Crinst/LPWAN-current-logger-device/enclosure/20200503_152244.jpg

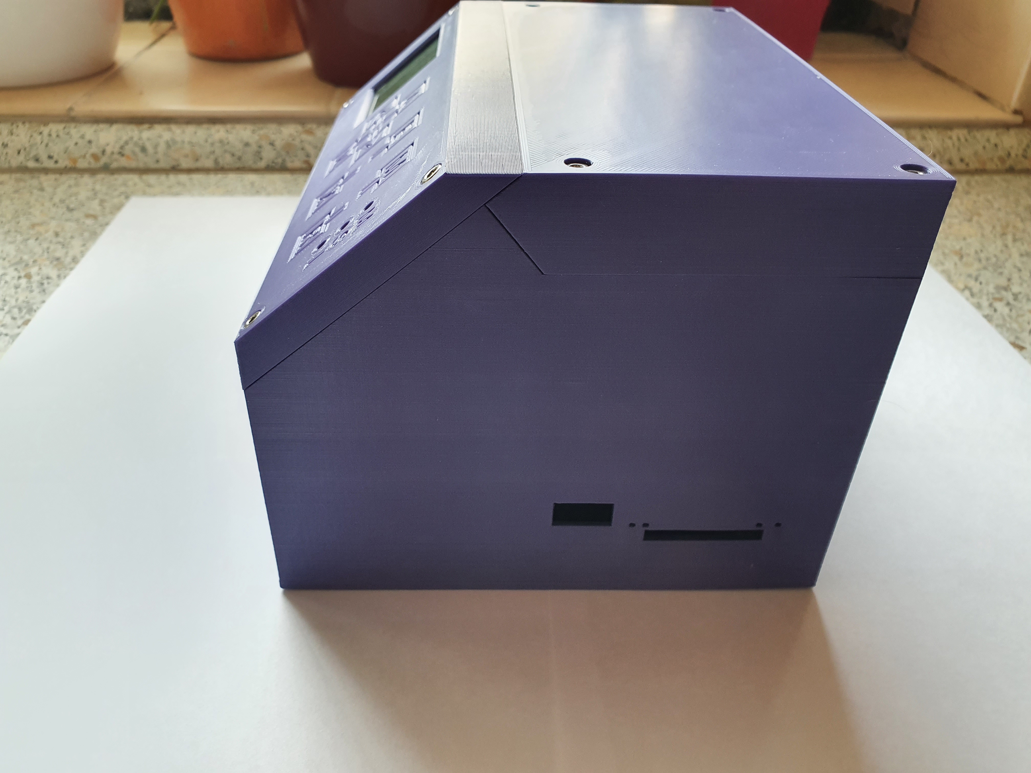
enclosure/20200503_152244.jpg
