Crinst/LPWAN-current-logger-device/enclosure/Prusa_Slicer_Bottom.PNG

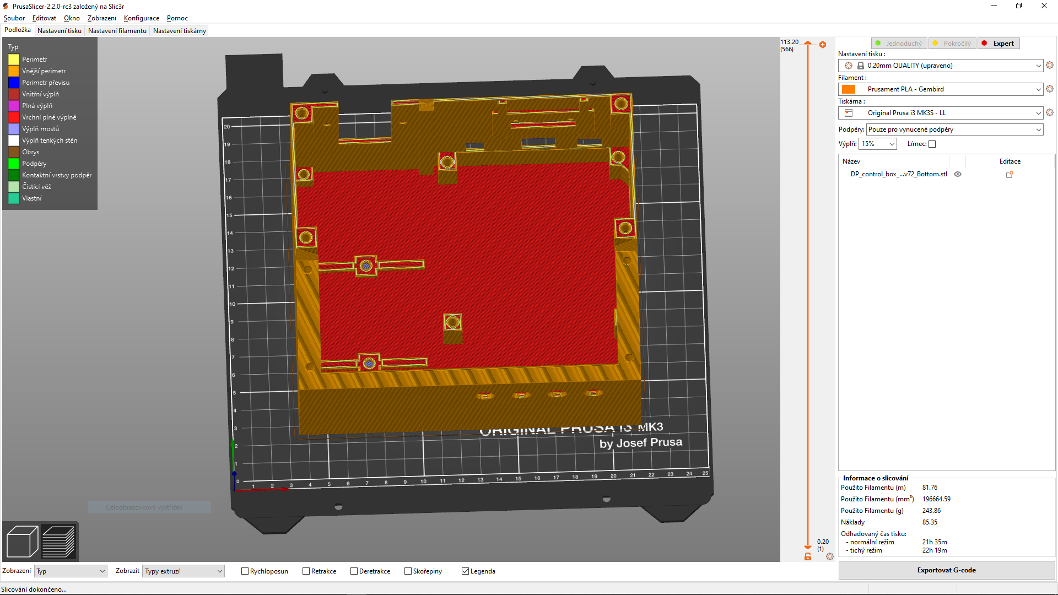
enclosure/Prusa_Slicer_Bottom.PNG
