Crinst/LPWAN-current-logger-device/docs/flowcharts/Vyvojovy_diagram_sw_lcd_menu.pdf

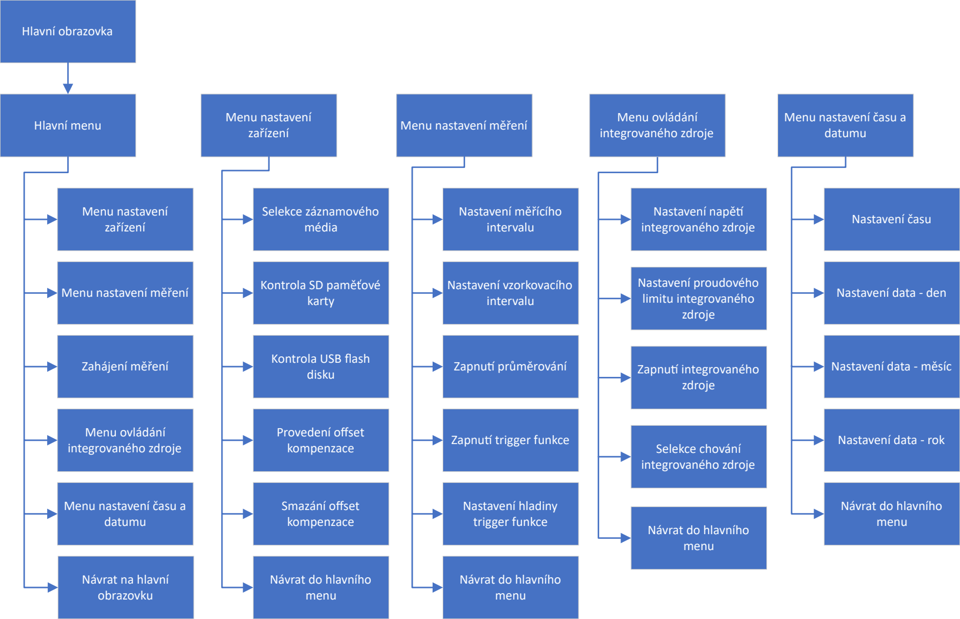
[picture p7: figure]
Hlavní menu; Menu nastavení měření; Zahájení měření; Menu ovládání integrovaného zdroje; Menu nastavení času a datumu; Menu nastavení zařízení; Selekce záznamového média; Kontrola SD paměťové karty; Kontrola USB flash disku; Provedení offset kompenzace; Smazání offset kompenzace; Návrat do hlavního menu; Nastavení měřícího intervalu; Nastavení vzorkovacího intervalu; Zapnu průměrování; Zapnu trigger funkce; Nastavení hladiny trigger funkce; Nastavení napě integrovaného zdroje; Nastavení proudového limitu integrovaného zdroje; Zapnu integrovaného zdroje; Selekce chování integrovaného zdroje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
