Crinst/LPWAN-current-logger-device/docs/flowcharts/Vyvojovy_diagram_sw_measuring.pdf

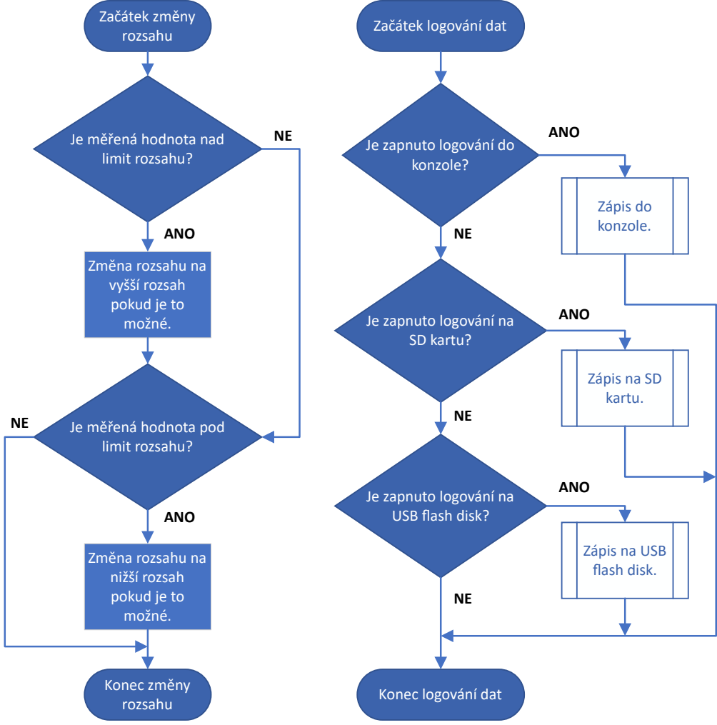
[picture p8: figure]
Začátek změny rozsahu; Je měřená hodnota nad limit rozsahu?; Změna rozsahu na vyšší rozsah pokud je to možné.; Je měřená hodnota pod limit rozsahu?; Změna rozsahu na nižší rozsah pokud je to možné.; ANO; Konec změny rozsahu; Začátek logování dat; Je zapnuto logování do konzole?; Je zapnuto logování na SD kartu?; Konec logování dat; Zápis do konzole.; Zápis na SD kartu.; Je zapnuto logování na USB flash disk?; Zápis na USB flash disk.
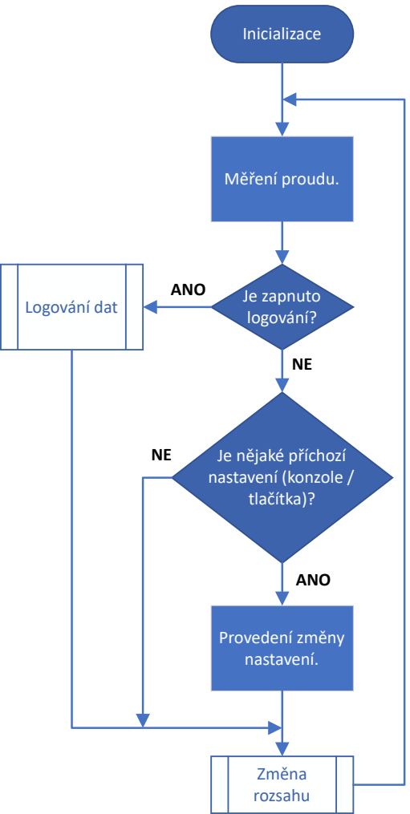
[picture p9: figure]
Je zapnuto logování?; Měření proudu.; ANO; Inicializace; Změna rozsahu; Logování dat; Je nějaké příchozí nastavení (konzole / tlačítka)?; Provedení změny nastavení.
