Crinst/LPWAN-current-logger-device/docs/flowcharts/Vyvojovy_diagram_sw_sd_card.pdf

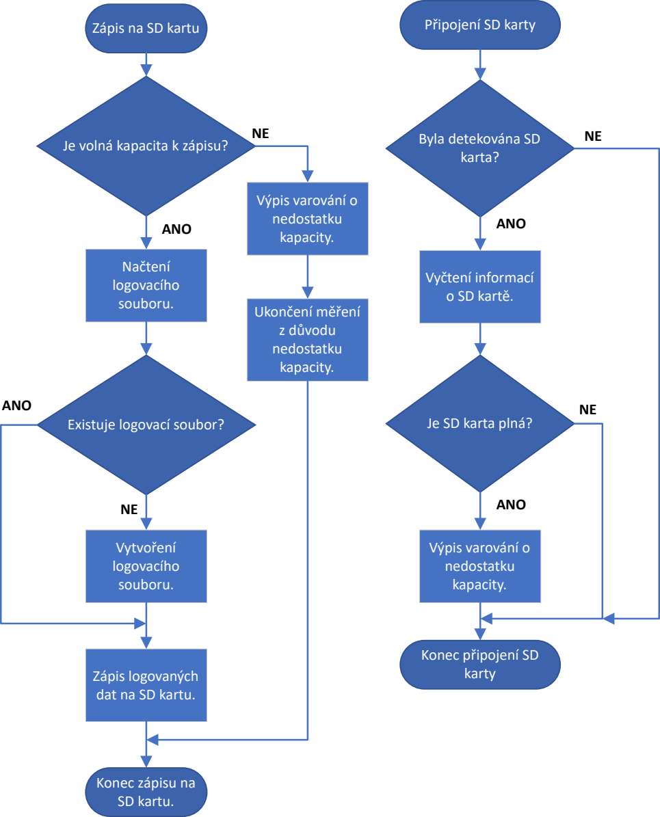
[picture p10: figure]
Zápis na SD kartu; Je volná kapacita k zápisu?; Načtení logovacího souboru.; Existuje logovací soubor?; Zápis logovaných dat na SD kartu.; ANO; Konec zápisu na SD kartu.; Připojení SD karty; Byla detekována SD karta?; Vyčtení informací o SD kartě.; Je SD karta plná?; Výpis varování o nedostatku kapacity.; Konec připojení SD karty; Ukončení měření z důvodu nedostatku kapacity.; Vytvoření logovacího souboru.
