Crinst/LPWAN-current-logger-device/docs/flowcharts/Vyvojovy_diagram_sw_uart_pc.pdf

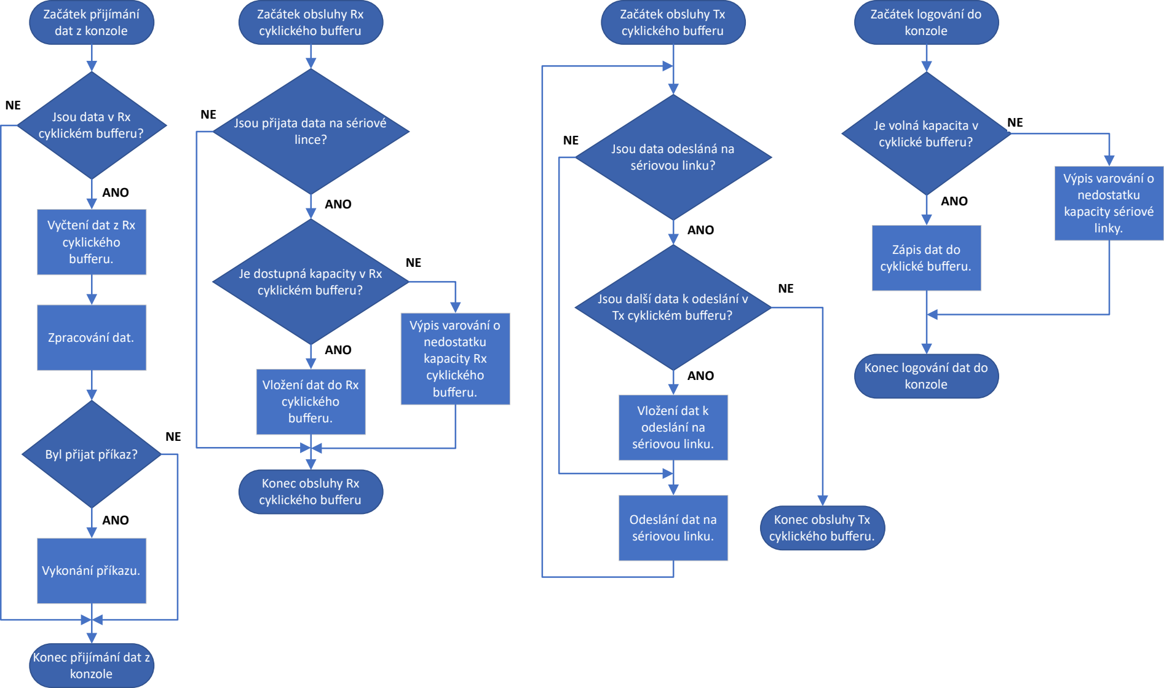
[picture p11: figure]
Jsou data v Rx cyklickém bufferu?; ANO; Začátek přijímání dat z konzole; Začátek obsluhy Tx cyklického bufferu; Jsou data odesláná na sériovou linku?; Jsou další data k odeslání v Tx cyklickém bufferu?; Vložení dat k odeslání na sériovou linku.; Konec obsluhy Tx cyklického bufferu.; Byl přijat příkaz?; Vykonání příkazu.; Začátek logování do konzole; Je volná kapacita v cyklické bufferu?; Zápis dat do cyklické bufferu.; Konec logování dat do konzole; Výpis varování o nedostatku kapacity sériové linky.; Odeslání dat na sériovou linku.; Začátek obsluhy Rx cyklického bufferu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
