Crinst/LPWAN-current-logger-device/docs/flowcharts/Vyvojovy_diagram_sw_usb_flash.pdf

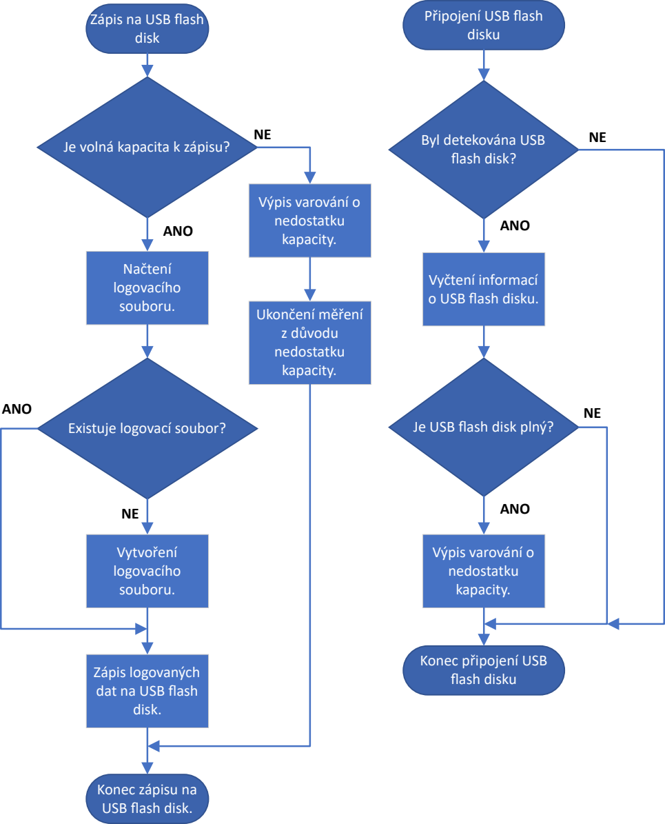
[picture p12: figure]
Zápis na USB flash disk; Je volná kapacita k zápisu?; Načtení logovacího souboru.; Existuje logovací soubor?; Zápis logovaných dat na USB flash disk.; ANO; Konec zápisu na USB flash disk.; Připojení USB flash disku; Byl detekována USB flash disk?; Vyčtení informací o USB flash disku.; Je USB flash disk plný?; Výpis varování o nedostatku kapacity.; Konec připojení USB flash disku; Ukončení měření z důvodu nedostatku kapacity.; Vytvoření logovacího souboru.
