Crinst/LPWAN-current-logger-device/docs/flowcharts/Vyvojovy_diagram_sw_V1.pdf

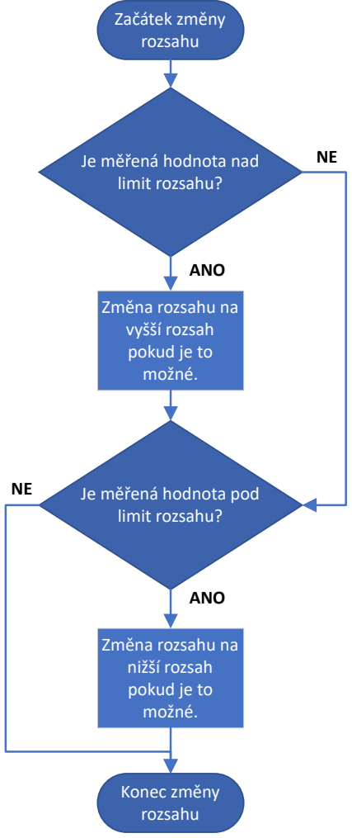
[picture p13: figure]
Začátek změny rozsahu; Je měřená hodnota nad limit rozsahu?; Změna rozsahu na vyšší rozsah pokud je to možné.; Je měřená hodnota pod limit rozsahu?; Změna rozsahu na nižší rozsah pokud je to možné.; ANO; Konec změny rozsahu
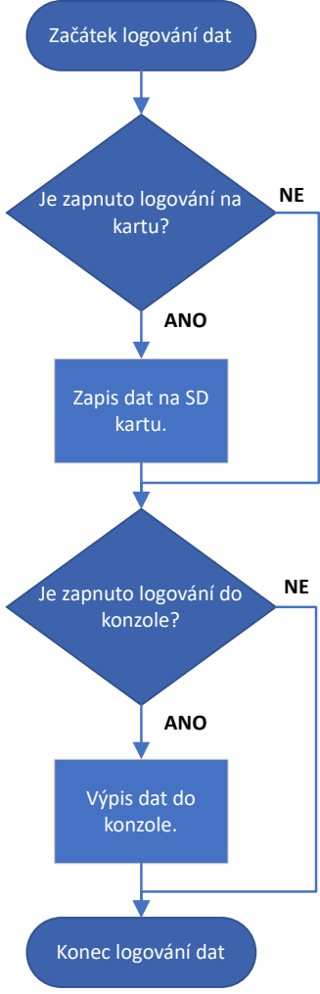
[picture p14: figure]
Začátek logování dat; Je zapnuto logování na kartu?; Zapis dat na SD kartu.; Je zapnuto logování do konzole?; Výpis dat do konzole.; Konec logování dat; ANO
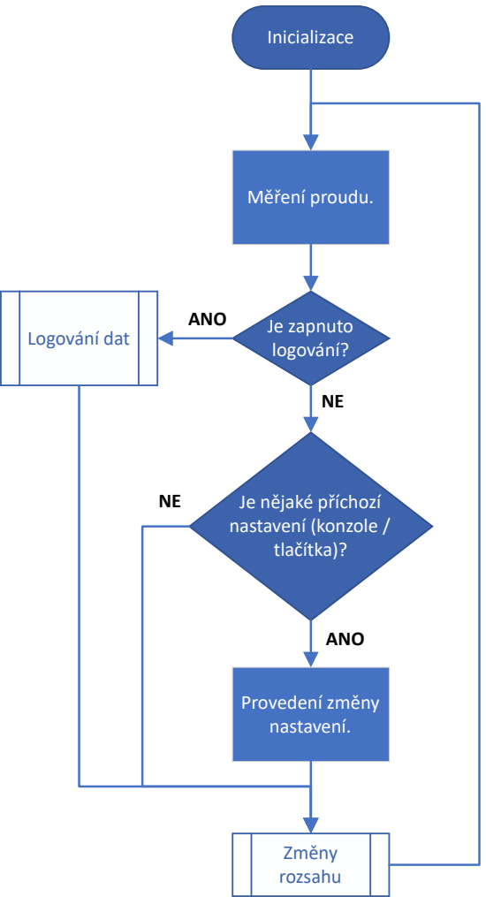
[picture p15: figure]
Je zapnuto logování?; Měření proudu.; ANO; Inicializace; Změny rozsahu; Logování dat; Je nějaké příchozí nastavení (konzole / tlačítka)?; Provedení změny nastavení.
