Crinst/LPWAN-current-logger-device/docs/DP_V3_CubeMX_pinout.PNG

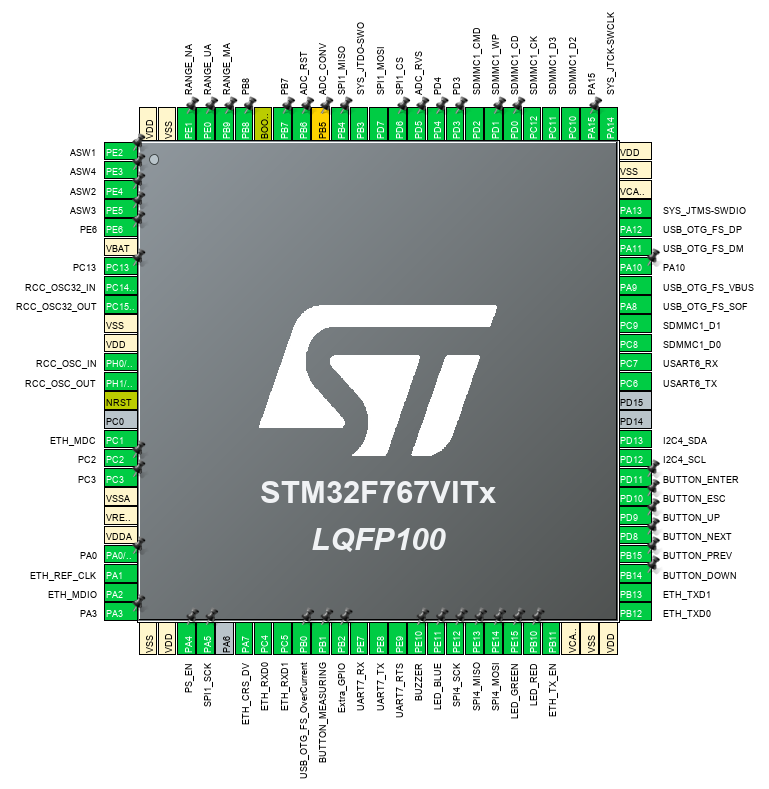
docs/DP_V3_CubeMX_pinout.PNG
