Crinst/LPWAN-current-logger-device/docs/flowcharts/Vyvojovy_diagram_sw_V1.png

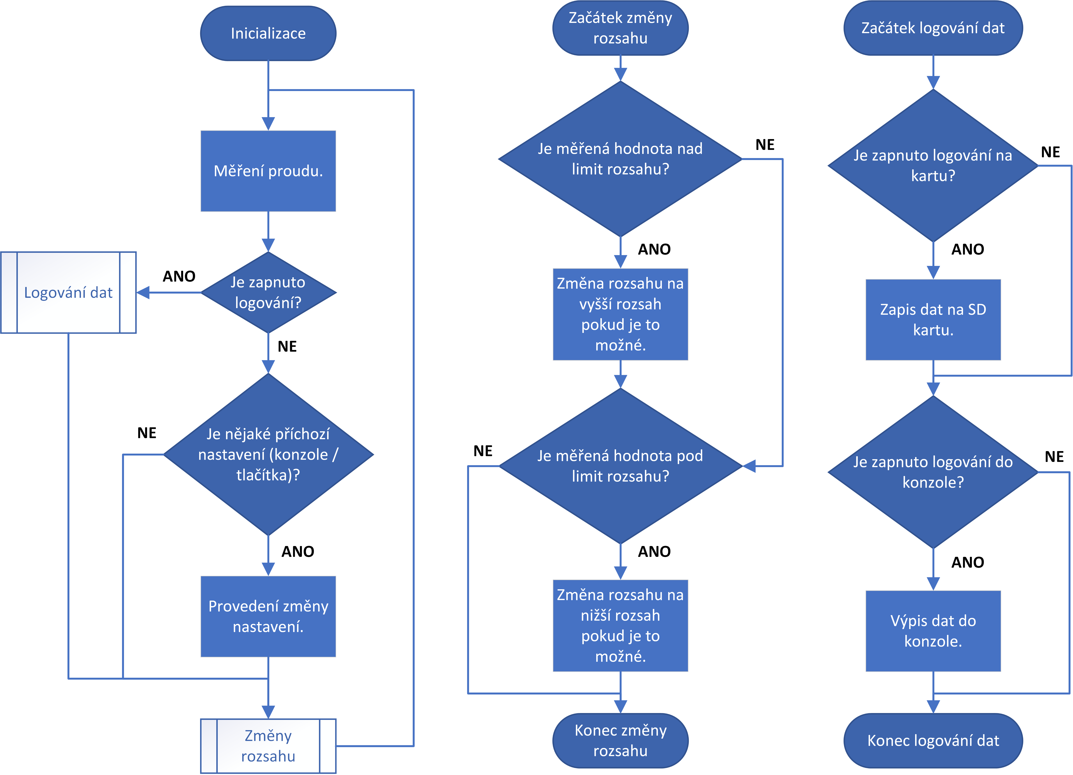
docs/flowcharts/Vyvojovy_diagram_sw_V1.png
