Crinst/LPWAN-current-logger-device/eagle/v1_v2/DP_board_V2_1_10_2019_schematics.png

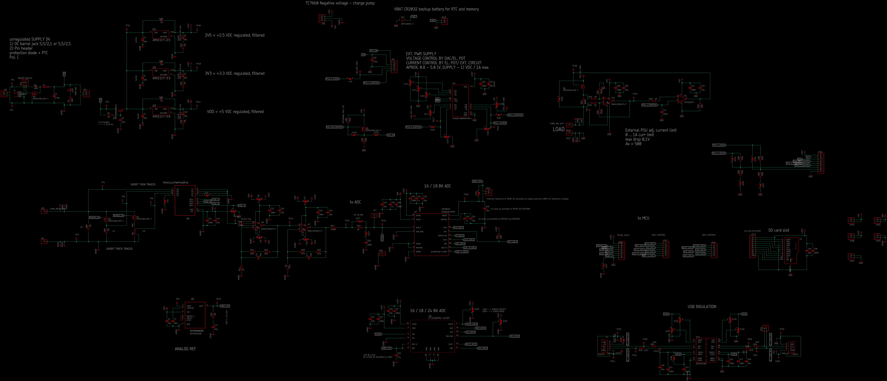
eagle/v1_v2/DP_board_V2_1_10_2019_schematics.png
