Crinst/LPWAN-current-logger-device/eagle/v1_v2/schem2.png

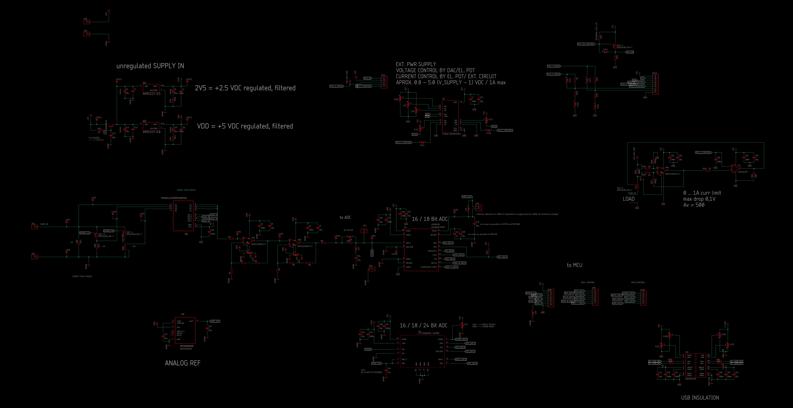
eagle/v1_v2/schem2.png
