Crinst/LPWAN-current-logger-device/eagle/v1_v2/schem.png

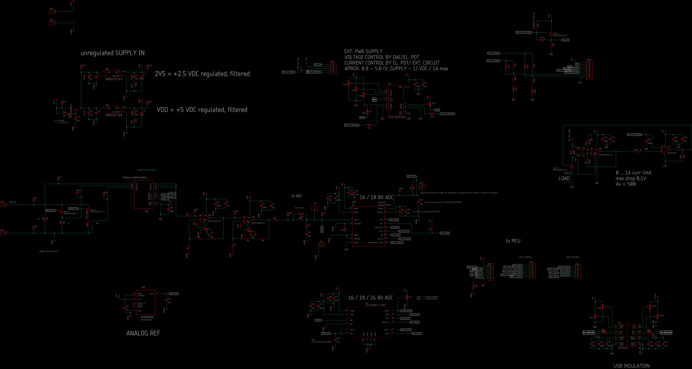
eagle/v1_v2/schem.png
