Crinst/LPWAN-current-logger-device/enclosure/20200503_151324.jpg

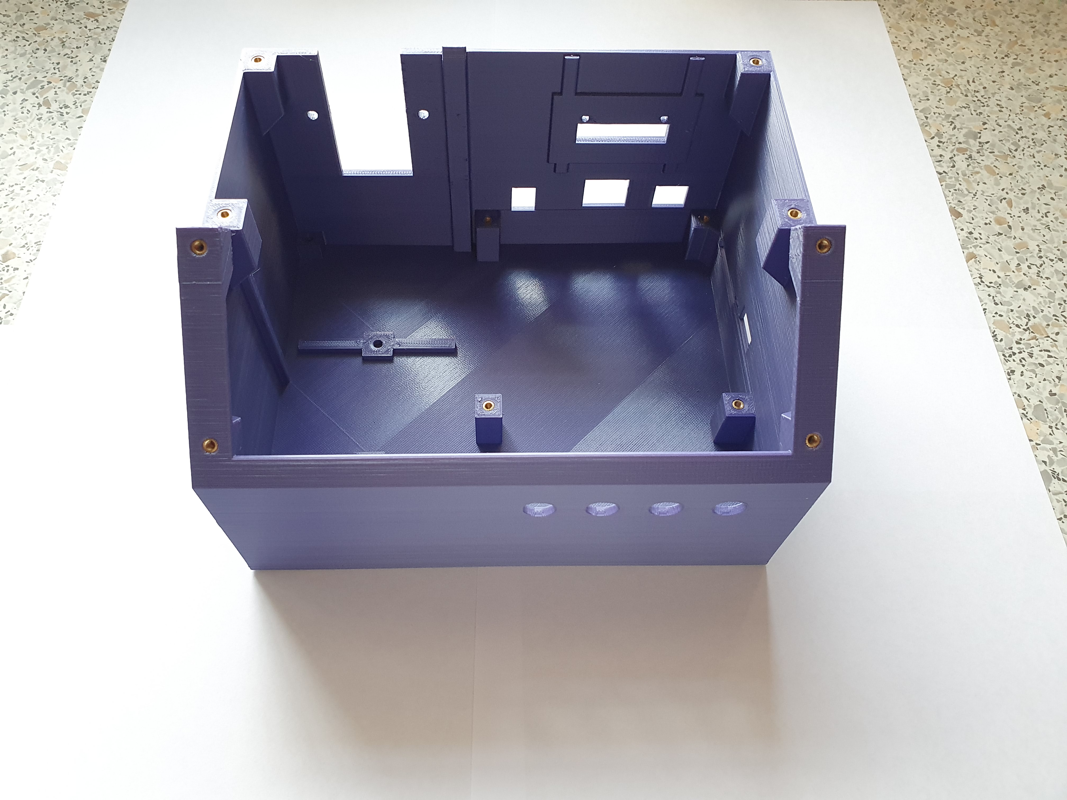
enclosure/20200503_151324.jpg
