Crinst/LPWAN-current-logger-device/enclosure/20200503_151333.jpg

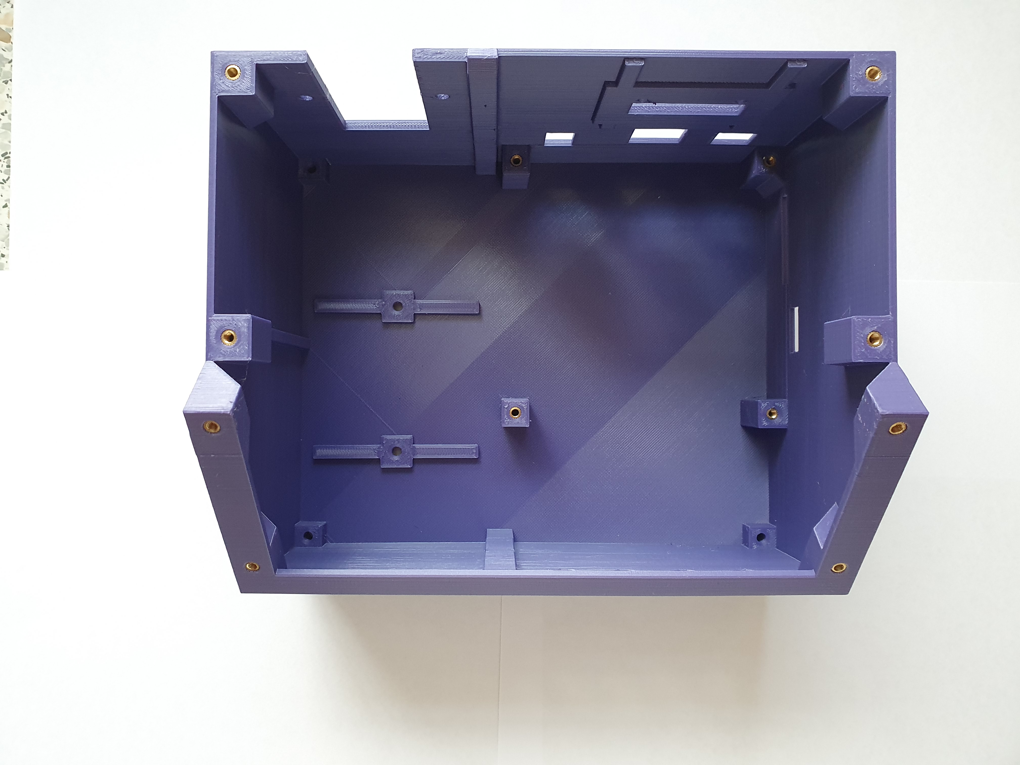
enclosure/20200503_151333.jpg
