Crinst/LPWAN-current-logger-device/enclosure/20200503_151343.jpg

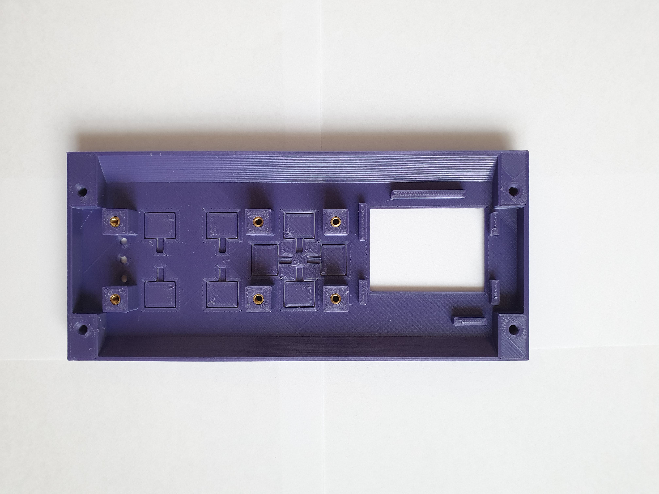
enclosure/20200503_151343.jpg
