Crinst/LPWAN-current-logger-device/enclosure/20200503_151352.jpg

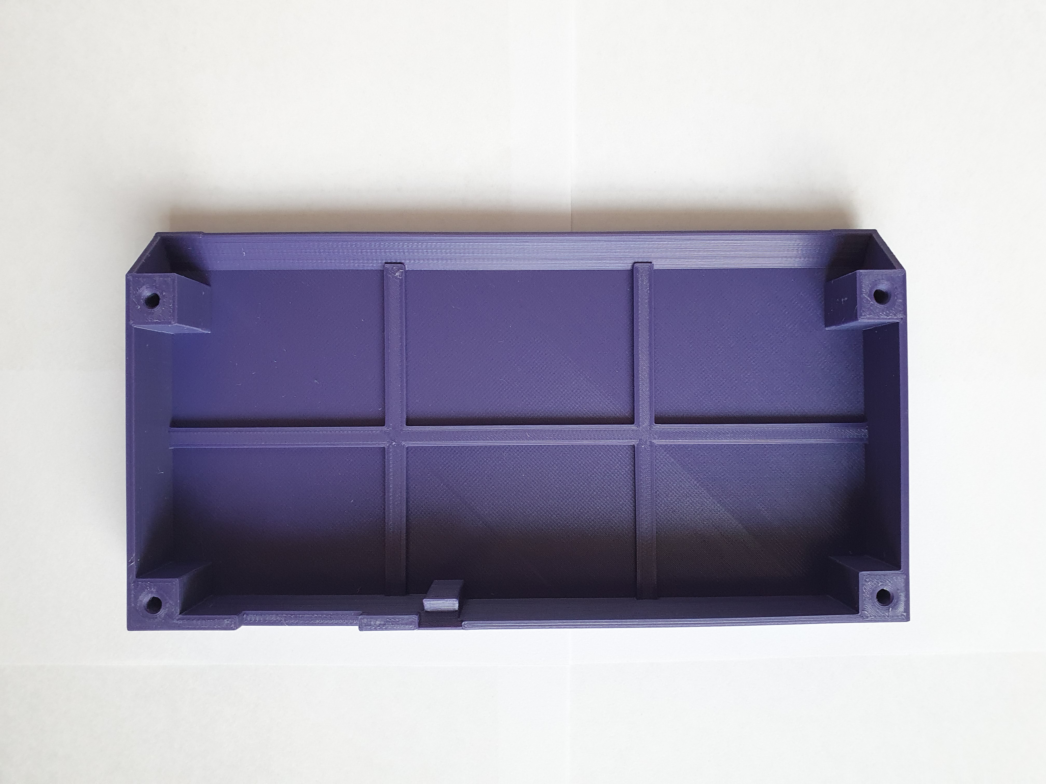
enclosure/20200503_151352.jpg
