Crinst/LPWAN-current-logger-device/enclosure/20200503_151501.jpg

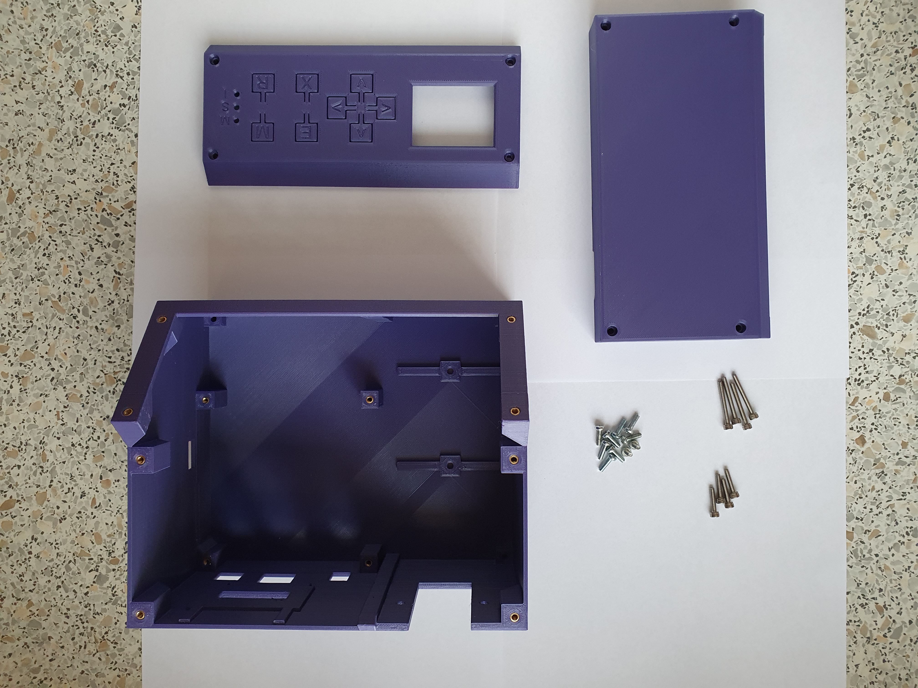
enclosure/20200503_151501.jpg
