Crinst/LPWAN-current-logger-device/enclosure/20200503_152235.jpg

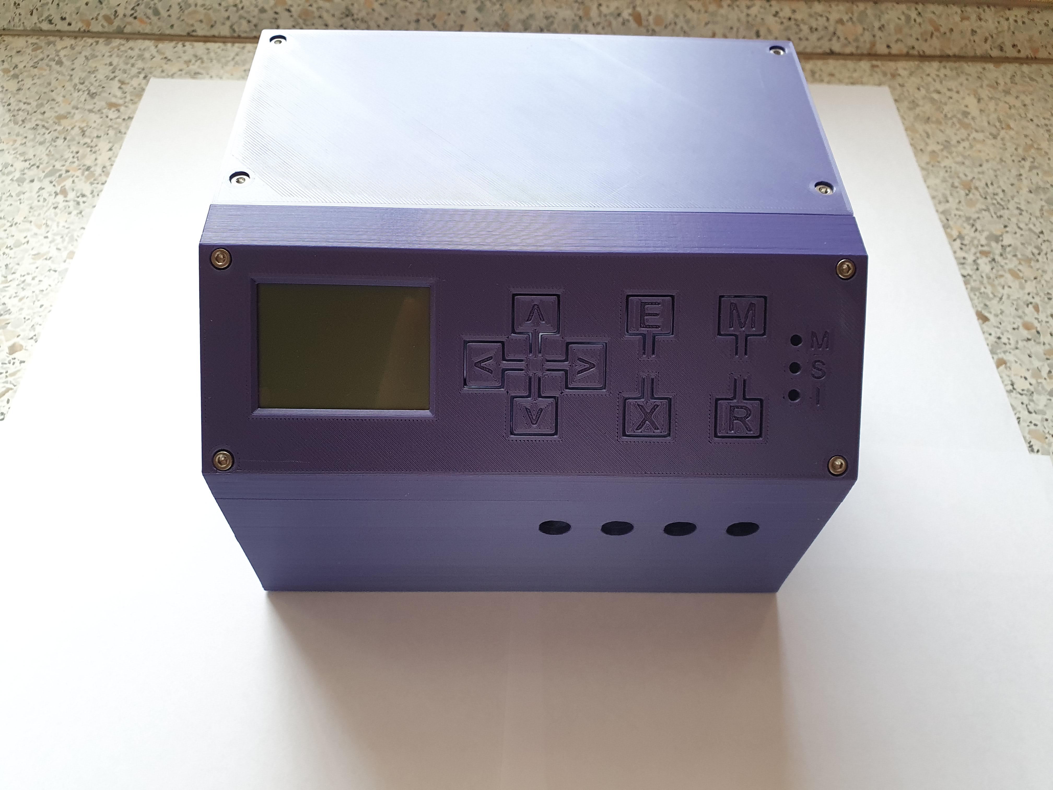
enclosure/20200503_152235.jpg
