Crinst/LPWAN-current-logger-device/enclosure/20200503_152249.jpg

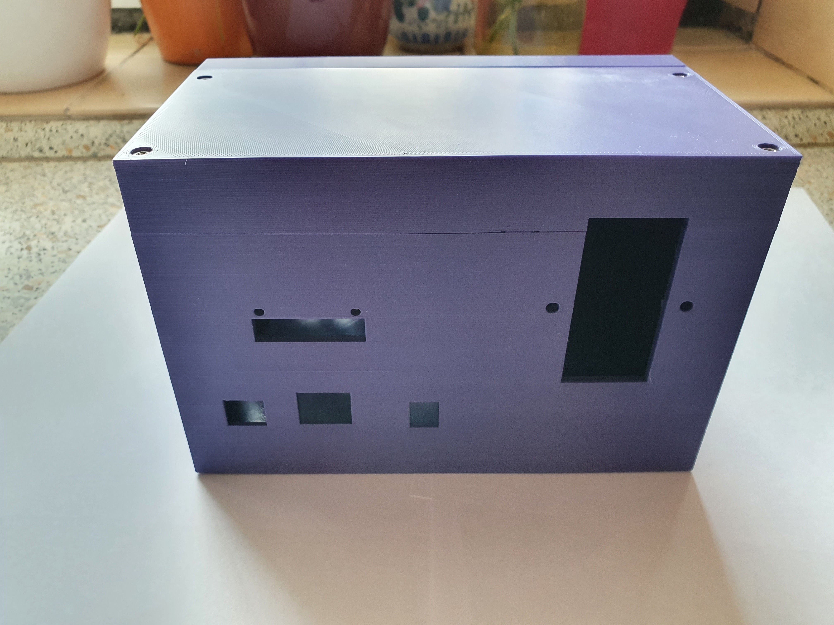
enclosure/20200503_152249.jpg
