Crinst/LPWAN-current-logger-device/enclosure/Prusa_Slicer_front_cover.PNG

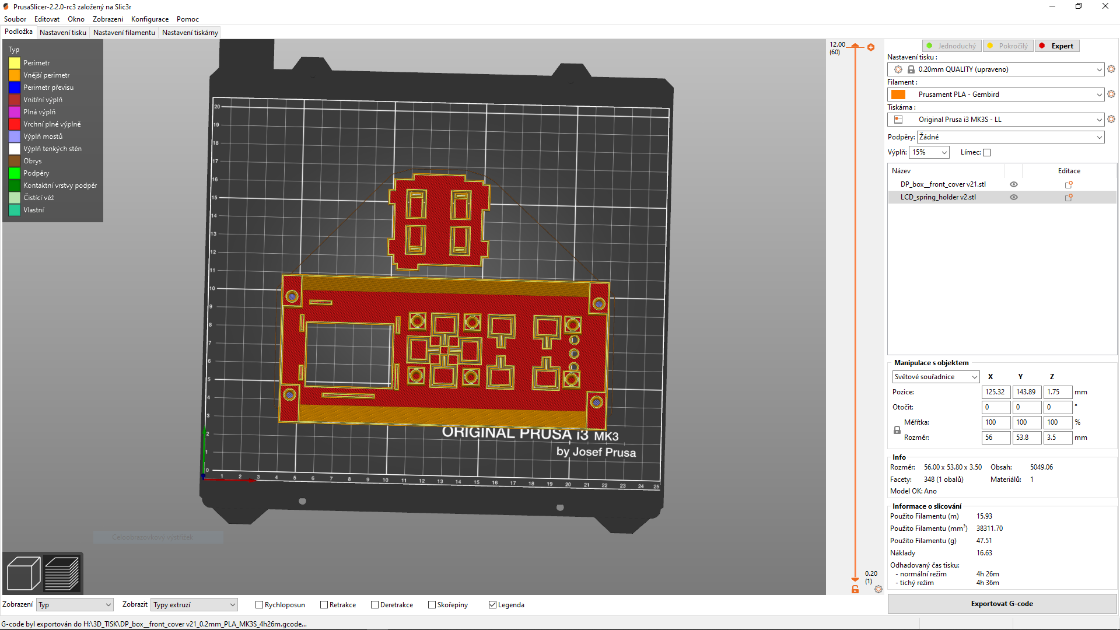
enclosure/Prusa_Slicer_front_cover.PNG
