Crinst/LPWAN-current-logger-device/enclosure/Prusa_Slicer_Top_cover.PNG

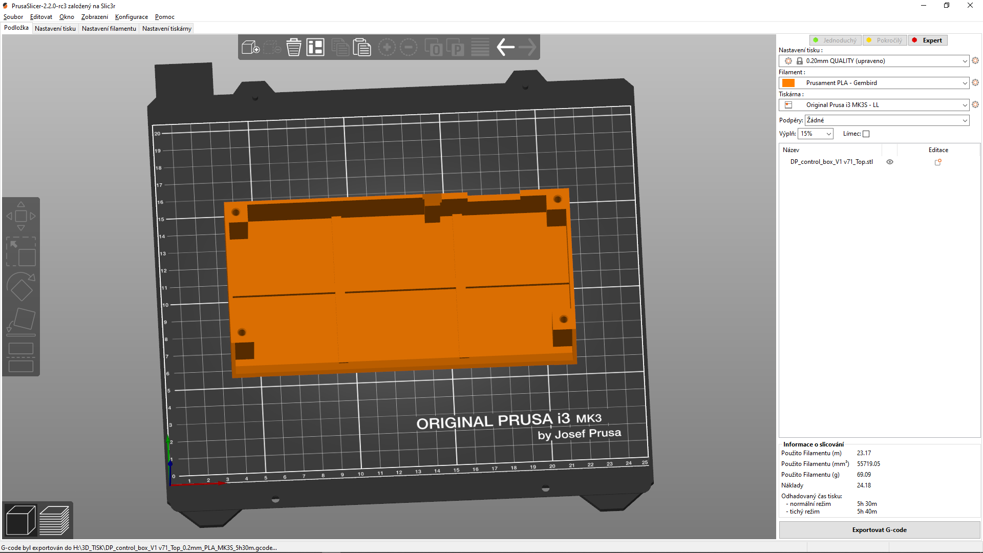
enclosure/Prusa_Slicer_Top_cover.PNG
