Crinst/LPWAN-current-logger-device/bom/BOM_final.xlsx

Sheet: BOM_V3
 | Označení | Popis | Počet ks | Cena za ks | Cena celkově | Poznámka | Farnell | Mouser
1 | STM32F767VIT6 | Mikrořadiče ARM – MCU 16/32-BITS MICROS | 1 | 266 | 266 | STM32F767VIT6, případná alternativa …VIT7, výkonější movel z řady H7=STM32H753VIT |  | https://cz.mouser.com/ProductDetail/STMicroelectronics/STM32F767VIT6
2 | ADS8910BRGER | Analogově digitální převodníky – ADC | 1 | 476 | 476 | 18 bit SAR ADC |  | https://cz.mouser.com/ProductDetail/Texas-Instruments/ADS8910BRGER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
3 | ADS8900BRGER | Analogově digitální převodníky – ADC | 0 | 1003 | 0 | 20 bit SAR ADC // alternative |  | https://cz.mouser.com/ProductDetail/Texas-Instruments/ADS8900BRGET
4 | ECS-.327-9-12-C-TR | Krystaly 32.786kHz 9pF 20ppm -40C +85C | 1 | 32 | 32 | LSE, RTC clock |  | https://cz.mouser.com/ProductDetail/ECS/ECS-327-9-12-C-TR
5 | 425WF20012IKR | Krystaly 20MHz 8pF 10ppm 80 ohm -40C +85C | 1 | 18 | 18 | HSE, Main clock |  | https://cz.mouser.com/ProductDetail/CTS-Electronic-Components/425WF20012IKR
6 | SI8642BB-B-IU | Digitální oddělovače 2.5 kV 2 forward & 2 reverse 4-channel isolator | 1 | 56 | 56 | Galvanická izolace |  | https://cz.mouser.com/ProductDetail/Silicon-Labs/SI8642BB-B-IU
7 | AT24C256C-SSHL-B | EEPROM 256K (32K X 8), 2-WI 1.8V | 1 | 14 | 14 | EEPROM 256kB |  | https://cz.mouser.com/ProductDetail/Microchip-Technology-Atmel/AT24C256C-SSHL-B
8 | AD8628ARTZ-REEL7 | Přesné zesilovače SINGLE PRECISION RAIL-RAIL CHOPPER OPAMP | 2 | 55 | 110 | Opamp, fast setting time |  | https://cz.mouser.com/ProductDetail/Analog-Devices/AD8628ARTZ-REEL7?qs=sGAEpiMZZMv9Q1JI0Mo%2FtVOsGxVjEAVX
9 | MAX4239AUT+T | MAX4239AUT | 1 | 48 | 48 | Input op amp | https://cz.farnell.com/maxim-integrated-products/max4239aut-t/op-amp-6-5mhz-1-6v-us-sot23-6/dp/2511028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 | https://cz.mouser.com/ProductDetail/Maxim-Integrated/MAX4239AUT%2bT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
10 | LT3045IDD#PBF | Regulátory napětí s nízkým úbytkem (LDO) 20V, 500mA, Ultralow Noise, Ultrahigh PSRR Linear Regulator | 2 | 160 | 320 | LDO for power source (2 paralel, 500 mA each) |  | https://cz.mouser.com/ProductDetail/Analog-Devices-Linear-Technology/LT3045IDDPBF
11 | AD5259BRMZ50-R7 | Integrované obvody digitálních potenciometrů 8-Bit I2C EEMEM DigiPOT | 1 | 61 | 61 | EL POT 50kOhm for power source |  | https://cz.mouser.com/ProductDetail/Analog-Devices/AD5259BRMZ50-R7?qs=sGAEpiMZZMv9Q1JI0Mo%2Ftd3W%252BCBrBG%2Fj
12 | AD5259BRMZ10-R7 | Integrované obvody digitálních potenciometrů 8-Bit I2C EEMEM DigiPOT | 1 | 61 | 61 | EL POT 10kOhm for power source |  | https://cz.mouser.com/ProductDetail/Analog-Devices/AD5259BRMZ10-R7?qs=sGAEpiMZZMv9Q1JI0Mo%2FtS3aVhqWGKuQ
13 | USBLC6-4SC6 | Ochrana před elektrostatickými výboji / Diody pro potlačení napětí z přechodových jevů Low Cap ESD Protect | 3 | 11 | 33 | ESD protection for inputs |  | https://cz.mouser.com/ProductDetail/STMicroelectronics/USBLC6-4SC6?qs=k9dH%2Fx4GHJCNdehb8zInZg%3D%3D
14 | CC0603KPX7R9BB104 | Vícevrstvé keramické kondenzátory MLCC – pro povrchovou montáž SMD, SMT 100nF 50V X7R 10% | 37 | 1.5 | 55.5 | 100nF, X7R, 0603, ceramic, 50V |  | https://cz.mouser.com/ProductDetail/Yageo/CC0603KPX7R9BB104
15 | 0603DC105KAT2A | Vícevrstvé keramické kondenzátory MLCC – pro povrchovou montáž SMD, SMT 35V 1uF X7R 0603 0.1 | 5 | 5 | 25 | 1uF, X7R, 0603, ceramic, 35V |  | https://cz.mouser.com/ProductDetail/AVX/0603DC105KAT2A
16 | C2012X5R1V106K085AC | Vícevrstvé keramické kondenzátory MLCC – pro povrchovou montáž SMD, SMT 0805 35V 10uF X5R 10% T: 0.85mm | 24 | 8 | 192 | 10uF, X5R, 0805, ceramic, 35V |  | https://cz.mouser.com/ProductDetail/TDK/C2012X5R1V106K085AC
17 | TMK212BBJ226MG-TT | Vícevrstvé keramické kondenzátory MLCC – pro povrchovou montáž SMD, SMT 0805 25V 22uF 20% X5R | 1 | 12 | 12 | 22uF, X5R, 0805, ceramic, 25V |  | https://cz.mouser.com/ProductDetail/Taiyo-Yuden/TMK212BBJ226MG-TT
18 | C0603C100J5GACAUTO | Vícevrstvé keramické kondenzátory MLCC – pro povrchovou montáž SMD, SMT 50V 10pF 0603 C0G 5% AEC-Q200 | 2 | 4 | 8 | 10pF, NP0, 0603, ceramic, 25V |  | https://cz.mouser.com/ProductDetail/KEMET/C0603C100J5GACAUTO?qs=sGAEpiMZZMs0AnBnWHyRQEP2rxSZPMVSxE6dyvOgdgM%3D
19 | 06035A160FAT2A | Vícevrstvé keramické kondenzátory MLCC – pro povrchovou montáž SMD, SMT 50V 16pF C0G 0603 1% Tol | 0 | 13 | 0 | 16pF, NP0, 0603, ceramic, 50V |  | https://cz.mouser.com/ProductDetail/AVX/06035A160FAT2A?qs=sGAEpiMZZMs0AnBnWHyRQKdiqyDPVQdARj0OMUmXxCE%3D
20 | 06035U180GAT2A | Vícevrstvé keramické kondenzátory MLCC – pro povrchovou montáž SMD, SMT 50V 18pF C0G 0603 2% Tol Ultra Low ESR | 0 | 8 | 0 | 18pF, NP0, 0603, ceramic, 50V |  | https://cz.mouser.com/ProductDetail/AVX/06035U180GAT2A?qs=sGAEpiMZZMs0AnBnWHyRQME4St1Elu7lbb0Q7NMFZEw%3D
21 | GMK316AB7106KL-TR | Vícevrstvé keramické kondenzátory MLCC – pro povrchovou montáž SMD, SMT 1206 35VDC 10uF 10% X7R | 3 | 10 | 30 | 10uF, X7R, 1206, ceramic,35V |  | https://cz.mouser.com/ProductDetail/Taiyo-Yuden/GMK316AB7106KL-TR
22 | C0603C103J3GECAUTO | Vícevrstvé keramické kondenzátory MLCC – pro povrchovou montáž SMD, SMT 25V 0.01uF 0603 C0G 5% AEC-Q200 | 4 | 8 | 32 | 10nF, NP0, 0603, ceramic, 25V |  | https://cz.mouser.com/ProductDetail/KEMET/C0603C103J3GECAUTO?qs=sGAEpiMZZMuMW9TJLBQkXgkFHkvoTWyNpauX5HVszTc%3D
23 | TMK325B7226KM-TR | Vícevrstvé keramické kondenzátory MLCC – pro povrchovou montáž SMD, SMT 39 UH 5% | 5 | 23 | 115 | 22uF, X7R, 1210, ceramic, 25V |  | https://cz.mouser.com/ProductDetail/Taiyo-Yuden/TMK325B7226KM-TR
24 | T55B106M035C0200 | tantalové kapacitory - polymer SMD 10uF 35volts 20% 200mohms maxESR, case B | 2 | 30 | 60 | 10uF, 35V, SMDB, tantal |  | https://cz.mouser.com/ProductDetail/Vishay-Polytech/T55B106M035C0200
25 | EEE-1EA471P | Aluminiové elektrolytické kapacitory - SMD 470uF 25V | 2 | 15 | 30 | 470uF, 25V, CASE G, Electrolytic |  | https://cz.mouser.com/ProductDetail/Panasonic/EEE-1EA471P
26 | 08053C225K4T2A | Vícevrstvé keramické kondenzátory MLCC – pro povrchovou montáž SMD, SMT 25V 2.2uF X7R 0805 10%TOL | 2 | 9 | 18 | 2.2uF, X7R, 0805, ceramic, 25V |  | https://cz.mouser.com/ProductDetail/AVX/08053C225K4T2A
27 | GRM188R7YA474KE05D | Vícevrstvé keramické kondenzátory MLCC – pro povrchovou montáž SMD, SMT 0603 35VDC 0.47uF 10% X7R | 1 | 6 | 6 | 470nF, X7R, 0603, ceramic, 35V |  | https://cz.mouser.com/ProductDetail/Murata-Electronics/GRM188R7YA474KE05D
28 | C0603C471J5GACTU | Vícevrstvé keramické kondenzátory MLCC – pro povrchovou montáž SMD, SMT 50V 470pF 0603 C0G 5% | 1 | 3 | 3 | 470pF, NP0, 0603, ceramic, 50V |  | https://cz.mouser.com/ProductDetail/KEMET/C0603C471J5GACTU
29 | CBR06C120G5GAC | Vícevrstvé keramické kondenzátory MLCC – pro povrchovou montáž SMD, SMT 50V 12pF C0G 0603 0.02 | 4 | 8 | 32 | 12pF, NP0, 0603, ceramic, 50V |  | https://cz.mouser.com/ProductDetail/KEMET/CBR06C120G5GAC
30 | 0603N140J500CT | Vícevrstvé keramické kondenzátory MLCC – pro povrchovou montáž SMD, SMT 0603 MLCC NPO 14 pF +/- 5% 50 V T&R GP | 2 | 8 | 16 | 14pF, NP0, 0603, ceramic, 50V |  | https://cz.mouser.com/ProductDetail/Walsin/0603N140J500CT?qs=u16ybLDytRZCHSSmEjiXlw%3D%3D
31 | C0603C470J1GACAUTO | Vícevrstvé keramické kondenzátory MLCC – pro povrchovou montáž SMD, SMT 100V 47pF 0603 C0G 5% AEC-Q200 | 2 | 3 | 6 | 47pF, NP0, 0603, ceramic, 100V |  | https://cz.mouser.com/ProductDetail/KEMET/C0603C470J1GACAUTO?qs=sGAEpiMZZMs0AnBnWHyRQEP2rxSZPMVSpL8iOEUZ40g%3D
32 | Y14870R01000B9R | 0R01, 0.1%, +-15ppm, 2512 | 1 | 280 | 280 | Current shunt for mA range | https://cz.farnell.com/vishay-foil-resistors/y14870r01000b9r/current-sense-res-0r01-0-1-1-w/dp/1867888 | https://cz.mouser.com/ProductDetail/Vishay-Precision-Group-Foil-Resistors/Y14870R01000B9R
33 | ERA-6ARW103V | 10K0, 0.05%, +- 10 ppm, 0805 | 1 | 20 | 20 | Current shunt for uA range |  | https://cz.mouser.com/ProductDetail/Panasonic/ERA-6ARW103V
34 | RN73C2A10RBTD | 10R0, 0.1%, +- 10 ppm, 0805 | 1 | 13 | 13 | Current shunt for nA range |  | https://cz.mouser.com/ProductDetail/TE-Connectivity-Holsworthy/RN73C2A10RBTD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
35 | CRCW060310K0JNEAC | Tlustovrstvé rezistory – SMD 1/10Watt 10Kohms 5% Commercial Use | 19 | 3 | 57 | 10K, 0603, 5%, 100mW |  | https://cz.mouser.com/ProductDetail/Vishay-Dale/CRCW060310K0JNEAC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
36 | AT0603DRD0712K1L | Tenkovrstvé rezistory - SMD 12.1 Kohms 0.5% Tol. AEC-Q200 | 1 | 6 | 6 | 12K1, 0603, 0.5%, 100mW |  | https://cz.mouser.com/ProductDetail/Yageo/AT0603DRD0712K1L
37 | CRCW06031K00FKEAC | Tlustovrstvé rezistory – SMD 1/10Watt 1Kohms 1% Commercial Use | 2 | 3 | 6 | 1K, 0603, 1%, 100mW |  | https://cz.mouser.com/ProductDetail/Vishay-Dale/CRCW06031K00FKEAC
38 | AC0603FR-131K5L | Tlustovrstvé rezistory – SMD 1.5K ohm 1% 75V AEC-Q200 | 1 | 3 | 3 | 1K5, 0603, 1%, 100mW |  | https://cz.mouser.com/ProductDetail/Yageo/AC0603FR-131K5L
39 | CR0603-FX-2700ELF | Tlustovrstvé rezistory – SMD 270 ohm 1% | 4 | 3 | 12 | 270R, 0603, 1%, 100mW |  | https://cz.mouser.com/ProductDetail/Bourns/CR0603-FX-2700ELF
40 | RC0603FR-0727RL | Tlustovrstvé rezistory – SMD 27 OHM 1% | 2 | 3 | 6 | 27R, 0603, 1%, 100mW |  | https://cz.mouser.com/ProductDetail/Yageo/RC0603FR-0727RL?qs=sGAEpiMZZMtlubZbdhIBIJbtIA4CxR8fOra1btXn4eY%3D
41 | CRCW06032K20FKEAC | Tlustovrstvé rezistory – SMD 1/10Watt 2.2Kohms 1% Commercial Use | 0 | 3 | 0 | 2K2, 0603, 1%, 100mW |  | https://cz.mouser.com/ProductDetail/Vishay-Dale/CRCW06032K20FKEAC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
42 | RC0603FR-10300RL | Tlustovrstvé rezistory – SMD 300 ohm 1% 75V General Purpose | 0 | 3 | 0 | 300R, 0603, 1%, 100mW |  | https://cz.mouser.com/ProductDetail/Yageo/RC0603FR-10300RL?qs=sGAEpiMZZMtlubZbdhIBIEgN9MQql2m6VBaGQg09fDM%3D
43 | ERJ-3EKF3300V | Tlustovrstvé rezistory – SMD 0603 330ohms 1% AEC-Q200 | 12 | 3 | 36 | 330R, 0603, 1%, 100mW |  | https://cz.mouser.com/ProductDetail/Panasonic/ERJ-3EKF3300V
44 | RC0603FR-0733RL | Tlustovrstvé rezistory – SMD 33 OHM 1% | 5 | 3 | 15 | 33R, 0603, 1%, 100mW |  | https://cz.mouser.com/ProductDetail/Yageo/RC0603FR-0733RL
45 | ERJ-3EKF4702V | Tlustovrstvé rezistory – SMD 0603 47Kohms 1% AEC-Q200 | 1 | 3 | 3 | 47K, 0603, 1%, 100mW |  | https://cz.mouser.com/ProductDetail/Panasonic/ERJ-3EKF4702V
46 | RC0603FR-0749R9L | Tlustovrstvé rezistory – SMD 49.9 OHM 1% | 4 | 3 | 12 | 49R9, 0603, 1%, 100mW |  | https://cz.mouser.com/ProductDetail/Yageo/RC0603FR-0749R9L?qs=sGAEpiMZZMtlubZbdhIBICtsPjK35vDHDIUSfdtnRoE%3D
47 | RC0603FR-07620RL | Tlustovrstvé rezistory – SMD 620 OHM 1% | 0 | 3 | 0 | 620R, 0603, 1%, 100mW |  | https://cz.mouser.com/ProductDetail/Yageo/RC0603FR-07620RL
48 | ERA-3ARW102V | Tenkovrstvé rezistory - SMD 0603 1Kohm 0.05% 10ppm AEC-Q200 | 2 | 18 | 36 | 1K, 0603, 0.05%, 100mW |  | https://cz.mouser.com/ProductDetail/Panasonic/ERA-3ARW102V
49 | ERA-3ARW682V | Tenkovrstvé rezistory - SMD 0603 6.8Kohm 0.05% 10ppm AEC-Q200 | 2 | 19 | 38 | 6K8, 0603, 0.05%, 100mW |  | https://cz.mouser.com/ProductDetail/Panasonic/ERA-3ARW682V
50 | ERA-3ARW222V | Tenkovrstvé rezistory - SMD 0603 2.2Kohm 0.05% 10ppm AEC-Q200 | 2 | 18 | 36 | 2K2, 0603, 0.05%, 100mW |  | https://cz.mouser.com/ProductDetail/Panasonic/ERA-3ARW222V
51 | RC0603FR-071RL | Tlustovrstvé rezistory – SMD 1 OHM 1% | 4 | 4 | 16 | 1R0, 0603, 1%, 100mW |  | https://cz.mouser.com/ProductDetail/Yageo/RC0603FR-071RL?qs=sGAEpiMZZMtlubZbdhIBIPpBVm91En7nWY2BCENJ1uA%3D
52 | CRCW06034K70FKEAC | Tlustovrstvé rezistory – SMD 1/10Watt 4.7Kohms 1% Commercial Use | 4 | 4 | 16 | 4K7, 0603, 1%, 100mW |  | https://cz.mouser.com/ProductDetail/Vishay-Dale/CRCW06034K70FKEAC
53 | CRCW0603499RFKEAC | Tlustovrstvé rezistory – SMD 1/10Watt 499ohms 1% Commercial Use | 1 | 3 | 3 | 499R, 0603, 1%, 100mW |  | https://cz.mouser.com/ProductDetail/Vishay-Dale/CRCW0603499RFKEAC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
54 | RT0603FRE072R2L | Tenkovrstvé rezistory - SMD | 2 | 3 | 6 | 2R2, 0603, 1%, 100mW |  | https://cz.mouser.com/ProductDetail/Yageo/RT0603FRE072R2L?qs=sGAEpiMZZMtlubZbdhIBIEDAb9FYnCozLkReAsfYz7s%3D
55 | FT230XQ-R | USB rozhraní IC USB to Basic Serial UART IC QFN-16 | 1 | 50 | 50 | USB to UART IC |  | https://cz.mouser.com/ProductDetail/FTDI/FT230XQ-R?qs=sGAEpiMZZMvVkErl6zY%252BqeI5xuGNHfx4
56 | TMUX1111PWR | 5V, low leakage SPST 4 ch, precision switch NC | 1 | 58 | 58 | Switching opamps inputs |  | https://cz.mouser.com/ProductDetail/Texas-Instruments/TMUX1111PWR
57 | REF5050AIDR | Napěťové reference Lo Noise Very Low Drift Prec VLTG REF | 1 | 69 | 69 | voltage ref 5V |  | https://cz.mouser.com/ProductDetail/Texas-Instruments/REF5050AIDR?qs=sGAEpiMZZMv2US1BCAiBy456W5krGsb2
58 | 1N5819HW-7-F | Schottkyho diody a usměrňovače Vr/40V Io/1A T/R | 5 | 11 | 55 | Schottky diode, 1N5819, SOD123, 40V/1A |  | https://cz.mouser.com/ProductDetail/Diodes-Incorporated/1N5819HW-7-F?qs=sGAEpiMZZMuHSyTciuLGfz7QlcwO2TN6
59 | LAN8742A-CZ-TR | Integrované obvody pro ethernet Small Footprint RMII 10/100 Ethernet Transceiver | 1 | 28 | 28 | 10/100Mb LAN transceiver |  | https://cz.mouser.com/ProductDetail/Microchip-Technology/LAN8742A-CZ-TR?qs=6qKXPk0vzx0Y6uPCt7MXWw%3D%3D
60 | 7499010121A | Modulární konektory, konektory Ethernet WE-RJ45 Intgtd XFMR 1x1 THT Tab Up | 1 | 150 | 150 | LAN RJ45 port |  | https://cz.mouser.com/ProductDetail/Wurth-Elektronik/7499010121A?qs=SaTeGCoDkn19K3ZBsCJq1A%3D%3D
61 | ABM10W-25.0000MHZ-8-D1X-T3 | Krystaly 25MHz 8pF -40C +85C 10ppm | 1 | 10 | 10 | LAN Clock, 25 MHz, 10ppm |  | https://cz.mouser.com/ProductDetail/ECS/ECS-250-10-36B-CTN-TR
62 | STMPS2151STR | Integrované obvody výkonových spínačů - rozvod elektrické energie SGL CHNL PWR SWTCH | 1 | 14 | 14 | Power switch for USB |  | https://cz.mouser.com/ProductDetail/STMicroelectronics/STMPS2151STR?qs=qolwYojYp3THidumZGqCjQ%3D%3D
63 | AP2151AW-7 | Power Switch ICs - Power Distribution 0.5A Sgl-Ch Switch 0.8A 95mOhm 0.6ms | 0 | 11 | 0 | Power switch for USB / alternative |  | https://cz.mouser.com/ProductDetail/Diodes-Incorporated/AP2151AW-7
64 | 2854-2 | Testovací zásuvky a testovací zvedáky BANANA JK RED | 2 | 78 | 156 | Banana panel mount - red |  | https://cz.mouser.com/ProductDetail/Pomona-Electronics/2854-2
65 | 2854-0 | Testovací zásuvky a testovací zvedáky BANANA JACK GOLD PL BLACK | 2 | 78 | 156 | Banana panel mount - black |  | https://cz.mouser.com/ProductDetail/Pomona-Electronics/2854-0?qs=sGAEpiMZZMv8kklI404QlVHm0DZcKyz9
66 | TLV76750DRVR | Regulátory napětí s nízkým úbytkem (LDO) | 1 | 27 | 27 | LDO 5V - USB, PS |  | https://cz.mouser.com/ProductDetail/Texas-Instruments/TLV76750DRVR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
67 | LT1761ES5-5#TRMPBF | Regulátory napětí s nízkým úbytkem (LDO) 100mA, Low Noise, LDO Micropower Regulators in SOT-23 | 1 | 56 | 56 | LDO 5V - Analog |  | https://cz.mouser.com/ProductDetail/Analog-Devices-Linear-Technology/LT1761ES5-5TRMPBF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
68 | LK112M60TR | Regulátory napětí s nízkým úbytkem (LDO) 6.0V 100mA Linear | 1 | 13 | 13 | LDO 6V - Aref supply voltage |  | https://cz.mouser.com/ProductDetail/STMicroelectronics/LK112M60TR?qs=sGAEpiMZZMuD5AK9w5s05tjCv4jTjMWT
69 | TLV76733DRVR | Regulátory napětí s nízkým úbytkem (LDO) | 1 | 27 | 27 | LDO 3,3V - MCU, digital |  | https://cz.mouser.com/ProductDetail/Texas-Instruments/TLV76733DRVR
70 | LM1117MPX-3.3/NOPB | Regulátory napětí s nízkým úbytkem (LDO) 800MA LDO LINEAR REG | 0 | 26 | 0 | LDO 3,3V - MCU, digital / alternative |  | https://cz.mouser.com/ProductDetail/Texas-Instruments/LM1117MPX-33-NOPB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
71 | 1829387 | Zásuvné koncové svorky 6 Pos 3.81mm pitch Feed Through Header | 1 | 200 | 200 | Panel mounted terminal block connectors - 6Pin |  | https://cz.mouser.com/ProductDetail/Phoenix-Contact/1829387?qs=sGAEpiMZZMv8kklI404QldRzEdjljhvI
72 | 1827745 | Zásuvné koncové svorky 6 Pos 3.81mm pitch Plug 28-16 AWG Screw | 1 | 174 | 174 | Panel mounter terminal block - removable terminals |  | https://cz.mouser.com/ProductDetail/Phoenix-Contact/1827745?qs=sGAEpiMZZMuVJC7Vq%252BMl57ODlCZrDSYn
73 | MINIASMDC200F/16-2 | Vratné pojistky (nelineární termistory) MINIASMDC200F/16-2 | 1 | 26 | 26 | PTC vratná pojistka, 2A/16V, 85mOhm |  | https://cz.mouser.com/ProductDetail/Littelfuse/MINIASMDC200F-16-2
74 | S3M | Usměrňovače 1000V 3a Glass Passive | 1 | 11 | 11 | Reverse polarity protection |  | https://cz.mouser.com/ProductDetail/ON-Semiconductor-Fairchild/S3M?qs=sGAEpiMZZMuQUXCJI7Y4lsaa56IoaKH9
75 | VSSC8L45-M3/9AT | Schottkyho diody a usměrňovače 8A,45V,TRENCH SKY RECT. | 1 | 14 | 14 | Reverse polarity protection, alt to S3M |  | https://cz.mouser.com/ProductDetail/Vishay-Semiconductors/VSSC8L45-M3-9AT
76 | 693063020911 | Konektory paměťových karet WR-CRD SD Card Dtctn 9Pin Short Push&Pull | 1 | 78 | 78 | SD card slot |  | https://cz.mouser.com/ProductDetail/Wurth-Elektronik/693063020911
77 | BZT52-B5V6J | Zenerovy diody BZT52-B5V6/SOD123/SOD2 | 1 | 6 | 6 | Power source reverse protection and overvoltage protection, zener diode 5V6 |  | https://cz.mouser.com/ProductDetail/Nexperia/BZT52-B5V6J
78 | HI0805R800R-10 | Feritové perličky 80ohms 100MHz 5A Monolithic 0805 SMD | 6 | 2 | 12 | Ferrite bead |  | https://cz.mouser.com/ProductDetail/Laird-Performance-Materials/HI0805R800R-10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
79 | PHPT60603NYX | Bipolární tranzistory, BJT NPN High Power BipolarTransistor | 1 | 12 | 12 | Filter NPN MOS |  | https://cz.mouser.com/ProductDetail/Nexperia/PHPT60603NYX
80 | PHPT60603PYX | Bipolární tranzistory, BJT BJTPNP High Power BipolarTransistor | 0 | 12 | 0 | complementary to NPN MOS |  | https://cz.mouser.com/ProductDetail/Nexperia/PHPT60603PYX
81 | 150060SS55040 | Standardní LED – povrchová montáž WL-SMCD SMD MonoChip 0603 Super Red 645nm | 2 | 4 | 8 | Indication LED 0603 - top view -- RED |  | https://cz.mouser.com/ProductDetail/Wurth-Elektronik/150060SS55040
82 | 150060VS55040 | Standardní LED – povrchová montáž WL-SMCD SMD MonoChip 0603 BrtGrn 575nm | 3 | 4 | 12 | Indication LED 0603 - top view -- GREEN |  | https://cz.mouser.com/ProductDetail/Wurth-Elektronik/150060VS55040
83 | 150060YS55040 | Standardní LED – povrchová montáž WL-SMCD SMD MonoChip 0603 Yllw 591nm | 2 | 4 | 8 | Indication LED 0603 - top view -- YELLOW/BLUE |  | https://cz.mouser.com/ProductDetail/Wurth-Elektronik/150060YS55040
84 | SML-A12V8TT86 | Standardní LED – povrchová montáž Red 54mW 20mA 630nm Side View | 1 | 9 | 9 | Indication LED 0603 - side view -- RED |  | https://cz.mouser.com/ProductDetail/ROHM-Semiconductor/SML-A12V8TT86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
85 | SML-A12Y8TT86 | Standardní LED – povrchová montáž Yellow Side View 54mW 20mA 590nm | 0 | 9 | 0 | Indication LED 0603 - side view -- YELLOW/BLUE |  | https://cz.mouser.com/ProductDetail/ROHM-Semiconductor/SML-A12Y8TT86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
86 | SML-A12M8TT86 | Standardní LED – povrchová montáž Yell-Grn Side View 54mW 20mA 572nm | 3 | 9 | 27 | Indication LED 0603 - side view -- GREEN |  | https://cz.mouser.com/ProductDetail/ROHM-Semiconductor/SML-A12M8TT86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
87 | DMG3414UQ-7 | MOSFET BVDSS 8V-24V, SOT-23 | 2 | 10 | 20 | range switching, low leakage, N MOS |  | https://cz.mouser.com/ProductDetail/Diodes-Incorporated/DMG3414UQ-7
88 | DMG3401LSN-7 | MOSFET 30V P-CH | 1 | 12 | 12 | range switching, low leakage, P MOS |  | https://cz.mouser.com/ProductDetail/Diodes-Incorporated/DMG3401LSN-7
89 | DMN2009USS-13 | MOSFET MOSFET BVDSS: 8V-24V | 1 | 13 | 13 | range switching, low leakage, N MOS |  | https://cz.mouser.com/ProductDetail/Diodes-Incorporated/DMN2009USS-13
90 | 614004190021 | USB konektory WR-COM USB Type A THT Horizontal | 1 | 32 | 32 | USB Female 2.0 CON, USB Host |  | https://cz.mouser.com/ProductDetail/Wurth-Elektronik/614004190021
91 | 61400416121 | USB konektory WR-COM Type B 4Pin Horztl Female | 1 | 33 | 33 | USB Female 2.0 B CON, USB-UART |  | https://cz.mouser.com/ProductDetail/Wurth-Elektronik/61400416121
92 | DTSM-65N-V-T/R | Klávesové spínače Surface Mounting Type 6*6 | 1 | 9 | 9 | SMD tactile switch |  | https://cz.mouser.com/ProductDetail/Diptronics/DTSM-65N-V-T-R?qs=sGAEpiMZZMsgGjVA3toVBDU/Pbf8wNFA3lN7xM/0ZK0=
93 | PRT-00119 | Příslušenství SparkFun DC Barrel Power Jack/Connector | 1 | 31 | 31 | DC Power jack, 5,5/2,1 |  | https://cz.mouser.com/ProductDetail/SparkFun/PRT-00119
94 | GSM12E07-P1J | Síťové adaptéry do zásuvky 12W 7.5V 1.6A Medical EU 2.1x5.5 | 1 | 351 | 351 | AC/DC power adapter 7V5, 1,6A, 5,5/2,1 |  | https://cz.mouser.com/ProductDetail/MEAN-WELL/GSM12E07-P1J
95 | EPS-45-7.5-C | Spínané napájecí zdroje 40.5W 7.5V 5.4A L-Bracket + Cover | 0 | 421 | 0 | Main AC/DC PSU 45W/7,5V, enclosed |  | https://cz.mouser.com/ProductDetail/MEAN-WELL/EPS-45-75-C
96 | 4304.6058 | Přívodní síťové napájecí moduly 6762 PWR ENTRY MODUL 10A 70C | 0 | 334 | 0 | Main AC input with fuse and power switch, IEC standard power plug |  | https://cz.mouser.com/ProductDetail/Schurter/43046058
97 |  | Výroba PCB - main V3 | 0 | 1400 | 0 | odkad podle cz výrobců, bez strojového osazení
 |  |  |  |  | 4722.5
 |  | To order
 |  | Alternative / nice to have
 |  | Do not order / backup components / extra

Sheet: BOM_V3_20200416
Qty | Value | Device | Package | Parts | Description | APPLICATION | AVAILABILITY | C-CH | CATEGORY | CHANNELS | CREATED_BY | DATA-RATE | DATASHEET-URL | DESCRIPTION.1 | DIGIKEY_PART_NUMBER | GERDER | H | INTERFACE-TYPE | IPEAK | IR1 | LED | MANUFACTURER | MF | MOUNT | MP | MPN | OPERATING_TEMP | OPERATION-FORCE | PACKAGE.1 | PACKAGING | PART-NUMBER | PART_STATUS | PINS | POE | POPULARITY | PORTS | PRICE | QTY.1 | ROHS_COMPLIANT | SERIES | SPICEPREFIX | SUB-CATEGORY | THERMALLOSS | TP_SIGNAL_NAME | TYPE | USB | VALUE.1 | VBR | WE-NUMBER | WORKING-VOLTAGE | ZENER_VOLTAGE | Column1
1 |  | 430152080836 | 430152080836 | S1 | WS-TASV SMT Tact Switch 6x6 mm |  |  |  |  |  |  |  | https://www.we-online.com/catalog/datasheet/430152080836.pdf |  |  |  | 8mm |  |  |  |  |  |  |  |  |  |  | 360g |  |  | 430152080836 |  |  |  |  |  |  | 400
1 |  | 614004190021 | 614004190021 | J4 | WR-COM USB 2.0 Type A Horizontal THT | USB 2.0 |  |  |  |  |  |  | https://www.we-online.com/catalog/datasheet/614004190021.pdf |  |  | Receptacle |  | Type A |  | 3.0A |  |  |  | THT |  |  |  |  |  | Tray | 614004190021 |  | 4 |  |  |  |  |  |  |  |  |  |  |  | Horizontal |  |  |  |  | 30V(AC)
1 |  | 61400416121 | 61400416121 | J5 | WR-COM USB 2.0 Type B Horizontal THR | USB 2.0 |  |  |  |  |  |  | https://www.we-online.com/catalog/datasheet/61410416121R.pdf |  |  | Receptacle |  | Type B |  | 1.5A |  |  |  | THR |  |  |  |  |  | Tape and Reel | 61410416121R |  | 4 |  |  |  |  |  |  |  |  |  |  |  | Horizontal |  |  |  |  | 30V(AC)
1 |  | 693063020911 | 693063020911 | J3 | WR-CRD SD CARD CONNECTOR PUSH & PULL SHORT TYPE WITH CARD DETECTION 9PINS=>Code : Con_I-O_COM_CRD_SD_Normal_693063020911
4 |  | BLM21PG331SN1D | BLM21PG331SN1D | L4, L5, L6, L7 | FERRITE BEAD 330 OHM 0805 1LN |  |  |  |  |  | PCBLayout.com |  |  |  | 490-5988-2-ND |  |  |  |  |  |  | Murata Electronics North America |  |  |  | BLM21PG331SN1D |  |  | 0805
1 |  | DCBARRELPTH | DCJACK_2MM_PTH | X1 | 2.0mm DC Barrel Jack
1 |  | MF-MSMF050-2 | 1812 | F1 | PTC RESET FUSE 15V 500MA 1812 |  |  |  |  |  | PCBLayout.com |  |  |  | MF-MSMF050-2TR-ND |  |  |  |  |  |  | Bourns Inc. |  |  |  | MF-MSMF050-2 |  |  | 1812
6 |  | PINHD-1X1 | 1X01 | JP1, JP2, JP3, JP4, JP5, JP16 | PIN HEADER |  |  |  |  |  |  |  |  |  |  |  |  |  |  |  |  |  |  |  |  |  |  |  |  |  |  |  |  |  | 64
7 |  | PINHD-1X2 | 1X02 | JP6, JP7, JP8, JP9, JP10, JP11, JP14 | PIN HEADER |  |  |  |  |  |  |  |  |  |  |  |  |  |  |  |  |  |  |  |  |  |  |  |  |  |  |  |  |  | 98
2 |  | PINHD-1X6 | 1X06 | JP17, JP25 | PIN HEADER |  |  |  |  |  |  |  |  |  |  |  |  |  |  |  |  |  |  |  |  |  |  |  |  |  |  |  |  |  | 79
1 |  | PINHD-2X4 | 2X04 | JP13 | PIN HEADER |  |  |  |  |  |  |  |  |  |  |  |  |  |  |  |  |  |  |  |  |  |  |  |  |  |  |  |  |  | 47
1 |  | PINHD-2X5 | 2X05 | JP12 | PIN HEADER |  |  |  |  |  |  |  |  |  |  |  |  |  |  |  |  |  |  |  |  |  |  |  |  |  |  |  |  |  | 35
1 |  | PINHD-2X8 | 2X08 | JP24 | PIN HEADER |  |  |  |  |  |  |  |  |  |  |  |  |  |  |  |  |  |  |  |  |  |  |  |  |  |  |  |  |  | 6
1 |  | SJ2W | SJ_2 | SJ27 | SMD solder JUMPER |  |  |  |  |  |  |  |  |  |  |  |  |  |  |  |  |  |  |  |  |  |  |  |  |  |  |  |  |  | 7
2 |  | WE-CBF_0805_742792036_WB_HS | WE-CBF_0805(W=3.0) | L1, L2 | WE-CBF SMD EMI Suppression Ferrite Bead |  |  |  |  |  |  |  |  |  |  |  |  |  |  |  |  |  |  |  |  |  |  |  |  |  |  |  |  |  |  |  |  |  |  |  |  |  |  |  |  |  |  |  | 742792036/470Î©(Z@100MHz)
1 |  | WE-RJ45_7499010121A | 7499010121A | T1 | WE-RJ45 LAN Transformer |  |  |  |  |  |  | 10/100 Base-T | https://katalog.we-online.com/pbs/datasheet/7499010121A.pdf |  |  |  |  |  |  |  | yellow-green |  |  | THT |  |  |  |  |  |  | 7499010121A |  |  | non-PoE |  | 1 |  |  |  |  |  |  |  |  |  | No
8 |  | WIREPADSMD2,54-5,08 | SMD2,54-5,08 | PAD1, PAD2, PAD3, PAD4, PAD5, PAD6, PAD7, PAD8 | Wire PAD connect wire on PCB |  |  |  |  |  |  |  |  |  |  |  |  |  |  |  |  |  |  |  |  |  |  |  |  |  |  |  |  |  | 2
37 | 100n / 0603 | C-EUC0603 | C0603 | C1, C3, C5, C10, C14, C21, C22, C26, C27, C28, C29, C43, C49, C50, C53, C54, C59, C63, C72, C78, C81, C82, C83, C84, C85, C86, C88, C91, C92, C96, C98, C99, C100, C101, C106, C107, C108 | CAPACITOR, European symbol |  |  |  |  |  |  |  |  |  |  |  |  |  |  |  |  |  |  |  |  |  |  |  |  |  |  |  |  |  | 73 |  |  |  |  |  | C
19 | 10K | R-EU_R0603 | R0603 | R14, R15, R17, R34, R35, R36, R37, R38, R52, R53, R56, R58, R59, R61, R63, R66, R79, R88, R89 | RESISTOR, European symbol |  |  |  |  |  |  |  |  |  |  |  |  |  |  |  |  |  |  |  |  |  |  |  |  |  |  |  |  |  | 70 |  |  |  |  |  | R
1 | 10K 0.05% | R-EU_R0805 | R0805 | R1 | RESISTOR, European symbol |  |  |  |  |  |  |  |  |  |  |  |  |  |  |  |  |  |  |  |  |  |  |  |  |  |  |  |  |  | 86 |  |  |  |  |  | R
1 | 10R 0.05% | R-EU_R0805 | R0805 | R2 | RESISTOR, European symbol |  |  |  |  |  |  |  |  |  |  |  |  |  |  |  |  |  |  |  |  |  |  |  |  |  |  |  |  |  | 86 |  |  |  |  |  | R
3 | 10n / 0603 | C-EUC0603 | C0603 | C15, C39, C109 | CAPACITOR, European symbol |  |  |  |  |  |  |  |  |  |  |  |  |  |  |  |  |  |  |  |  |  |  |  |  |  |  |  |  |  | 73 |  |  |  |  |  | C
1 | 10n / 0603 NP0 | C-EUC0603 | C0603 | C19 | CAPACITOR, European symbol |  |  |  |  |  |  |  |  |  |  |  |  |  |  |  |  |  |  |  |  |  |  |  |  |  |  |  |  |  | 73 |  |  |  |  |  | C
2 | 10p / 0603 NP0 | C-EUC0603 | C0603 | C4, C9 | CAPACITOR, European symbol |  |  |  |  |  |  |  |  |  |  |  |  |  |  |  |  |  |  |  |  |  |  |  |  |  |  |  |  |  | 73 |  |  |  |  |  | C
2 | 10u | CPOL-EUSMCB | SMC_B | C51, C52 | POLARIZED CAPACITOR, European symbol |  |  |  |  |  |  |  |  |  |  |  |  |  |  |  |  |  |  |  |  |  |  |  |  |  |  |  |  |  | 25 |  |  |  |  |  | C
24 | 10u / 0805 | C-EUC0805 | C0805 | C2, C6, C7, C8, C11, C12, C16, C18, C20, C23, C24, C30, C33, C34, C38, C56, C58, C60, C62, C87, C93, C97, C102, C104 | CAPACITOR, European symbol |  |  |  |  |  |  |  |  |  |  |  |  |  |  |  |  |  |  |  |  |  |  |  |  |  |  |  |  |  | 88 |  |  |  |  |  | C
3 | 10u / 1206 | C-EUC1206 | C1206 | C36, C47, C48 | CAPACITOR, European symbol |  |  |  |  |  |  |  |  |  |  |  |  |  |  |  |  |  |  |  |  |  |  |  |  |  |  |  |  |  | 54 |  |  |  |  |  | C
1 | 12K1 1% | R-EU_R0603 | R0603 | R68 | RESISTOR, European symbol |  |  |  |  |  |  |  |  |  |  |  |  |  |  |  |  |  |  |  |  |  |  |  |  |  |  |  |  |  | 70 |  |  |  |  |  | R
4 | 12pF / 0603 NP0 | C-EUC0603 | C0603 | C76, C79, C89, C90 | CAPACITOR, European symbol |  |  |  |  |  |  |  |  |  |  |  |  |  |  |  |  |  |  |  |  |  |  |  |  |  |  |  |  |  | 73 |  |  |  |  |  | C
2 | 14p / 0603 NP0 | C-EUC0603 | C0603 | C73, C74 | CAPACITOR, European symbol |  |  |  |  |  |  |  |  |  |  |  |  |  |  |  |  |  |  |  |  |  |  |  |  |  |  |  |  |  | 73 |  |  |  |  |  | C
2 | 1K | R-EU_R0603 | R0603 | R20, R21 | RESISTOR, European symbol |  |  |  |  |  |  |  |  |  |  |  |  |  |  |  |  |  |  |  |  |  |  |  |  |  |  |  |  |  | 70 |  |  |  |  |  | R
2 | 1K 0.05% | R-EU_R0603 | R0603 | R5, R8 | RESISTOR, European symbol |  |  |  |  |  |  |  |  |  |  |  |  |  |  |  |  |  |  |  |  |  |  |  |  |  |  |  |  |  | 70 |  |  |  |  |  | R
1 | 1K5 | R-EU_R0603 | R0603 | R64 | RESISTOR, European symbol |  |  |  |  |  |  |  |  |  |  |  |  |  |  |  |  |  |  |  |  |  |  |  |  |  |  |  |  |  | 70 |  |  |  |  |  | R
5 | 1N5819HW-7-F | CGRM4001-G | SOD-123_MINI-SMA | D2, D3, D4, D5, D10 | Molded plasitc,JEDEC SOD-123/Mini SMA |  |  |  |  |  |  |  |  |  |  |  |  |  |  |  |  |  |  |  |  |  |  |  |  |  |  |  |  |  | 0
4 | 1R | R-EU_R0603 | R0603 | R11, R16, R24, R25 | RESISTOR, European symbol |  |  |  |  |  |  |  |  |  |  |  |  |  |  |  |  |  |  |  |  |  |  |  |  |  |  |  |  |  | 70 |  |  |  |  |  | R
5 | 1u / 0603 | C-EUC0603 | C0603 | C13, C17, C32, C80, C95 | CAPACITOR, European symbol |  |  |  |  |  |  |  |  |  |  |  |  |  |  |  |  |  |  |  |  |  |  |  |  |  |  |  |  |  | 73 |  |  |  |  |  | C
2 | 2,2u / 0805 | C-EUC0805 | C0805 | C75, C77 | CAPACITOR, European symbol |  |  |  |  |  |  |  |  |  |  |  |  |  |  |  |  |  |  |  |  |  |  |  |  |  |  |  |  |  | 88 |  |  |  |  |  | C
1 | 20MHz (8pF)/Â±10 ppm | WE-XTAL_CFPX-218_830069381 | WE-XTAL_CFPX-218 | Q8 | WE-XTAL Quartz Crystal |  |  |  |  |  |  |  |  |  |  |  |  |  |  |  |  |  |  |  |  |  |  |  |  |  |  |  |  |  |  |  |  |  |  |  |  |  |  |  |  |  | 20MHz/Â±20 ppm |  | 830069381
1 | 22u / 0805 | C-EUC0805 | C0805 | C25 | CAPACITOR, European symbol |  |  |  |  |  |  |  |  |  |  |  |  |  |  |  |  |  |  |  |  |  |  |  |  |  |  |  |  |  | 88 |  |  |  |  |  | C
5 | 22u / 1210 | C-EUC1210 | C1210 | C37, C40, C41, C42, C57 | CAPACITOR, European symbol |  |  |  |  |  |  |  |  |  |  |  |  |  |  |  |  |  |  |  |  |  |  |  |  |  |  |  |  |  | 0 |  |  |  |  |  | C
1 | 25MHz (8pF)/Â±10 ppm | WE-XTAL_CFPX-218_830069381 | WE-XTAL_CFPX-218 | Q9 | WE-XTAL Quartz Crystal |  |  |  |  |  |  |  |  |  |  |  |  |  |  |  |  |  |  |  |  |  |  |  |  |  |  |  |  |  |  |  |  |  |  |  |  |  |  |  |  |  | 20MHz/Â±20 ppm |  | 830069381
4 | 270R | R-EU_R0603 | R0603 | R4, R12, R77, R78 | RESISTOR, European symbol |  |  |  |  |  |  |  |  |  |  |  |  |  |  |  |  |  |  |  |  |  |  |  |  |  |  |  |  |  | 70 |  |  |  |  |  | R
2 | 27R | R-EU_R0603 | R0603 | R75, R76 | RESISTOR, European symbol |  |  |  |  |  |  |  |  |  |  |  |  |  |  |  |  |  |  |  |  |  |  |  |  |  |  |  |  |  | 70 |  |  |  |  |  | R
2 | 2K2 0.05% | R-EU_R0603 | R0603 | R7, R10 | RESISTOR, European symbol |  |  |  |  |  |  |  |  |  |  |  |  |  |  |  |  |  |  |  |  |  |  |  |  |  |  |  |  |  | 70 |  |  |  |  |  | R
2 | 2R2 1% | R-EU_R0603 | R0603 | R22, R23 | RESISTOR, European symbol |  |  |  |  |  |  |  |  |  |  |  |  |  |  |  |  |  |  |  |  |  |  |  |  |  |  |  |  |  | 70 |  |  |  |  |  | R
1 | 32.768kHz (9pF)/Â±10 ppm | WE-XTAL_IQXC-25_830062558 | WE-XTAL_IQXC-25 | Q7 | WE-XTAL Quartz Crystal |  |  |  |  |  |  |  |  |  |  |  |  |  |  |  |  |  |  |  |  |  |  |  |  |  |  |  |  |  |  |  |  |  |  |  |  |  |  |  |  |  | 0.032768MHz |  | 830062558
12 | 330R | R-EU_R0603 | R0603 | R13, R26, R62, R67, R70, R73, R82, R83, R84, R85, R86, R87 | RESISTOR, European symbol |  |  |  |  |  |  |  |  |  |  |  |  |  |  |  |  |  |  |  |  |  |  |  |  |  |  |  |  |  | 70 |  |  |  |  |  | R
5 | 33R | R-EU_R0603 | R0603 | R28, R40, R54, R55, R60 | RESISTOR, European symbol |  |  |  |  |  |  |  |  |  |  |  |  |  |  |  |  |  |  |  |  |  |  |  |  |  |  |  |  |  | 70 |  |  |  |  |  | R
1 | 470n / 0603 | C-EUC0603 | C0603 | C55 | CAPACITOR, European symbol |  |  |  |  |  |  |  |  |  |  |  |  |  |  |  |  |  |  |  |  |  |  |  |  |  |  |  |  |  | 73 |  |  |  |  |  | C
1 | 470p / 0603 | C-EUC0603 | C0603 | C94 | CAPACITOR, European symbol |  |  |  |  |  |  |  |  |  |  |  |  |  |  |  |  |  |  |  |  |  |  |  |  |  |  |  |  |  | 73 |  |  |  |  |  | C
2 | 470u | CPOL-EUG | PANASONIC_G | C35, C45 | POLARIZED CAPACITOR, European symbol |  |  |  |  |  |  |  |  |  |  |  |  |  |  |  |  |  |  |  |  |  |  |  |  |  |  |  |  |  | 2 |  |  |  |  |  | C
1 | 47K | R-EU_R0603 | R0603 | R57 | RESISTOR, European symbol |  |  |  |  |  |  |  |  |  |  |  |  |  |  |  |  |  |  |  |  |  |  |  |  |  |  |  |  |  | 70 |  |  |  |  |  | R
2 | 47p / 0603 | C-EUC0603 | C0603 | C103, C105 | CAPACITOR, European symbol |  |  |  |  |  |  |  |  |  |  |  |  |  |  |  |  |  |  |  |  |  |  |  |  |  |  |  |  |  | 73 |  |  |  |  |  | C
4 | 49,9R | R-EU_R0603 | R0603 | R69, R71, R72, R74 | RESISTOR, European symbol |  |  |  |  |  |  |  |  |  |  |  |  |  |  |  |  |  |  |  |  |  |  |  |  |  |  |  |  |  | 70 |  |  |  |  |  | R
4 | 4K7 | R-EU_R0603 | R0603 | R19, R27, R80, R81 | RESISTOR, European symbol |  |  |  |  |  |  |  |  |  |  |  |  |  |  |  |  |  |  |  |  |  |  |  |  |  |  |  |  |  | 70 |  |  |  |  |  | R
1 | 500R | R-EU_R0603 | R0603 | R65 | RESISTOR, European symbol |  |  |  |  |  |  |  |  |  |  |  |  |  |  |  |  |  |  |  |  |  |  |  |  |  |  |  |  |  | 70 |  |  |  |  |  | R
2 | 6K8 0.05% | R-EU_R0603 | R0603 | R6, R9 | RESISTOR, European symbol |  |  |  |  |  |  |  |  |  |  |  |  |  |  |  |  |  |  |  |  |  |  |  |  |  |  |  |  |  | 70 |  |  |  |  |  | R
1 | AD5259BRMZ10 | AD5259BRMZ5 | SOP50P490X95-10N | U11 | Digital Potentiometer 256POS 5kOhm Single Automotive 10-Pin MSOP Tube |  | Unavailable |  |  |  |  |  |  | Digital Potentiometer 5k Ohm 1 Circuit 256 Taps IÂ˛C Interface 10-MSOP |  |  |  |  |  |  |  |  | Analog Devices |  | AD5259BRMZ5 |  |  |  | MSOP-10 Analog Devices |  |  |  |  |  |  |  | None
1 | AD5259BRMZ50 | AD5259BRMZ5 | SOP50P490X95-10N | U12 | Digital Potentiometer 256POS 5kOhm Single Automotive 10-Pin MSOP Tube |  | Unavailable |  |  |  |  |  |  | Digital Potentiometer 5k Ohm 1 Circuit 256 Taps IÂ˛C Interface 10-MSOP |  |  |  |  |  |  |  |  | Analog Devices |  | AD5259BRMZ5 |  |  |  | MSOP-10 Analog Devices |  |  |  |  |  |  |  | None
2 | AD8628 | MAX4239AUT+T | SOT23-6 | U3, U5
1 | ADS8681IPWR | ADS8681IPWR | SOP65P640X120-16N | U7
1 | ADS8910BRGET | ADS8910BRGET | 24-VFQFN | U6
1 | AT24C256C-SSHL-T | AT24C256C-SSHL-T | SOIC127P600X175-8N | U17 | EEPROM Serial-2Wire 256K-bit 32K x 8 1.8V/2.5V/3.3V/5V 8-Pin SOIC Bulk |  | Unavailable |  |  |  |  |  |  | EEPROM Memory IC 256Kb _32K x 8_ IÂ˛C 1MHz 550ns 8-SOIC |  |  |  |  |  |  |  |  | Microchip |  | AT24C256C-SSHL-T |  |  |  | SO-8 Microchip |  |  |  |  |  |  |  | None
2 | BLUE_TOP | LEDCHIP-LED0603 | CHIP-LED0603 | LED8, LED10
0 | BLUE_SIDE | LEDCHIP-LED0603 | CHIP-LED0603 |  | LED |  |  |  |  |  |  |  |  |  |  |  |  |  |  |  |  |  |  |  |  |  |  |  |  |  |  |  |  |  | 26
1 | BZT52-B5V6J | ZENER_MMSZ5240BTDO-219-AB(SOD123F) | SODFL3718X115 | D9 | Zener Diode - Popular parts |  |  |  | Diode |  |  |  |  | DIODE ZENER 10V 500MW SOD123 |  |  |  |  |  |  |  | ON Semiconductor |  |  |  | MMSZ5240BT1G |  |  |  |  |  |  |  |  |  |  |  |  |  |  |  | Zener | 0.5W
1 | Clamp_diode | S1M | DO214AC | D11
1 | DMG3401LSN-7 | DMG3401LSN-7 | SOT23 | Q3
2 | DMG3414UQ-7 | DMG3414UQ-7 | SOT23 | Q1, Q10
1 | DMN2009USS | DMN2009USS | SO8 | Q11
1 | FT230XQ-R | FT232XQ-R | QFN16-4X4 | U21
3 | GREEN_TOP | LEDCHIP-LED0603 | CHIP-LED0603 | LED1, LED7, LED9
3 | GREEN_SIDE | LEDCHIP-LED0603 | CHIP-LED0603 | LED3, LED4, LED5 | LED |  |  |  |  |  |  |  |  |  |  |  |  |  |  |  |  |  |  |  |  |  |  |  |  |  |  |  |  |  | 26
1 | LAN8742A-CZ-TR | LAN8742A-CZ-TR | 24-VFQFN | U20
1 | LK112M60TR | LK112M60TR | SOT23-5 | U8
1 | LT1761ES5-5TRMPBF | LT1761ES5-5TRMPBF | SOT95P280X100-5N | U22 | 100mA, Low Noise, LDO Micropower Regulators |  | Unavailable |  |  |  |  |  |  | LDO Regulator Pos 5V 0.1A Automotive 5-Pin TSOT-23 T/R |  |  |  |  |  |  |  |  | Analog Devices |  | LT1761ES5-5#TRMPBF |  |  |  | SOT-23-5 Analog Devices |  |  |  |  |  |  |  | None
2 | LT3045EDD#TRPBF | LT3045EDD#TRPBF | SON50P300X300X80-11N | VR1, VR2 | LT3045 - 20V, 500mA, Ultralow Noise, Ultrahigh PSRR Linear Regulator |  | Unavailable |  |  |  |  |  |  | LDO Regulator Pos 0V to 15V 0.5A Automotive 10-Pin DFN EP T/R |  |  |  |  |  |  |  |  | Analog Devices |  | LT3045EDD#TRPBF |  |  |  | DFN -10 Analog Devices |  |  |  |  |  |  |  | None
1 | MAX4239AUT+T | MAX4239AUT+T | SOT23-6 | U2
4 | MOUNT-HOLE3.2 | MOUNT-HOLE3.2 | 3,2 | H1, H2, H3, H4 | MOUNTING HOLE with drill center marker |  |  |  |  |  |  |  |  |  |  |  |  |  |  |  |  |  |  |  |  |  |  |  |  |  |  |  |  |  | 7
1 | PHPT60603NYX | PHPT60603NYX | TO127P600X120-5N | Q4
1 | R01 0.05% | CSM_R01 | R2512 | R3
1 | RED_SIDE | LEDCHIP-LED0603 | CHIP-LED0603 | LED2
3 | RED_TOP | LEDCHIP-LED0603 | CHIP-LED0603 | LED6, LED12 | LED |  |  |  |  |  |  |  |  |  |  |  |  |  |  |  |  |  |  |  |  |  |  |  |  |  |  |  |  |  | 26
1 | REF5050IDR | REF5050IDR | SOIC127P600X175-8N | U4 | Low-Noise, Very Low Drift, Precision VOLTAGE REFERENCE |  | Unavailable |  |  |  |  |  |  | Low Noise, Very Low Drift, Precision VOLTAGE REFERENCE 8-SOIC -40 to 125 |  |  |  |  |  |  |  |  | Texas Instruments |  | REF5050IDR |  |  |  | SOIC-8 Texas Instruments |  |  |  |  |  |  |  | None
1 | S3M | S1M | DO214AC | D1
1 | SI8642BB-B-IU | SI8642BB-B-IU | QSOP16 | U18
1 | STM32F767VIT6 | STM32F745VET6 | QFP50P1600X1600X160-100N | U16 | MCU 32-Bit STM32 ARM Cortex M7 RISC 512KB Flash 1.8V/2.5V/3.3V 100-Pin LQFP Tray |  | Unavailable |  |  |  |  |  |  | ARMÂ® CortexÂ®-M7 STM32F7 Microcontroller IC 32-Bit 216MHz 512KB _512K x 8_ FLASH 100-LQFP _14x14_ |  |  |  |  |  |  |  |  | STMicroelectronics |  | STM32F745VET6 |  |  |  | LQFP-100 STMicroelectronics |  |  |  |  |  |  |  | None
1 | STMPS2151STR | STMPS2151STR | SOT-23-5 | U19
1 | TLV76750DRVT | TLV76701DRVT | SON65P200X200X80-7N | U13 | LDO Voltage Regulators LOW-COST 1A MEDIUM VOLTAGE LDO ADJ |  | Unavailable |  |  |  |  |  |  | Linear Voltage Regulator IC 1 Output 1A 6-WSON _2x2_ |  |  |  |  |  |  |  |  | Texas Instruments |  | TLV76701DRVT |  |  |  | WDFN-6 Texas Instruments |  |  |  |  |  |  |  | None
1 | TLV76733DRVR | TLV76701DRVT | SON65P200X200X80-7N | U9 | LDO Voltage Regulators LOW-COST 1A MEDIUM VOLTAGE LDO ADJ
1 | TMUX1111PWRTSSOP16 | TMUX1111PWRTSSOP16 | SOP65P640X110-16N | U1
17 | TPSB1,27 | TPSB1,27 | B1,27 | TP1, TP2, TP3, TP4, TP5, TP6, TP7, TP8, TP9, TP10, TP11, TP12, TP13, TP14, TP15, TP30, TP31 | TEST PIN |  |  |  |  |  |  |  |  |  |  |  |  |  |  |  |  |  |  |  |  |  |  |  |  |  |  |  |  |  | 0
3 | USBLC6-4SC6 | WE-TVS-HS_SOT23-6L_824015 | WE-TVS_SOT23-6L | D6, D7, D8 | WE-TVS TVS Diode â€“ High Speed Series |  |  | 2pF |  | 4+1 |  |  | https://katalog.we-online.com/pbs/datasheet/824015.pdf |  |  |  |  |  | 12A |  |  |  |  | SMT |  |  |  |  |  |  | 824015 |  |  |  |  |  |  |  |  |  |  |  |  |  |  |  | 5Vdc | 6.1V

Sheet: BOM_Extension_V1
 | Označení | Popis | Počet ks | Cena za ks | Cena celkově | Poznámka | Farnell | Mouser
1 | NHD-C160100DiZ-FSW-FBW | LCD displejové moduly a příslušenství FSTN (+) 50.0 x 45.0 x 4.0 | 1 | 435 | 435 | LCD screen |  | https://cz.mouser.com/ProductDetail/Newhaven-Display/NHD-C160100DiZ-FSW-FBW
2 | 52892-1433 | Konektory pro ploché kabely (FFC) a ohebné obvodové desky (FPC) 0.5 FFC ZIF 14Ckt Sn-Ag-Bi | 0 | 21 | 0 | LCD data port |  | https://cz.mouser.com/ProductDetail/?qs=s7UCm7gO1bYIMKUCbSfPNQ%3D%3D
3 | (G)SM02B-SRSS-TB (LF)(SN)(P) | JST power connector 2P | 0 | 10 | 0 | LCD power port | https://www.digikey.com/product-detail/en/jst-sales-america-inc/SM02B-SRSS-TB-LF-SN/455-1802-1-ND/926873 | https://cz.mouser.com/ProductDetail/JST/GSM02B-SRSS-TB-LFSNP
4 | CC0603KPX7R9BB104 | Vícevrstvé keramické kondenzátory MLCC – pro povrchovou montáž SMD, SMT 100nF 50V X7R 10% | 16 | 1.5 | 24 | 100nF, X7R, 0603, ceramic, 50V |  | https://cz.mouser.com/ProductDetail/Yageo/CC0603KPX7R9BB104
5 | 0603DC105KAT2A | Vícevrstvé keramické kondenzátory MLCC – pro povrchovou montáž SMD, SMT 35V 1uF X7R 0603 0.1 | 7 | 5 | 35 | 1uF, X7R, 0603, ceramic, 35V |  | https://cz.mouser.com/ProductDetail/AVX/0603DC105KAT2A
6 | T520B107M010ATE070 | Tantalové kapacitory - polymer SMD 10V 100uF 1311 20% ESR=70mOhms | 2 | 32 | 64 | 100uF, Tantal, SMD B, 10V |  | https://cz.mouser.com/ProductDetail/KEMET/T520B107M010ATE070
7 | CRCW060310K0JNEAC | Tlustovrstvé rezistory – SMD 1/10Watt 10Kohms 5% Commercial Use | 14 | 3 | 42 | 10K, 0603, 5%, 100mW |  | https://cz.mouser.com/ProductDetail/Vishay-Dale/CRCW060310K0JNEAC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
8 | CRCW06034K70FKEAC | Tlustovrstvé rezistory – SMD 1/10Watt 4.7Kohms 1% Commercial Use | 2 | 4 | 8 | 4K7, 0603, 1%, 100mW, alt to I2C pullups |  | https://cz.mouser.com/ProductDetail/Vishay-Dale/CRCW06034K70FKEAC
9 | RC0603FR-07160RL | Tlustovrstvé rezistory – SMD 160 OHM 1% | 9 | 3 | 27 | 160R, 0603, 1%, 100mW |  | https://cz.mouser.com/ProductDetail/Yageo/RC0603FR-07160RL?qs=sGAEpiMZZMtlubZbdhIBIPpBVm91En7nj2zjL9x90HU%3D
10 | ERJ-3EKF3300V | Tlustovrstvé rezistory – SMD 0603 330ohms 1% AEC-Q200 | 3 | 3 | 9 | 330R, 0603, 1%, 100mW |  | https://cz.mouser.com/ProductDetail/Panasonic/ERJ-3EKF3300V
11 | RCS06032R00FKEA | Tlustovrstvé rezistory – SMD 0.25watt 2ohms 1% 100ppm | 0 | 6 | 0 | 2R, 0603, 1%, 100mW |  | https://cz.mouser.com/ProductDetail/Vishay-Dale/RCS06032R00FKEA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
12 | ESR03EZPF10R0 | Tlustovrstvé rezistory – SMD 0603 10ohm 1% Anti Surge AEC-Q200 | 1 | 3 | 3 | 10R, 0603, 1%, 250mW |  | https://cz.mouser.com/ProductDetail/ROHM-Semiconductor/ESR03EZPF10R0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
13 | 150060SS55040 | Standardní LED – povrchová montáž WL-SMCD SMD MonoChip 0603 Super Red 645nm | 1 | 4 | 4 | Indication LED 0603 - top view -- RED |  | https://cz.mouser.com/ProductDetail/Wurth-Elektronik/150060SS55040
14 | 150060VS55040 | Standardní LED – povrchová montáž WL-SMCD SMD MonoChip 0603 BrtGrn 575nm | 1 | 4 | 4 | Indication LED 0603 - top view -- GREEN |  | https://cz.mouser.com/ProductDetail/Wurth-Elektronik/150060VS55040
15 | 150060YS55040 | Standardní LED – povrchová montáž WL-SMCD SMD MonoChip 0603 Yllw 591nm | 1 | 4 | 4 | Indication LED 0603 - top view -- YELLOW/BLUE |  | https://cz.mouser.com/ProductDetail/Wurth-Elektronik/150060YS55040
16 | DMG3414UQ-7 | MOSFET BVDSS 8V-24V, SOT-23 | 4 | 10 | 40 | range switching, low leakage, N MOS |  | https://cz.mouser.com/ProductDetail/Diodes-Incorporated/DMG3414UQ-7
17 | DTSM-65N-V-T/R | Klávesové spínače Surface Mounting Type 6*6 | 8 | 9 | 72 | SMD tactile switch |  | https://cz.mouser.com/ProductDetail/Diptronics/DTSM-65N-V-T-R?qs=sGAEpiMZZMsgGjVA3toVBDU/Pbf8wNFA3lN7xM/0ZK0= | https://cz.mouser.com/ProductDetail/Diptronics/DTSM-65N-V-T-R?qs=sGAEpiMZZMsgGjVA3toVBDU/Pbf8wNFA3lN7xM/0ZK0= | DTSM-65N-V-T/R | Klávesové spínače Surface Mounting Type 6*6 | 1 | 9 | 9 | SMD tactile switch | https://cz.mouser.com/ProductDetail/Diptronics/DTSM-65N-V-T-R?qs=sGAEpiMZZMsgGjVA3toVBDU/Pbf8wNFA3lN7xM/0ZK0= | DTSM-65N-V-T/R | Klávesové spínače Surface Mounting Type 6*6 | 1 | 9 | 9 | SMD tactile switch | https://cz.mouser.com/ProductDetail/Diptronics/DTSM-65N-V-T-R?qs=sGAEpiMZZMsgGjVA3toVBDU/Pbf8wNFA3lN7xM/0ZK0= | DTSM-65N-V-T/R | Klávesové spínače Surface Mounting Type 6*6 | 1 | 9 | 9 | SMD tactile switch | https://cz.mouser.com/ProductDetail/Diptronics/DTSM-65N-V-T-R?qs=sGAEpiMZZMsgGjVA3toVBDU/Pbf8wNFA3lN7xM/0ZK0= | DTSM-65N-V-T/R | Klávesové spínače Surface Mounting Type 6*6 | 1 | 9 | 9 | SMD tactile switch | https://cz.mouser.com/ProductDetail/Diptronics/DTSM-65N-V-T-R?qs=sGAEpiMZZMsgGjVA3toVBDU/Pbf8wNFA3lN7xM/0ZK0= | DTSM-65N-V-T/R | Klávesové spínače Surface Mounting Type 6*6 | 1 | 9 | 9 | SMD tactile switch | https://cz.mouser.com/ProductDetail/Diptronics/DTSM-65N-V-T-R?qs=sGAEpiMZZMsgGjVA3toVBDU/Pbf8wNFA3lN7xM/0ZK0= | DTSM-65N-V-T/R | Klávesové spínače Surface Mounting Type 6*6 | 1 | 9
18 | PS1240P02BT | Piezoelektrické bzučáky a indikátory zvuku Round 12.2mmx6.5mm 4kHz Vin=3V | 1 | 17 | 17 | Buzzer 3V |  | https://cz.mouser.com/ProductDetail/TDK/PS1240P02BT?qs=sGAEpiMZZMsK322k1rNFfYfXmCWsjkB8iQfg2vl062k%3D
19 | RC0603FR-0727RL | Tlustovrstvé rezistory – SMD 27 OHM 1% | 1 | 3 | 3 | 27R, 0603, 1%, 100mW |  | https://cz.mouser.com/ProductDetail/Yageo/RC0603FR-0727RL?qs=sGAEpiMZZMtlubZbdhIBIJbtIA4CxR8fOra1btXn4eY%3D
20 | 1N5819HW-7-F | Schottkyho diody a usměrňovače Vr/40V Io/1A T/R | 1 | 11 | 11 | Schottky diode, 1N5819, SOD123, 40V/1A |  | https://cz.mouser.com/ProductDetail/Diodes-Incorporated/1N5819HW-7-F?qs=sGAEpiMZZMuHSyTciuLGfz7QlcwO2TN6
21 |  | Výroba PCB - extension | 0 | 700 | 0 | odkad podle cz výrobců, bez strojového osazení
 |  |  |  |  | 802
 |  | To order
 |  | Alternative / nice to have
 |  | Do not order / backup components / extra

Sheet: BOM_Extension_V1_20200416
Qty | Value | Device | Package | Parts | Description | AVAILABILITY | CREATED_BY | DATASHEET-URL | DESCRIPTION.1 | DIGIKEY_PART_NUMBER | H | MANUFACTURER | MF | MP | MPN | OC_FARNELL | OC_NEWARK | OPERATION-FORCE | PACKAGE.1 | PART-NUMBER | POPULARITY | PRICE | QTY.1 | SPICEPREFIX | Column1
8 |  | 430152095826 | 430152095826 | S1, S2, S3, S4, S5, S6, S7, S8 | WS-TASV SMT Tact Switch 6x6 mm |  |  | https://www.we-online.com/catalog/datasheet/430152095826.pdf |  |  | 9mm |  |  |  |  |  |  | 260g |  | 430152095826 |  |  | 400
1 |  | PINHD-2X8 | 2X08 | JP1 | PIN HEADER |  |  |  |  |  |  |  |  |  |  |  |  |  |  |  | 6
2 |  | SJ2W | SJ_2 | SJ1, SJ2 | SMD solder JUMPER |  |  |  |  |  |  |  |  |  |  |  |  |  |  |  | 7
16 | 100n / 0603 | C-EUC0603 | C0603 | C5, C8, C10, C11, C12, C13, C14, C15, C16, C17, C18, C19, C20, C21, C22, C23 | CAPACITOR, European symbol |  |  |  |  |  |  |  |  |  |  |  |  |  |  |  | 73 |  |  | C
2 | 100u | CPOL-EUSMCB | SMC_B | C24, C25 | POLARIZED CAPACITOR, European symbol |  |  |  |  |  |  |  |  |  |  |  |  |  |  |  | 25 |  |  | C
14 | 10K | R-EU_R0603 | R0603 | R1, R4, R5, R8, R9, R12, R13, R16, R17, R21, R22, R23, R24, R26 | RESISTOR, European symbol |  |  |  |  |  |  |  |  |  |  |  |  |  |  |  | 70 |  |  | R
9 | 160R | R-EU_R0603 | R0603 | R3, R6, R7, R10, R11, R14, R15, R27 | RESISTOR, European symbol |  |  |  |  |  |  |  |  |  |  |  |  |  |  |  | 70 |  |  | R
7 | 1u / 0603 | C-EUC0603 | C0603 | C1, C2, C3, C4, C6, C7, C9 | CAPACITOR, European symbol |  |  |  |  |  |  |  |  |  |  |  |  |  |  |  | 73 |  |  | C
1 | 10R | R-EU_R0603 | R0603 | R2 | RESISTOR, European symbol |  |  |  |  |  |  |  |  |  |  |  |  |  |  |  | 70 |  |  | R
3 | 330R | R-EU_R0603 | R0603 | R18, R19, R20 | RESISTOR, European symbol |  |  |  |  |  |  |  |  |  |  |  |  |  |  |  | 70 |  |  | R
1 | 52892-1495 | 52892-1495 | MOLEX_52892-1495 | U1 | CONNECTOR, FPC, ZIF, 0.50MM, 14 WAY | Unavailable |  |  | Conn FFC/FPC Connector SKT 14 POS 0.5mm Solder RA SMD Embossed T/R |  |  |  | Molex Connector | 52892-1495 |  |  |  |  | None |  |  | None
1 | AL11P | AL11P | AL11P | SP1 | SPEAKER Source: Buerklin |  |  |  |  |  |  |  |  |  |  | unknown | unknown |  |  |  | 3
1 | BLUE_TOP | LTST-C190KRKT | LED-0603 | D3 | LED RED CLEAR CHIP SMD |  | PCBLayout.com |  |  | 160-1436-1-ND |  | Lite-On Inc. |  |  | LTST-C190KRKT |  |  |  | 0603
4 | DMG3414UQ-7 | BSS123 | SOT23 | Q1, Q2, Q3, Q4 | N-CHANNEL MOS FET |  |  |  |  |  |  |  |  |  |  |  |  |  |  |  | 21
1 | GREEN_TOP | LTST-C190KRKT | LED-0603 | D2 | LED RED CLEAR CHIP SMD |  | PCBLayout.com |  |  | 160-1436-1-ND |  | Lite-On Inc. |  |  | LTST-C190KRKT |  |  |  | 0603
6 | MOUNT-PAD-ROUND3.3 | MOUNT-PAD-ROUND3.3 | 3,3-PAD | H1, H2, H3, H4, H5, H6 | MOUNTING PAD, round |  |  |  |  |  |  |  |  |  |  |  |  |  |  |  | 1
1 | RED_TOP | LTST-C190KRKT | LED-0603 | D1 | LED RED CLEAR CHIP SMD |  | PCBLayout.com |  |  | 160-1436-1-ND |  | Lite-On Inc. |  |  | LTST-C190KRKT |  |  |  | 0603
1 | SM02B-SRSS-TB(LF)(SN) | SM02B-SRSS-TB(LF)(SN) | SM02B-SRSS-TB(LF)(SN) | J1 | JST (JAPAN SOLDERLESS TERMINALS) - SM02B-SRSS-TB (LF)(SN) - HEADER, R/A, 2WAY | Unavailable |  |  | Connector Header Surface Mount, Right Angle 2 position 0.039 _1.00mm_ |  |  |  | JST Sales | SM02B-SRSS-TB_LF__SN_ |  |  |  |  | None |  |  | None
1 | 1N5819HW-7-F | CGRM4001-G | SOD-123_MINI-SMA | D4 | Molded plasitc,JEDEC SOD-123/Mini SMA |  |  |  |  |  |  |  |  |  |  |  |  |  |  |  |  |  |  |  |  | 0
1 | 27R | R-EU_R0603 | R0603 | R25 | RESISTOR, European symbol |  |  |  |  |  |  |  |  |  |  |  |  |  |  |  |  |  |  |  |  | 70 | R

Sheet: BOM_Printed_Box
 | Označení | Popis | Počet ks | Cena za ks | Cena celkově | Poznámka
1 | 3D Print 3 pieces | Tisk 3 dílů z PLA nebo PETG, cena za 1 kg PLA = 400 kč, 1 kg PETG = 600 kč | 0.361 | 400 | 144.4 | spotřeba cca 361 g PLA nebo PETG, celkový tiskový čas cca 36 hodin
2 | insert M3 | Kovový vložka M3 x 5 mm | 18 | 2 | 36 | závity do tiskových dílů |  | https://www.ebay.co.uk/itm/202624930453 | pouze příklad, existují různé varianty --> bude nutné vyzkoušet a případně upravit rozměr otvorů
3 | M3x25 | Šroub M3 x 25 mm, HEX or TORX head | 4 | 1 | 4 | připevnění Top Cover k Main Body
4 | M3x14 | Šroub M3 x 14 mm, HEX or TORX head | 4 | 1 | 4 | připevnění Front Cover k Main Body
5 | M3x8 | Šroub M3 x 8 mm | 10 | 1 | 10 | připevnění Main board a Extension board
6 | M3x5 | Šroub M3 x 5 mm, HEX or TORX head | 2 | 1 | 2 | připevnění Meanwell PSU k Main Body
7 | M3x8 ??? | Šroub M3 x ??? | 2 | 1 | 2 | připevnění zásuvky k Main body | nutno vyzkoušet až přijdou komponenty
8 | M3 matka ?? | matka M3 ??? | 2 | 1 | 2 | připevnění zásuvky k Main body | nutno vyzkoušet až přijdou komponenty
9 | M2,5 x ??? | Šroub M2,5 x ??? | 2 | 1 | 2 | připevnění konektoru vzadu k Main body | nutno vyzkoušet až přijdou komponenty
 |  |  |  |  | 206.4
 |  | To order
 |  | Alternative / nice to have
 |  | Do not order / backup components / extra
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
