Crinst/LPWAN-current-logger-device/eagle/v3/PCBWAY_2L_ORDER_DETAIL.PNG

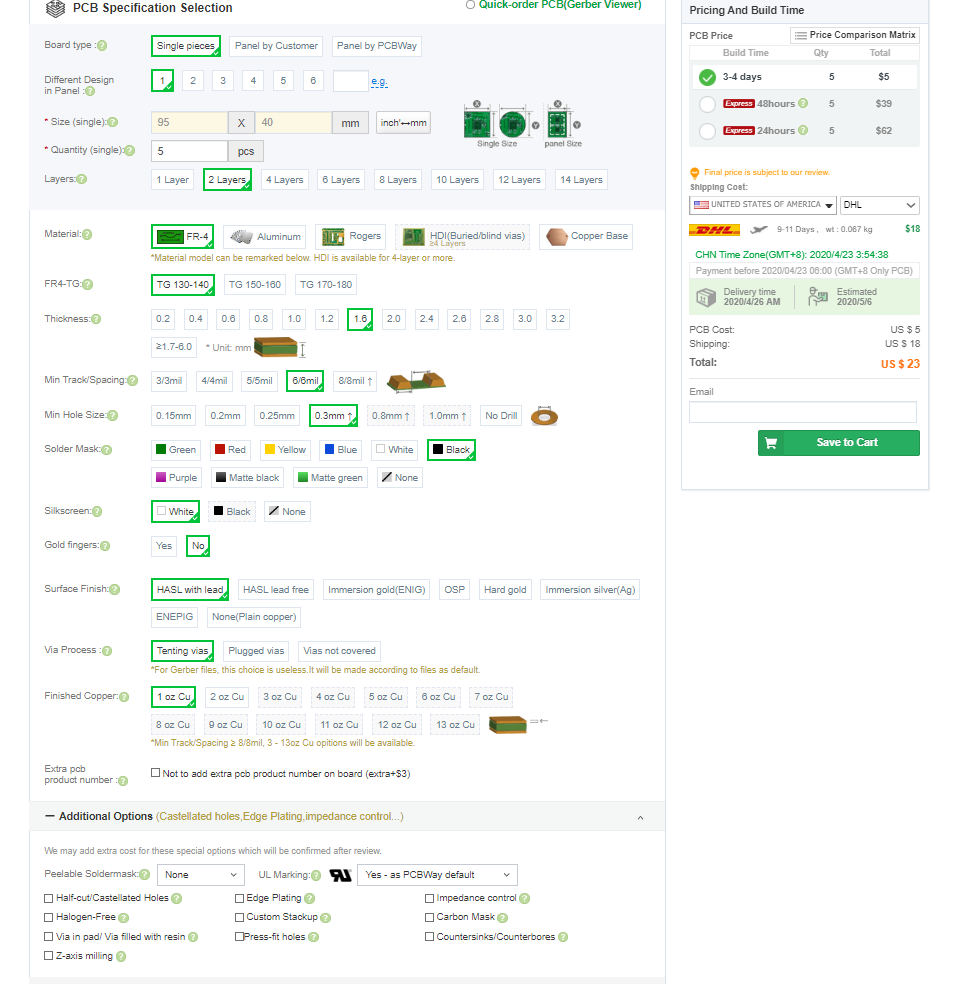
eagle/v3/PCBWAY_2L_ORDER_DETAIL.PNG
