Crinst/LPWAN-current-logger-device/enclosure/Main_Body.step

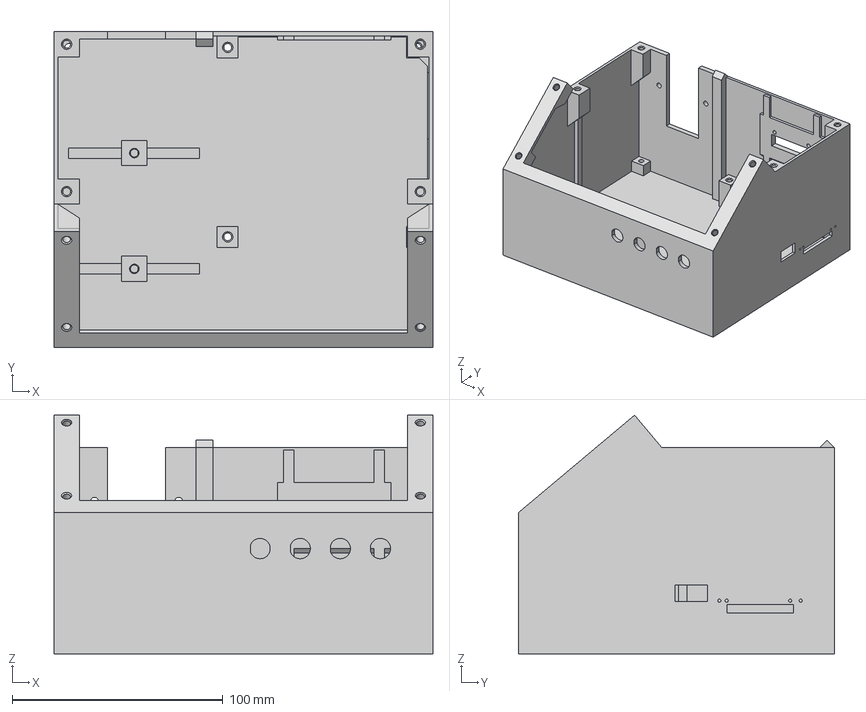
[picture p32: CAD file, 2026-08-03]
enclosure/Main_Body.step
180.0 x 150.0 x 113.4 mm
