Crinst/LPWAN-current-logger-device/enclosure/Front_Cover.step

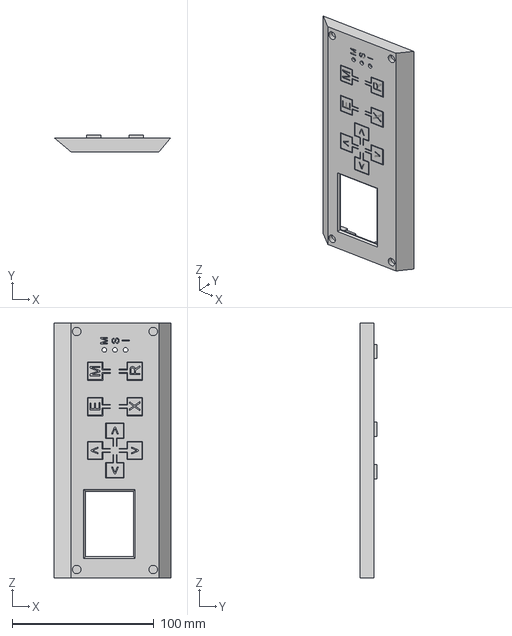
[picture p33: CAD file, 2026-08-03]
enclosure/Front_Cover.step
82.2 x 12.0 x 180.0 mm
