Crinst/LPWAN-current-logger-device/enclosure/LCD_spring_holder.step

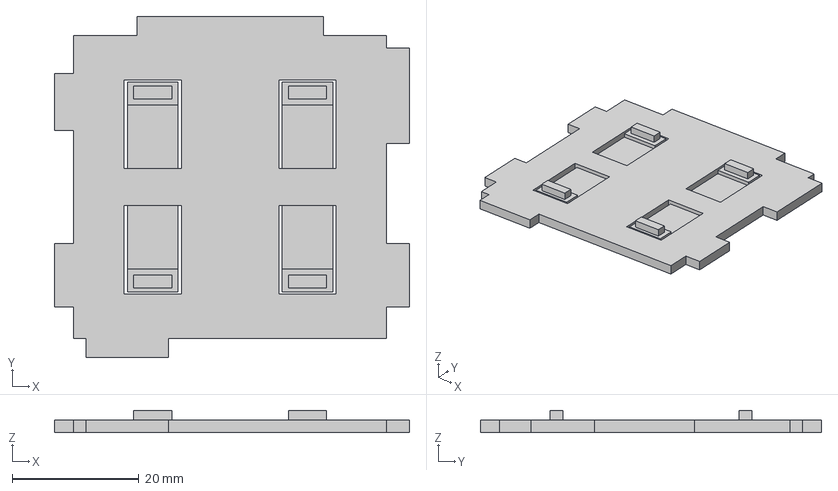
[picture p34: CAD file, 2026-08-03]
enclosure/LCD_spring_holder.step
56.0 x 53.8 x 3.50 mm
