Crinst/LPWAN-current-logger-device/enclosure/Top_Cover.step

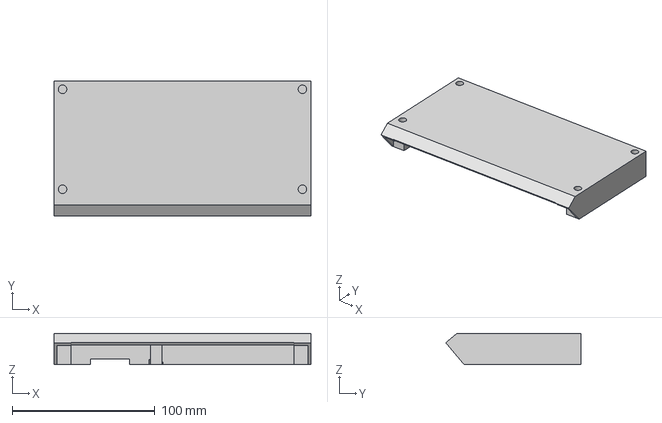
[picture p35: CAD file, 2026-08-03]
enclosure/Top_Cover.step
180.0 x 94.9 x 22.0 mm
