Crinst/LPWAN-current-logger-device/enclosure/OLED+KEYS_HOLDER v2.stl

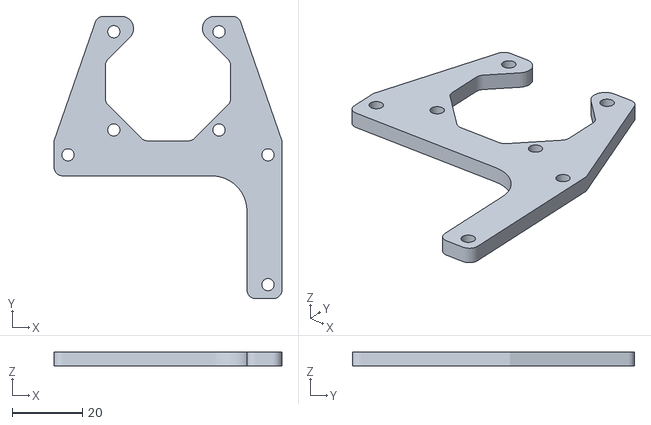
[picture p36: CAD file, 2026-08-03]
enclosure/OLED+KEYS_HOLDER v2.stl
65.0 x 80.5 x 4.00
