Crinst/LPWAN-current-logger-device/(list of files, cad)

Other CAD files:
enclosure/Front_Cover.f3d
enclosure/Front_Cover.stl
enclosure/LCD_spring_holder.f3d
enclosure/LCD_spring_holder.stl
enclosure/Main_Body.f3d
enclosure/Main_Body.stl
enclosure/Top_Cover.f3d
enclosure/Top_Cover.stl
