Crinst/LPWAN-current-logger-device/docs/board_pictures/DP_current_measure_V3_extension_view_bottom.png

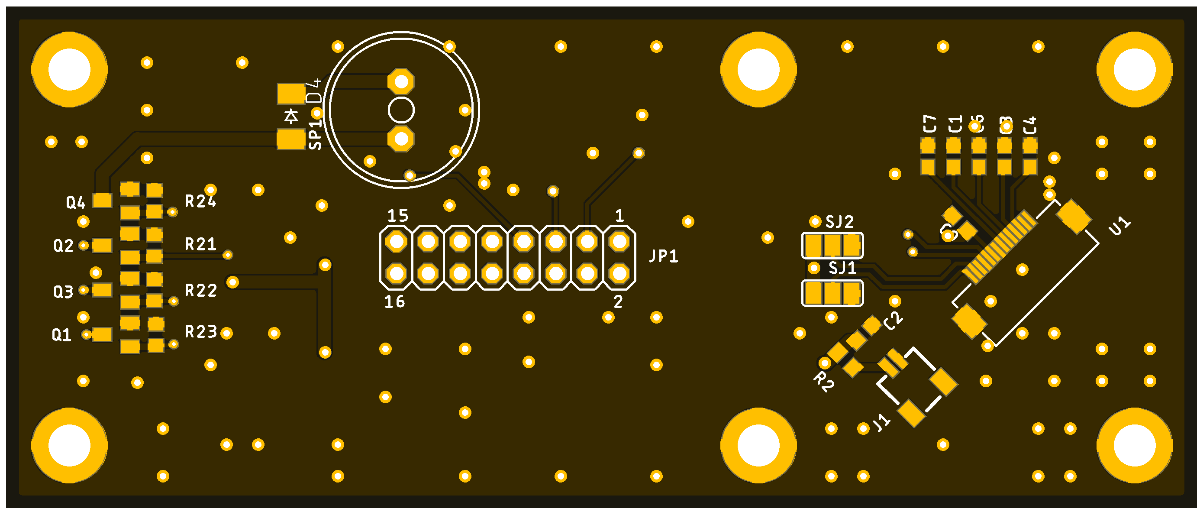
docs/board_pictures/DP_current_measure_V3_extension_view_bottom.png
