Crinst/LPWAN-current-logger-device/docs/board_pictures/DP_current_measure_V3_extension_view_top.png

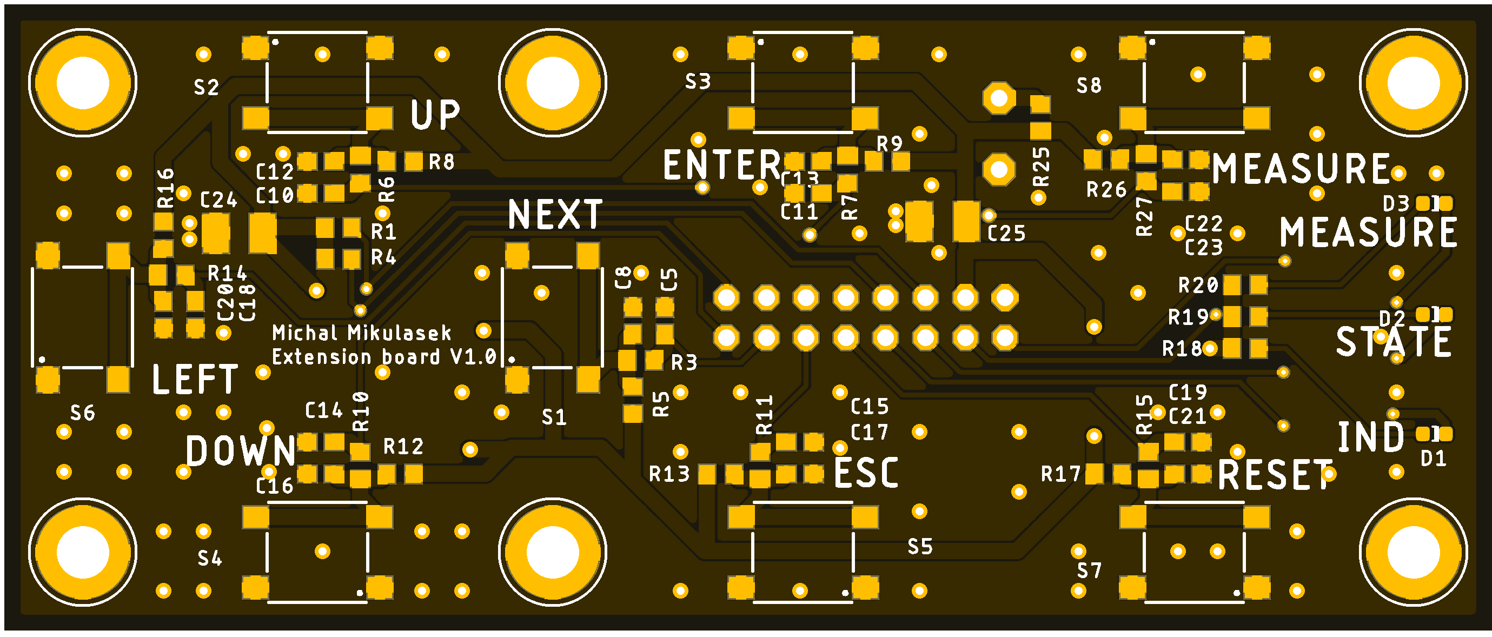
docs/board_pictures/DP_current_measure_V3_extension_view_top.png
