Crinst/LPWAN-current-logger-device/docs/board_pictures/DP_current_measure_v3_view_bottom.png

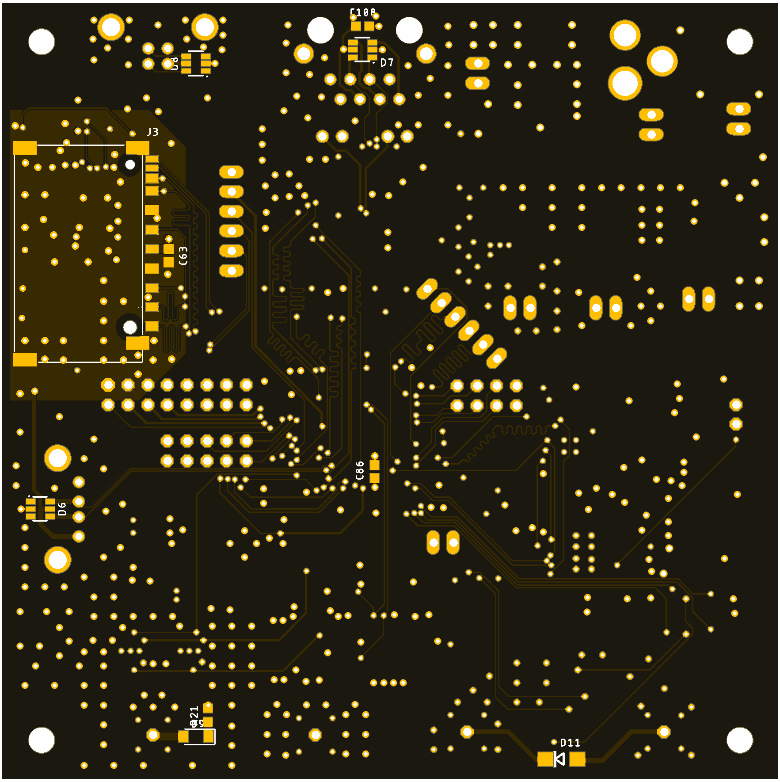
docs/board_pictures/DP_current_measure_v3_view_bottom.png
