Crinst/LPWAN-current-logger-device/docs/DP_V3_DP.pdf

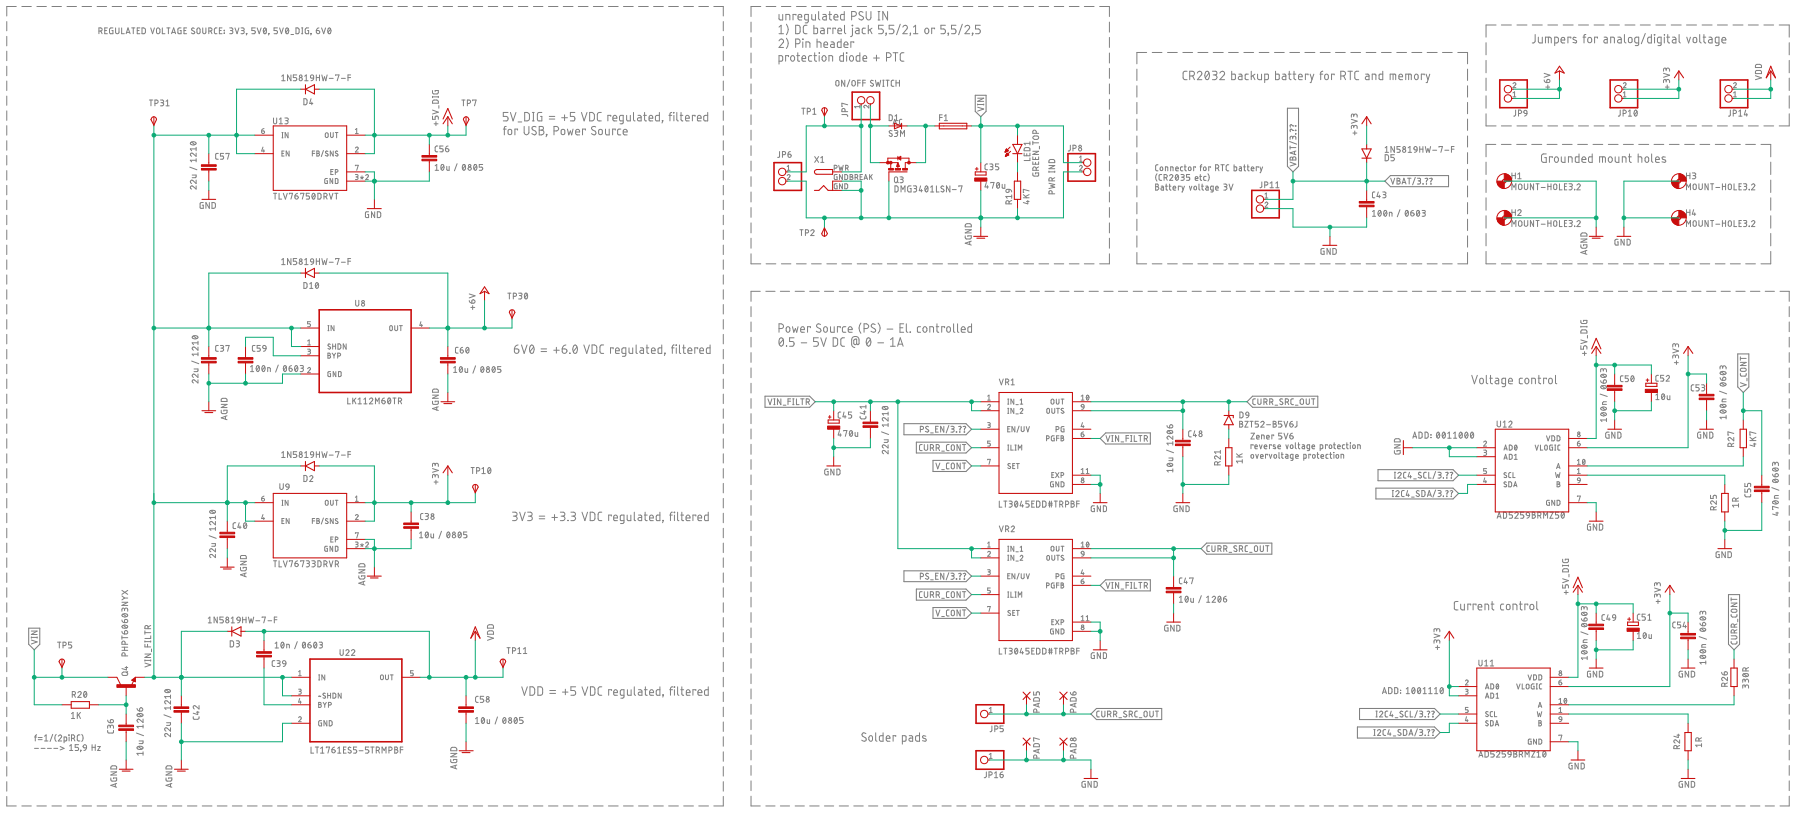
[picture p41: page 1]
