Crinst/LPWAN-current-logger-device/docs/DP_V3_DP_2.pdf

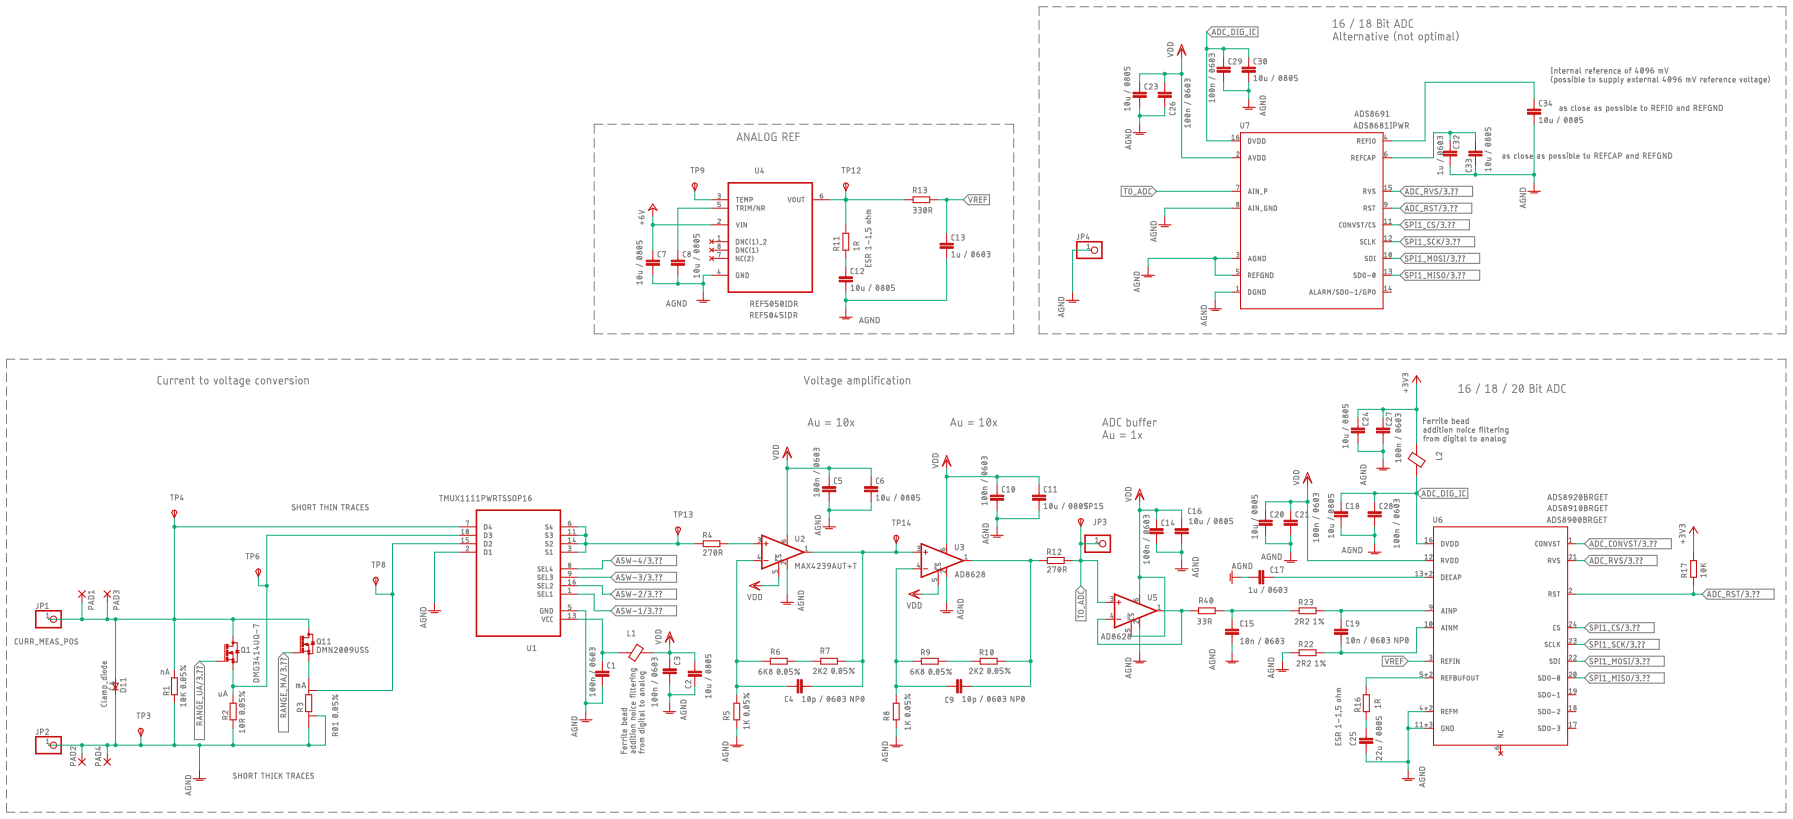
[picture p42: page 1]
