Crinst/LPWAN-current-logger-device/docs/board_pictures/DP_EXT_V1_Assy_bottom.pdf

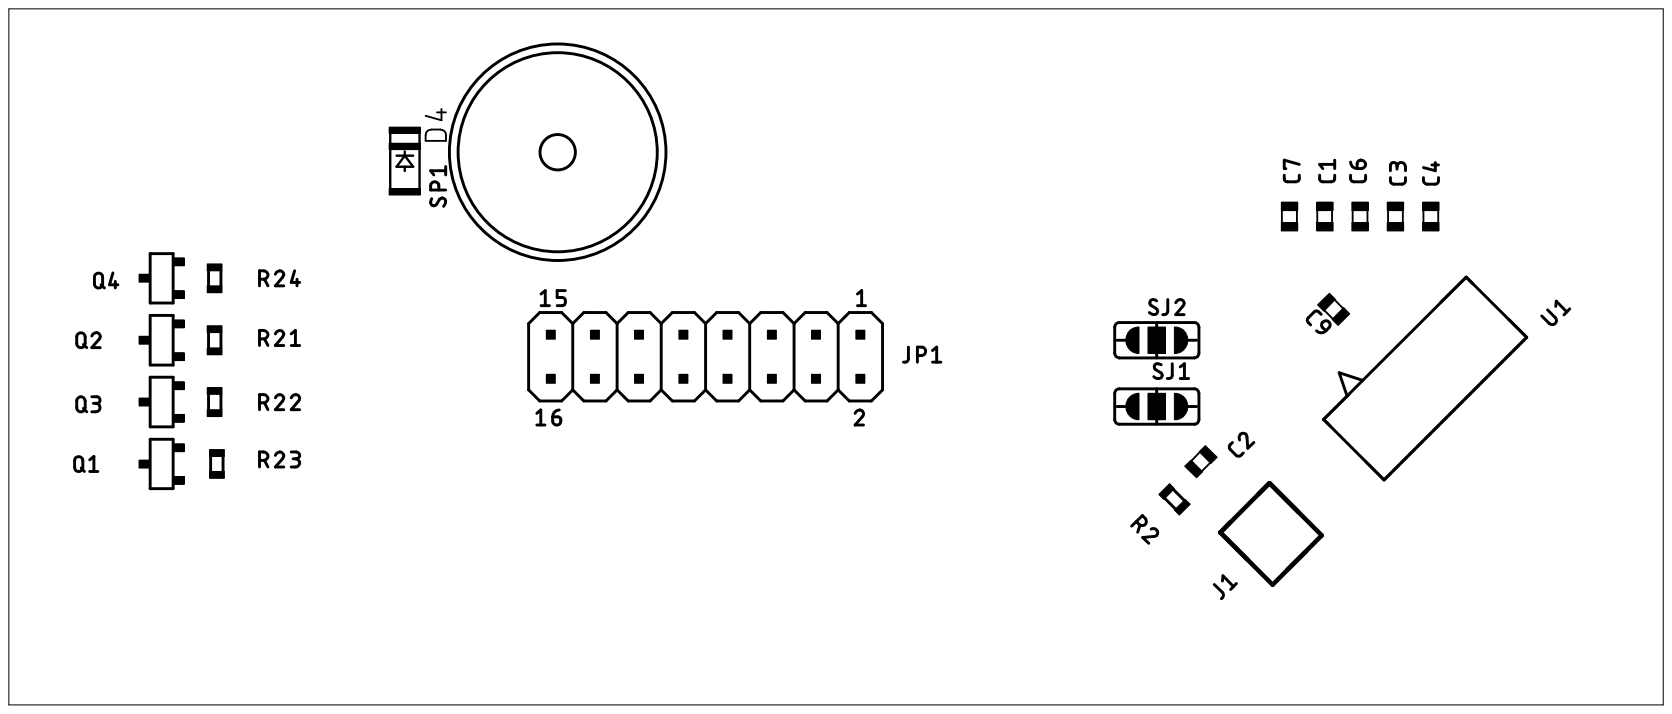
[picture p43: page 1]
