Crinst/LPWAN-current-logger-device/docs/board_pictures/DP_EXT_V1_Assy_bottom_edit.pdf

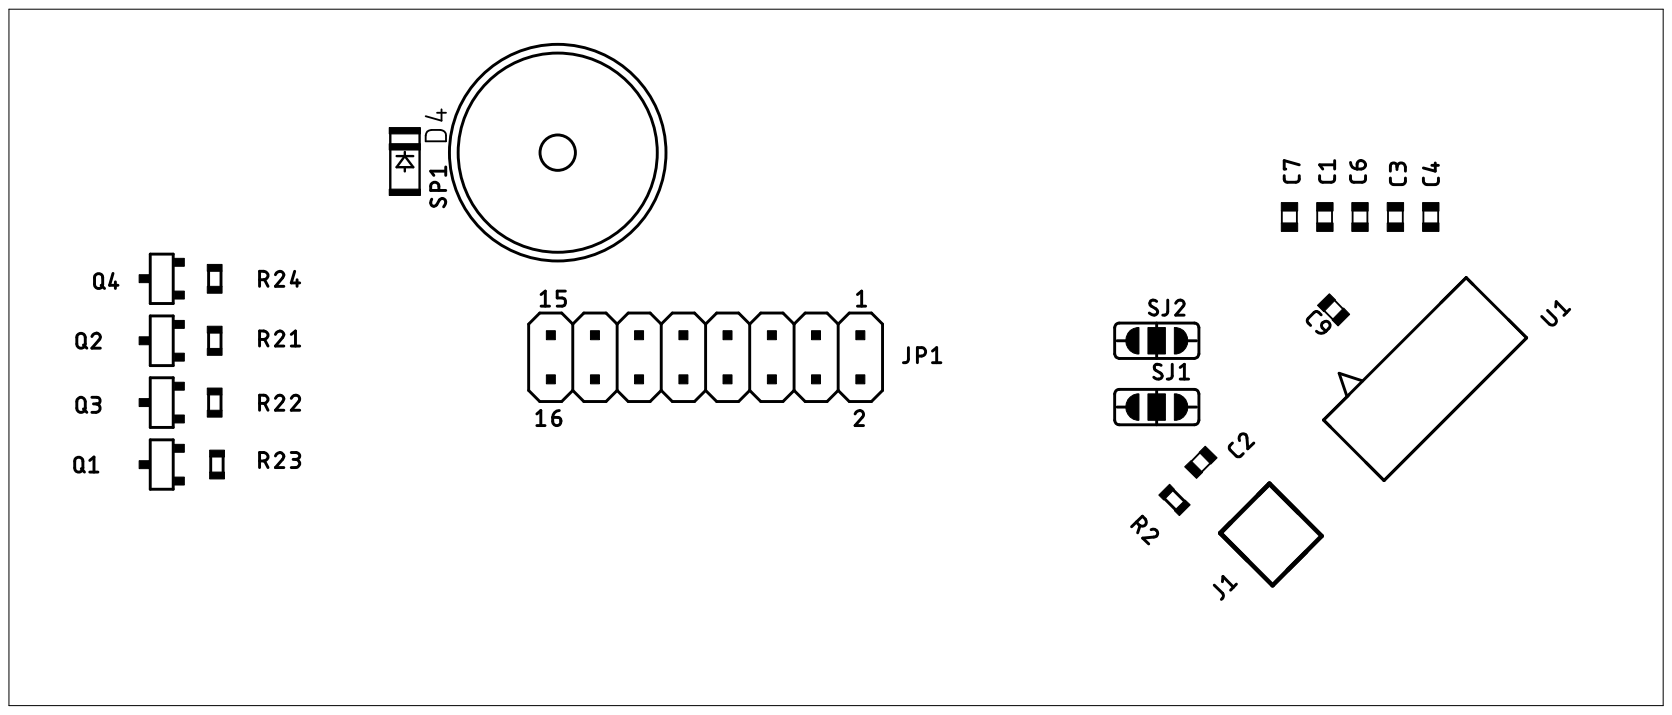
[picture p44: page 1]
