Crinst/LPWAN-current-logger-device/docs/board_pictures/DP_EXT_V1_Assy_top.pdf

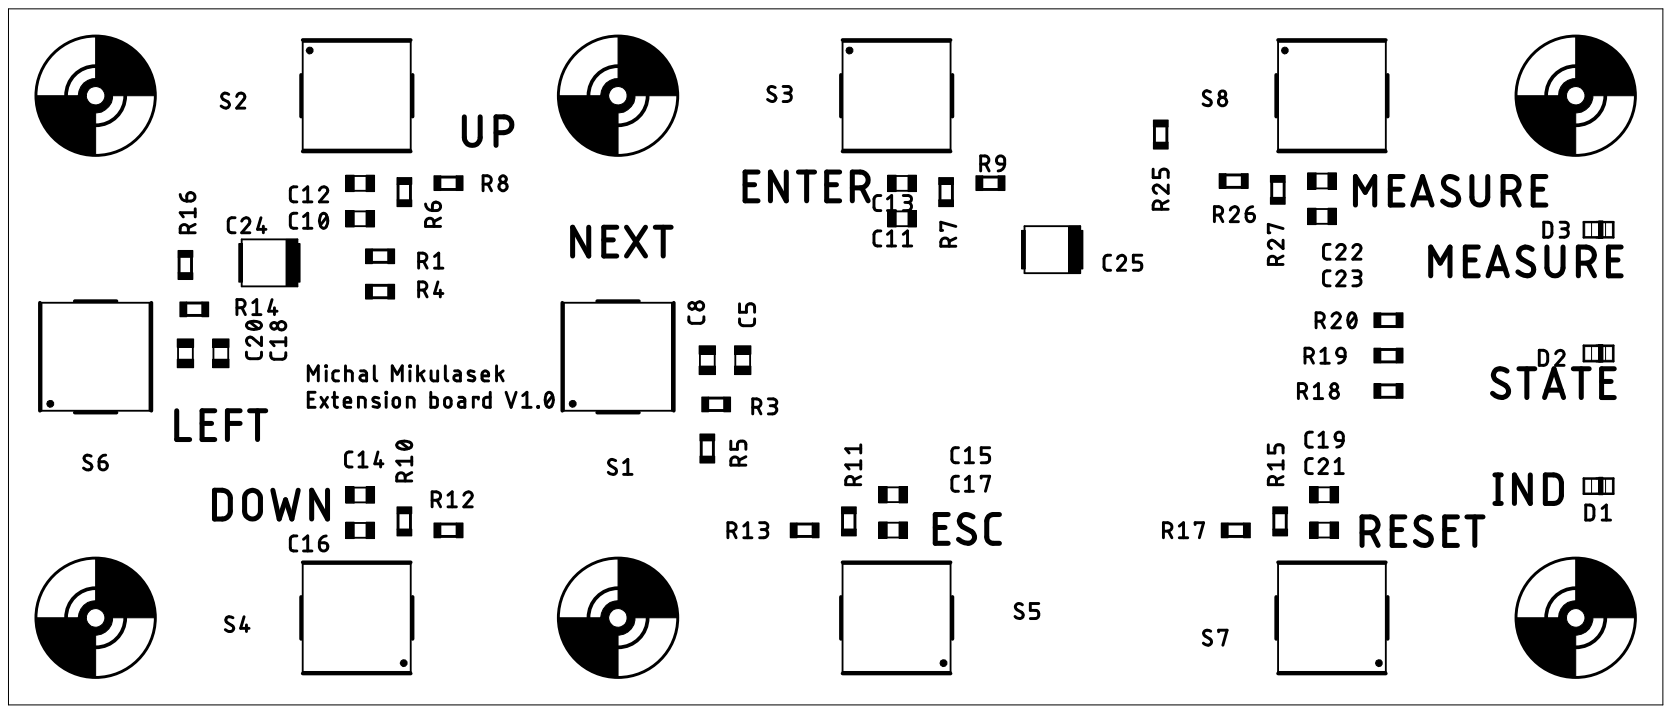
[picture p45: page 1]
