Crinst/LPWAN-current-logger-device/docs/board_pictures/DP_EXT_V1_Assy_top_edit.pdf

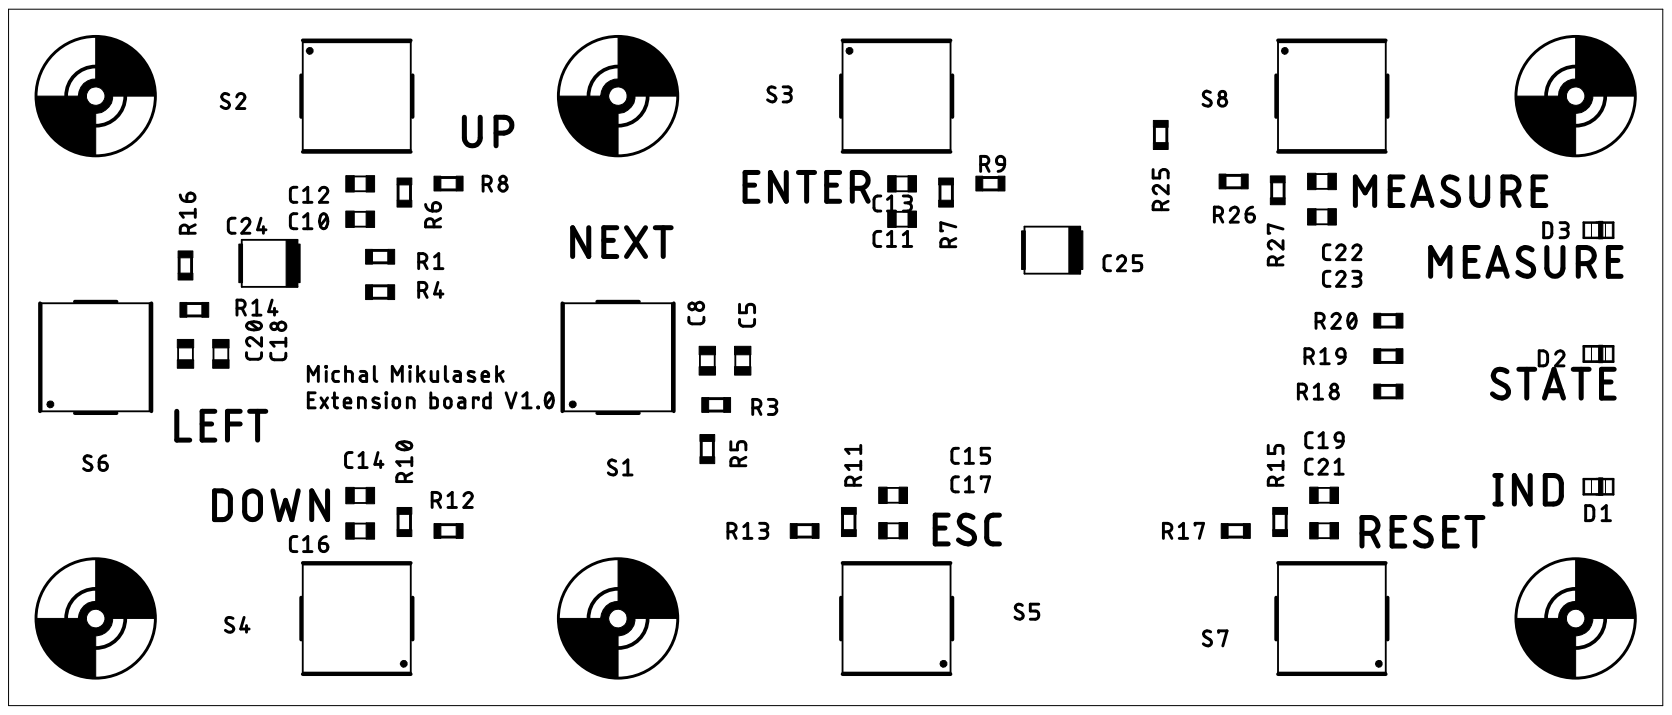
[picture p46: page 1]
