Crinst/LPWAN-current-logger-device/docs/board_pictures/DP_EXT_V1_Copper_L1_top.pdf

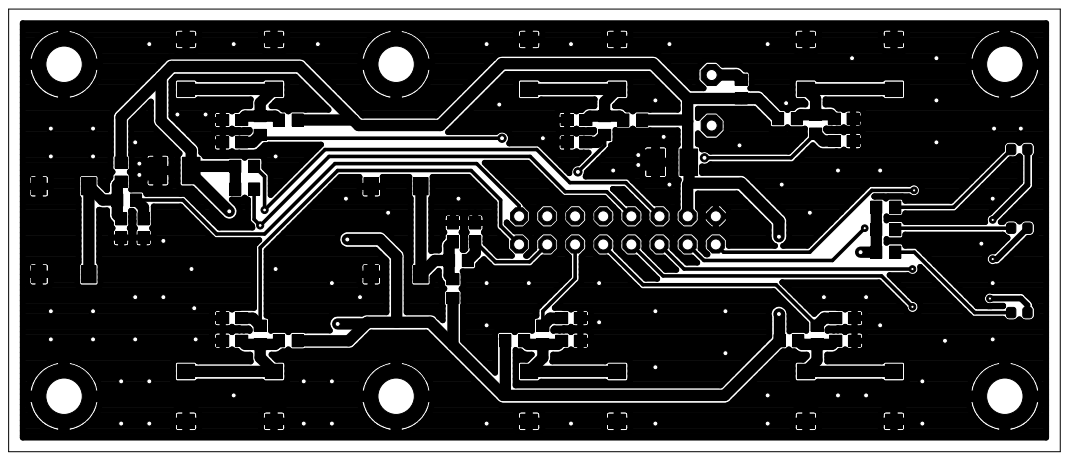
[picture p47: page 1]
