Crinst/LPWAN-current-logger-device/docs/board_pictures/DP_EXT_V1_Copper_L1_top_edit.pdf

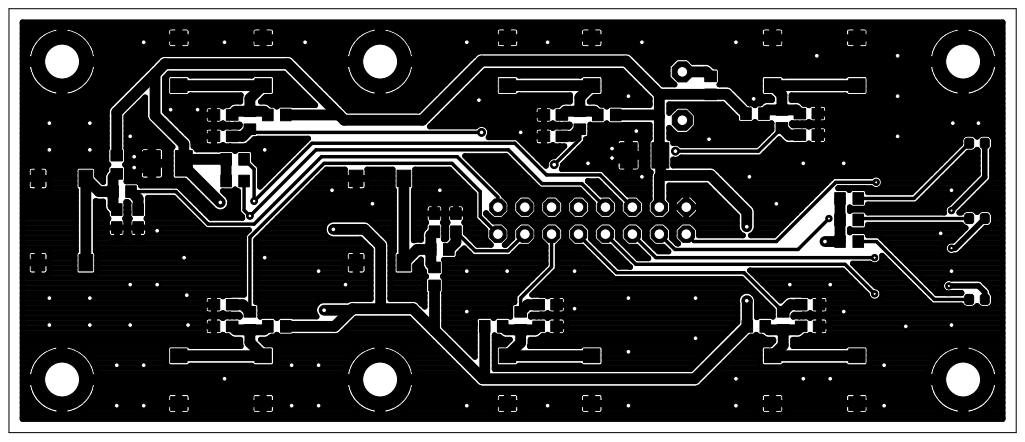
[picture p48: page 1]
