Crinst/LPWAN-current-logger-device/docs/board_pictures/DP_EXT_V1_Copper_L2_bottom.pdf

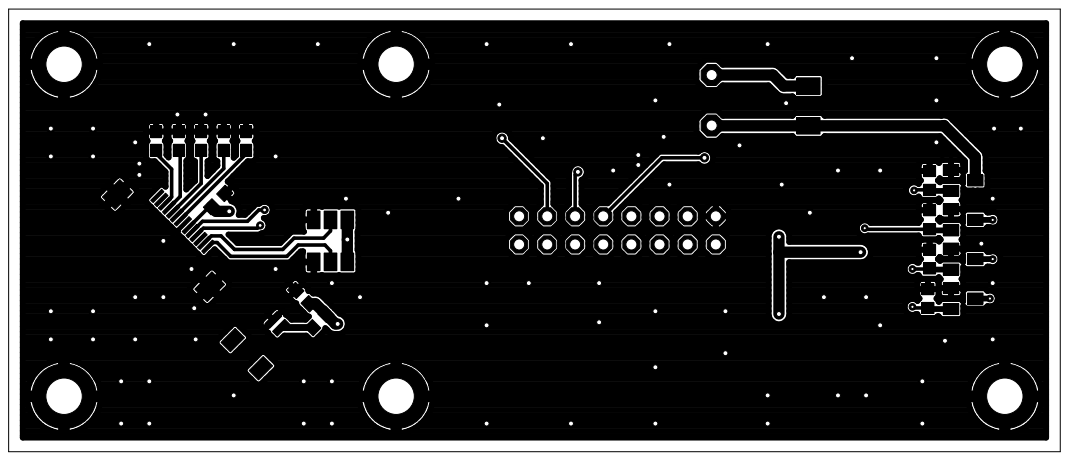
[picture p49: page 1]
