Crinst/LPWAN-current-logger-device/docs/board_pictures/DP_EXT_V1_Copper_L2_bottom_edit.pdf

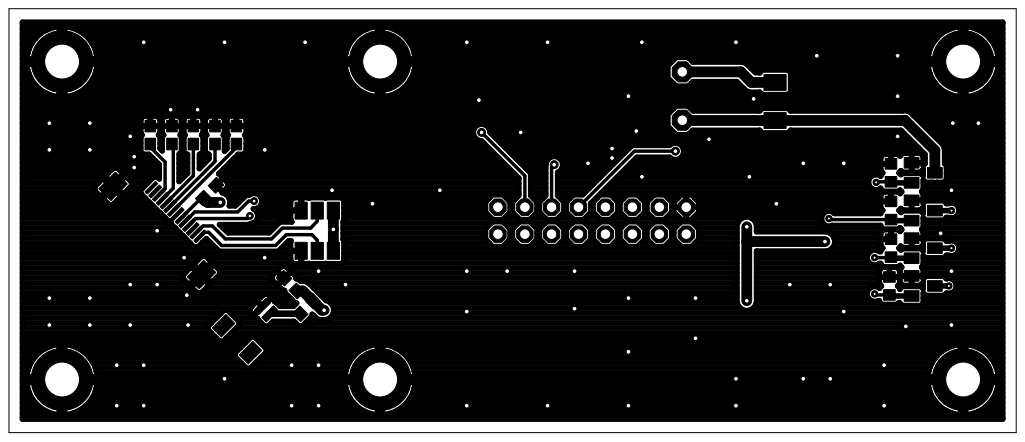
[picture p50: page 1]
