Crinst/LPWAN-current-logger-device/docs/board_pictures/DP_EXT_V1_Sheet_1_black.pdf

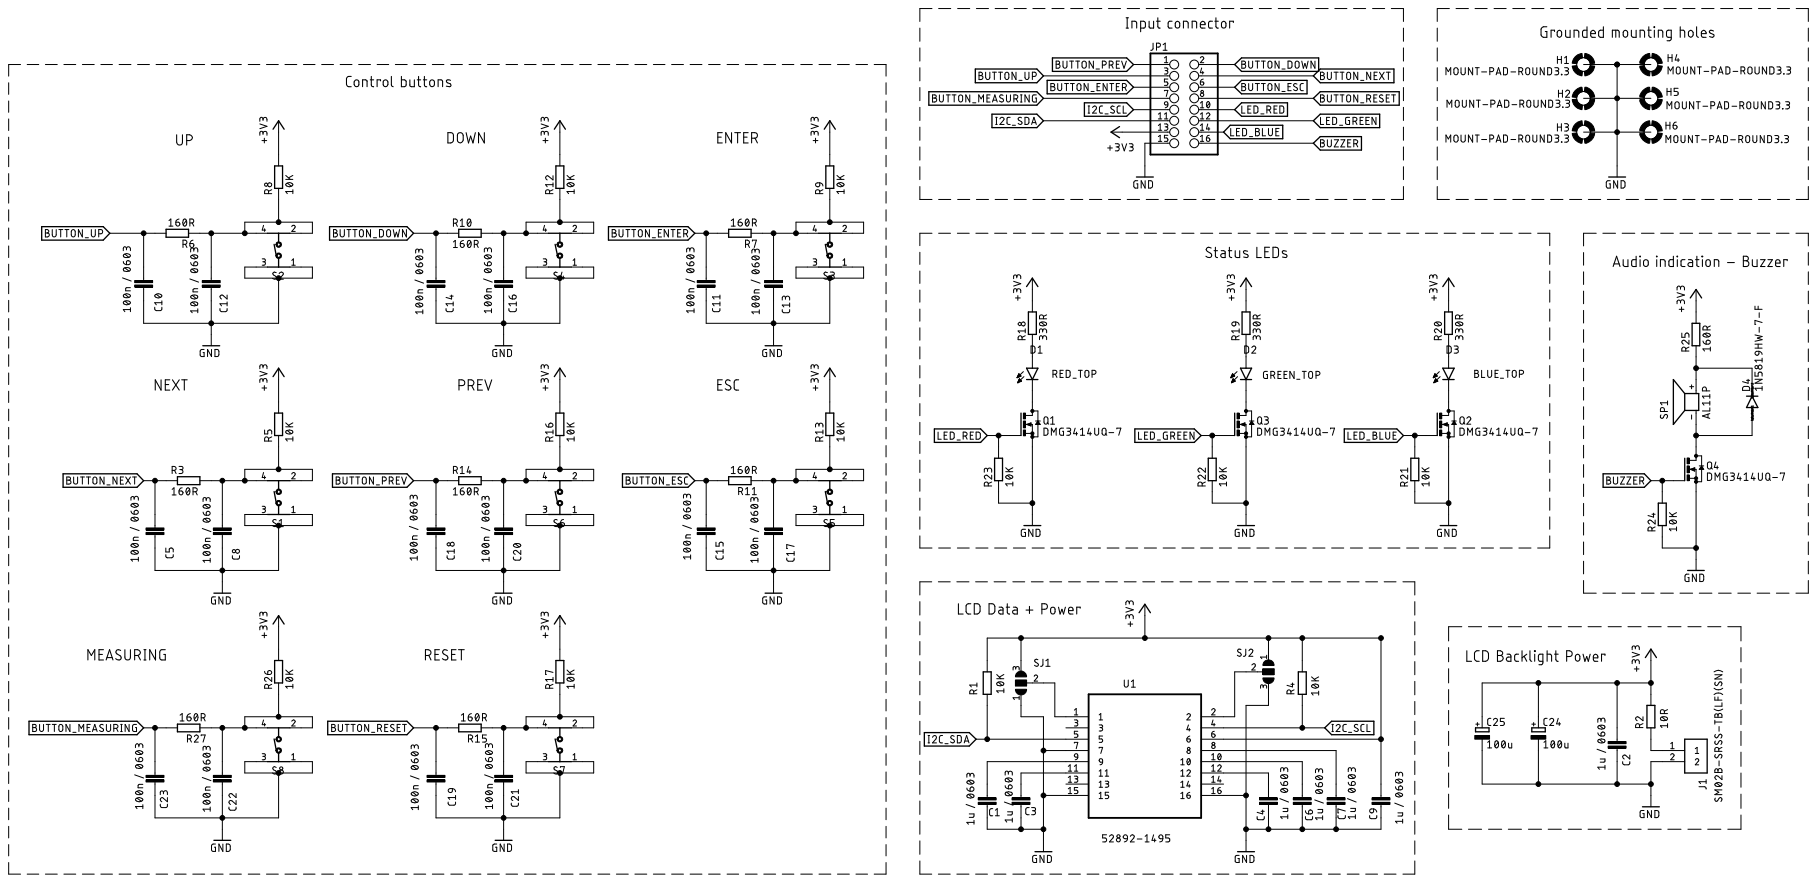
[picture p51: page 1]
