Crinst/LPWAN-current-logger-device/docs/board_pictures/DP_EXT_V1_Sheet_1_color.pdf

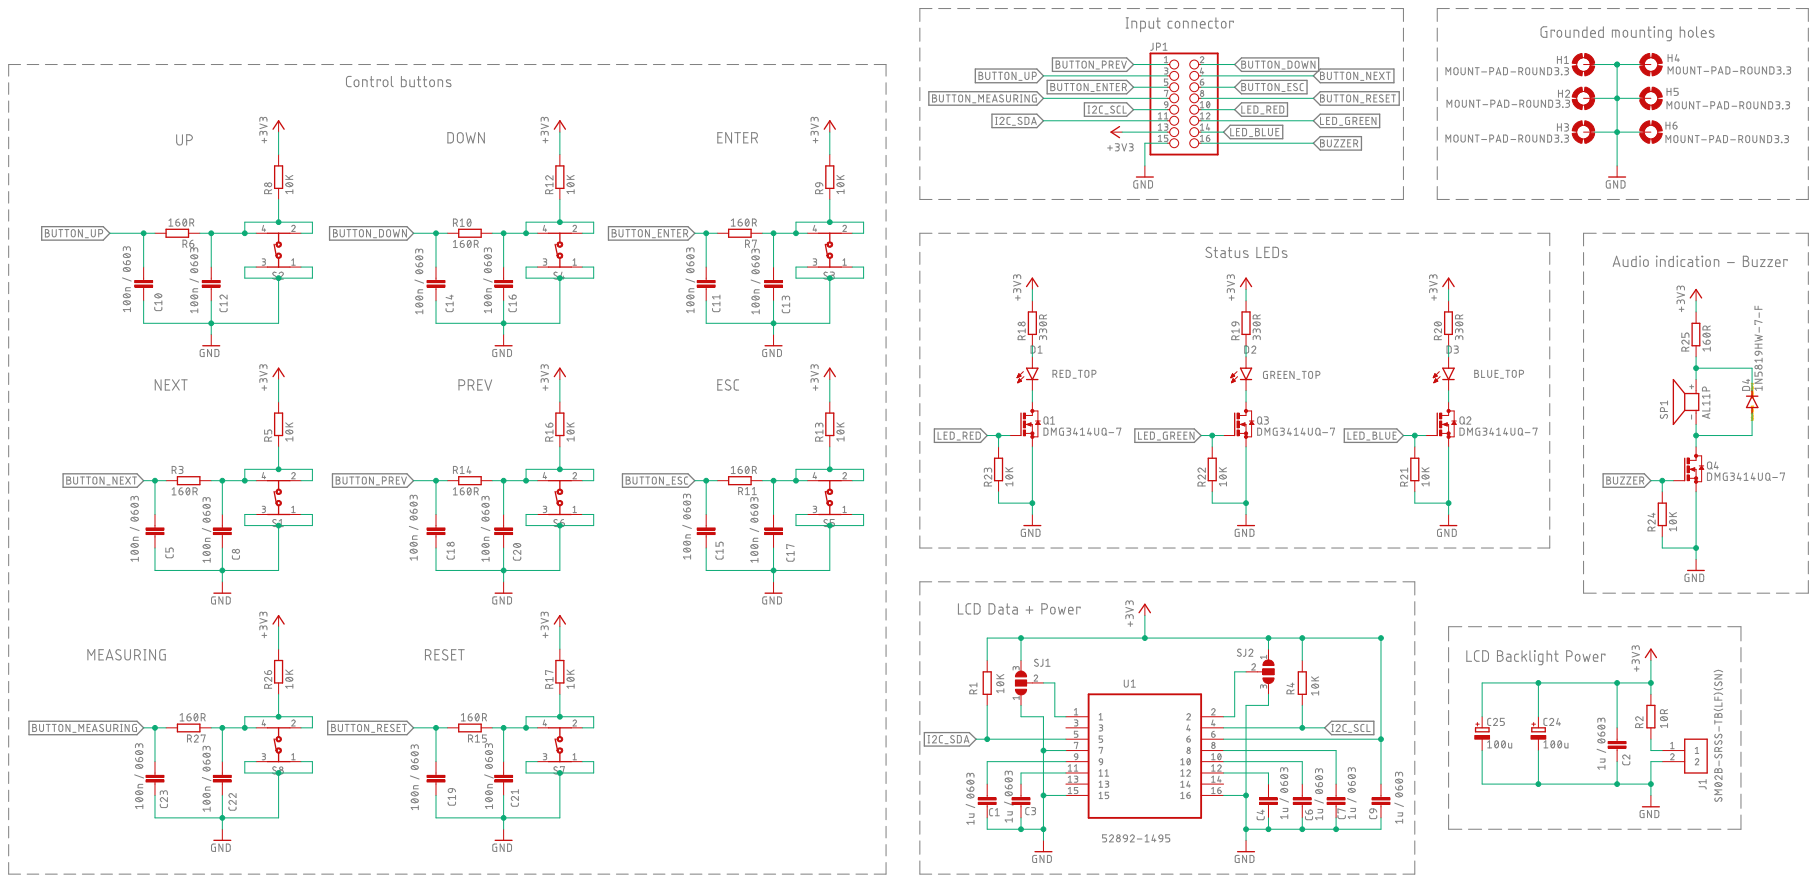
[picture p52: page 1]
