Crinst/LPWAN-current-logger-device/docs/board_pictures/DP_EXT_V1_Sheet_1_color_edit.pdf

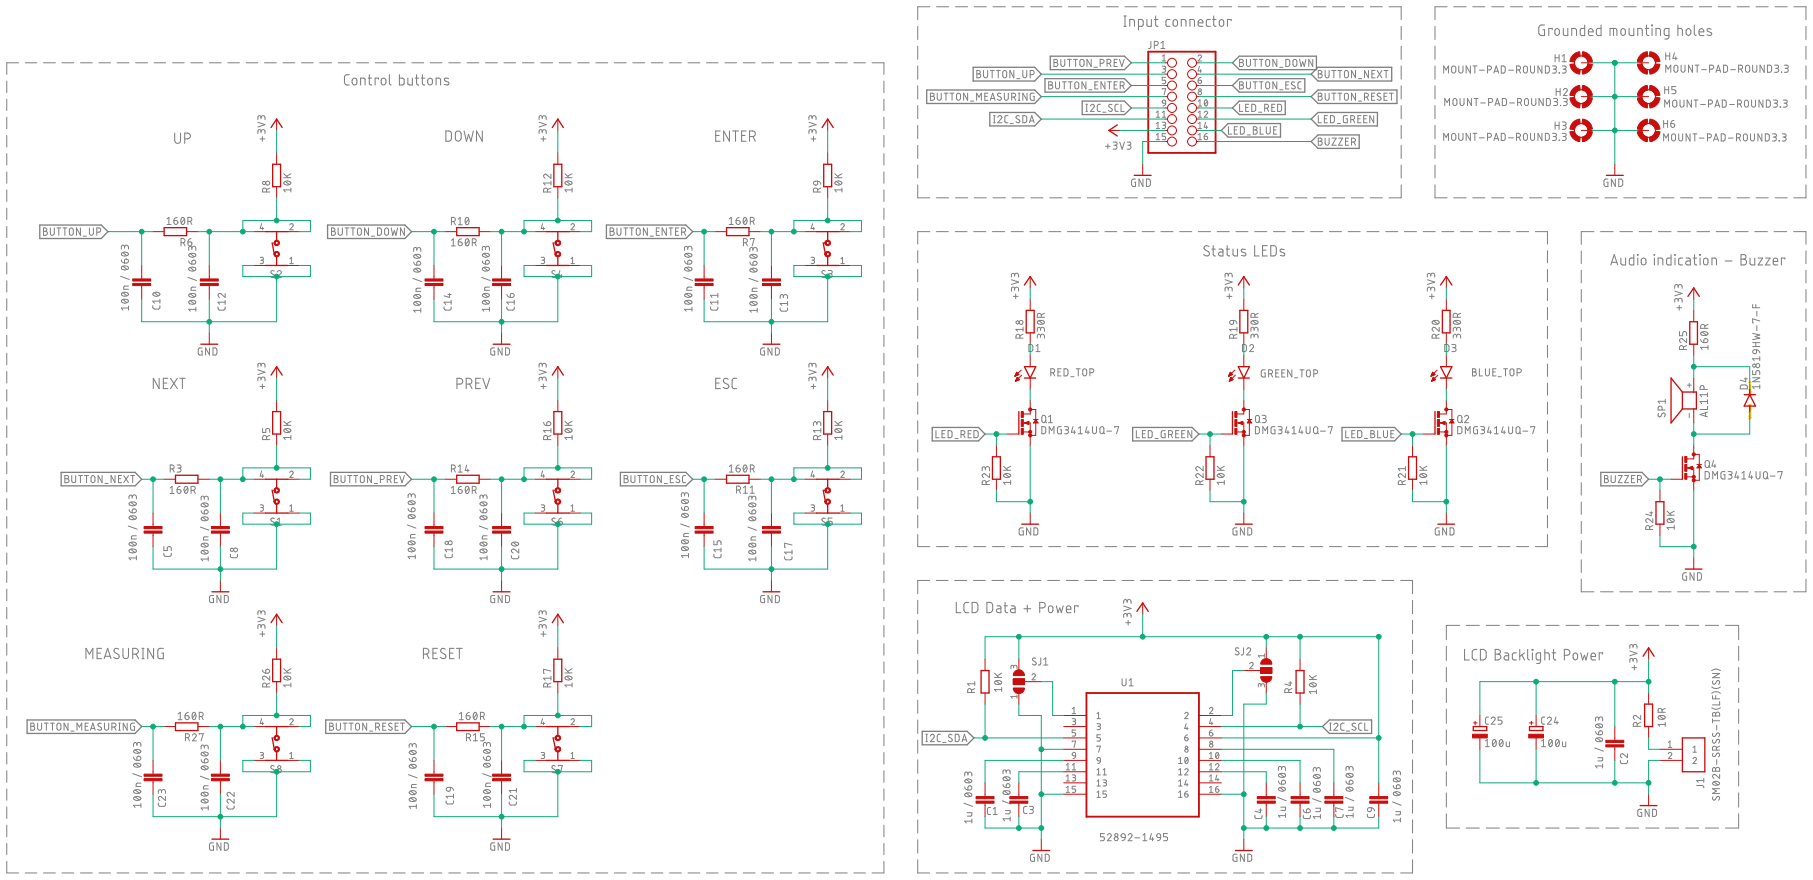
[picture p53: page 1]
