Crinst/LPWAN-current-logger-device/docs/board_pictures/DP_V3_Assy_bottom.pdf

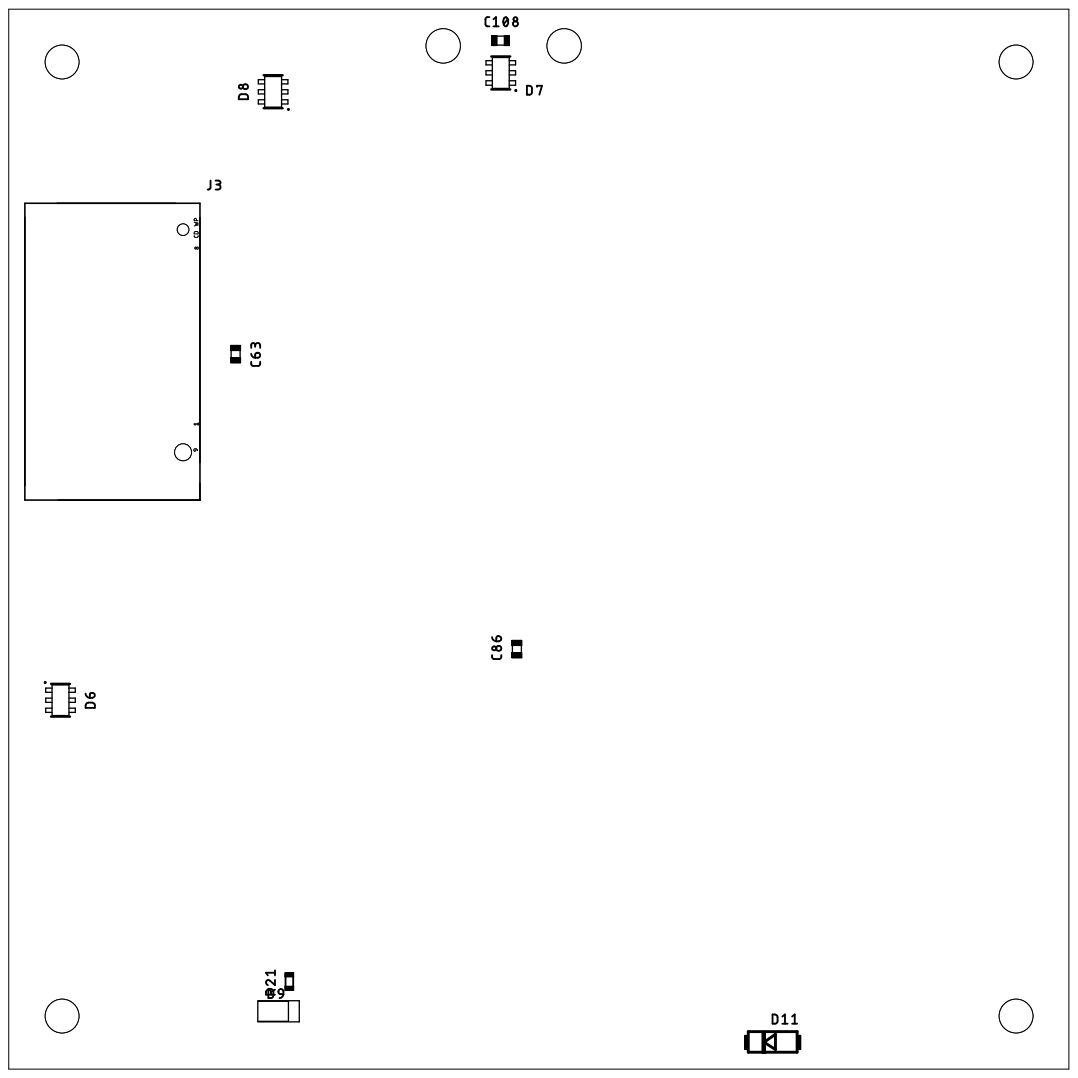
[picture p54: page 1]
