Crinst/LPWAN-current-logger-device/docs/board_pictures/DP_V3_Assy_bottom_edit.pdf

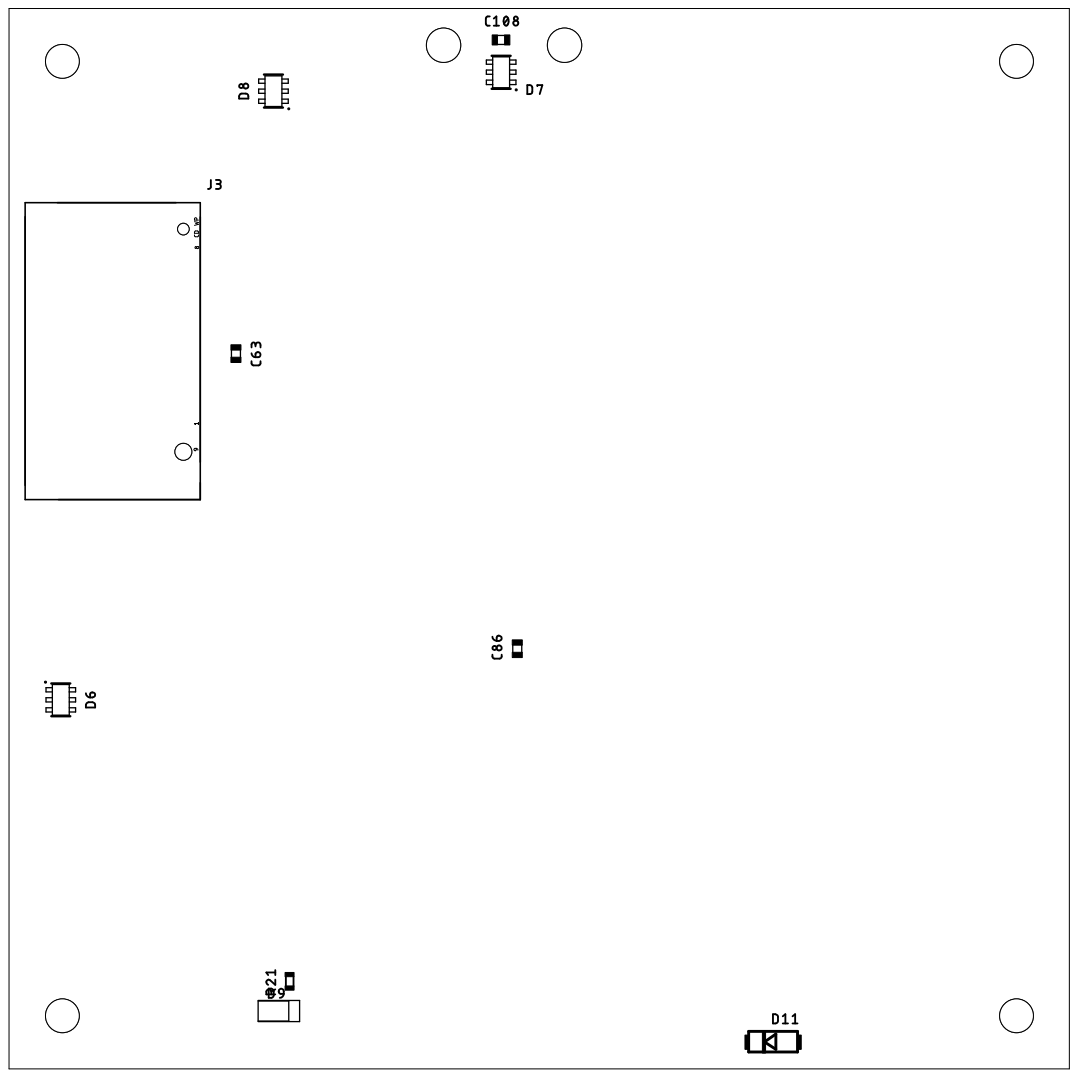
[picture p55: page 1]
