Crinst/LPWAN-current-logger-device/docs/board_pictures/DP_V3_Assy_top.pdf

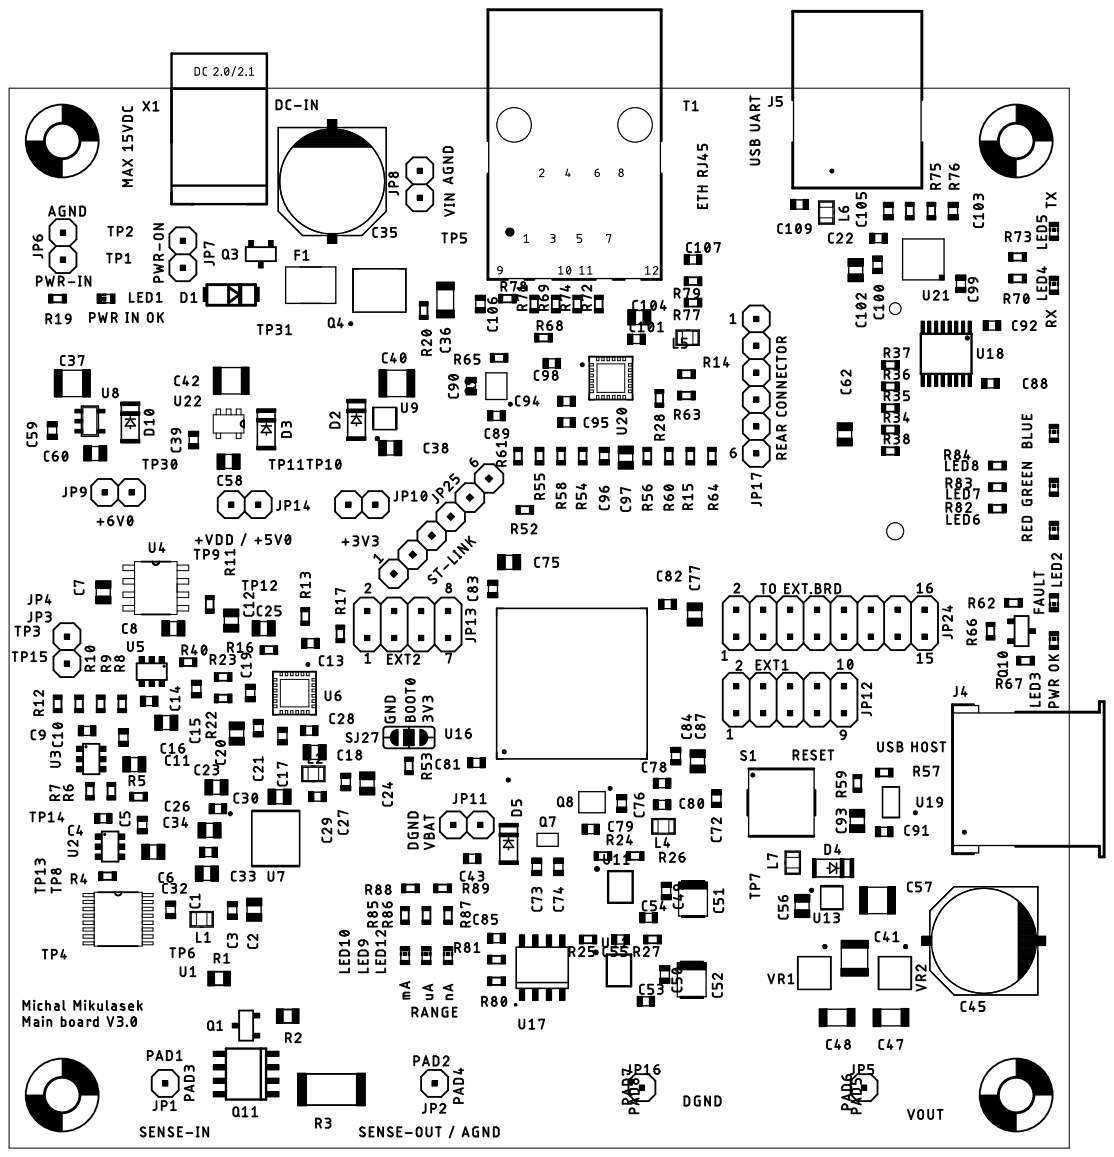
[picture p56: page 1]
