Crinst/LPWAN-current-logger-device/docs/board_pictures/DP_V3_Assy_top_edit.pdf

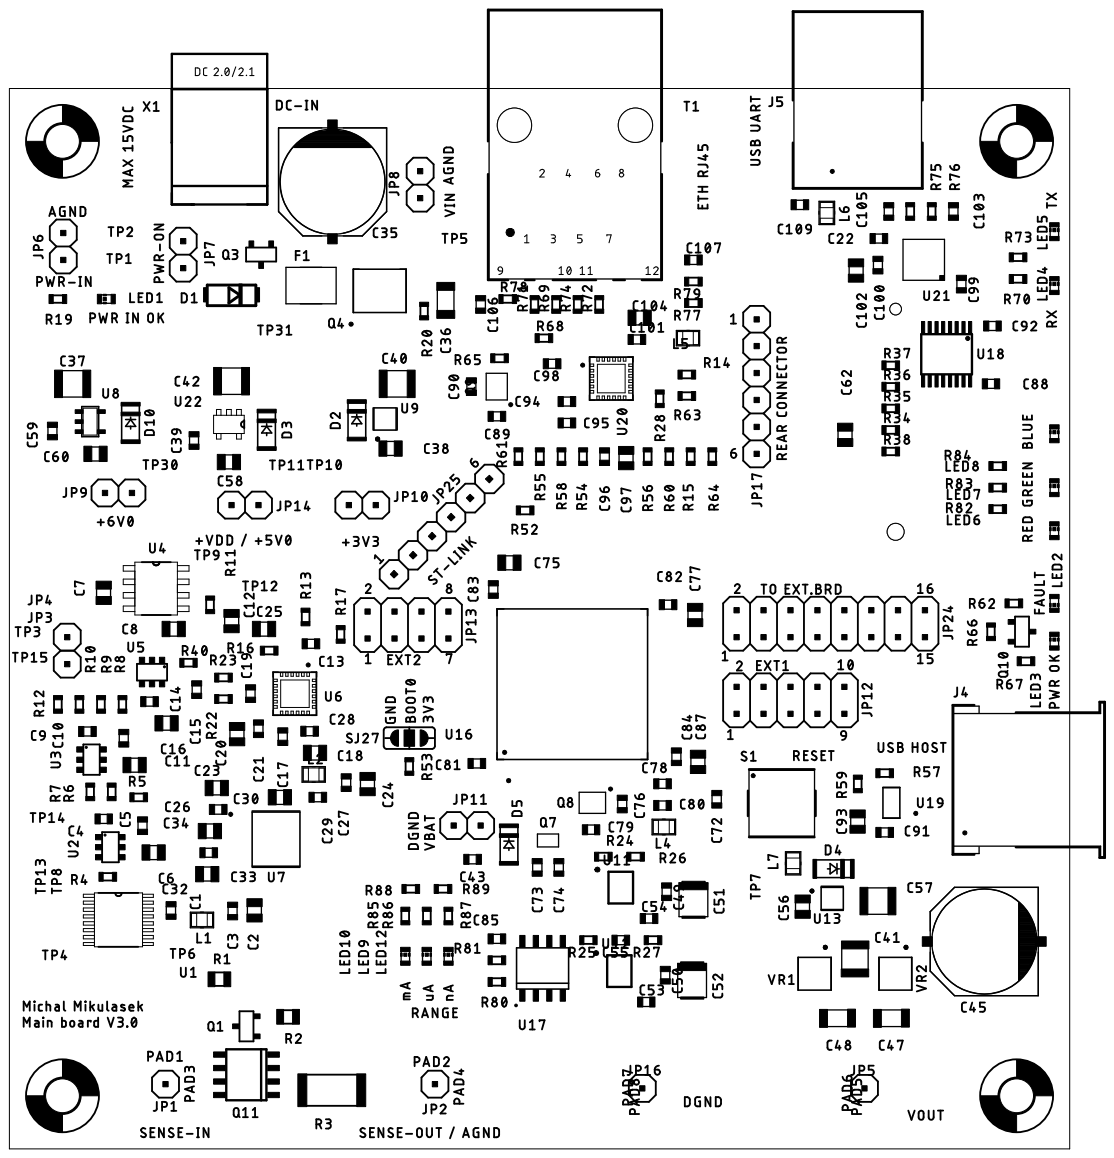
[picture p57: page 1]
