Crinst/LPWAN-current-logger-device/docs/board_pictures/DP_V3_Copper_L1_top.pdf

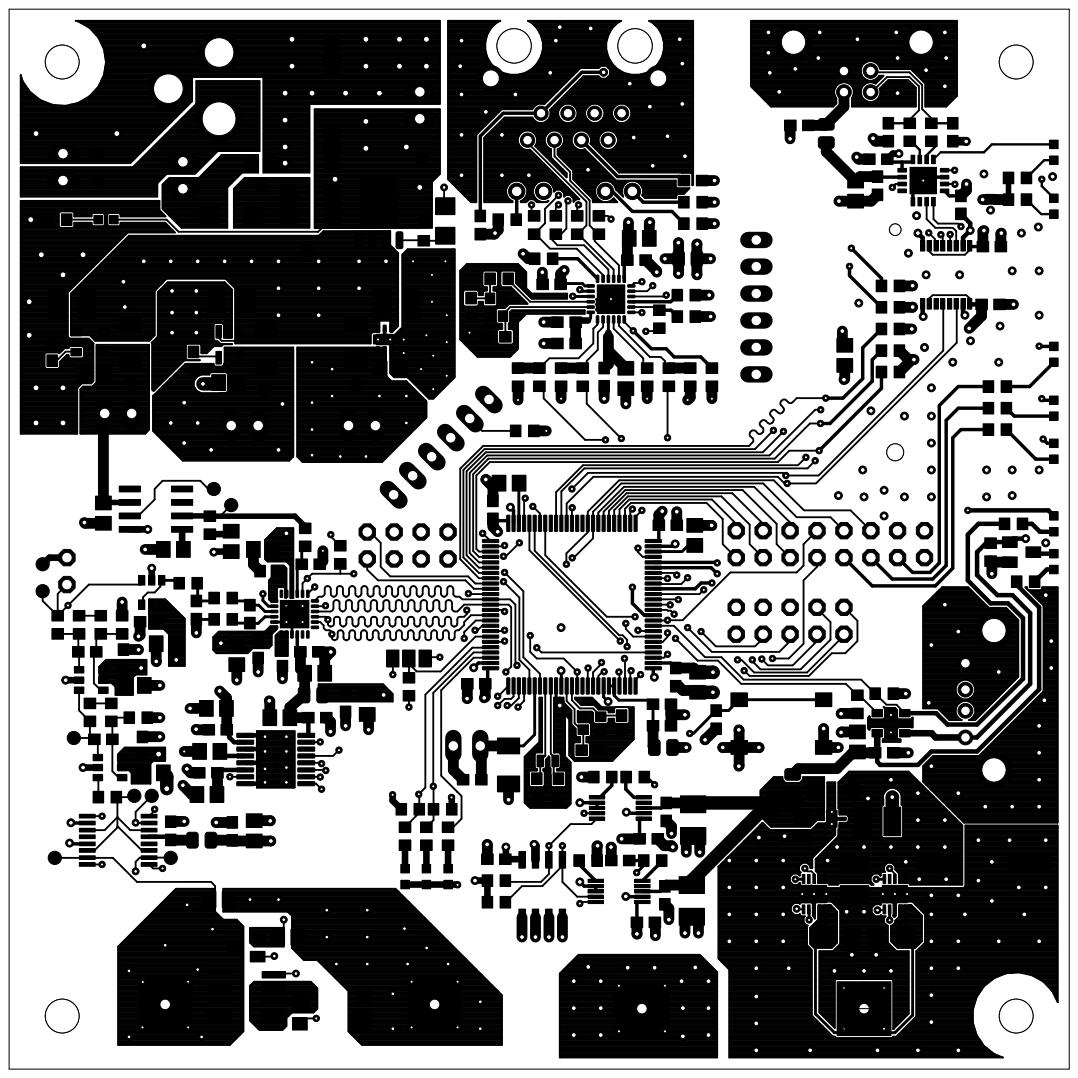
[picture p58: page 1]
