Crinst/LPWAN-current-logger-device/docs/board_pictures/DP_V3_Copper_L1_top_edit.pdf

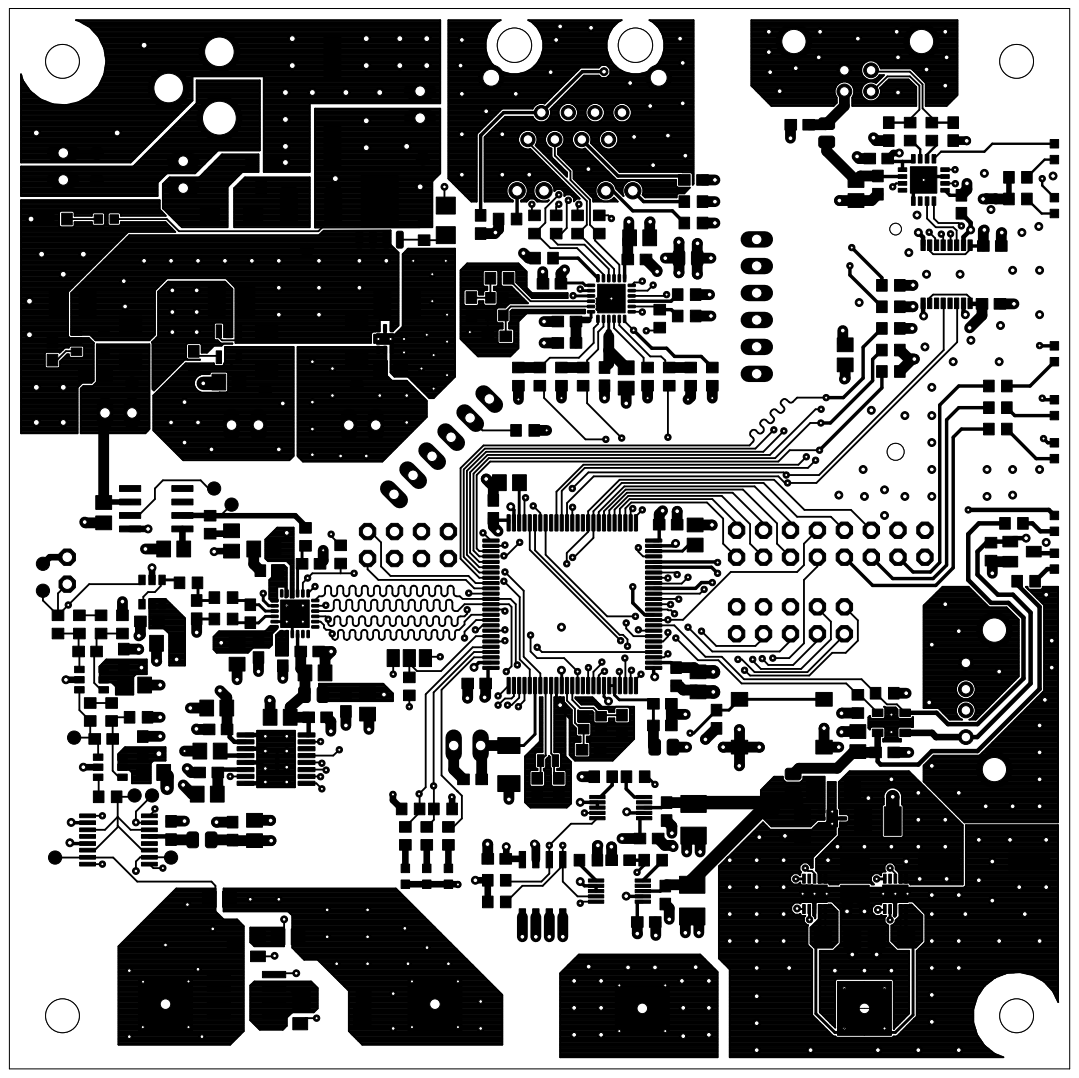
[picture p59: page 1]
