Crinst/LPWAN-current-logger-device/docs/board_pictures/DP_V3_Copper_L2.pdf

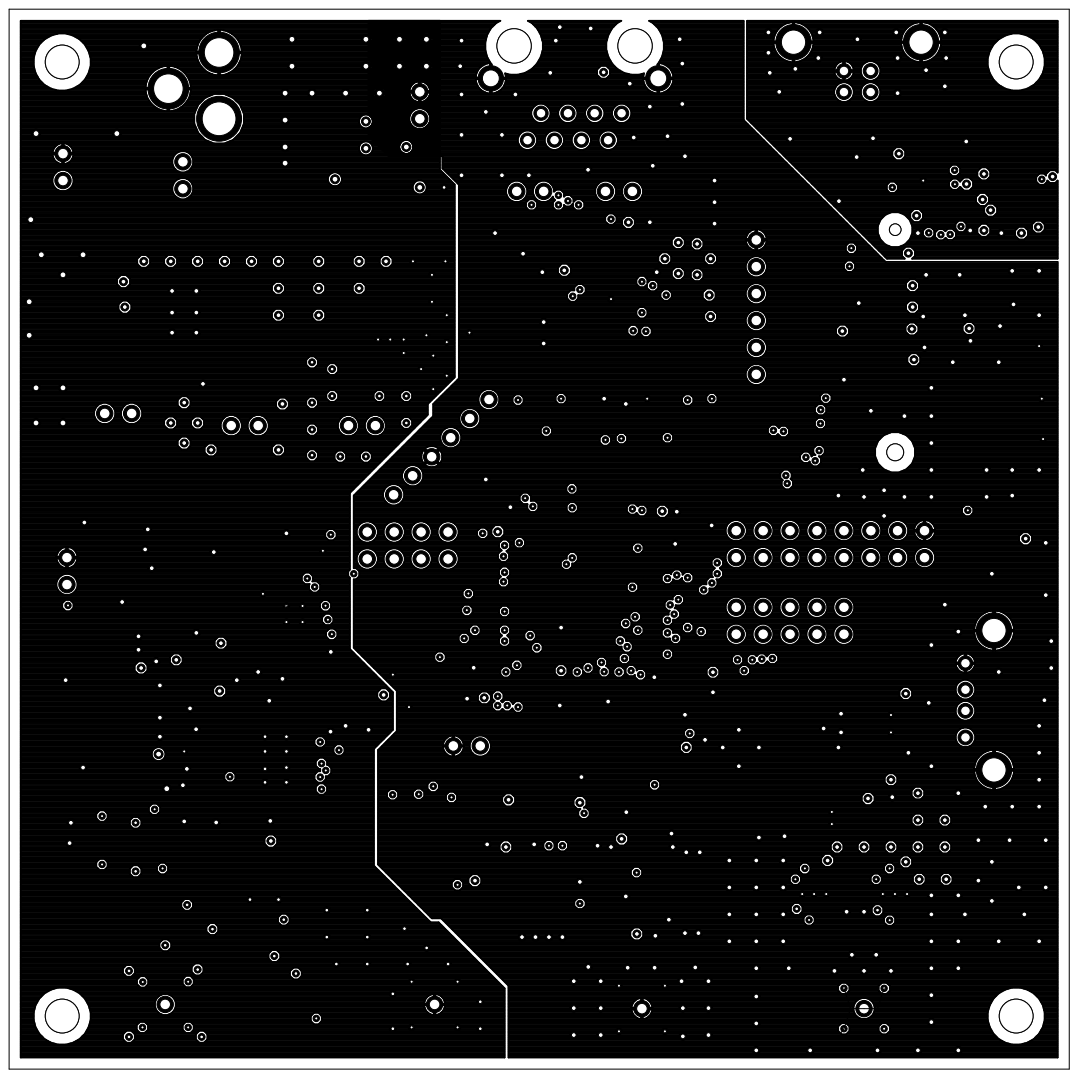
[picture p60: page 1]
