Crinst/LPWAN-current-logger-device/docs/board_pictures/DP_V3_Copper_L2_edit.pdf

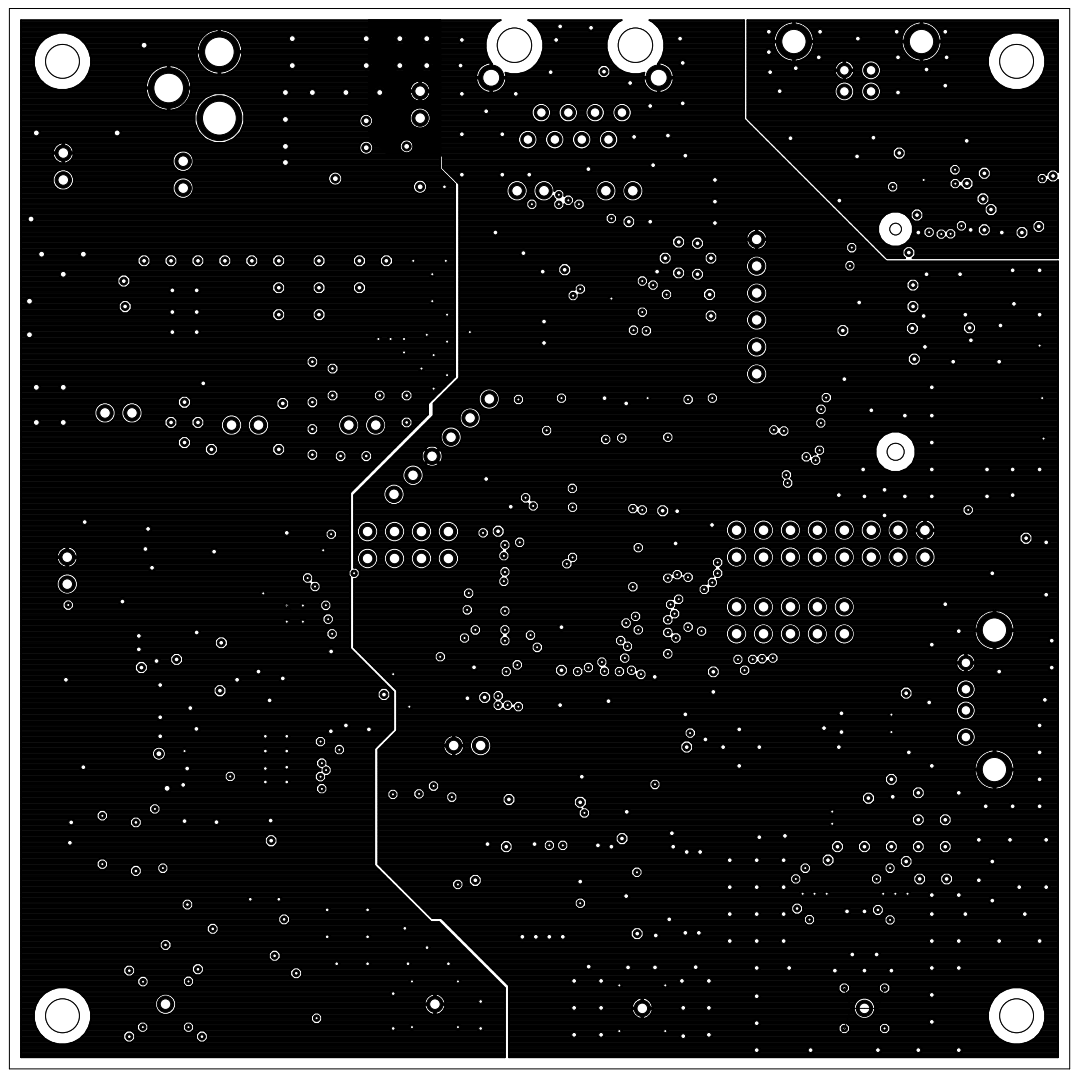
[picture p61: page 1]
