Crinst/LPWAN-current-logger-device/docs/board_pictures/DP_V3_Copper_L3.pdf

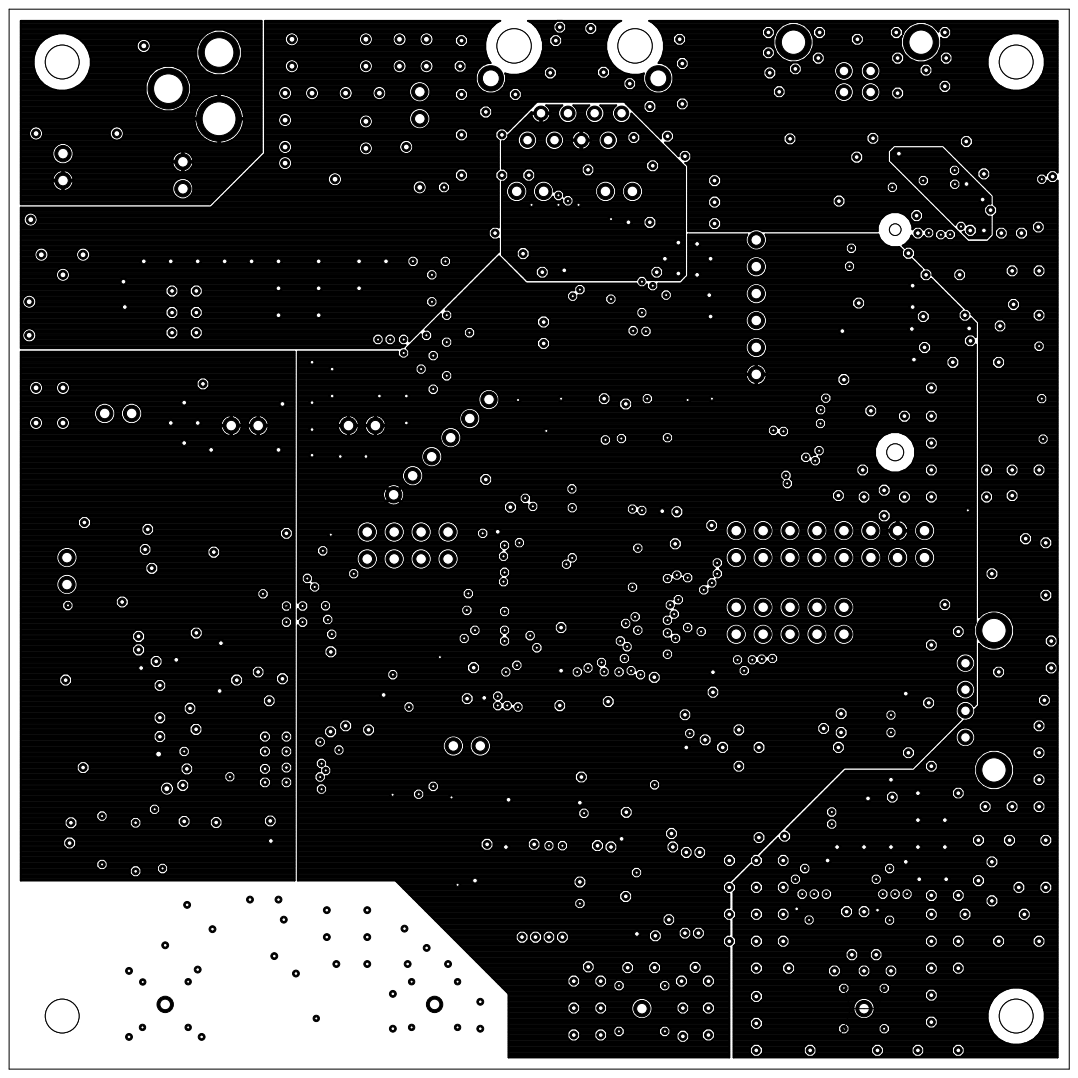
[picture p62: page 1]
