Crinst/LPWAN-current-logger-device/docs/board_pictures/DP_V3_Copper_L3_edit.pdf

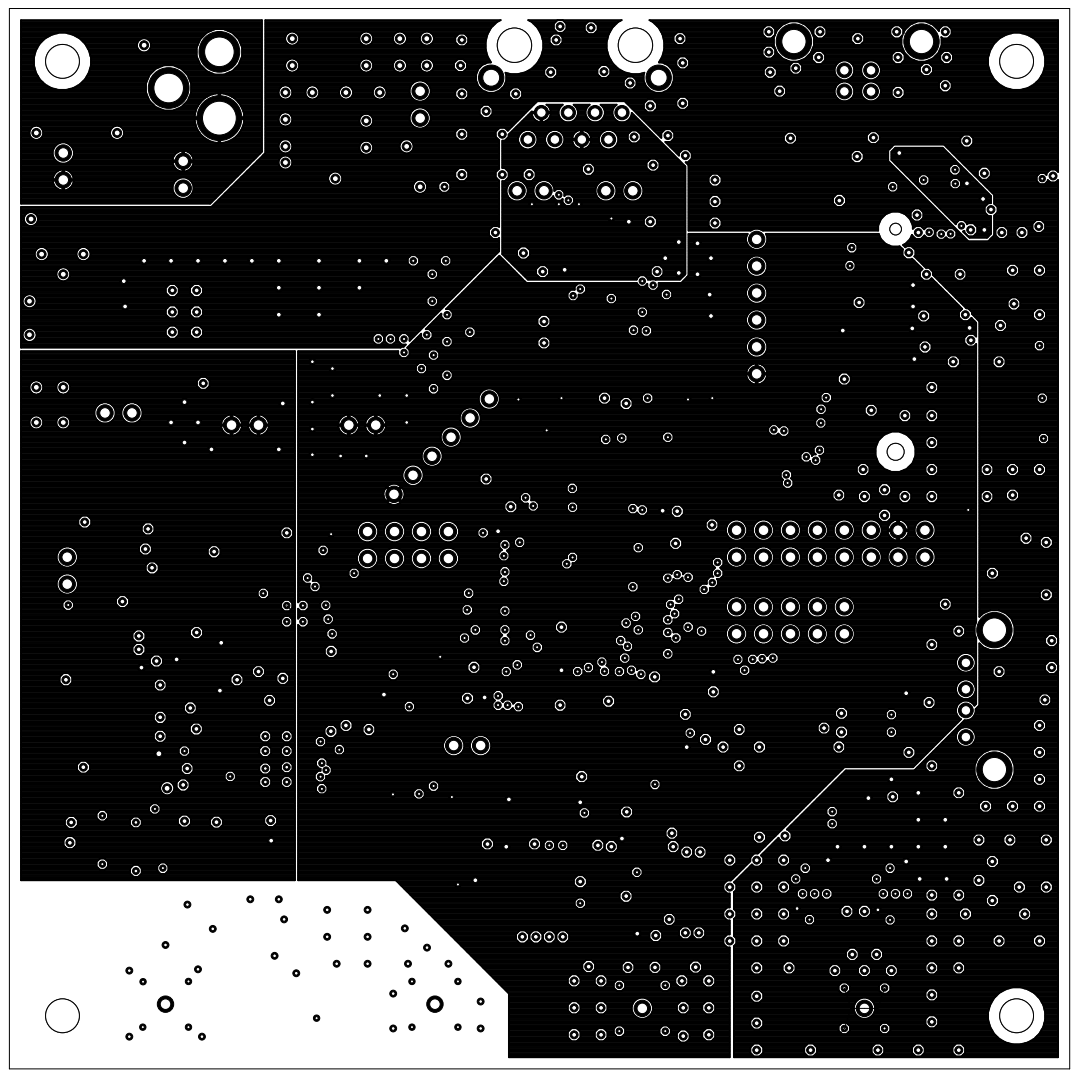
[picture p63: page 1]
