Crinst/LPWAN-current-logger-device/docs/board_pictures/DP_V3_Copper_L4_bottom.pdf

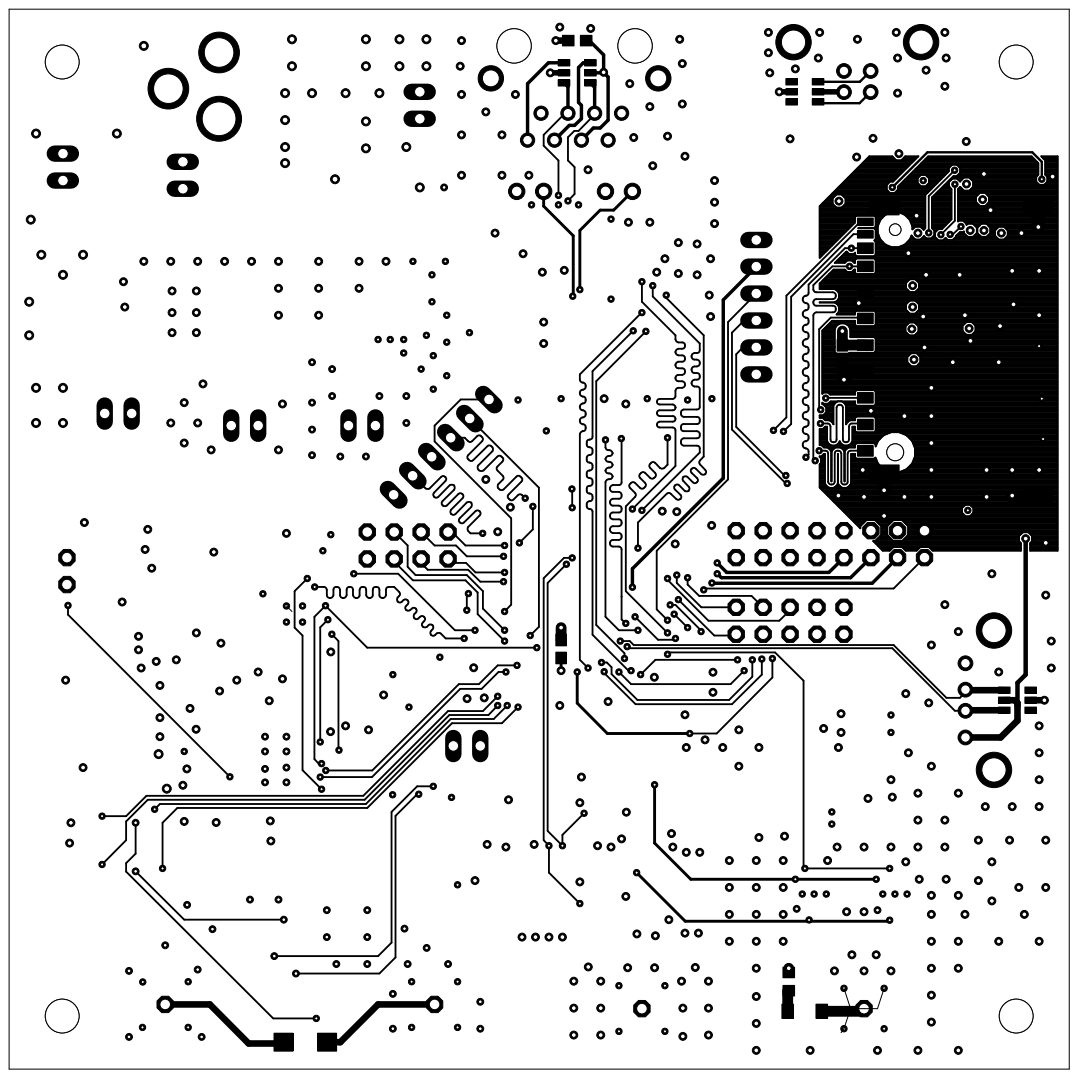
[picture p64: page 1]
