Crinst/LPWAN-current-logger-device/docs/board_pictures/DP_V3_Copper_L4_bottom_edit.pdf

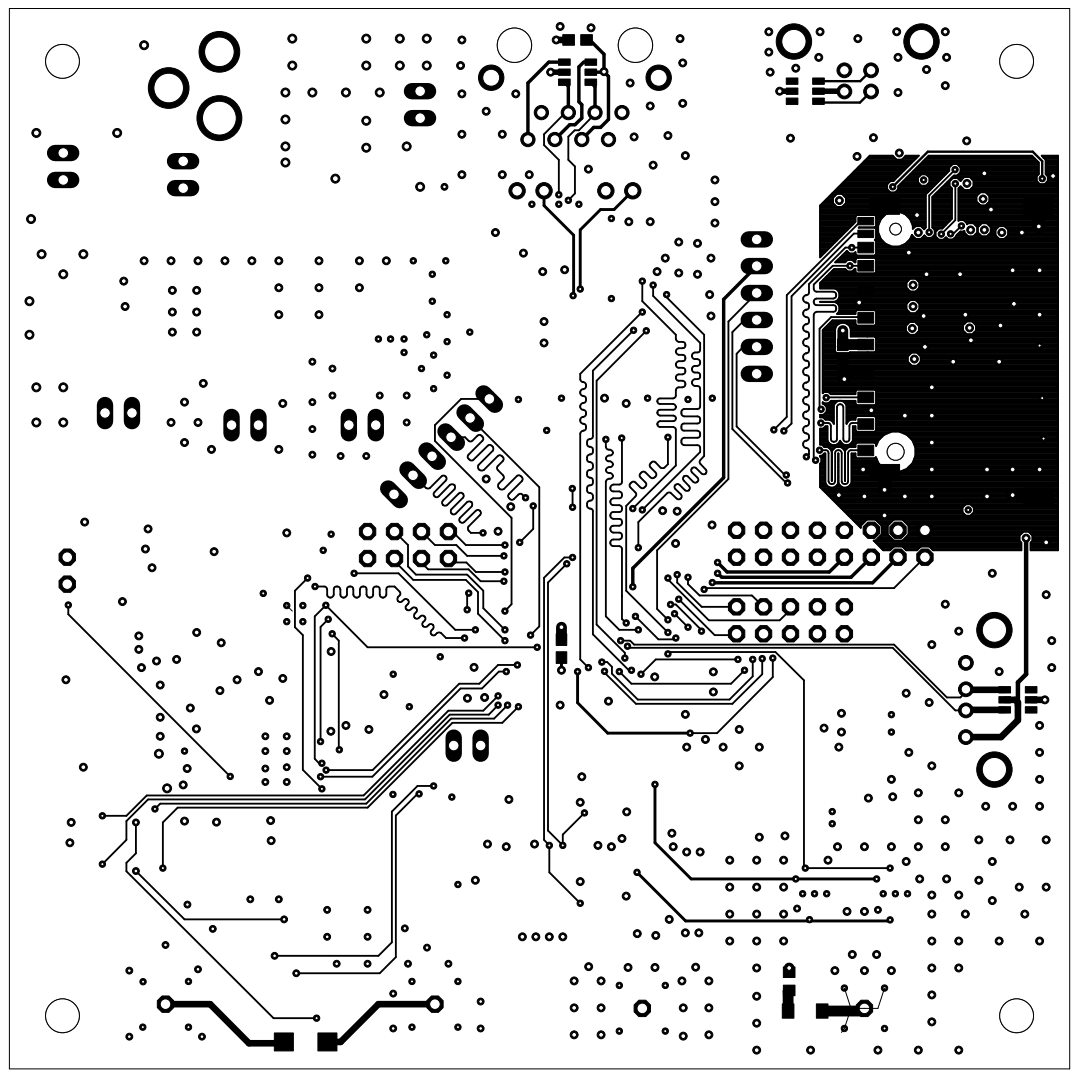
[picture p65: page 1]
