Crinst/LPWAN-current-logger-device/docs/board_pictures/DP_V3_Sheet_1_black.pdf

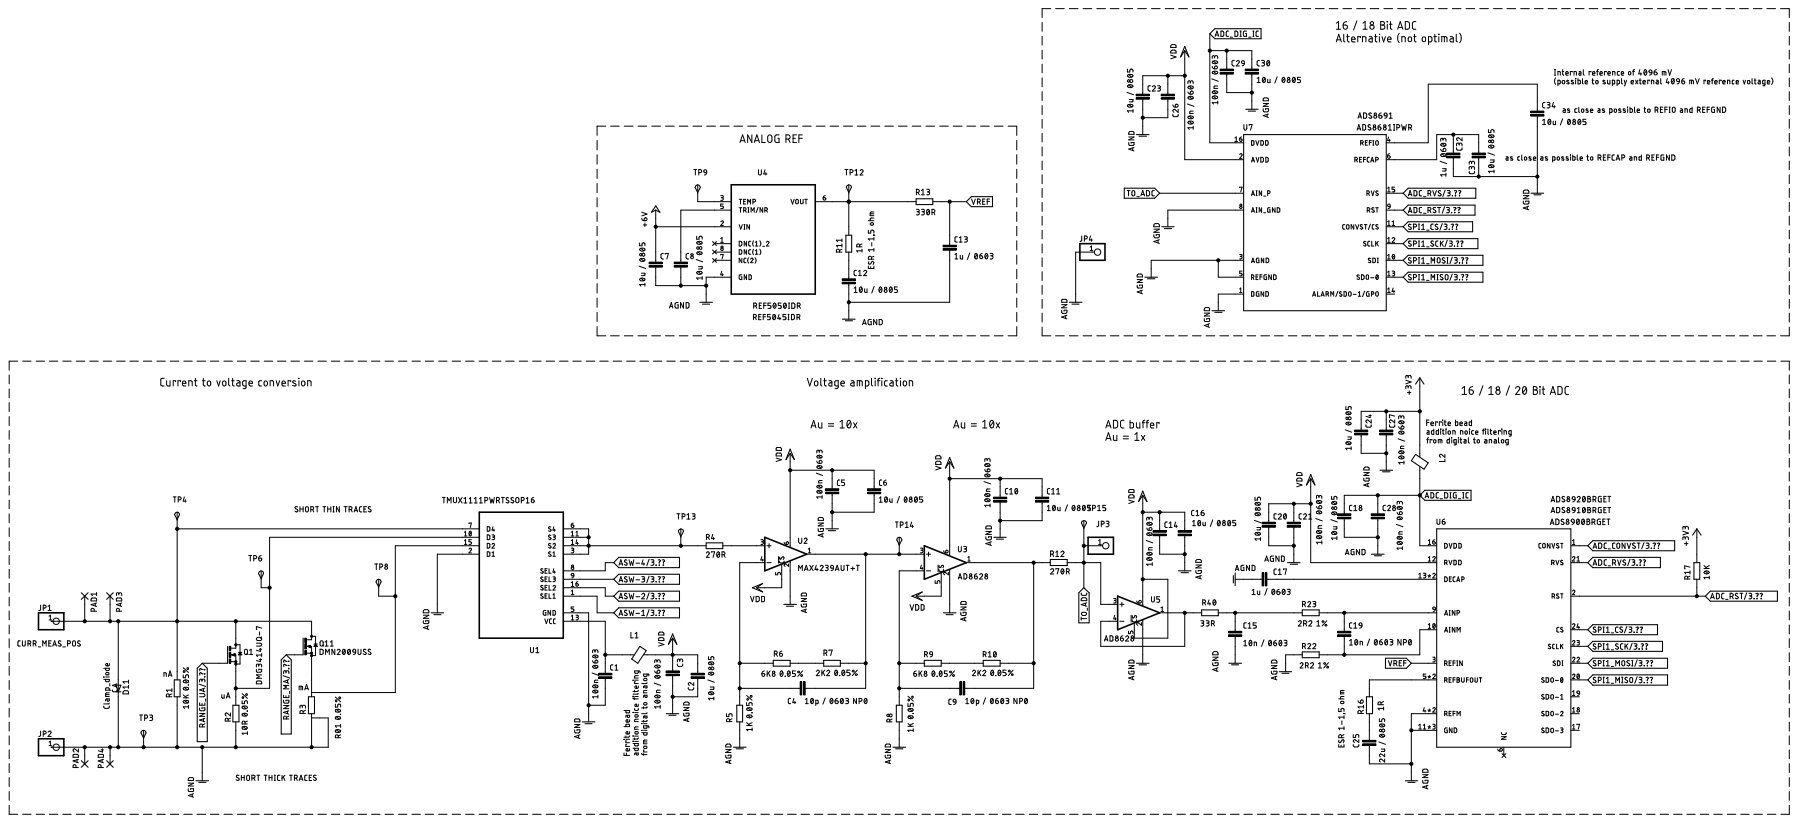
[picture p66: page 1]
