Crinst/LPWAN-current-logger-device/docs/board_pictures/DP_V3_Sheet_1_color.pdf

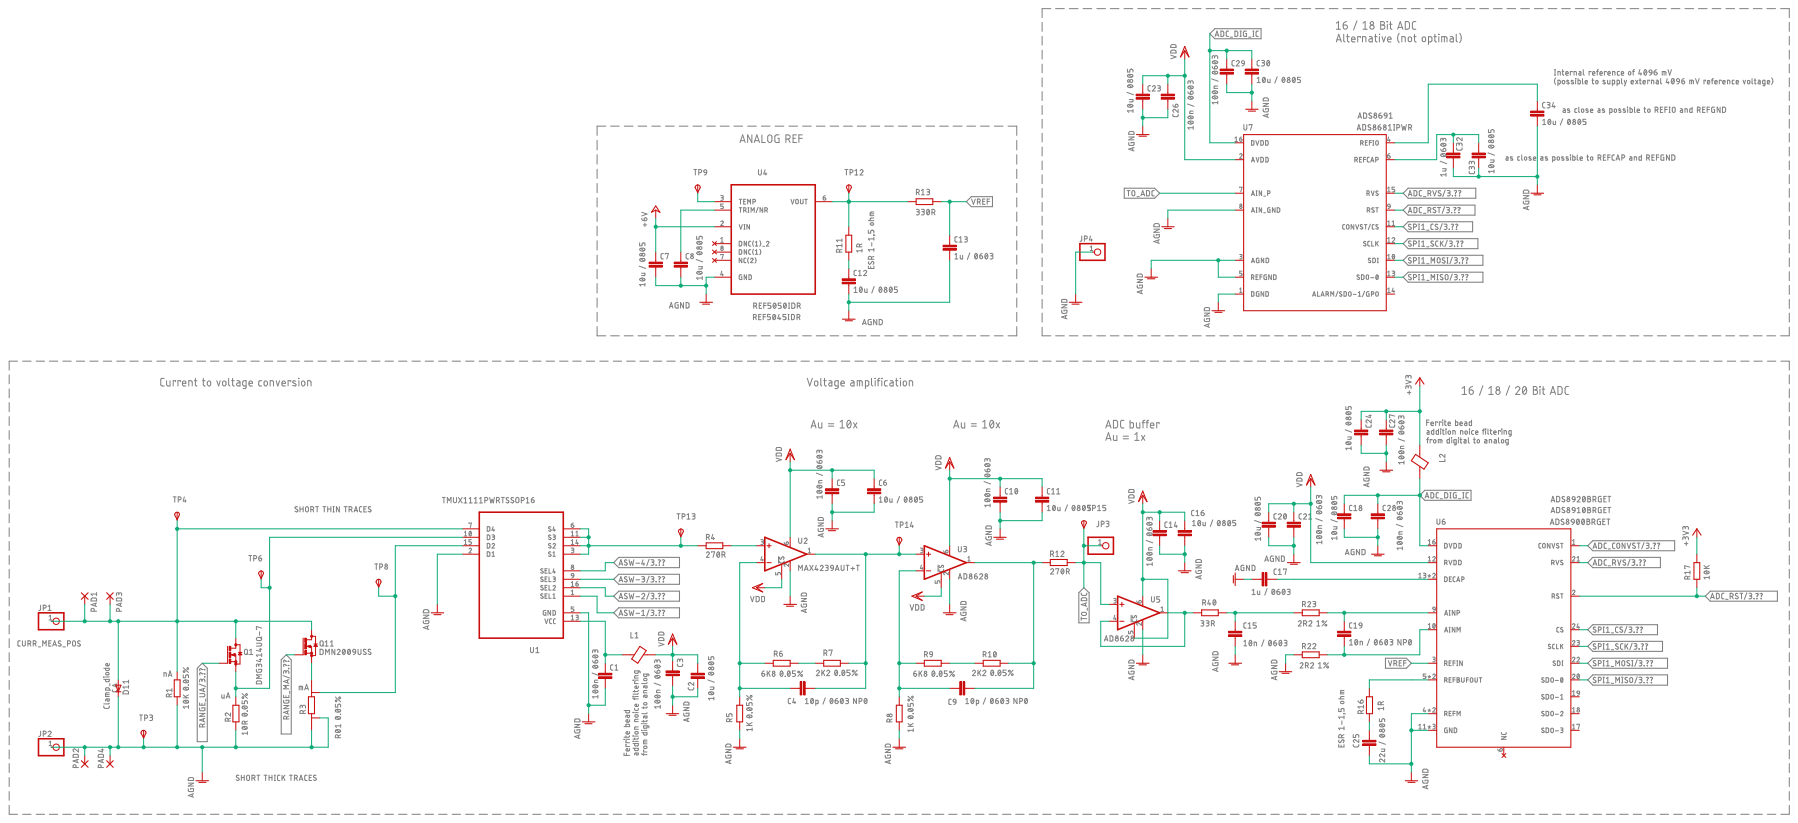
[picture p67: page 1]
