Crinst/LPWAN-current-logger-device/docs/board_pictures/DP_V3_Sheet_2_black.pdf

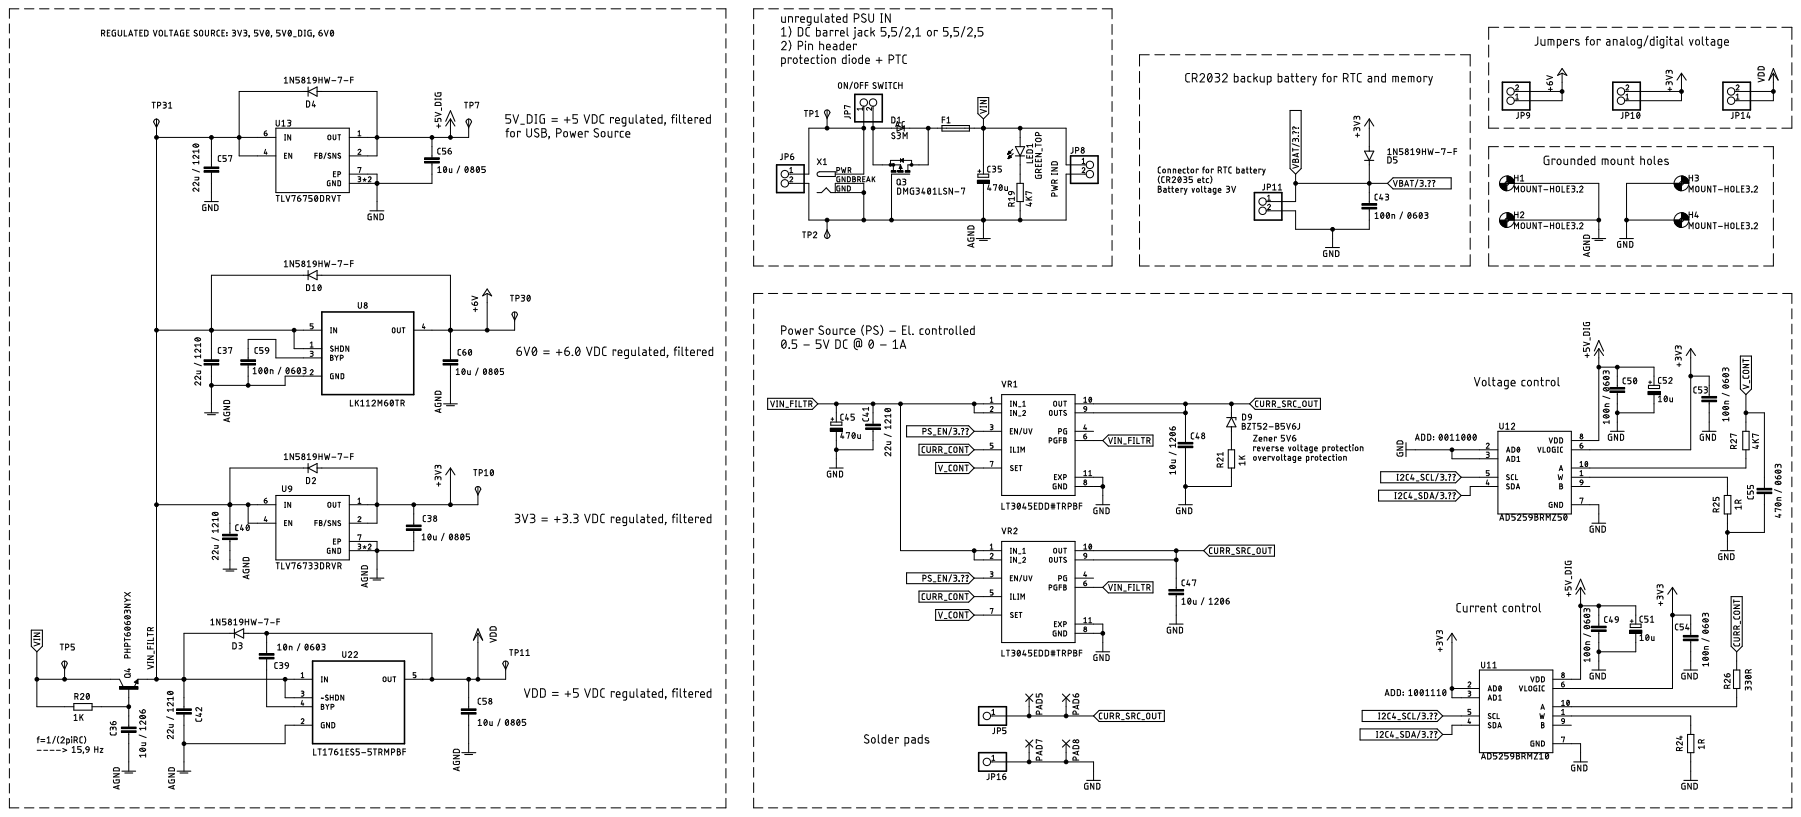
[picture p68: page 1]
