Crinst/LPWAN-current-logger-device/docs/board_pictures/DP_V3_Sheet_2_color.pdf

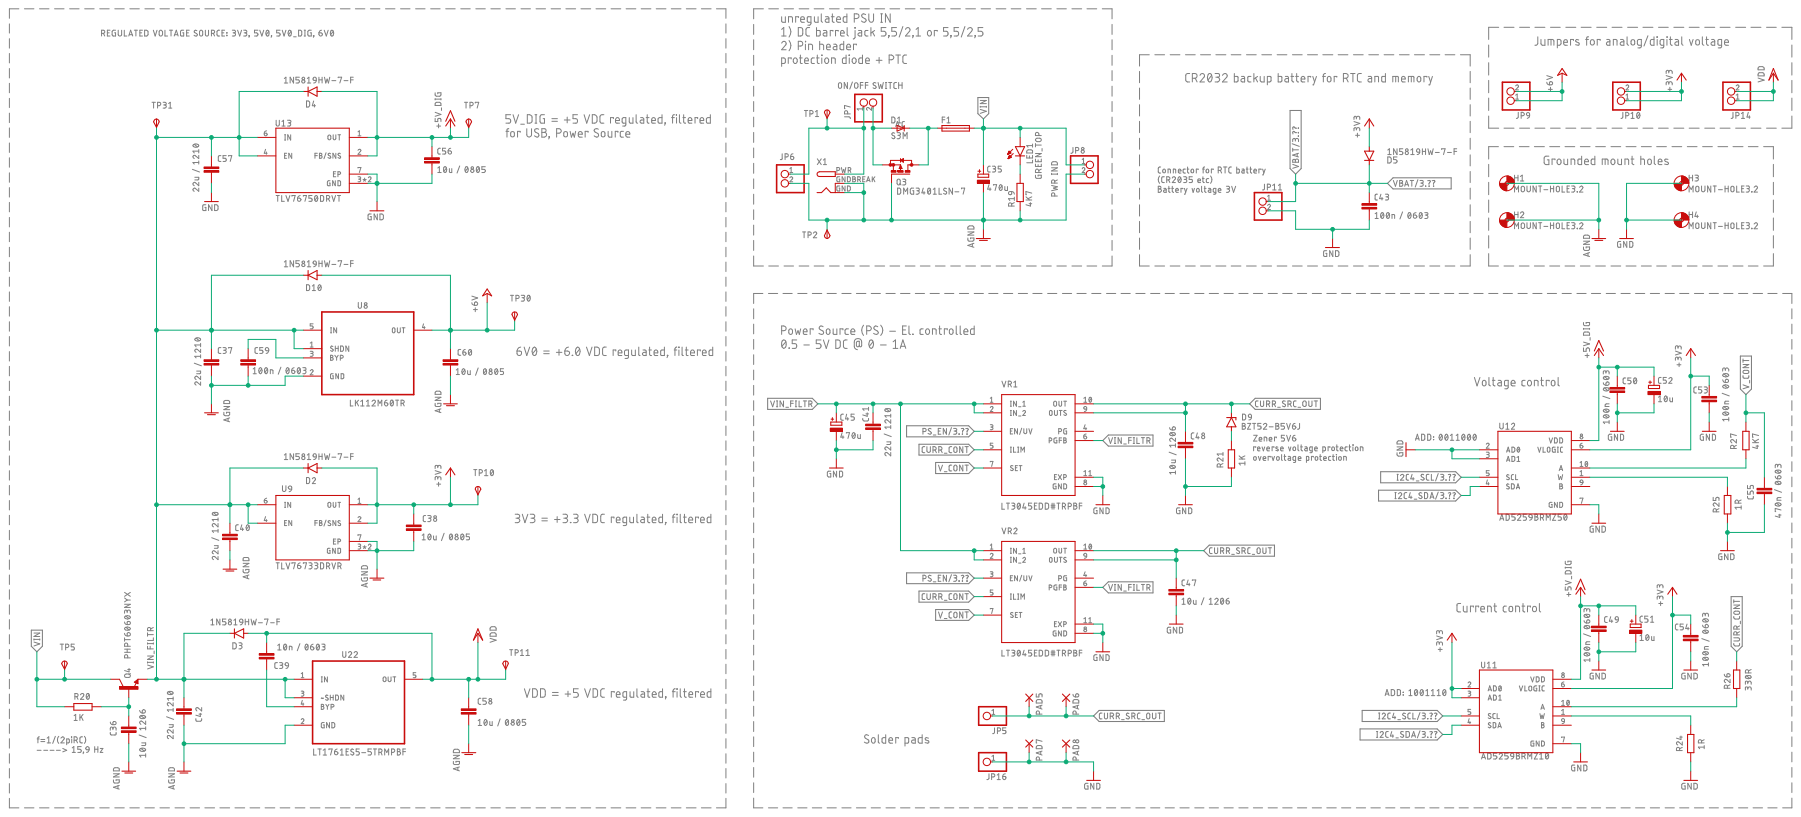
[picture p69: page 1]
