Crinst/LPWAN-current-logger-device/docs/board_pictures/DP_V3_Sheet_3_black.pdf

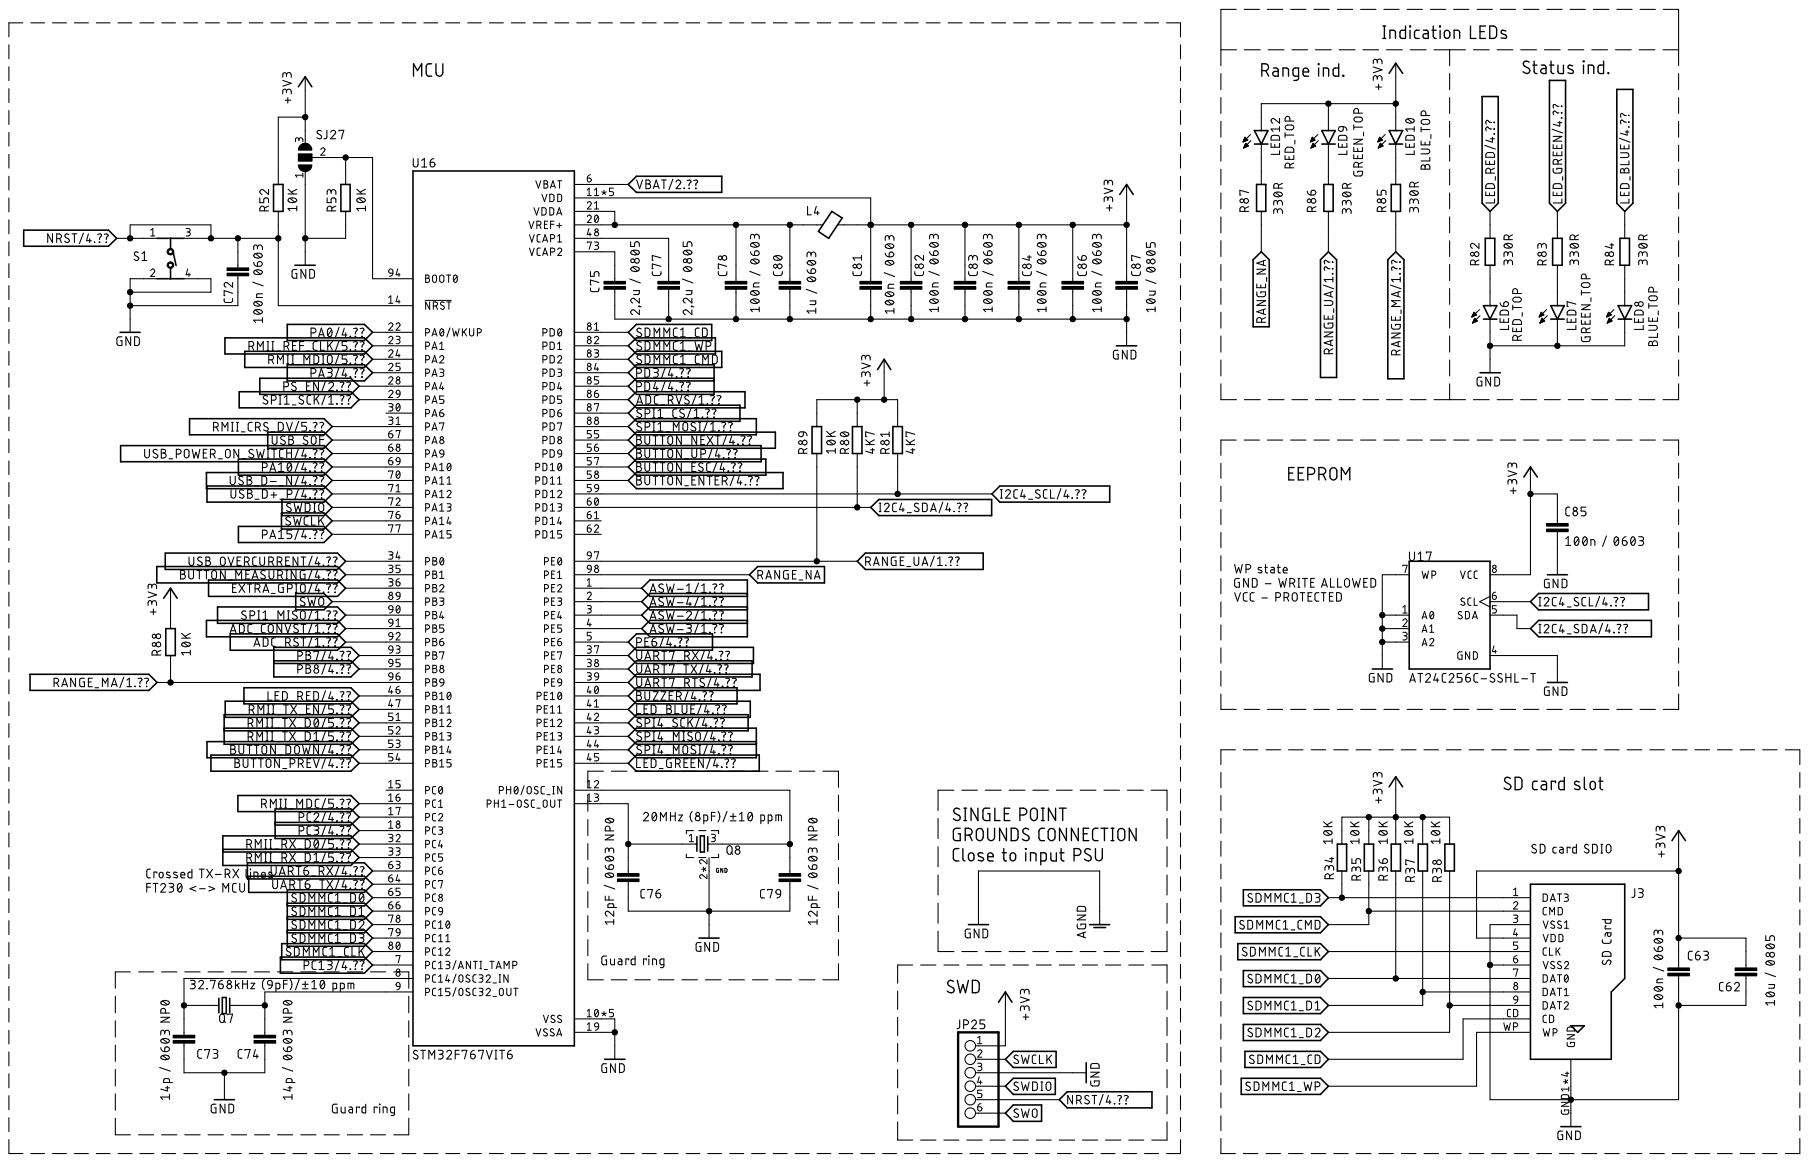
[picture p70: page 1]
