Crinst/LPWAN-current-logger-device/docs/board_pictures/DP_V3_Sheet_3_color.pdf

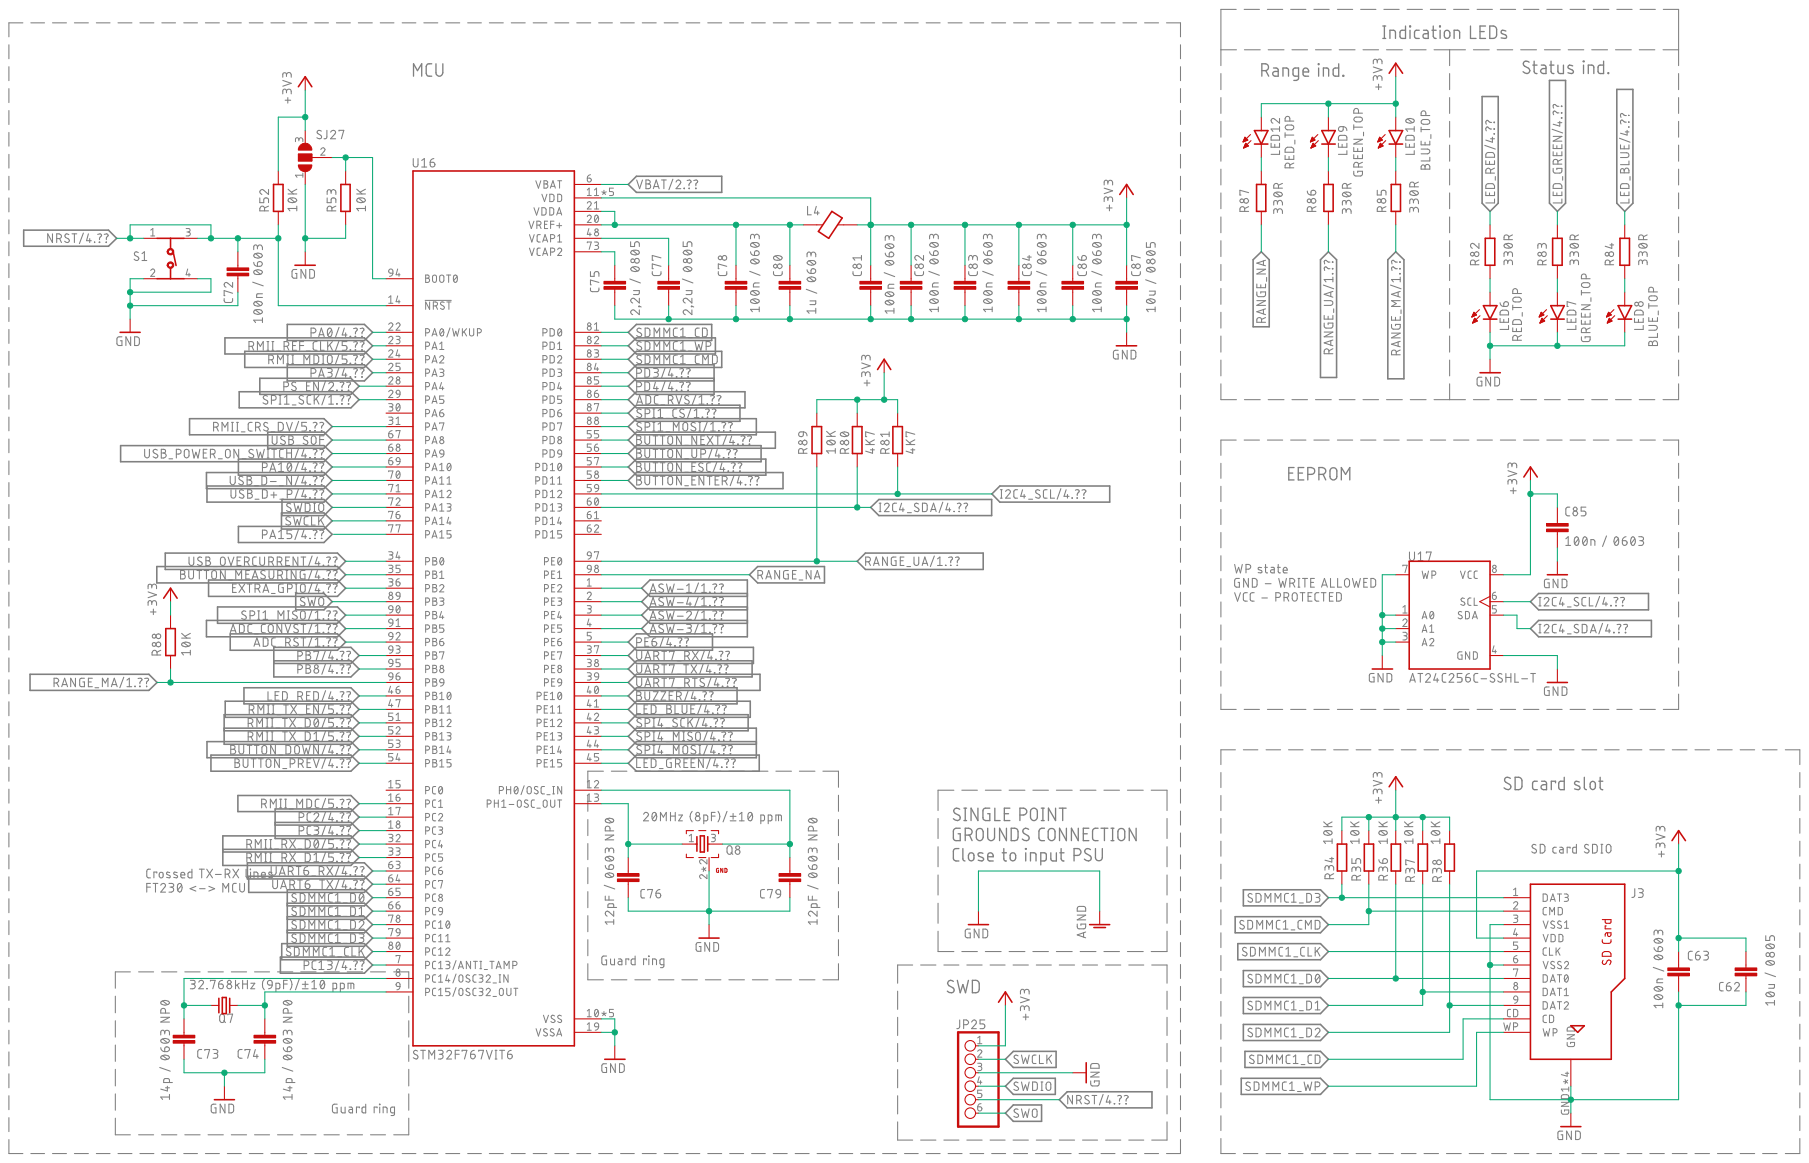
[picture p71: page 1]
