Crinst/LPWAN-current-logger-device/docs/board_pictures/DP_V3_Sheet_3_color_edit.pdf

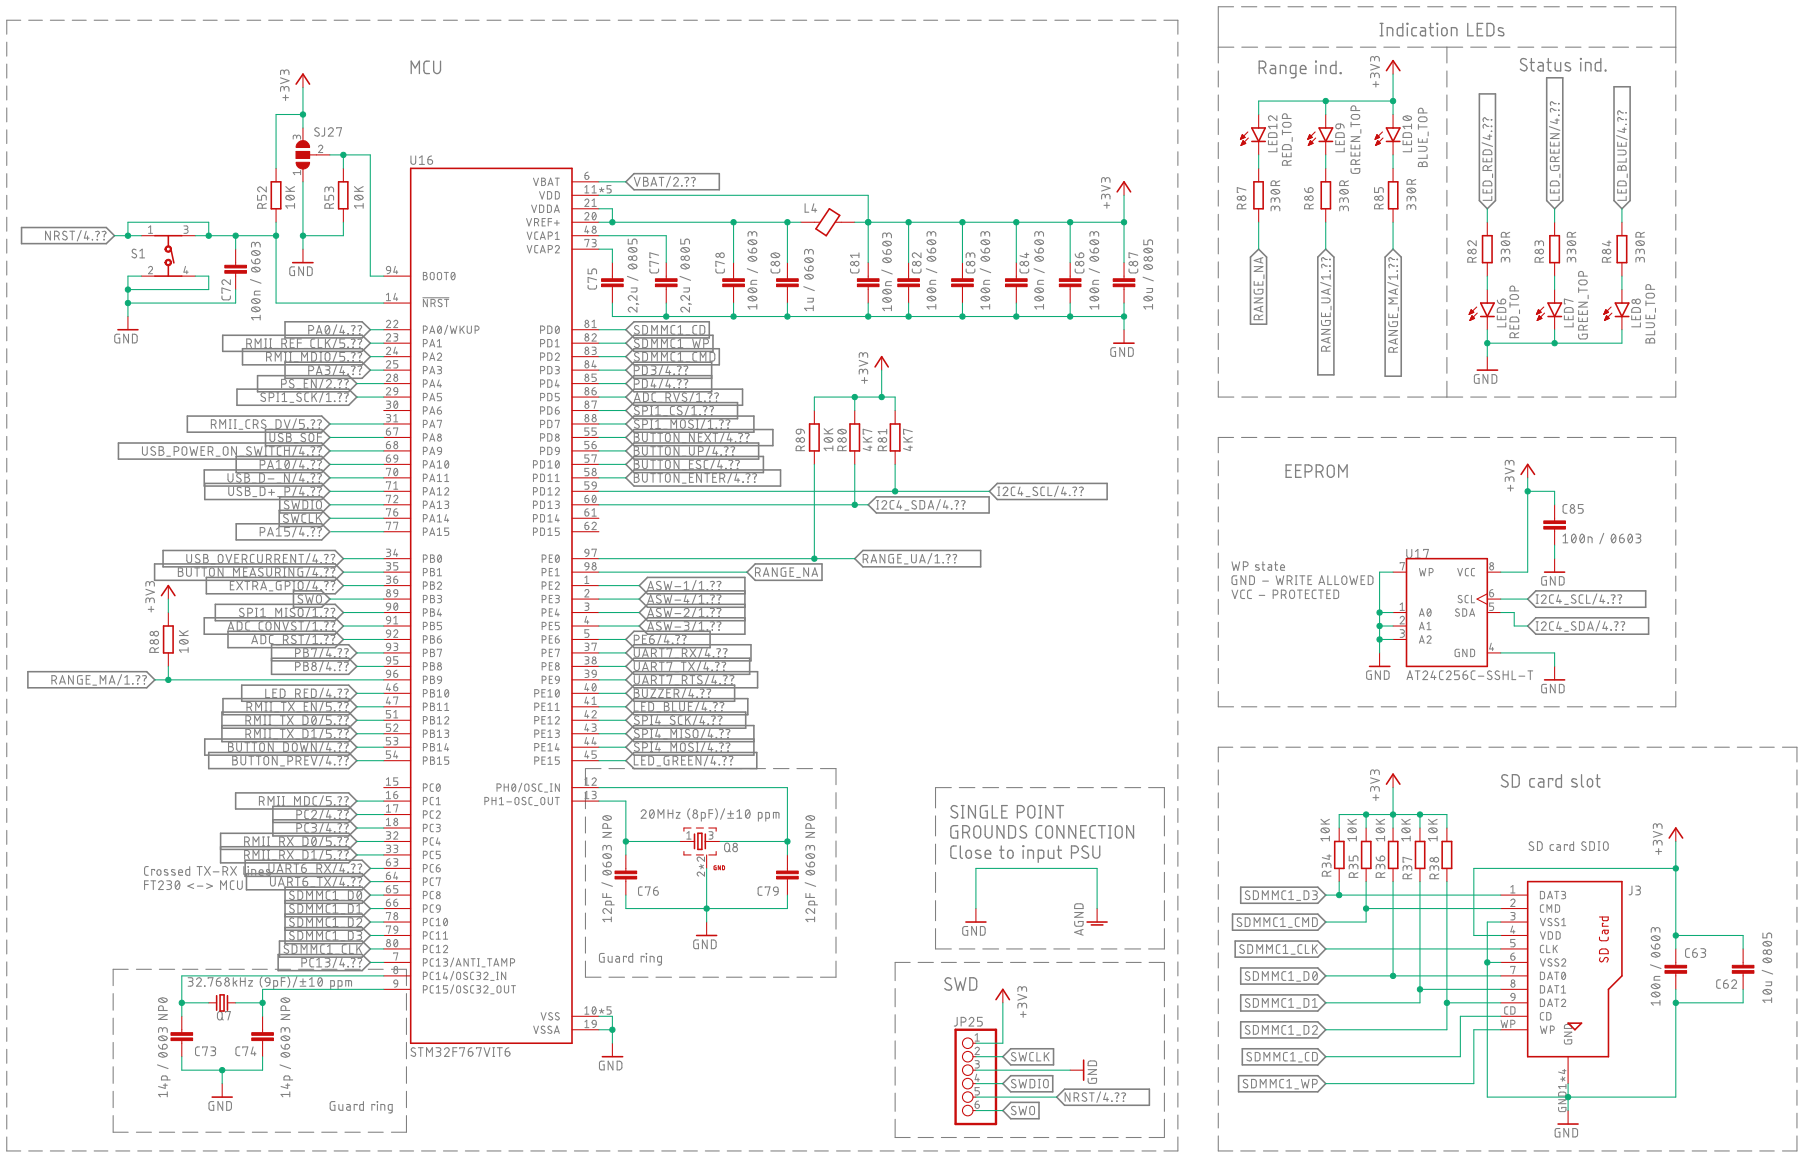
[picture p72: page 1]
