Crinst/LPWAN-current-logger-device/docs/board_pictures/DP_V3_Sheet_4_black.pdf

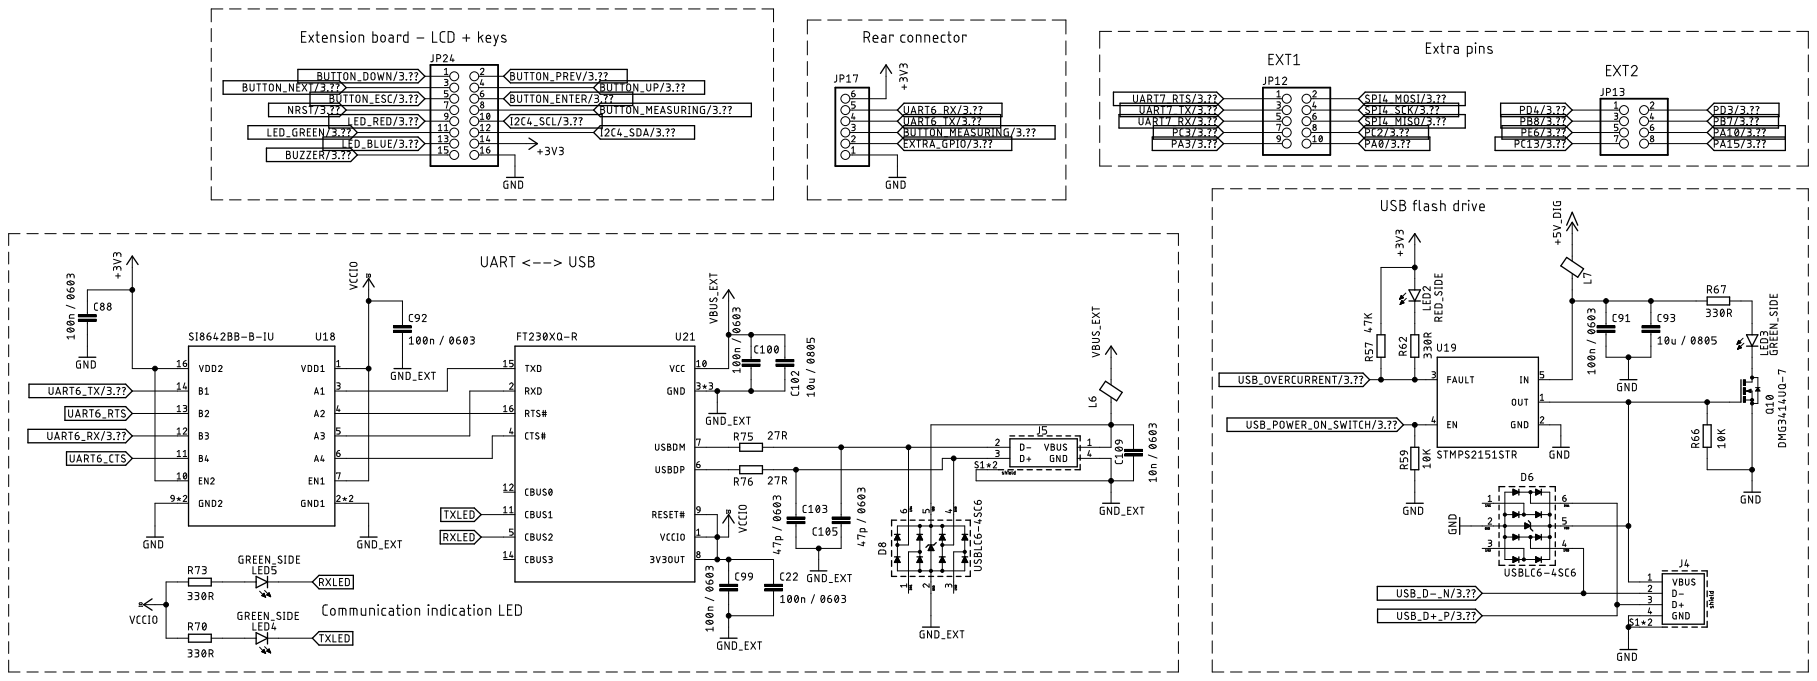
[picture p73: page 1]
