Crinst/LPWAN-current-logger-device/docs/board_pictures/DP_V3_Sheet_4_color.pdf

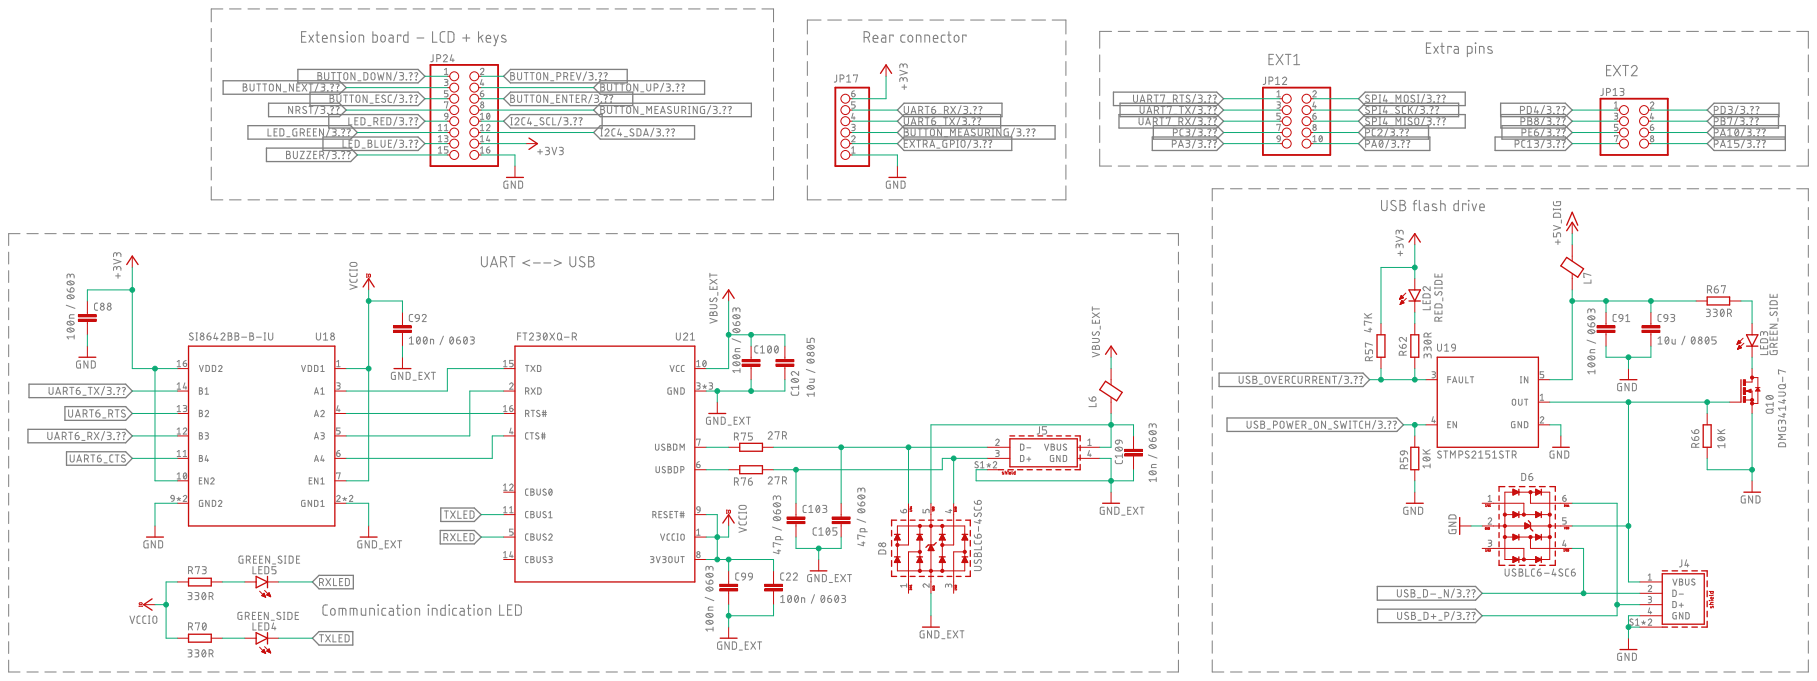
[picture p74: page 1]
