Crinst/LPWAN-current-logger-device/docs/board_pictures/DP_V3_Sheet_4_color_edit.pdf

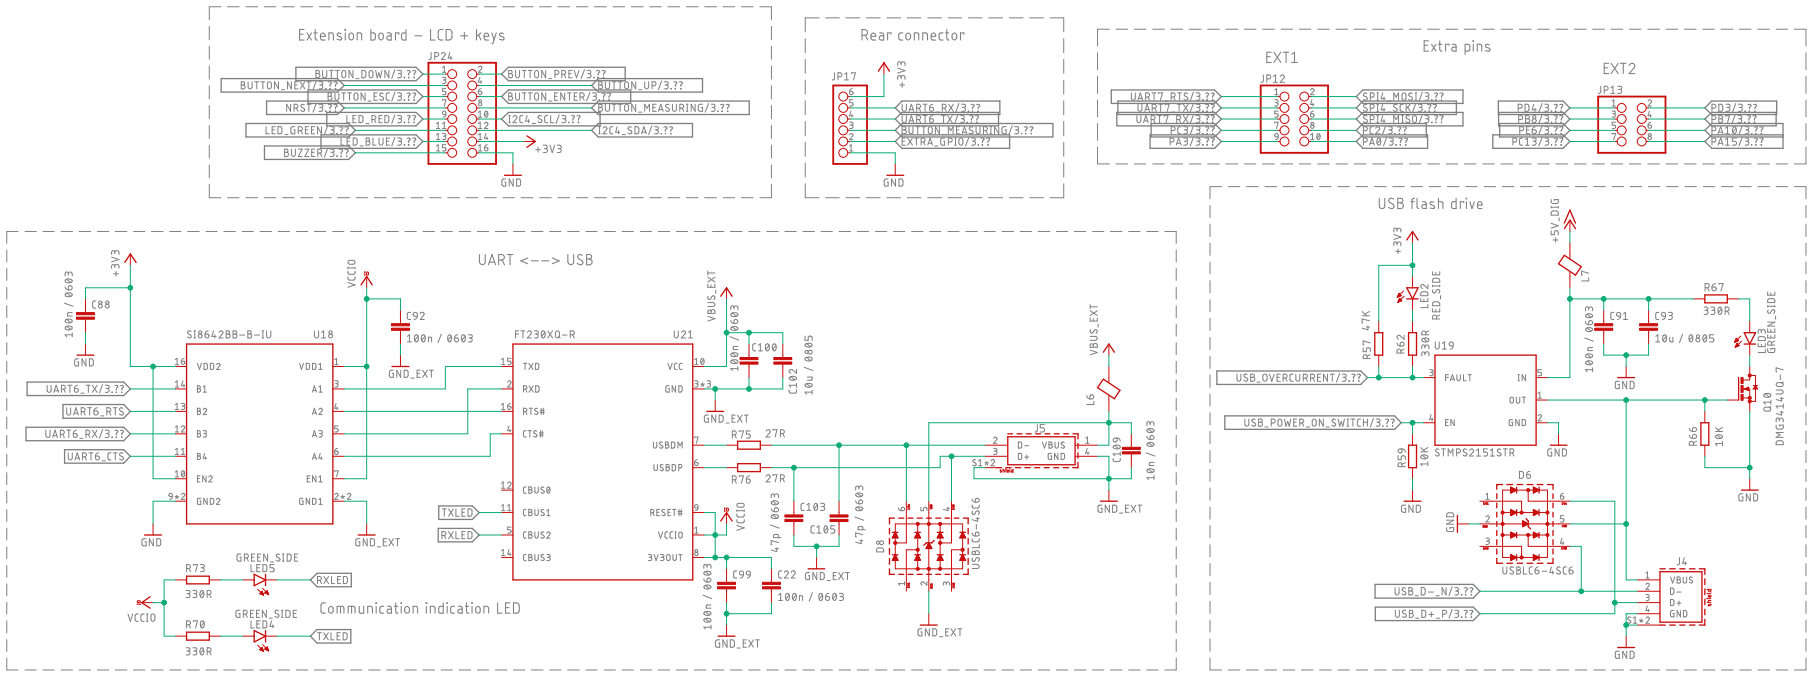
[picture p75: page 1]
