Crinst/LPWAN-current-logger-device/docs/board_pictures/DP_V3_Sheet_5_black.pdf

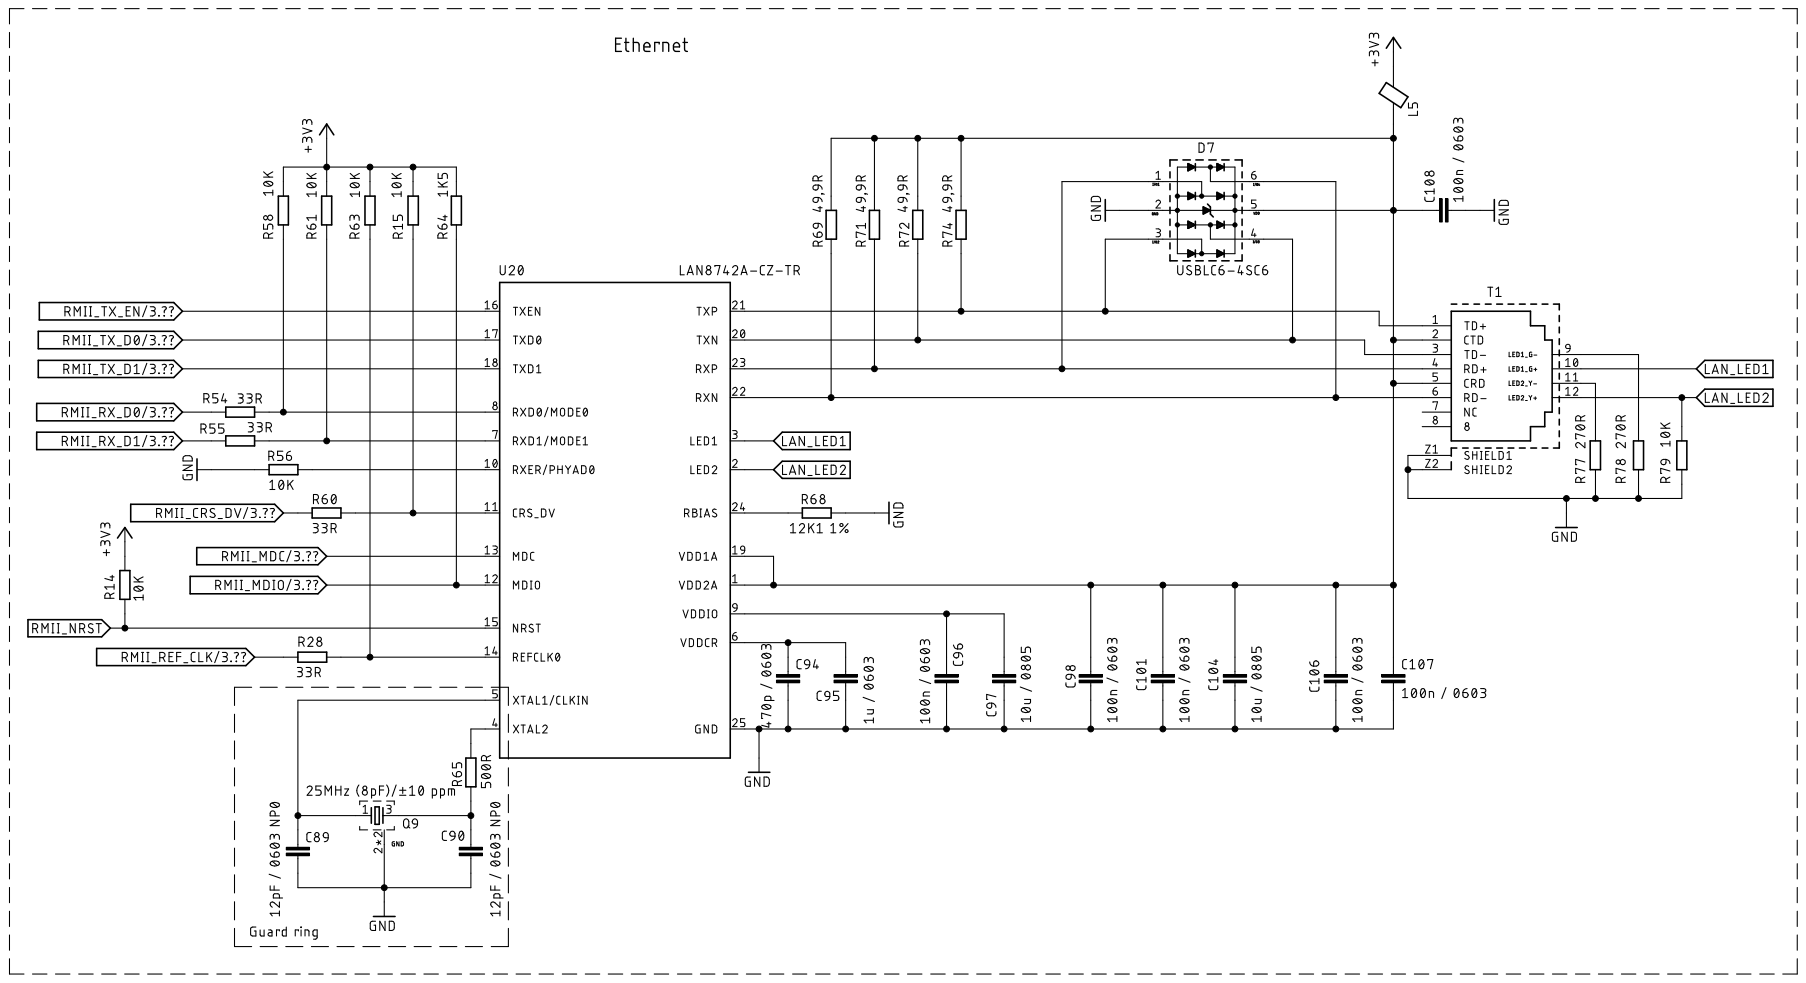
[picture p76: page 1]
