Crinst/LPWAN-current-logger-device/docs/board_pictures/DP_V3_Sheet_5_color.pdf

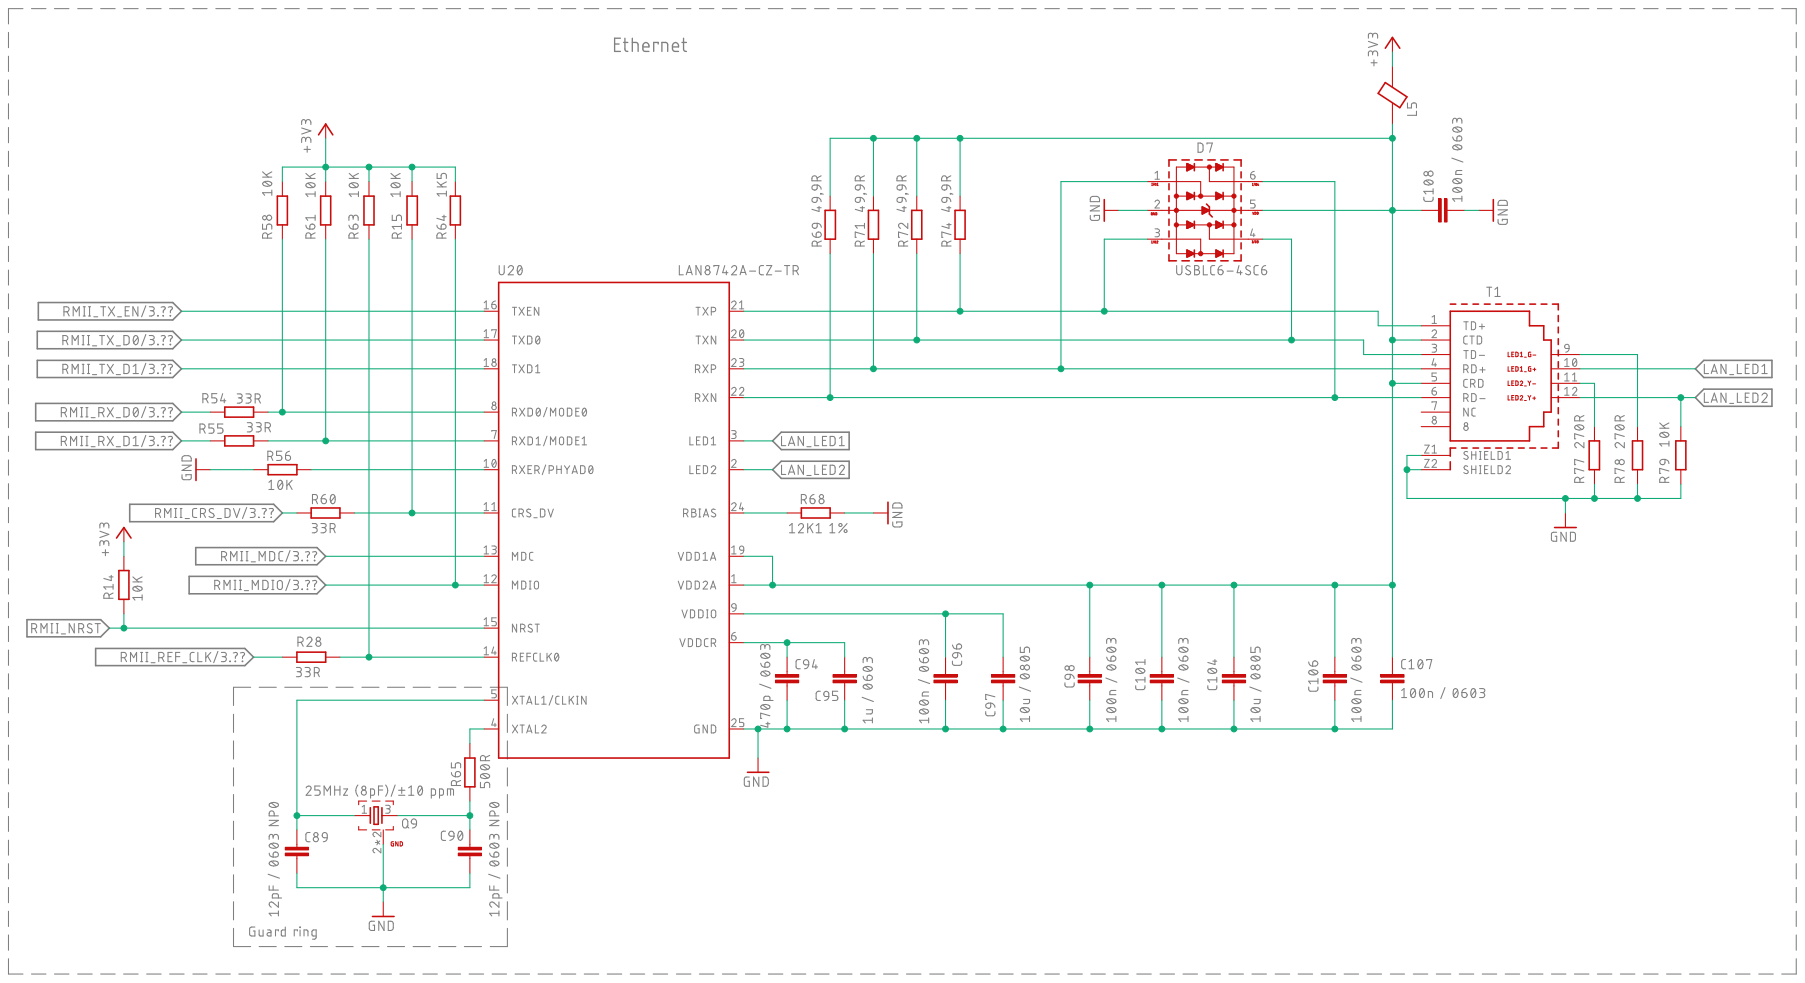
[picture p77: page 1]
