Crinst/LPWAN-current-logger-device/docs/board_pictures/DP_V3_Sheet_5_color_edit.pdf

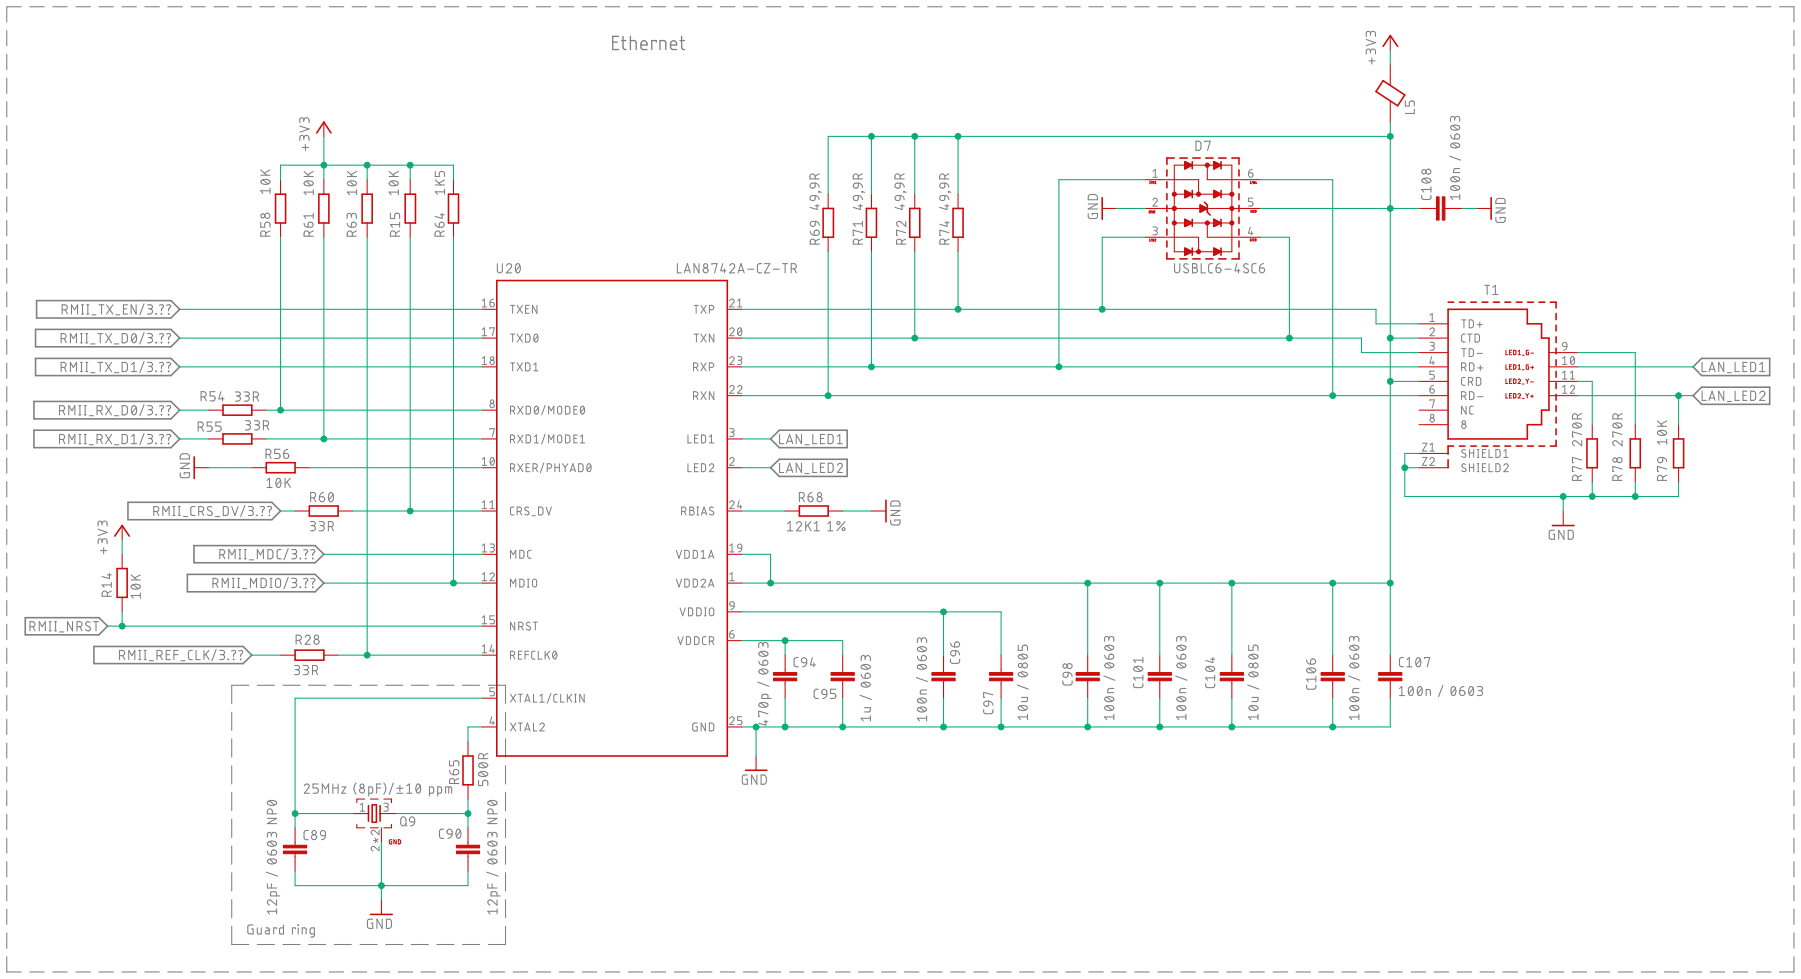
[picture p78: page 1]
