Crinst/LPWAN-current-logger-device/docs/flowcharts/Vyvojovy_diagram_sw_uart_menu.pdf

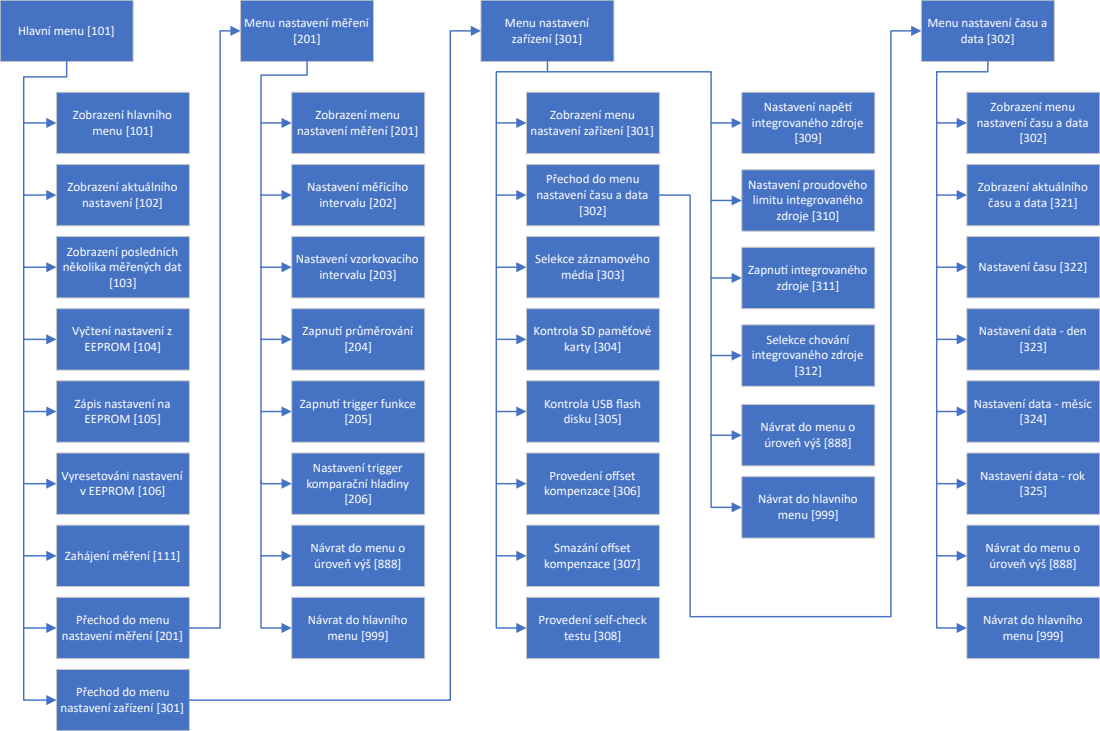
[picture p79: page 1]
Hlavní menu [101]; Zobrazení aktuálního nastavení [102]; Vyčtení nastavení z EEPROM [104]; Vyresetováni nastavení v EEPROM [106]; Zahájení měření [111]; Zobrazení hlavního menu [101]; Zobrazení menu nastavení měření [201]; Nastavení měřícího intervalu [202]; Nastavení vzorkovacího intervalu [203]; Zapnu průměrování [204]; Nastavení trigger komparační hladiny [206]; Menu nastavení zařízení [301]; Zobrazení menu nastavení zařízení [301]; Selekce záznamového média [303]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

Menu nastavení měření

Menu nastavení času a
data [302]

Zobrazení menu
nastavení času a data

Přechod do menu

Zobrazení posledních
několika měřených dat

Kontrola SD paměťové
karty [304]

Nastavení data - den

Zápis nastavení na
EEPROM [105]

Zapnu trigger funkce

Kontrola USB flash
disku [305]

Nastavení data - měsíc

Návrat do menu o
úroveň výš [888]

Nastavení data - rok

Návrat do hlavního
menu [999]

nastavení měření [201]

Provedení self-check
testu [308]

nastavení zařízení [301]
