Crinst/LPWAN-current-logger-device/eagle/v1_v2/DP_V1_analog.pdf

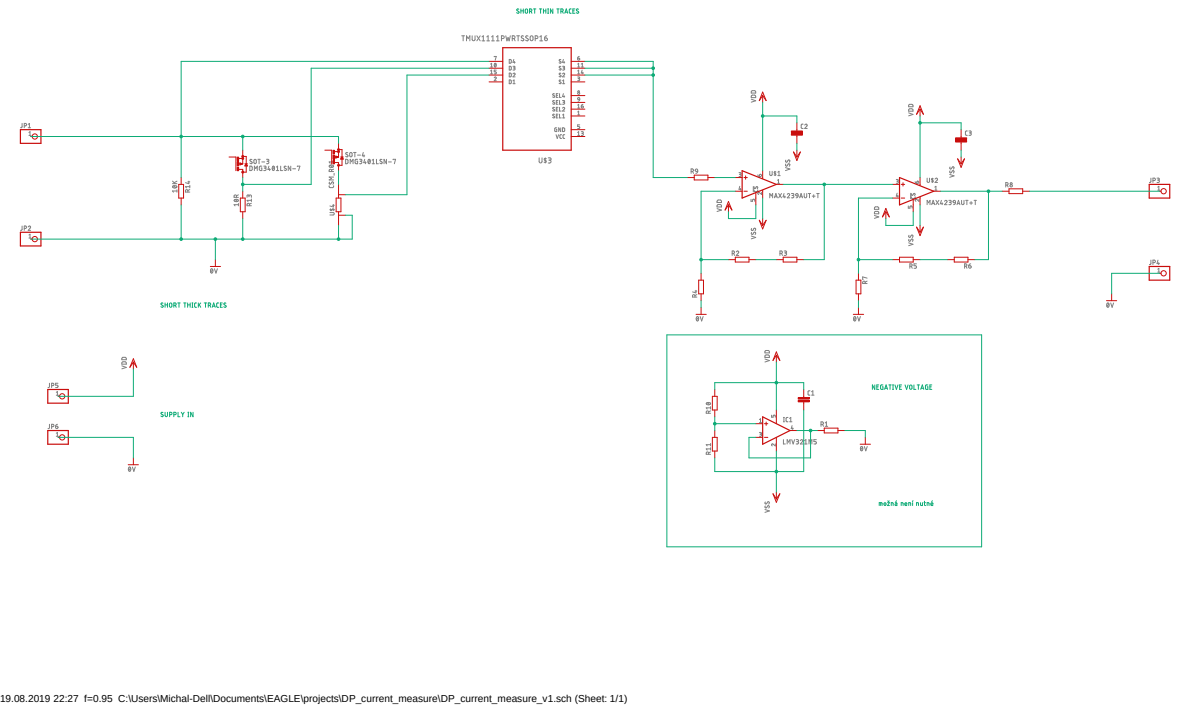
[picture p80: page 1]

19.08.2019 22:27 f=0.95 C:\Users\Michal-Dell\Documents\EAGLE\projects\DP_current_measure\DP_current_measure_v1.sch (Sheet: 1/1)
