Crinst/LPWAN-current-logger-device/ltspice/Current Limit PMOS Op Amp Adj.asc

C1: cap; 10µF
C2: cap; 100pf
D1: zener; D1N752
M1: pmos; Si4425BDY
R1: res; 0.1; pwr=1W
R2: res; 2k
R3: res; 30k
R5: res; 150k
R6: res; 1k
Rld: res; .01
U1: LM324
U2: pot; Rtot=10K wiper={W}
V1: voltage; 12V
Named nets: in, Out, G, 0, Ref, O
.op
.step param W 0 1 .25
1W
