Crinst/LPWAN-current-logger-device/ltspice/Draft2.asc

I1: load; 0.8
M1: pmos
R1: res; 0,01
R2: res; 40K
R3: res; 60K
R5: res; 2K
R6: res; 2K
R7: res; 1Meg
R8: res; 1Meg
U1: LT2079
U2: LT2079
V1: voltage; 2.5
V2: voltage; 5
V3: voltage; 5
V4: voltage; 2.8
Named nets: 0, VOUT, VSENSE, VREF, VCONTR, VLOAD
.tran 0.1
