Crinst/LPWAN-current-logger-device/eagle/v1_v2/DP_current_measure_v1.brd

## EAGLE design eagle/v1_v2/DP_current_measure_v1.brd (2026-08-03, an earlier design)

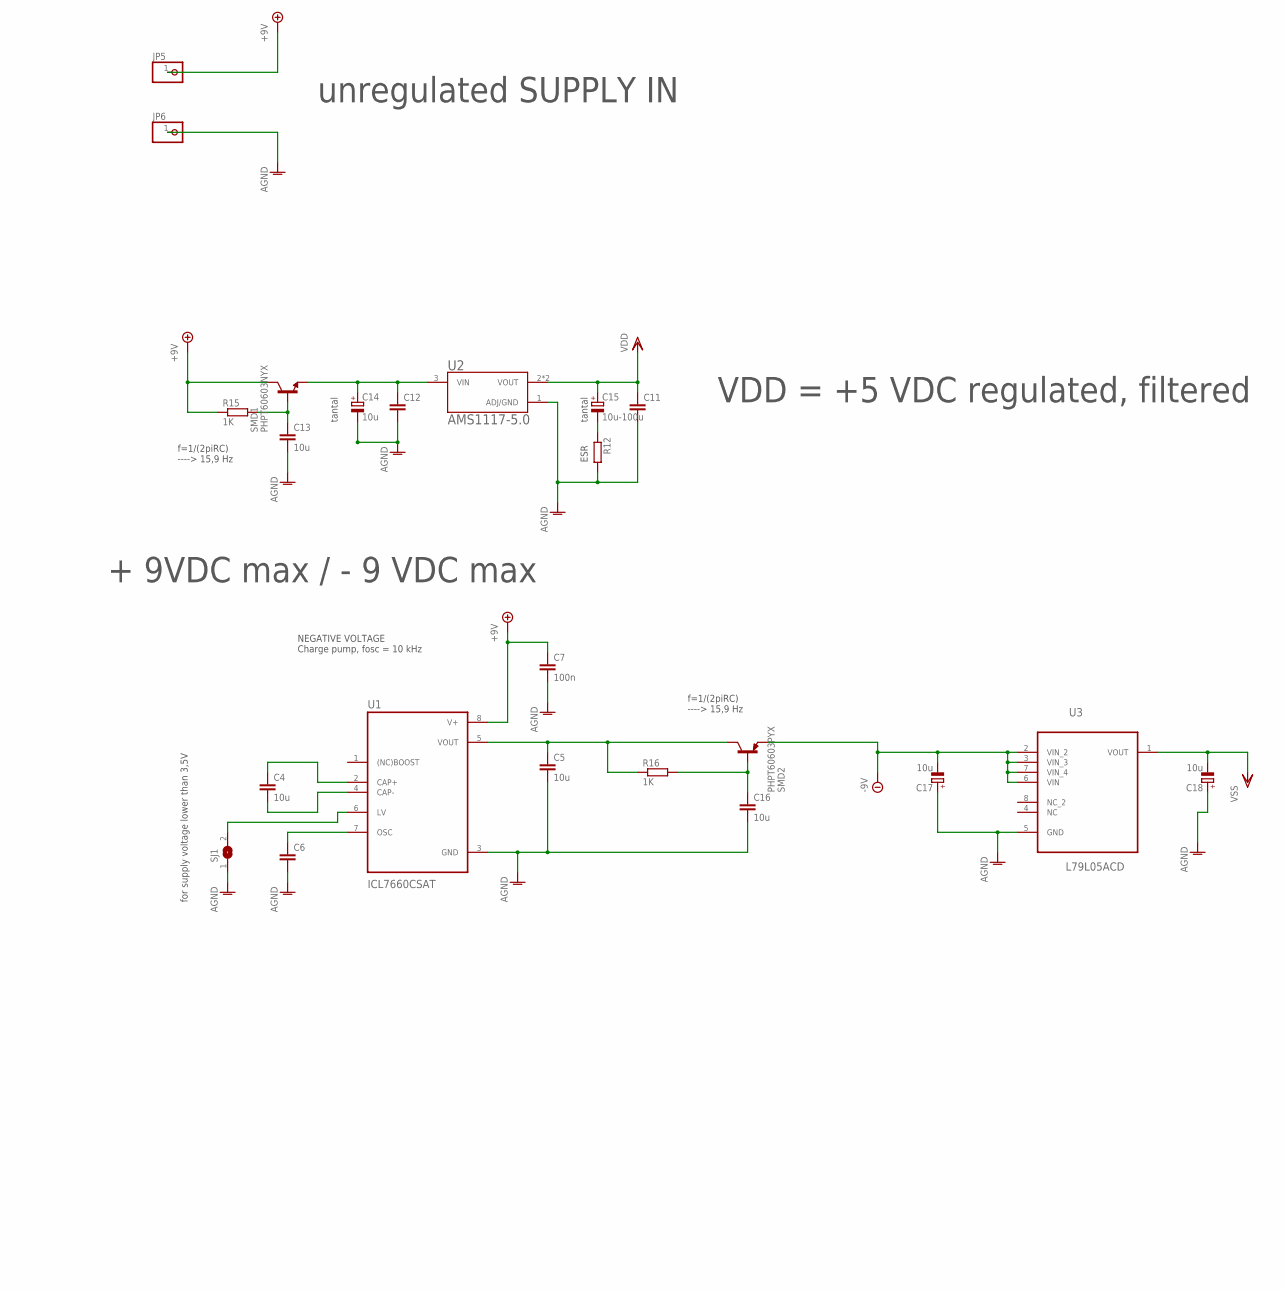
[picture p81: schematic DP_current_measure_v1.sch, part in row 1, column 1]

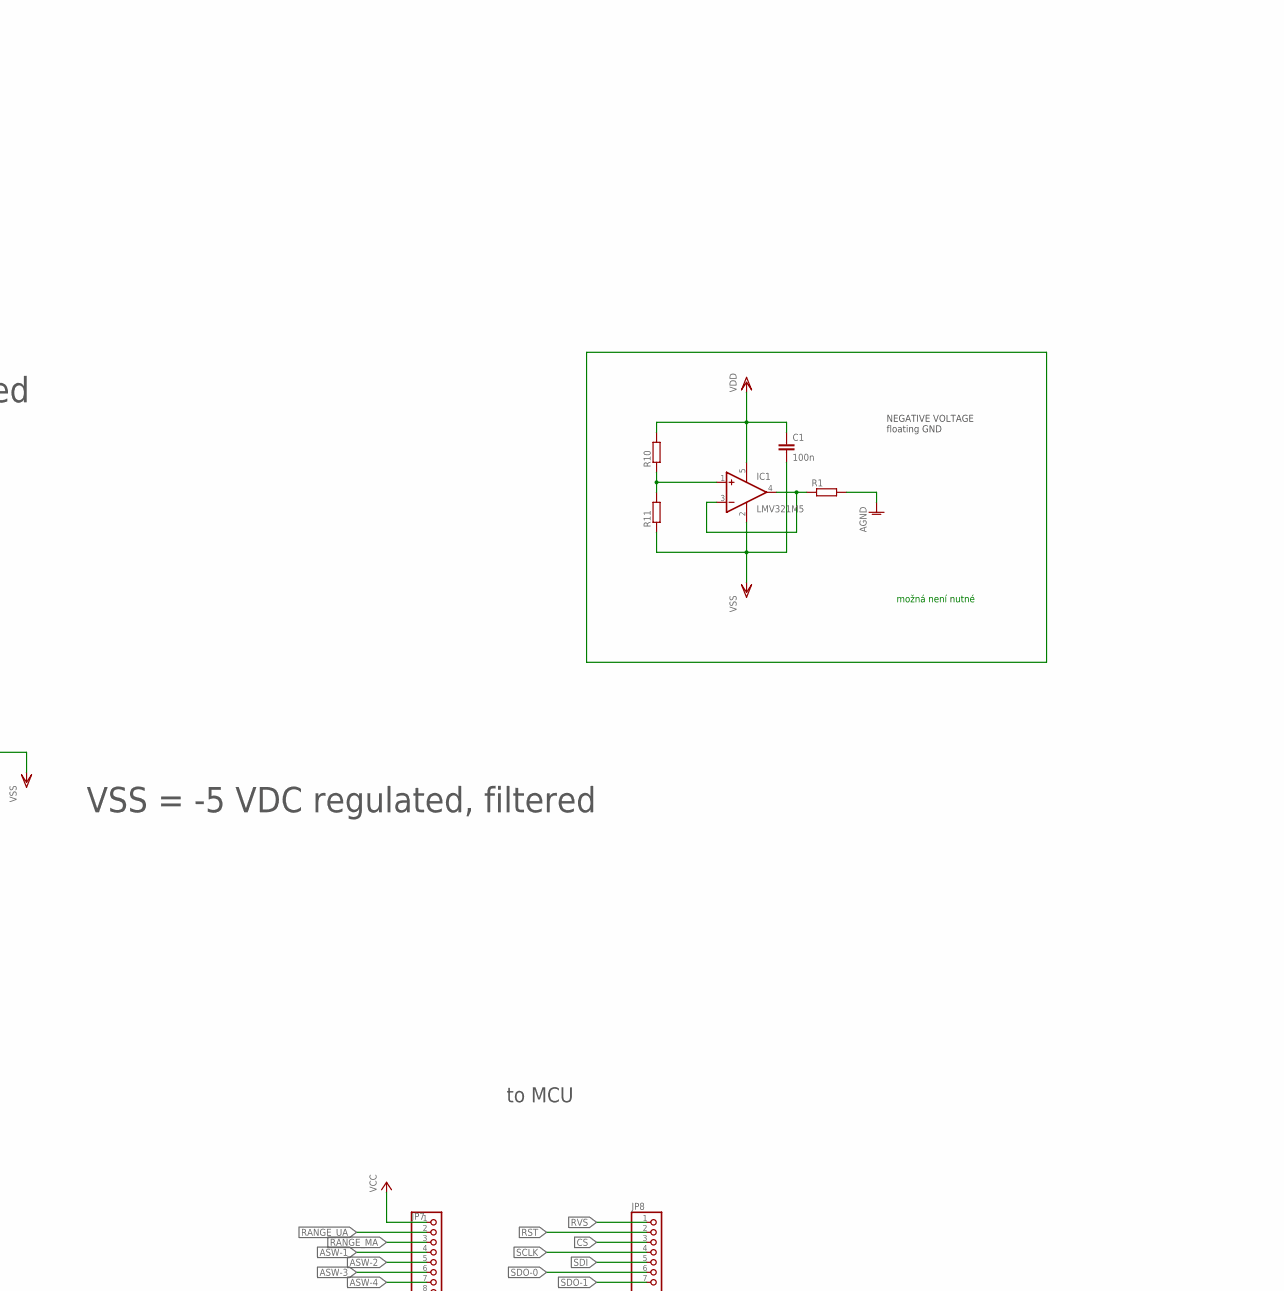
[picture p82: schematic DP_current_measure_v1.sch, part in row 1, column 2]

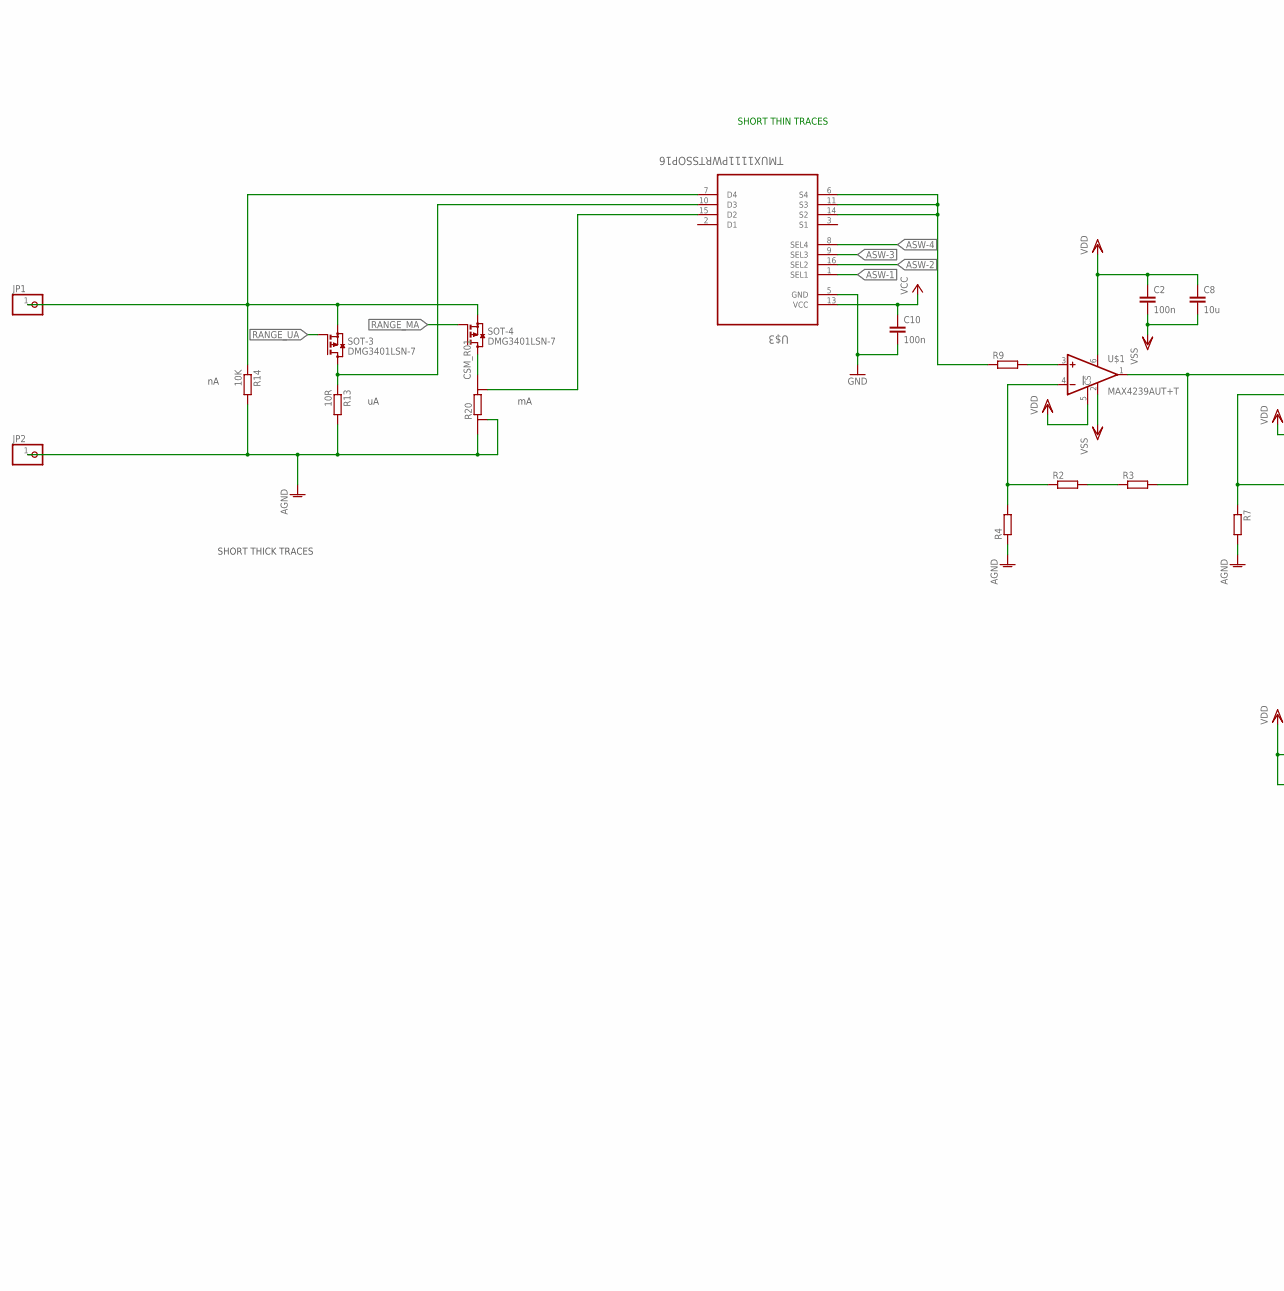
[picture p83: schematic DP_current_measure_v1.sch, part in row 2, column 1]

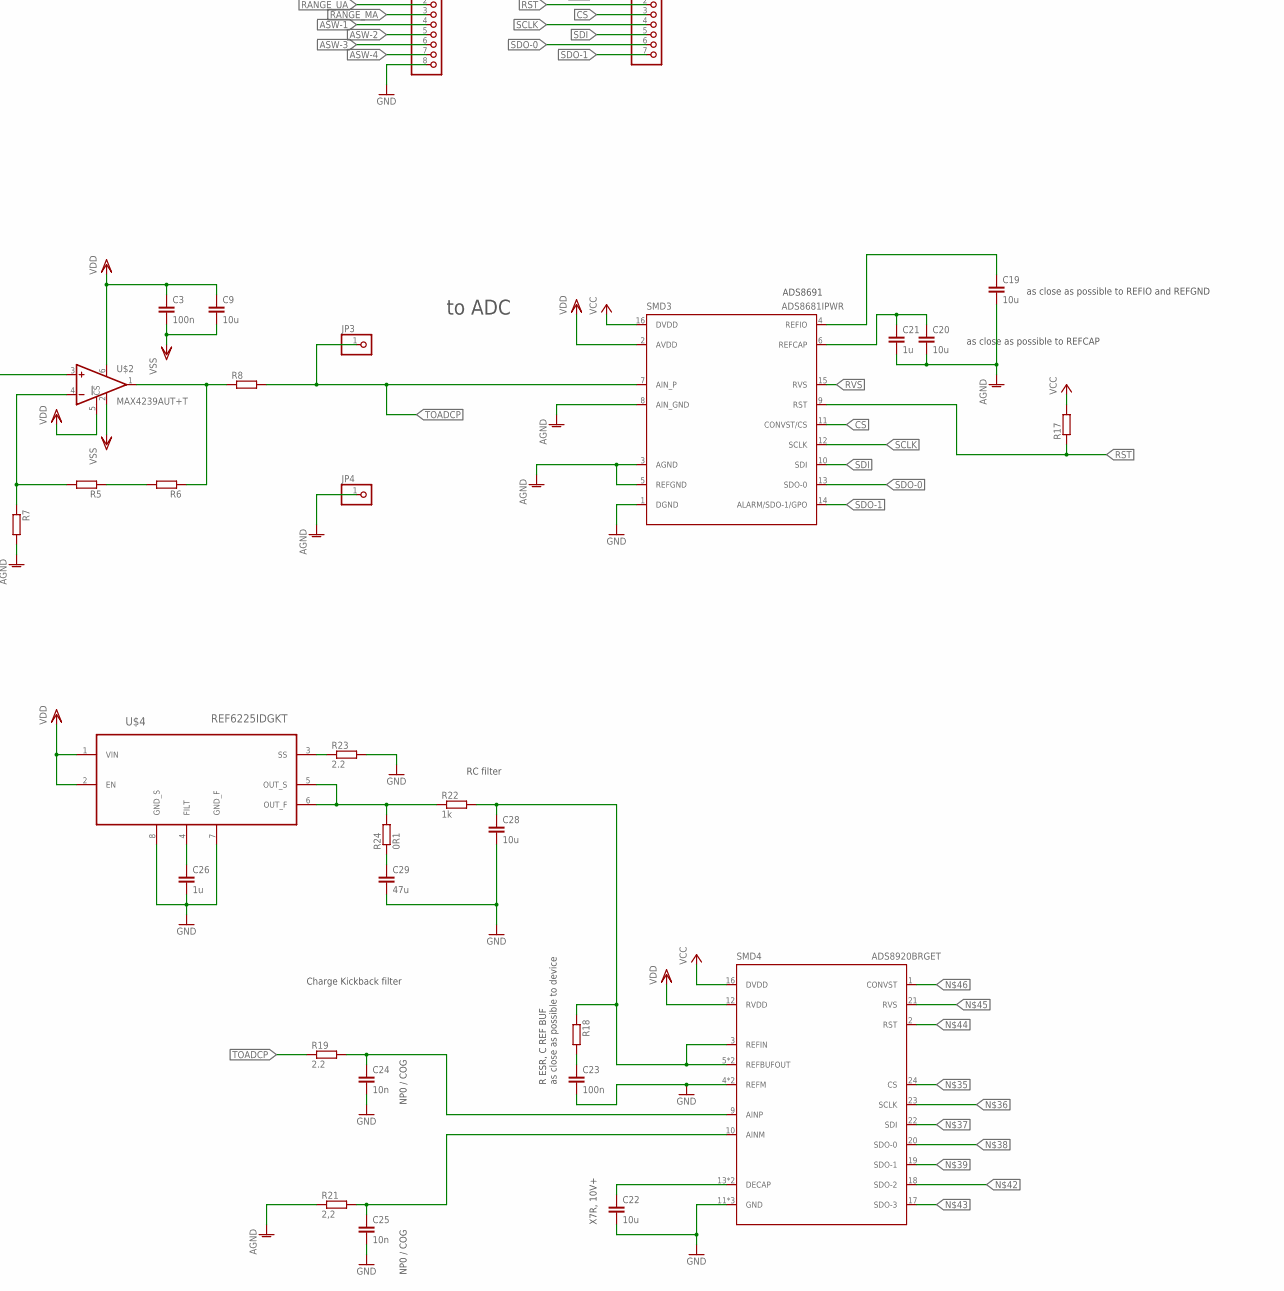
[picture p84: schematic DP_current_measure_v1.sch, part in row 2, column 2]

Parts:
C1, C2, C3, C7, C10, C23: 100n; C0805
C4, C5, C8, C9, C13, C16, C19, C20, C22, C28: 10u; C1206
C6, C11, C12: C-EUC1206; C1206
C14, C17, C18: 10u; SMC_B
C15: 10u-100u; SMC_B
C21: 1u; C0805
C24, C25: 10n; C0805
C26: 1u; C1206
C29: 47u; C1206
IC1: LMV321M5; SOT23-5
JP1, JP2, JP3, JP4, JP5, JP6: PINHD-1X1; 1X01
JP7: PINHD-1X8; 1X08
JP8: PINHD-1X7; 1X07
R1, R2, R3, R4, R5, R6, R7, R8, R9, R10, R11, R12, R17, R18: R-EU_R0805; R0805
R13: 10R; R0805
R14: 10K; R0805
R15, R16: 1K; R0805
R19, R23: 2.2; R0805
R20: CSM_R01; R2512
R21: 2,2; R0805
R22: 1k; R0805
R24: 0R1; R0805
SJ1: SJ
SMD1: PHPT60603NYX; TO127P600X120-5N
SMD2: PHPT60603PYX; TO127P600X120-5N
SMD3: ADS8681IPWR; SOP65P640X120-16N
SMD4: ADS8920BRGET; BQ24195RGER
SOT-3, SOT-4: DMG3401LSN-7; SOT23
U1: ICL7660CSAT; SOIC127P600X175-8N
U2: AMS1117-5.0; SOT229P700X180-4N
U3: L79L05ACD; SOIC127P600X175-8N
U$1, U$2: MAX4239AUT+T; SOT23-6
U$3: TMUX1111PWRTSSOP16; SOP65P640X110-16N
U$4: REF6225IDGKT; SOP65P640X120-16N

Connections:
+9V: JP5.1
+12V: C7.1, R15.1, SMD1.5 (C), U1.8 (V+)
-12V: C17.-, SMD2.1 (E), SMD2.2 (E), SMD2.3 (E), U3.2 (VIN_2), U3.3 (VIN_3), U3.6 (VIN), U3.7 (VIN_4)
AGND: C5.2, C6.2, C7.2, C11.2, C12.2, C13.2, C14.-, C16.2, C17.+, C18.+, C19.2, C20.2, C21.2, JP2.1, JP4.1, JP6.1, R1.2, R4.1, R7.2, R12.2, R13.2, R14.2, R20.E1, R20.I1, R21.1, SJ1.1, SMD3.3 (AGND), SMD3.5 (REFGND), SMD3.8 (AIN_GND), U1.3 (GND), U2.1 (ADJ/GND), U3.5 (GND)
ASW-1: JP7.4, U$3.1 (SEL1)
ASW-2: JP7.5, U$3.16 (SEL2)
ASW-3: JP7.6, U$3.9 (SEL3)
ASW-4: JP7.7, U$3.8 (SEL4)
CS: JP8.3, SMD3.11 (CONVST/CS)
GND: C10.2, C22.2, C23.2, C24.2, C25.2, C26.2, C28.2, C29.2, JP7.8, R23.2, SMD3.1 (DGND), SMD4.4 (REFM), SMD4.8 (REFM), SMD4.11 (GND), SMD4.15 (GND), SMD4.25 (GND), U$3.5 (GND), U$4.7 (GND_F), U$4.8 (GND_S)
unnamed: R6.1, R8.1, U$2.1 (OUT)
unnamed: R5.1, R6.2
unnamed: R5.2, R7.1, U$2.4 (-IN)
unnamed: R2.2, R3.1
unnamed: R3.2, U$1.1 (OUT), U$2.3 (+IN)
unnamed: R9.2, U$1.3 (+IN)
unnamed: R2.1, R4.2, U$1.4 (-IN)
unnamed: R13.1, SOT-3.3 (D), U$3.10 (D3)
unnamed: IC1.3 (-IN), IC1.4 (OUT), R1.1
unnamed: IC1.1 (+IN), R10.1, R11.2
unnamed: JP1.1, R14.1, SOT-3.2 (S), SOT-4.2 (S), U$3.7 (D4)
unnamed: R22.1, R24.2, U$4.5 (OUT_S), U$4.6 (OUT_F)
unnamed: R20.E2, U$3.15 (D2)
unnamed: R9.1, U$3.6 (S4), U$3.11 (S3), U$3.14 (S2)
unnamed: C4.2, U1.4 (CAP-)
unnamed: R20.I2, SOT-4.3 (D)
unnamed: C4.1, U1.2 (CAP+)
unnamed: C6.1, U1.7 (OSC)
unnamed: C15.-, R12.1
unnamed: SJ1.2, U1.6 (LV)
unnamed: C12.1, C14.+, SMD1.1 (E), SMD1.2 (E), SMD1.3 (E), U2.3 (VIN)
unnamed: C13.1, R15.2, SMD1.4 (B)
unnamed: C5.1, R16.1, SMD2.5 (C), U1.5 (VOUT)
unnamed: C16.1, R16.2, SMD2.4 (B)
unnamed: C23.1, R18.2
unnamed: C24.1, R19.2, SMD4.9 (AINP)
unnamed: C28.1, R18.1, R22.2, SMD4.3 (REFIN), SMD4.5 (REFBUFOUT), SMD4.7 (REFBUFOUT)
unnamed: C29.1, R24.1
unnamed: C26.1, U$4.4 (FILT)
unnamed: C25.1, R21.2, SMD4.10 (AINM)
unnamed: C22.1, SMD4.13 (DECAP), SMD4.14 (DECAP)
unnamed: R23.1, U$4.3 (SS)
unnamed: C20.1, C21.1, SMD3.6 (REFCAP)
unnamed: C19.1, SMD3.4 (REFIO)
RANGE_MA: JP7.3, SOT-4.1 (G)
RANGE_UA: JP7.2, SOT-3.1 (G)
RST: JP8.2, R17.1, SMD3.9 (RST)
RVS: JP8.1, SMD3.15 (RVS)
SCLK: JP8.4, SMD3.12 (SCLK)
SDI: JP8.5, SMD3.10 (SDI)
SDO-0: JP8.6, SMD3.13 (SDO-0)
SDO-1: JP8.7, SMD3.14 (ALARM/SDO-1/GPO)
TOADCP: JP3.1, R8.2, R19.1, SMD3.7 (AIN_P)
VCC: C10.1, JP7.1, R17.2, SMD3.16 (DVDD), SMD4.16 (DVDD), U$3.13 (VCC)
VDD: C1.1, C2.1, C3.1, C8.1, C9.1, C11.1, C15.+, IC1.5 (V+), R10.2, SMD3.2 (AVDD), SMD4.12 (RVDD), U2.2 (VOUT), U2.4 (VOUT), U$1.5 (!CS), U$1.6 (V+), U$2.5 (!CS), U$2.6 (V+), U$4.1 (VIN), U$4.2 (EN)
VSS: C1.2, C2.2, C3.2, C8.2, C9.2, C18.-, IC1.2 (V-), R11.1, U3.1 (VOUT), U$1.2 (V-), U$2.2 (V-)

Notes on the sheet:
NEGATIVE VOLTAGE floating GND
možná není nutné
SHORT THICK TRACES
SHORT THIN TRACES
unregulated SUPPLY IN
for supply voltage lower than 3,5V
NEGATIVE VOLTAGE Charge pump, fosc = 10 kHz
to MCU
to ADC
tantal
ESR
f=1/(2piRC) ----> 15,9 Hz
+ 9VDC max / - 9 VDC max
VDD = +5 VDC regulated, filtered
VSS = -5 VDC regulated, filtered
as close as possible to REFIO and REFGND
as close as possible to REFCAP
X7R, 10V+
R ESR, C REF BUF as close as possible to device
NP0 / COG
Charge Kickback filter
ADS8691
RC filter

Board: 2 copper layers, 75 parts (0 on the bottom side), 55 nets, no tracks yet.
