Crinst/LPWAN-current-logger-device/eagle/v1_v2/DP_current_measure_v2.brd

## EAGLE design eagle/v1_v2/DP_current_measure_v2.brd (2026-08-03)

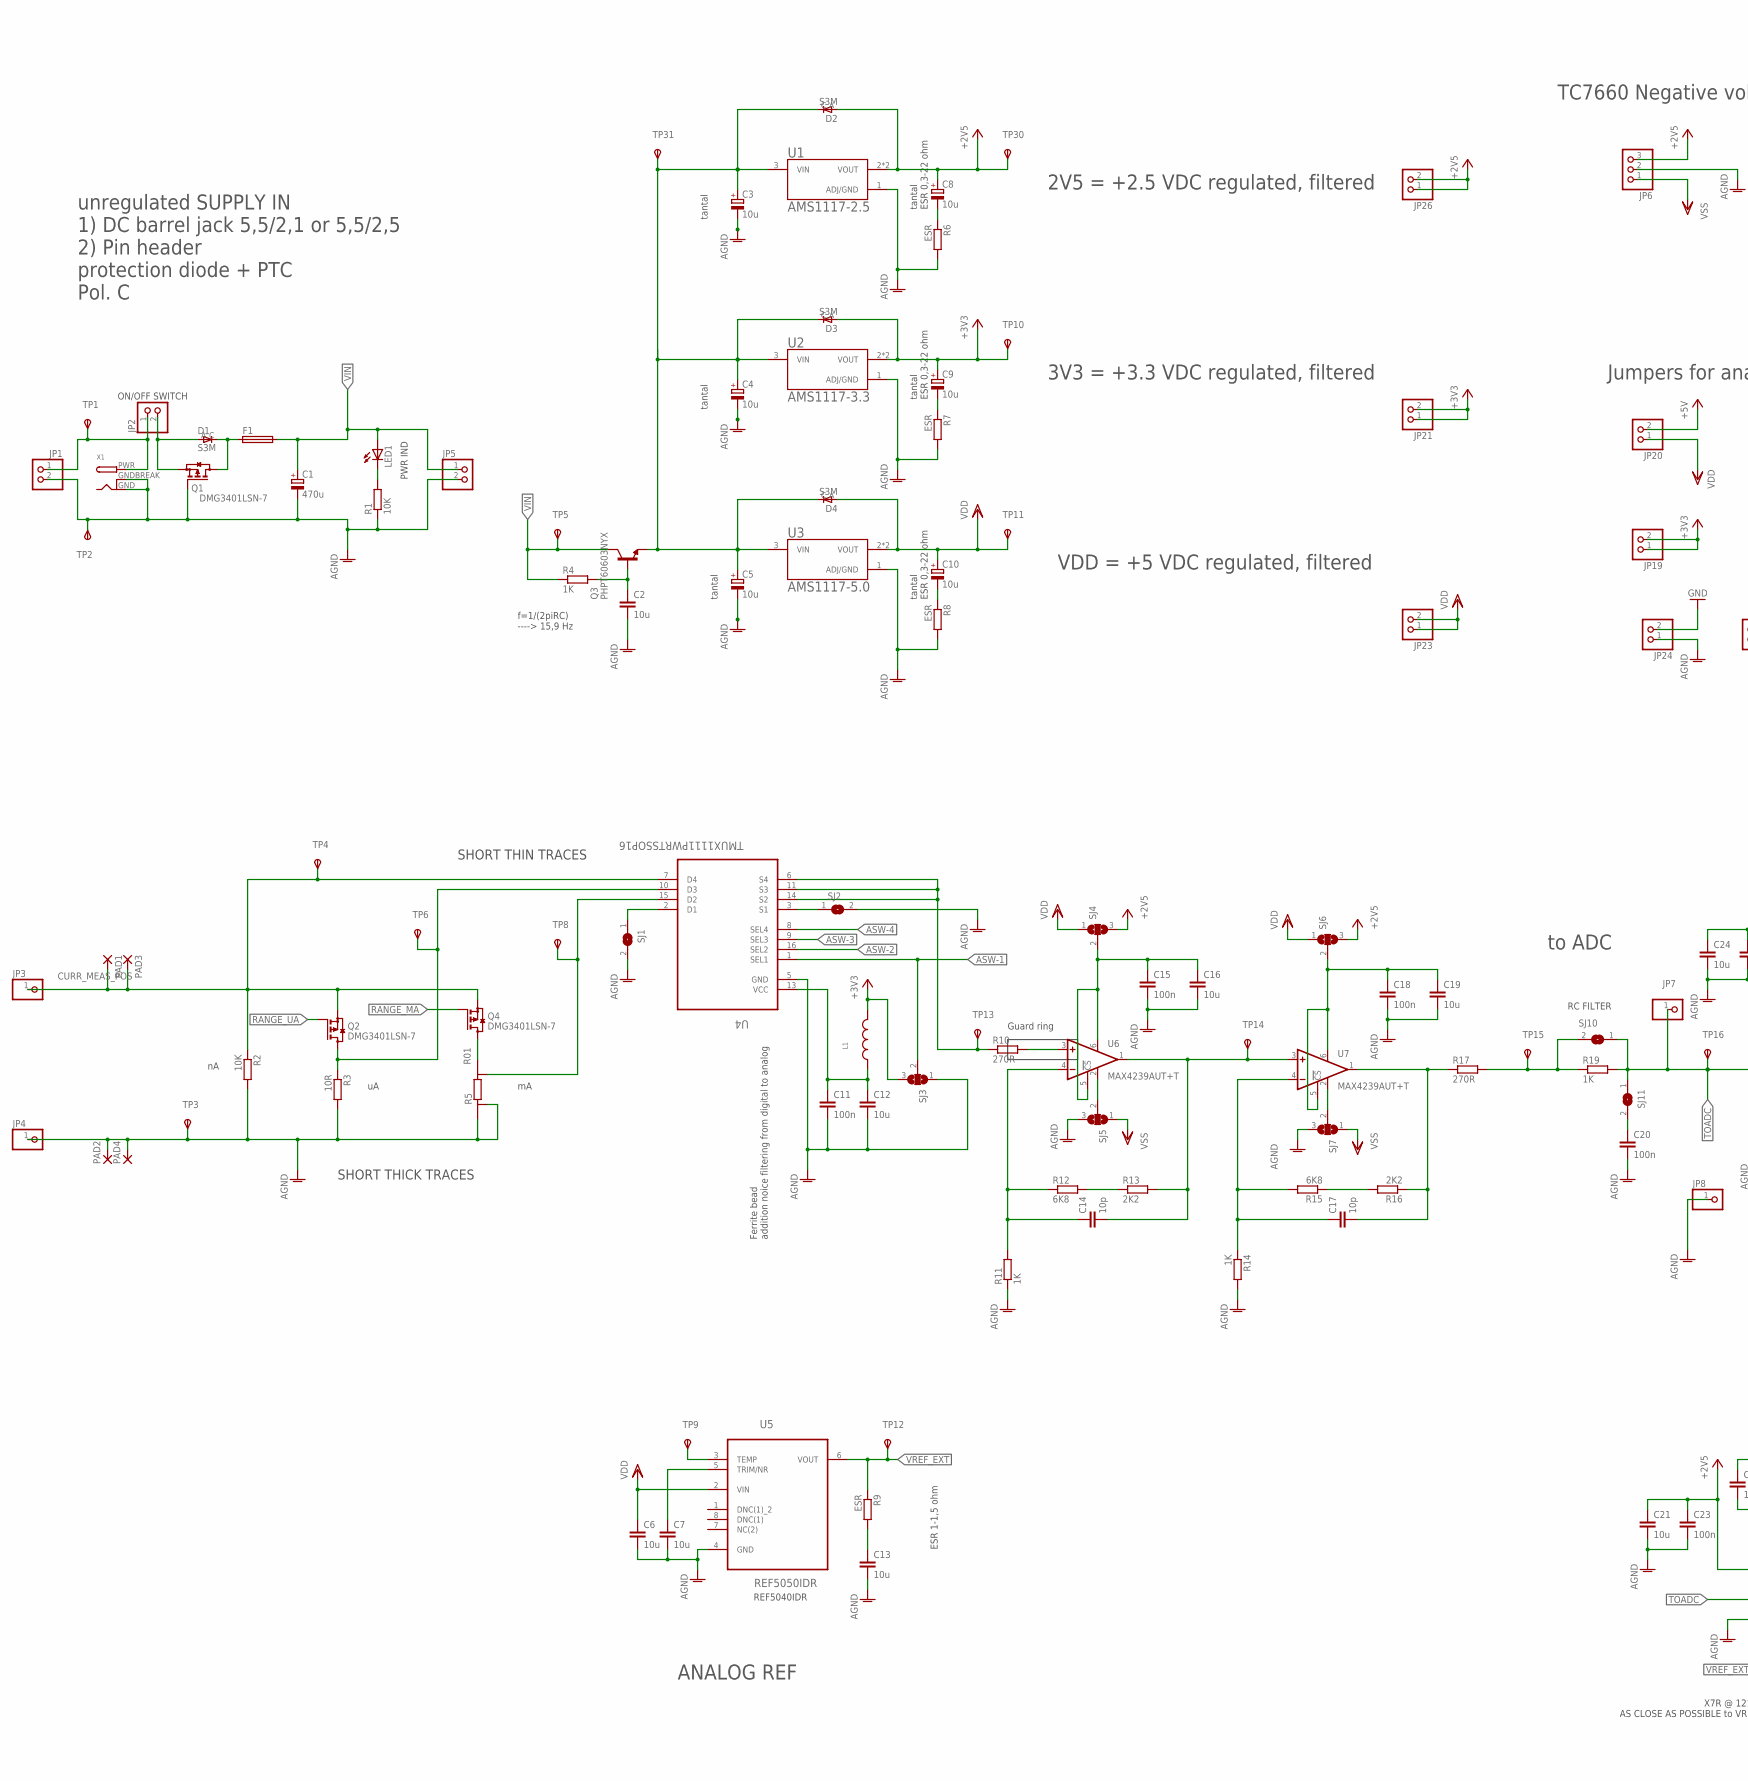
[picture p85: schematic DP_current_measure_v2.sch, part in row 1, column 1]

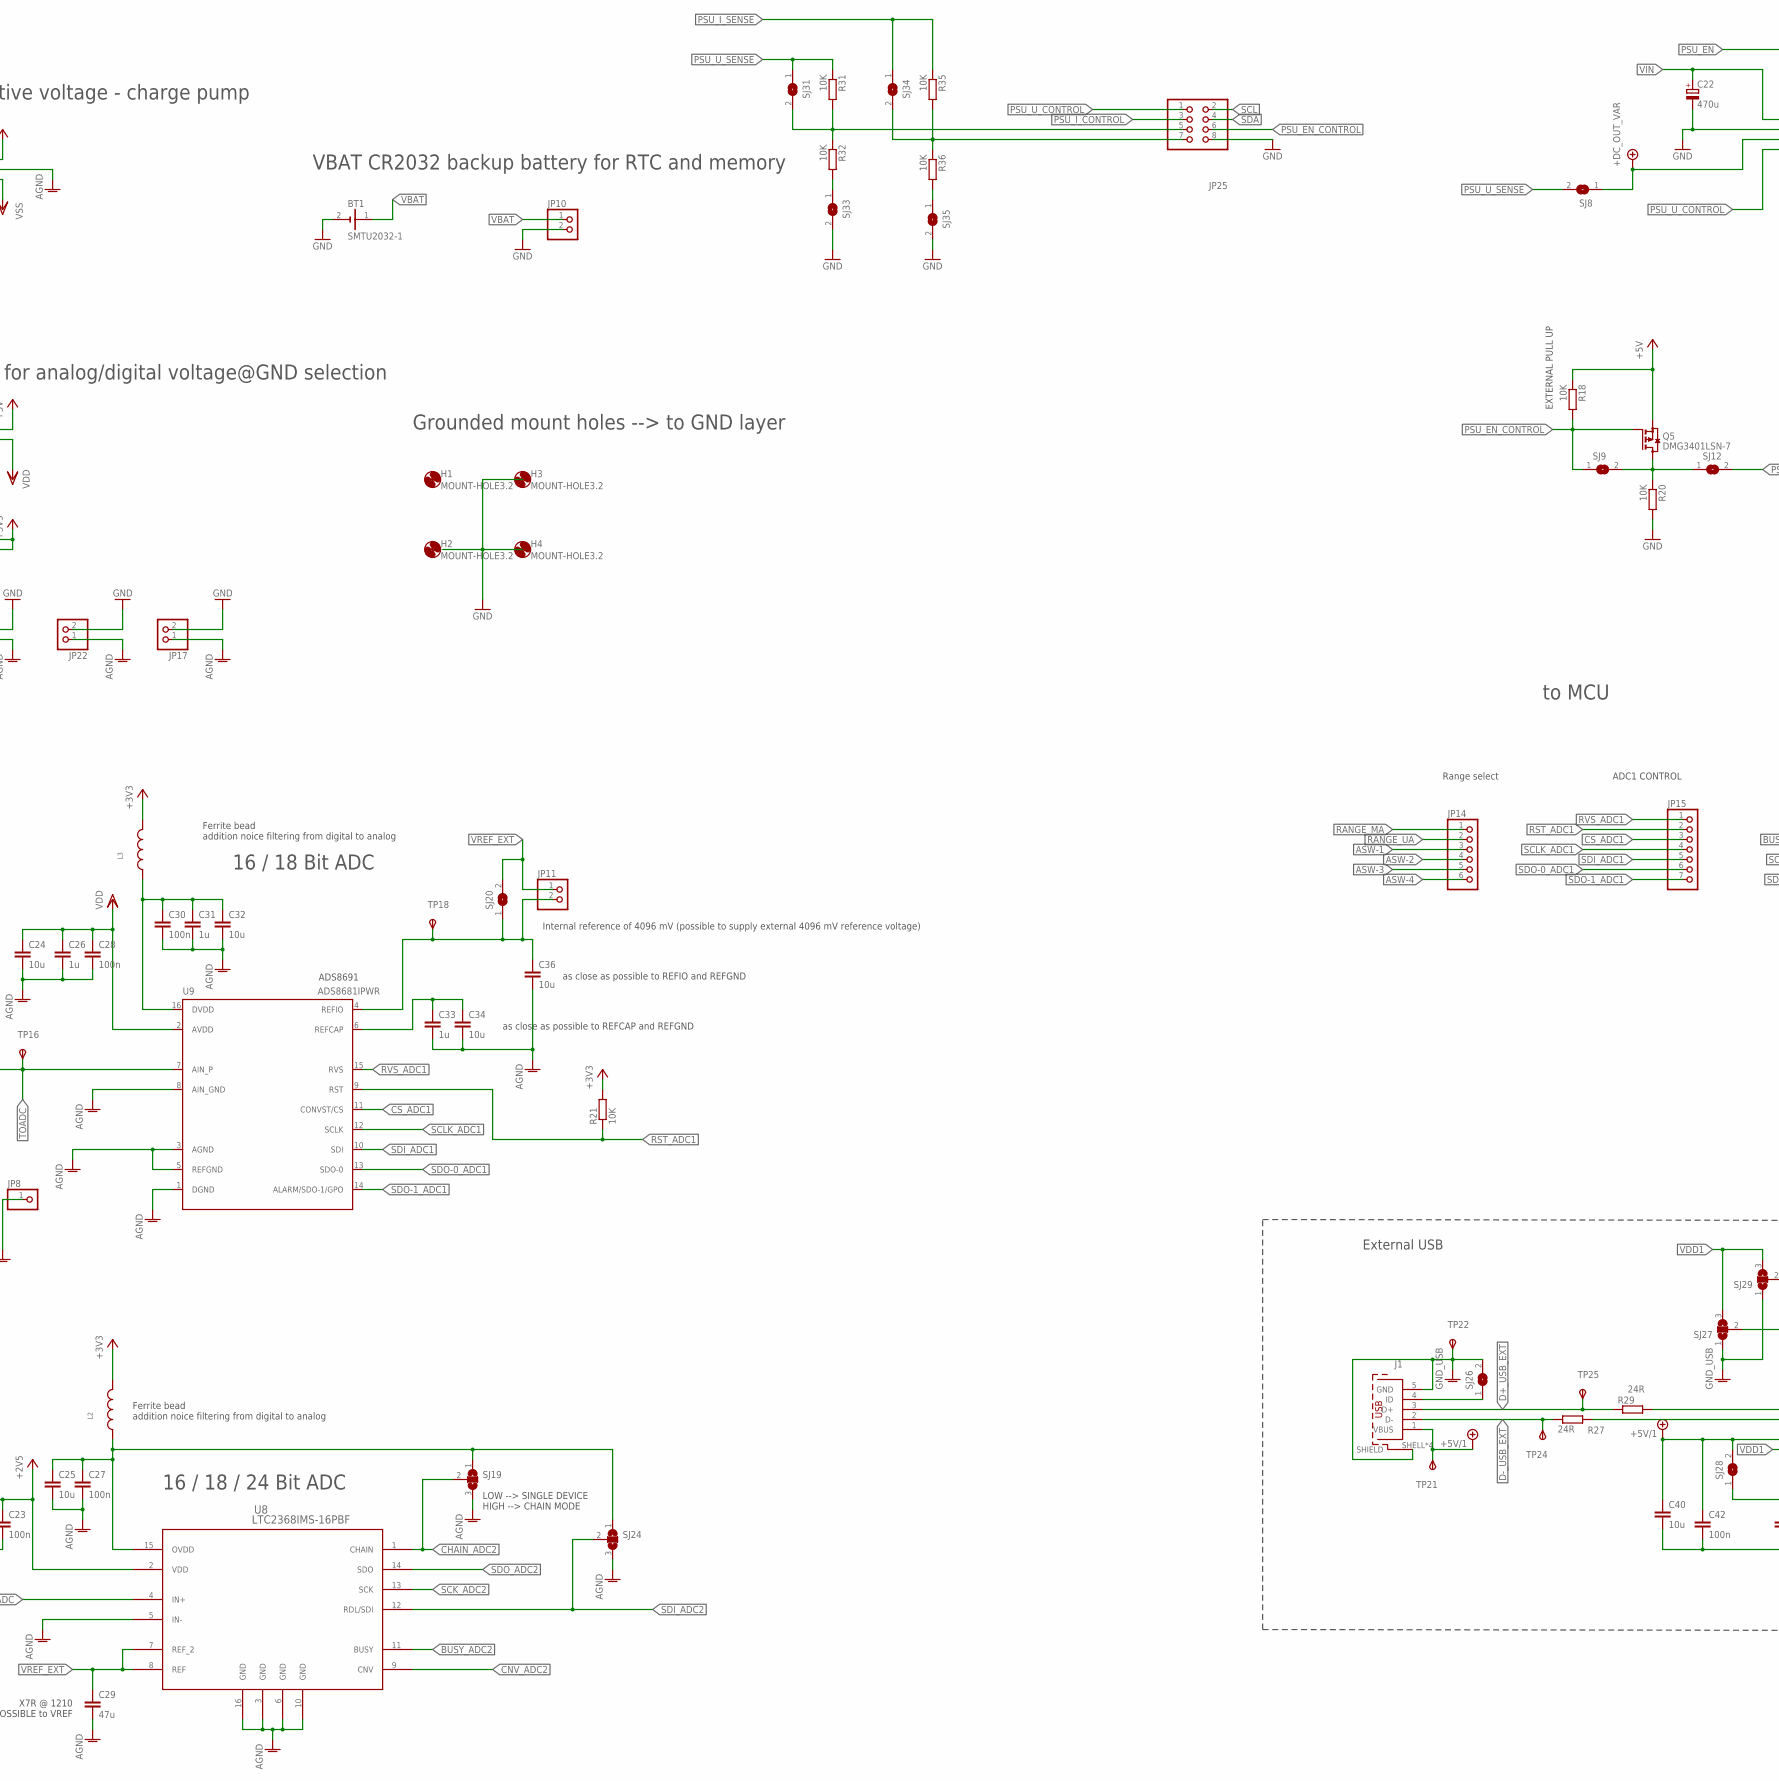
[picture p86: schematic DP_current_measure_v2.sch, part in row 1, column 2]

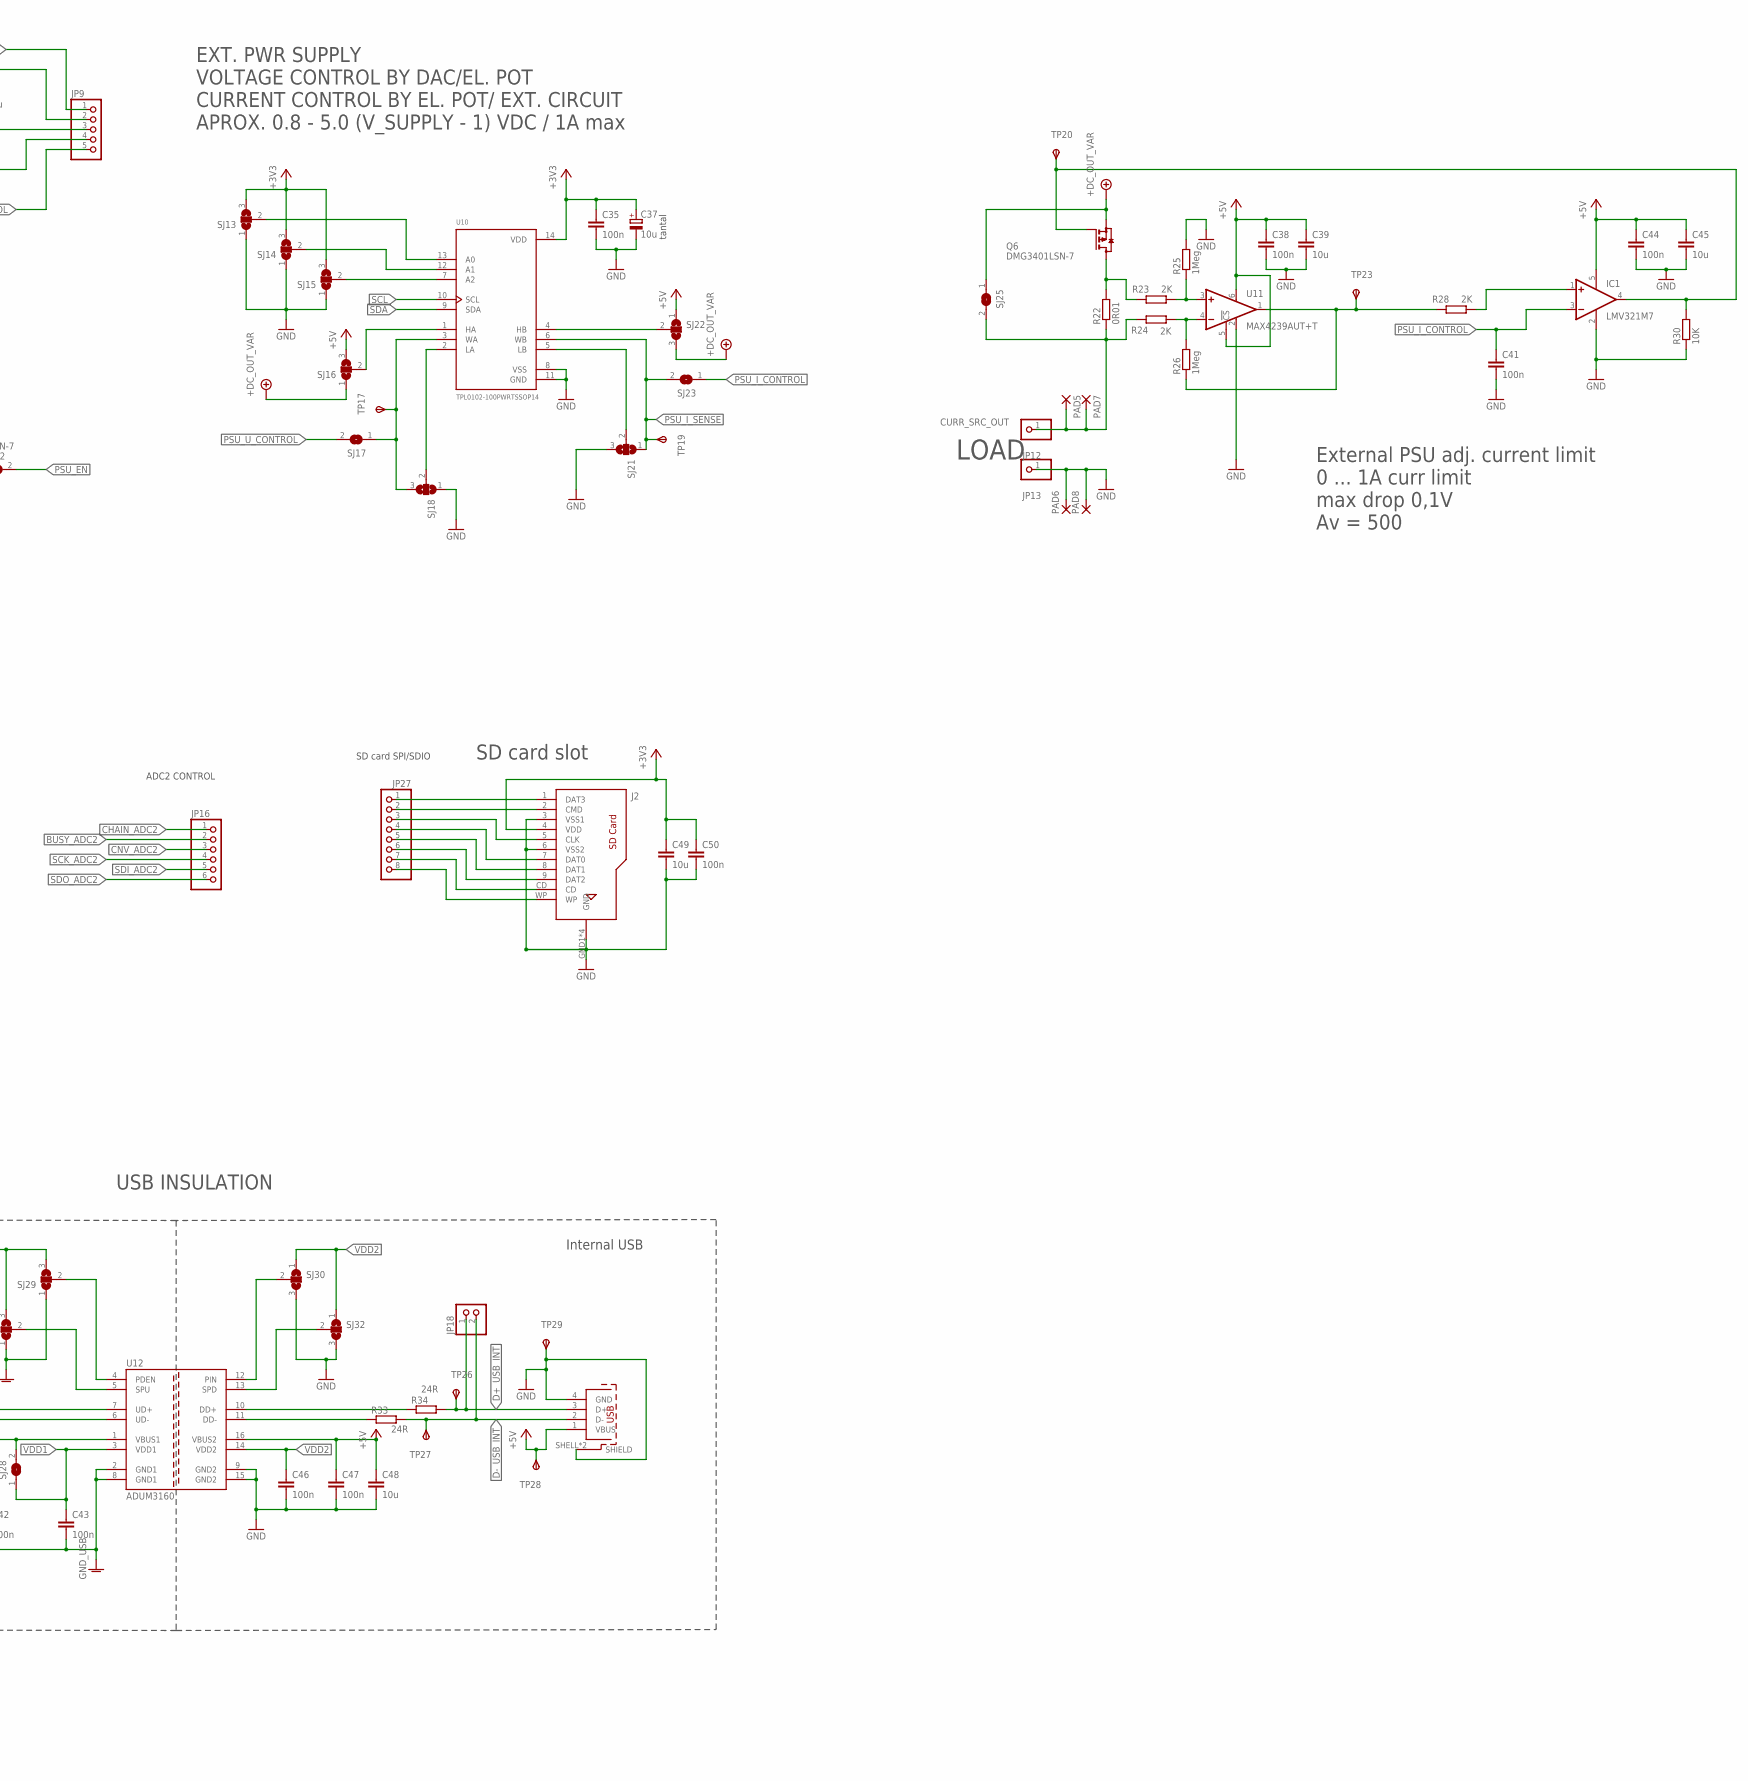
[picture p87: schematic DP_current_measure_v2.sch, part in row 1, column 3]

Parts:
BT1: SMTU2032-1; RENATA_SMTU2032-1
C1, C22: 470u; PANASONIC_G
C2, C6, C7, C12, C13, C16, C19, C21, C24, C25, C32, C34, C36, C39, C40, C45, C48, C49: 10u; C1206
C3, C4, C5, C8, C9, C10, C37: 10u; SMC_B
C11, C15, C18, C23, C27, C28, C30, C35, C38, C41, C42, C43, C44, C46, C47, C50: 100n; C0805
C14, C17: 10p; C0805
C20: 100n; C1206
C26, C31, C33: 1u; C0805
C29: 47u; C1210
D1, D2, D3, D4: S3M; DO214AC
F1: MF-MSMF050-2; 1812
H1, H2, H3, H4: MOUNT-HOLE3.2; 3,2
IC1: LMV321M7; SC70-5L
J1: 629105150521
J2: 693063020911
J3: 614004185023
JP1, JP2, JP5, JP10, JP11, JP17, JP18, JP19, JP20, JP21, JP22, JP23, JP24, JP26: PINHD-1X2; 1X02
JP3, JP4, JP7, JP8, JP12, JP13: PINHD-1X1; 1X01
JP6: PINHD-1X3; 1X03
JP9: PSU_STEP_DOWN; 1X05
JP14, JP16: PINHD-1X6; 1X06
JP15: PINHD-1X7; 1X07
JP25: PINHD-2X4; 2X04
JP27: PINHD-1X8; 1X08
L1, L2, L3: WE-CBF_0805_742792036_WB_HS; WE-CBF_0805(W=3.0)
LED1: LEDCHIPLED_0805; CHIPLED_0805
PAD1, PAD2, PAD3, PAD4, PAD5, PAD6, PAD7, PAD8: WIREPADSMD2,54-5,08; SMD2,54-5,08
Q1, Q2, Q4, Q5, Q6: DMG3401LSN-7; SOT23
Q3: PHPT60603NYX; TO127P600X120-5N
R1, R2, R18, R20, R21, R30, R31, R32, R35, R36: 10K; R0805
R3: 10R; R0805
R4, R11, R14, R19: 1K; R0805
R5: R01; R2512
R6, R7, R8, R9: ESR; R0805
R10, R17: 270R; R0805
R12, R15: 6K8; R0805
R13, R16: 2K2; R0805
R22: 0R01; R0805
R23, R24, R28: 2K; R0805
R25, R26: 1Meg; R0805
R27, R29, R33, R34: 24R; R0805
SJ1, SJ2, SJ8, SJ9, SJ10, SJ11, SJ12, SJ17, SJ20, SJ23, SJ25, SJ26, SJ28, SJ31, SJ33, SJ34, SJ35: SJ
SJ3, SJ4, SJ5, SJ6, SJ7, SJ13, SJ14, SJ15, SJ16, SJ18, SJ19, SJ21, SJ22, SJ24, SJ27, SJ29, SJ30, SJ32: SJ2W; SJ_2
TP1, TP2, TP3, TP4, TP5, TP6, TP8, TP9, TP10, TP11, TP12, TP13, TP14, TP15, TP16, TP17, TP18, TP19, TP20, TP21, TP22, TP23, TP24, TP25, TP26, TP27, TP28, TP29, TP30, TP31: TPSB1,27; B1,27
U1: AMS1117-2.5; SOT229P700X180-4N
U2: AMS1117-3.3; SOT229P700X180-4N
U3: AMS1117-5.0; SOT229P700X180-4N
U4: TMUX1111PWRTSSOP16; SOP65P640X110-16N
U5: REF5050IDR; SOIC127P600X175-8N
U6, U7, U11: MAX4239AUT+T; SOT23-6
U8: LTC2368IMS-16PBF; MSOP-16_MS
U9: ADS8681IPWR; SOP65P640X120-16N
U10: TPL0102-100PWRTSSOP14; SOP65P640X120-14N
U12: ADUM3160; SO16W
X1: DCBARRELPTH; DCJACK_2MM_PTH

Connections:
+2V5: C8.+, C21.1, C23.1, D2.A, JP6.3, JP26.1, JP26.2, SJ4.3, SJ6.3, TP30.TP, U1.2 (VOUT), U1.4 (VOUT), U8.2 (VDD)
+3V3: C9.+, C35.1, C37.+, C49.1, C50.1, D3.A, J2.4 (VDD), JP19.1, JP19.2, JP21.1, JP21.2, L1.2, L2.2, L3.2, R21.2, SJ3.3, SJ13.3, SJ14.3, SJ15.3, TP10.TP, U2.2 (VOUT), U2.4 (VOUT), U10.14 (VDD)
+5V: C38.1, C39.1, C44.1, C45.1, C47.1, C48.1, IC1.5 (V+), J3.1 (VBUS), JP20.2, Q5.2 (S), R18.1, SJ16.3, SJ22.1, TP28.TP, U11.5 (!CS), U11.6 (V+), U12.16 (VBUS2)
+5V/1: C40.1, C42.1, J1.1 (VBUS), SJ28.2, TP21.TP, U12.1 (VBUS1)
AGND: C1.-, C2.2, C3.-, C4.-, C5.-, C6.2, C7.2, C11.2, C12.2, C13.2, C15.2, C16.2, C18.2, C19.2, C20.2, C21.2, C23.2, C24.2, C25.2, C26.2, C27.2, C28.2, C29.2, C30.2, C31.2, C32.2, C33.2, C34.2, C36.2, JP1.2, JP4.1, JP5.2, JP6.2, JP8.1, JP17.1, JP22.1, JP24.1, PAD2.1, PAD4.1, Q1.1 (G), R1.1, R2.2, R3.2, R5.E1, R5.I1, R6.2, R7.2, R8.2, R11.1, R14.2, SJ1.2, SJ2.2, SJ3.1, SJ5.3, SJ7.3, SJ19.3, SJ24.3, TP2.TP, TP3.TP, U1.1 (ADJ/GND), U2.1 (ADJ/GND), U3.1 (ADJ/GND), U4.5 (GND), U5.4 (GND), U8.3 (GND), U8.5 (IN-), U8.6 (GND), U8.10 (GND), U8.16 (GND), U9.1 (DGND), U9.3 (AGND), U9.5 (REFGND), U9.8 (AIN_GND), X1.GND, X1.GNDBREAK
ASW-1: JP14.3, SJ3.2, U4.1 (SEL1)
ASW-2: JP14.4, U4.16 (SEL2)
ASW-3: JP14.5, U4.9 (SEL3)
ASW-4: JP14.6, U4.8 (SEL4)
BUSY_ADC2: JP16.2, U8.11 (BUSY)
CHAIN_ADC2: JP16.1, SJ19.2, U8.1 (CHAIN)
CNV_ADC2: JP16.3, U8.9 (CNV)
CS_ADC1: JP15.3, U9.11 (CONVST/CS)
CURR_MEAS_POS: JP3.1, PAD1.1, PAD3.1, Q2.2 (S), Q4.2 (S), R2.1, TP4.TP, U4.7 (D4)
CURR_SRC_OUT: JP12.1, PAD5.1, PAD7.1, R22.1, R24.1, SJ25.2
D+_USB_EXT: J1.3 (D+), R29.1, TP25.TP
D+_USB_INT: J3.3 (D+), JP18.1, R34.2, TP26.TP
D-_USB_EXT: J1.2 (D-), R27.1, TP24.TP
D-_USB_INT: J3.2 (D-), JP18.2, R33.2, TP27.TP
DC_OUT_VAR: JP9.4, Q6.2 (S), SJ8.1, SJ16.1, SJ22.3, SJ25.1
GND: BT1.2 (-), C22.-, C35.2, C37.-, C38.2, C39.2, C41.2, C44.2, C45.2, C46.2, C47.2, C48.2, C49.2, C50.2, IC1.2 (V-), J2.3 (VSS1), J2.6 (VSS2), J2.GND1 (GND), J2.GND2 (GND), J2.GND3 (GND), J2.GND4 (GND), J3.4 (GND), J3.SHELL (SHIELD), J3.SHELL1 (SHIELD), JP9.3, JP10.2, JP13.1, JP17.2, JP22.2, JP24.2, JP25.8, PAD6.1, PAD8.1, R20.2, R25.2, R30.1, SJ13.1, SJ14.1, SJ15.1, SJ18.1, SJ21.3, SJ30.3, SJ32.3, SJ33.2, SJ35.2, TP29.TP, U10.8 (VSS), U10.11 (GND), U11.2 (V-), U12.9 (GND2), U12.15 (GND2)
GND_EXT: C40.2, C42.2, C43.2, J1.5 (GND), J1.SHELL (SHIELD), J1.SHELL1 (SHIELD), J1.SHELL2 (SHIELD), J1.SHELL3 (SHIELD), SJ26.2, SJ27.1, SJ29.1, TP22.TP, U12.2 (GND1), U12.8 (GND1)
MA_RANGE_SENSE: R5.E2, TP8.TP, U4.15 (D2)
unnamed: C17.2, R16.1, R17.1, U7.1 (OUT)
unnamed: R15.1, R16.2
unnamed: C17.1, R14.1, R15.2, U7.4 (-IN)
unnamed: R12.2, R13.1
unnamed: C14.2, R13.2, TP14.TP, U6.1 (OUT), U7.3 (+IN)
unnamed: R10.1, TP13.TP, U4.6 (S4), U4.11 (S3), U4.14 (S2)
unnamed: C14.1, R11.2, R12.1, U6.4 (-IN)
unnamed: C11.1, C12.1, L1.1, U4.13 (VCC)
unnamed: SJ16.2, U10.1 (HA)
unnamed: SJ17.1, SJ18.3, TP17.TP, U10.3 (WA)
unnamed: Q6.3 (D), R22.2, R23.1
unnamed: SJ15.2, U10.7 (A2)
unnamed: SJ7.2, U7.2 (V-)
unnamed: R10.2, U6.3 (+IN)
unnamed: C9.-, R7.1
unnamed: Q4.3 (D), R5.I2
unnamed: SJ5.2, U6.2 (V-)
unnamed: R17.2, R19.1, SJ10.2, TP15.TP
unnamed: C10.-, R8.1
unnamed: SJ13.2, U10.13 (A0)
unnamed: C8.-, R6.1
unnamed: C2.1, Q3.4 (B), R4.2
unnamed: C7.1, U5.5 (TRIM/NR)
unnamed: C20.1, SJ11.2
unnamed: SJ14.2, U10.12 (A1)
unnamed: JP25.7, R35.2, R36.1, SJ34.2
unnamed: JP25.5, R31.2, R32.1, SJ31.2
unnamed: R36.2, SJ35.1
unnamed: R32.2, SJ33.1
unnamed: R26.1, R28.1, TP23.TP, U11.1 (OUT)
unnamed: SJ22.2, U10.4 (HB)
unnamed: J1.4 (ID), SJ26.1
unnamed: R23.2, R25.1, U11.3 (+IN)
unnamed: SJ18.2, U10.2 (LA)
unnamed: IC1.4 (OUT), Q6.1 (G), R30.2, TP20.TP
unnamed: R24.2, R26.2, U11.4 (-IN)
unnamed: C18.1, C19.1, SJ6.2, U7.5 (!CS), U7.6 (V+)
unnamed: D1.C, F1.1, Q1.3 (D)
unnamed: C33.1, C34.1, U9.6 (REFCAP)
unnamed: C36.1, JP11.2, SJ20.1, TP18.TP, U9.4 (REFIO)
unnamed: D1.A, JP2.2, Q1.2 (S)
unnamed: R34.1, U12.10 (DD+)
unnamed: LED1.C, R1.2
unnamed: SJ21.2, U10.5 (LB)
unnamed: C15.1, C16.1, SJ4.2, U6.5 (!CS), U6.6 (V+)
unnamed: TP9.TP, U5.3 (TEMP)
unnamed: J2.1 (DAT3), JP27.1
unnamed: J2.2 (CMD), JP27.2
unnamed: J2.5 (CLK), JP27.3
unnamed: J2.7 (DAT0), JP27.4
unnamed: SJ30.2, U12.12 (PIN)
unnamed: SJ32.2, U12.13 (SPD)
unnamed: SJ27.2, U12.5 (SPU)
unnamed: SJ29.2, U12.4 (PDEN)
unnamed: SJ2.1, U4.3 (S1)
unnamed: SJ1.1, U4.2 (D1)
unnamed: J2.8 (DAT1), JP27.5
unnamed: C13.1, R9.2
unnamed: J2.9 (DAT2), JP27.6
unnamed: J2.CD, JP27.7
unnamed: J2.WP, JP27.8
unnamed: JP1.1, JP2.1, TP1.TP, X1.PWR
unnamed: C30.1, C31.1, C32.1, L3.1, U9.16 (DVDD)
unnamed: C25.1, C27.1, L2.1, SJ19.1, SJ24.1, U8.15 (OVDD)
OPAMP_LEADS: IC1.1 (+IN), R28.2
PSU_EN: JP9.1, SJ12.2
PSU_EN_CONTROL: JP25.6, Q5.1 (G), R18.2, SJ9.1
PSU_EN_LEAD: Q5.3 (D), R20.1, SJ9.2, SJ12.1
PSU_I_CONTROL: C41.1, IC1.3 (-IN), JP25.3, SJ23.1
PSU_I_SENSE: R35.1, SJ21.1, SJ23.2, SJ34.1, TP19.TP, U10.6 (WB)
PSU_U_CONTROL: JP9.5, JP25.1, SJ17.2
PSU_U_SENSE: R31.1, SJ8.2, SJ31.1
RANGE_MA: JP14.1, Q4.1 (G)
RANGE_UA: JP14.2, Q2.1 (G)
RST_ADC1: JP15.2, R21.1, U9.9 (RST)
RVS_ADC1: JP15.1, U9.15 (RVS)
SCK_ADC2: JP16.4, U8.13 (SCK)
SCL: JP25.2, U10.10 (SCL)
SCLK_ADC1: JP15.4, U9.12 (SCLK)
SDA: JP25.4, U10.9 (SDA)
SDI_ADC1: JP15.5, U9.10 (SDI)
SDI_ADC2: JP16.5, SJ24.2, U8.12 (RDL/SDI)
SDO-0_ADC1: JP15.6, U9.13 (SDO-0)
SDO-1_ADC1: JP15.7, U9.14 (ALARM/SDO-1/GPO)
SDO_ADC2: JP16.6, U8.14 (SDO)
TOADC: JP7.1, R19.2, SJ10.1, SJ11.1, TP16.TP, U8.4 (IN+), U9.7 (AIN_P)
UA_RANGE_SENSE: Q2.3 (D), R3.1, TP6.TP, U4.10 (D3)
USB_EXT_N: R27.2, U12.6 (UD-)
USB_EXT_P: R29.2, U12.7 (UD+)
USB_INT_N: R33.1, U12.11 (DD-)
VBAT: BT1.1 (+), JP10.1
VDD: C6.1, C10.+, C24.1, C26.1, C28.1, D4.A, JP20.1, JP23.1, JP23.2, SJ4.1, SJ6.1, TP11.TP, U3.2 (VOUT), U3.4 (VOUT), U5.2 (VIN), U9.2 (AVDD)
VDD1: C43.1, SJ27.3, SJ28.1, SJ29.3, U12.3 (VDD1)
VDD2: C46.1, SJ30.1, SJ32.1, U12.14 (VDD2)
VIN: C1.+, C22.+, F1.2, JP5.1, JP9.2, LED1.A, Q3.5 (C), R4.1, TP5.TP
VREF_EXT: C29.1, JP11.1, R9.1, SJ20.2, TP12.TP, U5.6 (VOUT), U8.7 (REF_2), U8.8 (REF)
VSS: JP6.1, SJ5.1, SJ7.1
V_FILTR_UNREG: C3.+, C4.+, C5.+, D2.C, D3.C, D4.C, Q3.1 (E), Q3.2 (E), Q3.3 (E), TP31.TP, U1.3 (VIN), U2.3 (VIN), U3.3 (VIN)

Notes on the sheet:
SHORT THICK TRACES
SHORT THIN TRACES
unregulated SUPPLY IN 1) DC barrel jack 5,5/2,1 or 5,5/2,5 2) Pin header protection diode + PTC Pol. C
to MCU
to ADC
tantal
tantal ESR 0,3-22 ohm
f=1/(2piRC) ----> 15,9 Hz
VDD = +5 VDC regulated, filtered
as close as possible to REFIO and REFGND
as close as possible to REFCAP and REFGND
ADS8691
3V3 = +3.3 VDC regulated, filtered
REF5040IDR
LOW --> SINGLE DEVICE HIGH --> CHAIN MODE
X7R @ 1210 AS CLOSE AS POSSIBLE to VREF
16 / 18 / 24 Bit ADC
16 / 18 Bit ADC
Internal reference of 4096 mV (possible to supply external 4096 mV reference voltage)
RC FILTER
ADC2 CONTROL
ADC1 CONTROL
EXT. PWR SUPPLY VOLTAGE CONTROL BY DAC/EL. POT CURRENT CONTROL BY EL. POT/ EXT. CIRCUIT APROX. 0.8 - 5.0 (V_SUPPLY - 1) VDC / 1A max
ANALOG REF
EXTERNAL PULL UP
LOAD
External PSU adj. current limit 0 ... 1A curr limit max drop 0,1V Av = 500
USB INSULATION
PWR IND
TC7660 Negative voltage - charge pump
VBAT CR2032 backup battery for RTC and memory
Guard ring
SD card slot
SD card SPI/SDIO
Range select
ESR 1-1,5 ohm
ON/OFF SWITCH
2V5 = +2.5 VDC regulated, filtered
External USB
Internal USB
Grounded mount holes --> to GND layer
Ferrite bead addition noice filtering from digital to analog
Jumpers for analog/digital voltage@GND selection

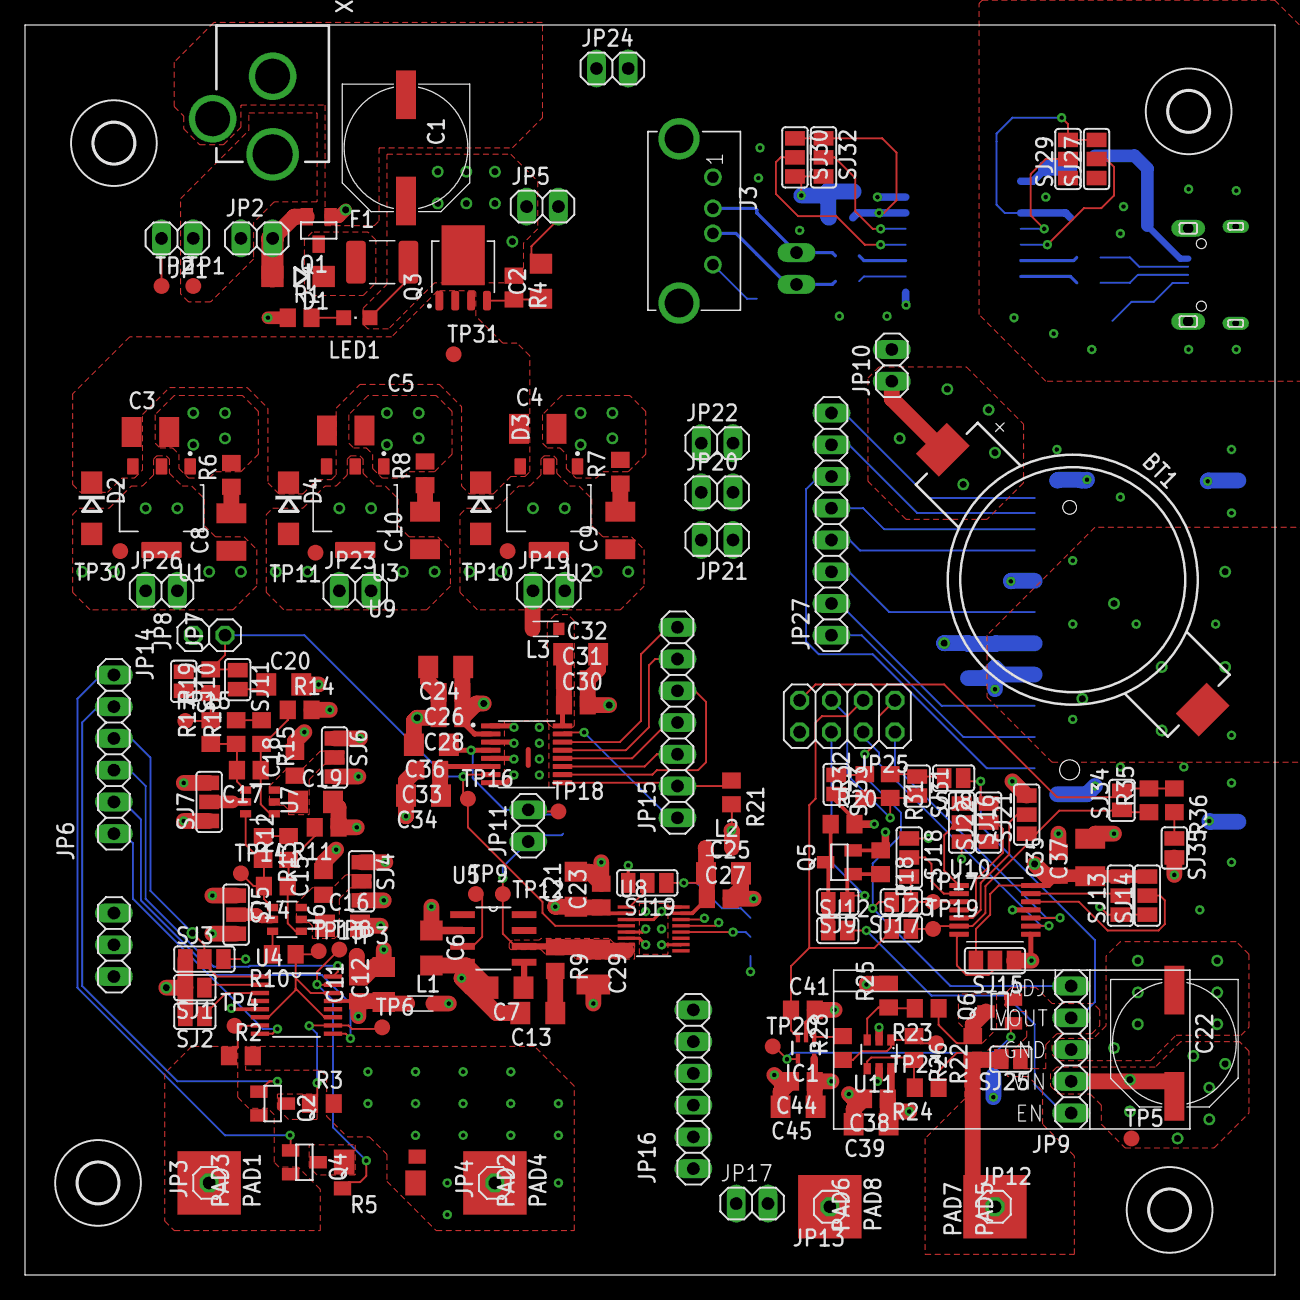
[picture p88: board DP_current_measure_v2.brd from above]

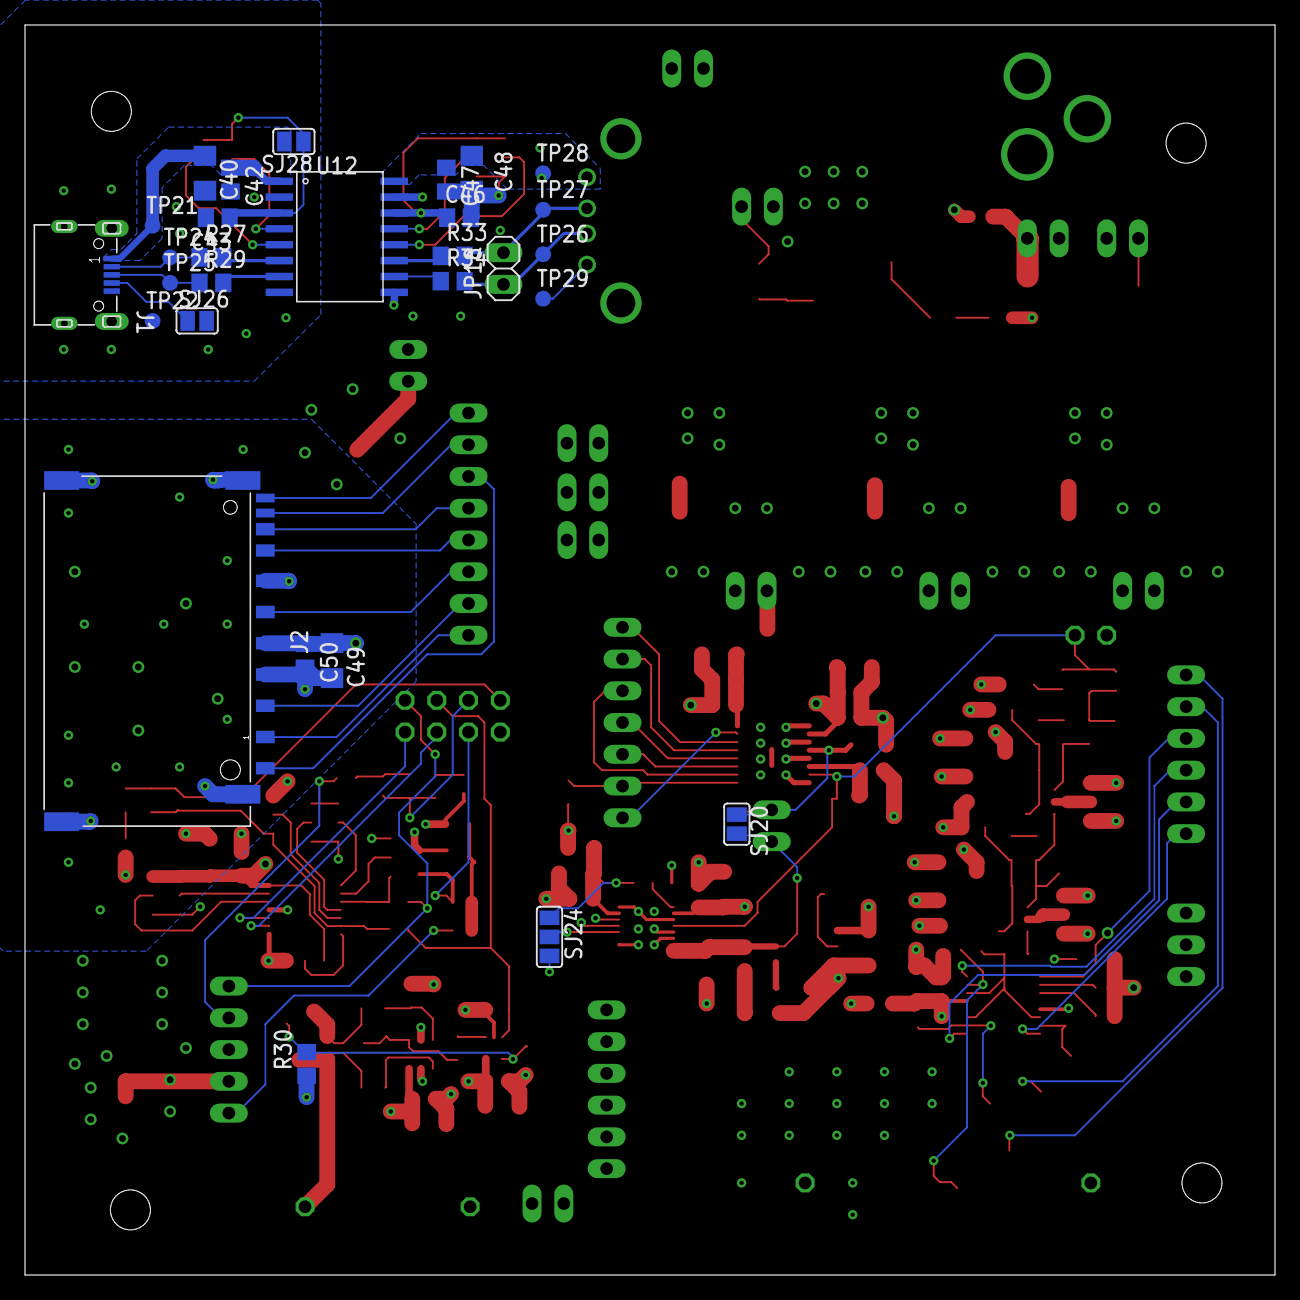
[picture p89: board DP_current_measure_v2.brd from below]

Board: 4 copper layers, 100.0 x 100.0 mm, 223 parts (29 on the bottom side), 121 nets.
