Crinst/LPWAN-current-logger-device/eagle/v3/DP_current_measure_V3_extension.brd

## EAGLE design eagle/v3/DP_current_measure_V3_extension.brd (2026-08-03)

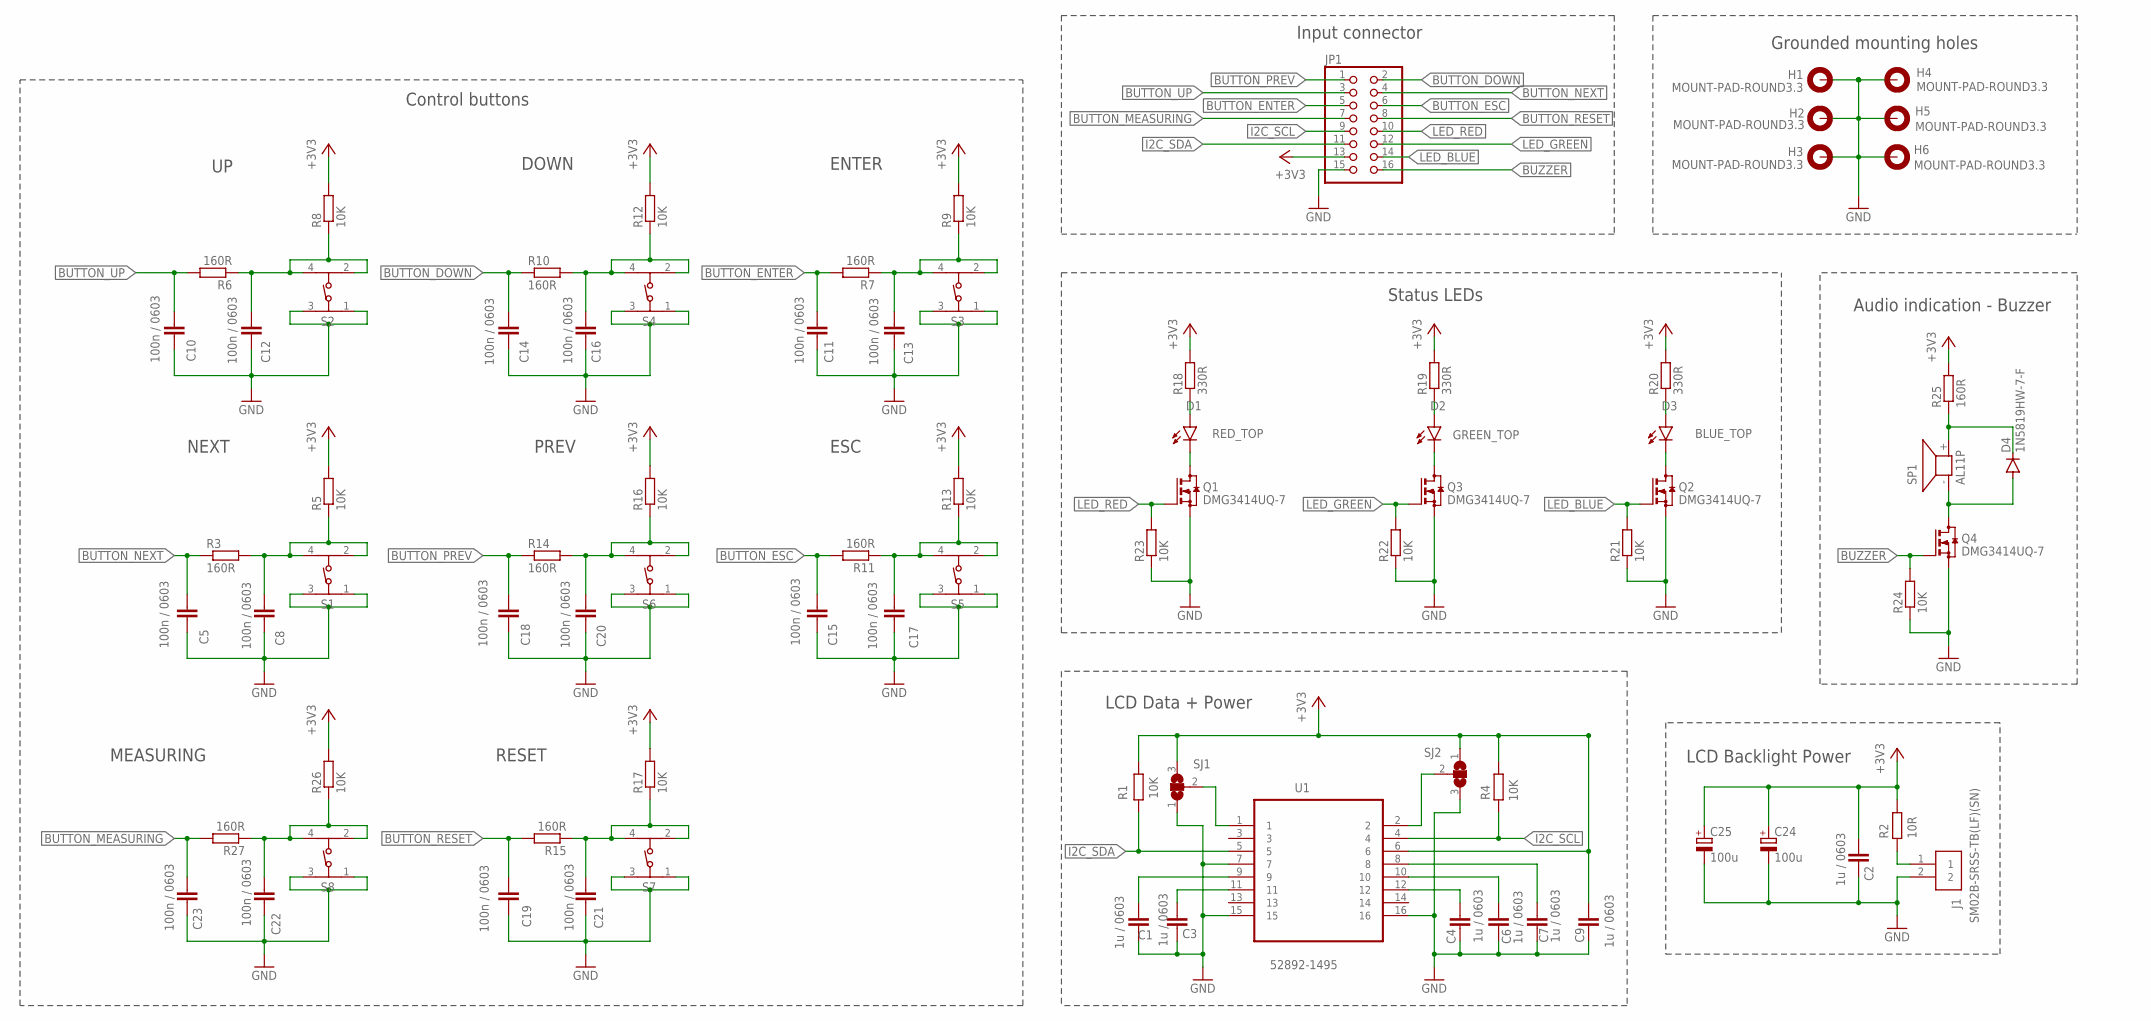
[picture p90: schematic DP_current_measure_V3_extension.sch]

Parts:
C1, C2, C3, C4, C6, C7, C9: 1u / 0603; C0603
C5, C8, C10, C11, C12, C13, C14, C15, C16, C17, C18, C19, C20, C21, C22, C23: 100n / 0603; C0603
C24, C25: 100u; SMC_B
D1: RED_TOP; LED-0603
D2: GREEN_TOP; LED-0603
D3: BLUE_TOP; LED-0603
D4: 1N5819HW-7-F; SOD-123_MINI-SMA
H1, H2, H3, H4, H5, H6: MOUNT-PAD-ROUND3.3; 3,3-PAD
J1: SM02B-SRSS-TB(LF)(SN)
JP1: PINHD-2X8; 2X08
Q1, Q2, Q3, Q4: DMG3414UQ-7; SOT23
R1, R4, R5, R8, R9, R12, R13, R16, R17, R21, R22, R23, R24, R26: 10K; R0603
R2: 10R; R0603
R3, R6, R7, R10, R11, R14, R15, R25, R27: 160R; R0603
R18, R19, R20: 330R; R0603
S1, S2, S3, S4, S5, S6, S7, S8: 430152095826
SJ1, SJ2: SJ2W; SJ_2
SP1: AL11P
U1: 52892-1495; MOLEX_52892-1495

Connections:
+3V3: C2.1, C9.1, C24.+, C25.+, JP1.13, R1.2, R2.2, R4.2, R5.2, R8.2, R9.2, R12.2, R13.2, R16.2, R17.2, R18.2, R19.2, R20.2, R25.2, R26.2, SJ1.3, SJ2.1, U1.6
BUTTON_DOWN: C14.1, JP1.2, R10.1
BUTTON_ENTER: C11.1, JP1.5, R7.2
BUTTON_ESC: C15.1, JP1.6, R11.2
BUTTON_MEASURING: C23.1, JP1.7, R27.2
BUTTON_NEXT: C5.1, JP1.4, R3.1
BUTTON_PREV: C18.1, JP1.1, R14.1
BUTTON_RESET: C19.1, JP1.8, R15.2
BUTTON_UP: C10.1, JP1.3, R6.2
BUZZER: JP1.16, Q4.1 (G), R24.2
GND: C1.2, C2.2, C3.2, C4.2, C5.2, C6.2, C7.2, C8.2, C9.2, C10.2, C11.2, C12.2, C13.2, C14.2, C15.2, C16.2, C17.2, C18.2, C19.2, C20.2, C21.2, C22.2, C23.2, C24.-, C25.-, H1.B3,3, H2.B3,3, H3.B3,3, H4.B3,3, H5.B3,3, H6.B3,3, J1.2, JP1.15, Q1.2 (S), Q2.2 (S), Q3.2 (S), Q4.2 (S), R21.1, R22.1, R23.1, R24.1, S1.1, S1.3, S2.1, S2.3, S3.1, S3.3, S4.1, S4.3, S5.1, S5.3, S6.1, S6.3, S7.1, S7.3, S8.1, S8.3, SJ1.1, SJ2.3, U1.7, U1.15, U1.16
I2C_SCL: JP1.9, R4.1, U1.4
I2C_SDA: JP1.11, R1.1, U1.5
LED_BLUE: JP1.14, Q2.1 (G), R21.2
LED_GREEN: JP1.12, Q3.1 (G), R22.2
LED_RED: JP1.10, Q1.1 (G), R23.2
unnamed: SJ1.2, U1.1
unnamed: J1.1, R2.1
unnamed: C12.1, R6.1, R8.1, S2.2, S2.4
unnamed: C22.1, R26.1, R27.1, S8.2, S8.4
unnamed: C1.1, U1.9
unnamed: C3.1, U1.11
unnamed: C16.1, R10.2, R12.1, S4.2, S4.4
unnamed: D1.C, Q1.3 (D)
unnamed: SJ2.2, U1.2
unnamed: C13.1, R7.1, R9.1, S3.2, S3.4
unnamed: D1.A, R18.1
unnamed: C7.1, U1.8
unnamed: C6.1, U1.10
unnamed: C4.1, U1.12
unnamed: D2.C, Q3.3 (D)
unnamed: D2.A, R19.1
unnamed: D4.A, Q4.3 (D), SP1.- (1)
unnamed: D4.C, R25.1, SP1.+ (2)
unnamed: C20.1, R14.2, R16.1, S6.2, S6.4
unnamed: C17.1, R11.1, R13.1, S5.2, S5.4
unnamed: C21.1, R15.1, R17.1, S7.2, S7.4
unnamed: D3.C, Q2.3 (D)
unnamed: D3.A, R20.1
unnamed: C8.1, R3.2, R5.1, S1.2, S1.4

Notes on the sheet:
DOWN
PREV
NEXT
ENTER
ESC
RESET
MEASURING
LCD Backlight Power
LCD Data + Power
Control buttons
Audio indication - Buzzer
Status LEDs
Input connector
Grounded mounting holes
