Crinst/LPWAN-current-logger-device/eagle/v3/DP_current_measure_V3_extension.brd

## EAGLE design eagle/v3/DP_current_measure_V3_extension.brd (continued)

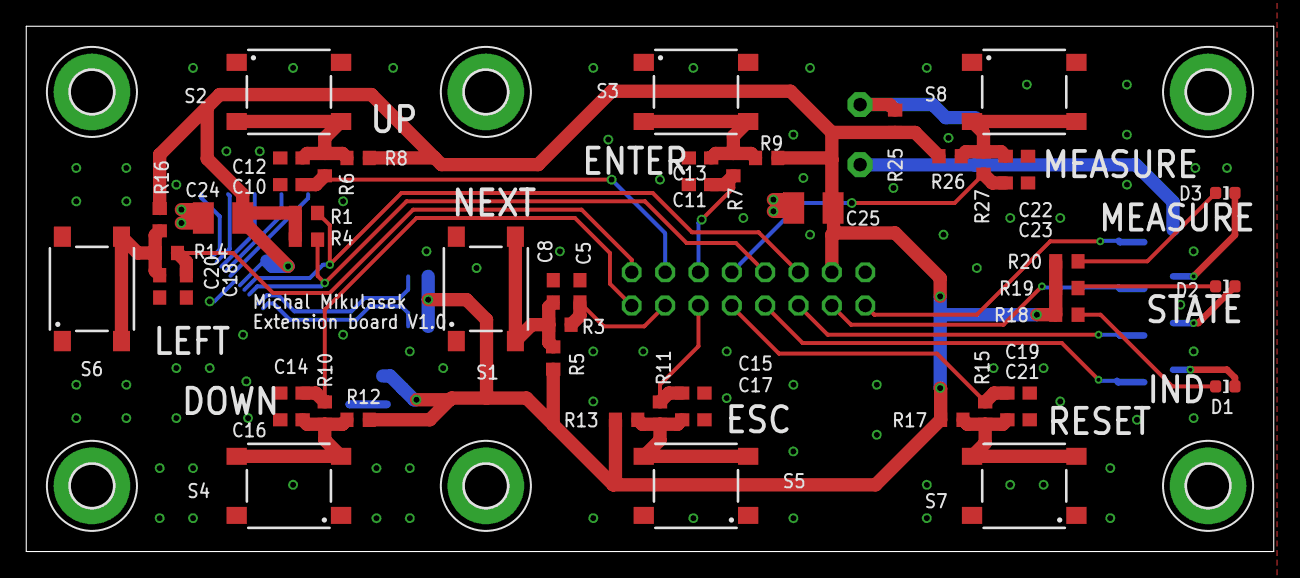
[picture p91: board DP_current_measure_V3_extension.brd from above]

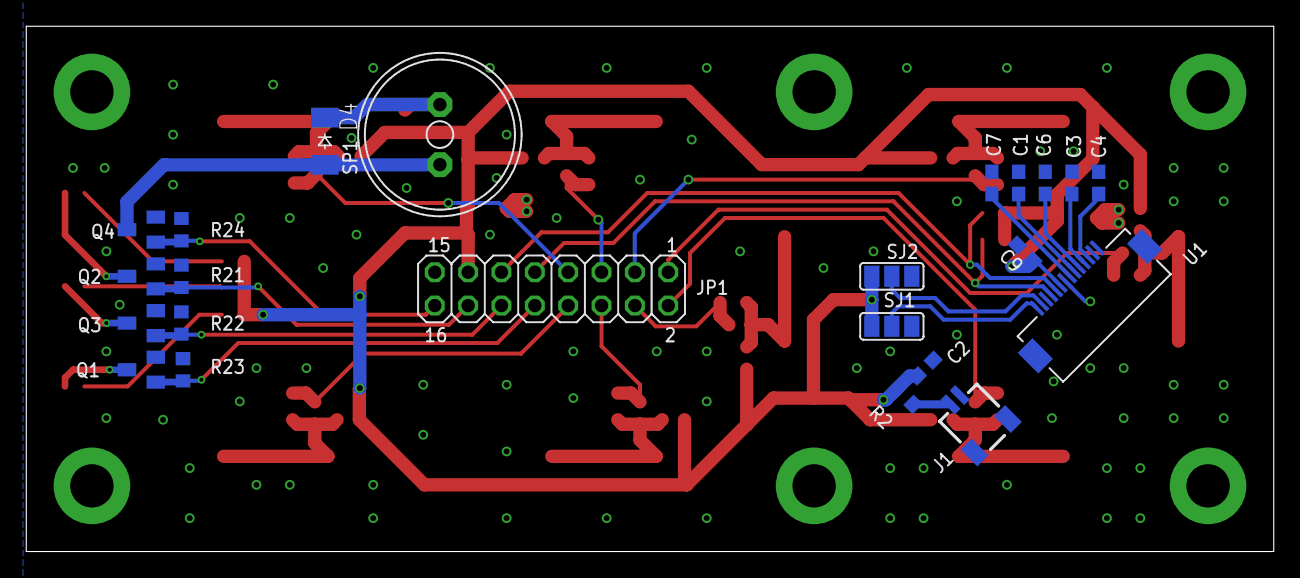
[picture p92: board DP_current_measure_V3_extension.brd from below]

Board: 4 copper layers, 95.0 x 40.0 mm, 80 parts (23 on the bottom side), 40 nets.
