Crinst/LPWAN-current-logger-device/eagle/v3/DP_current_measure_v3.brd

## EAGLE design eagle/v3/DP_current_measure_v3.brd (2026-08-03)

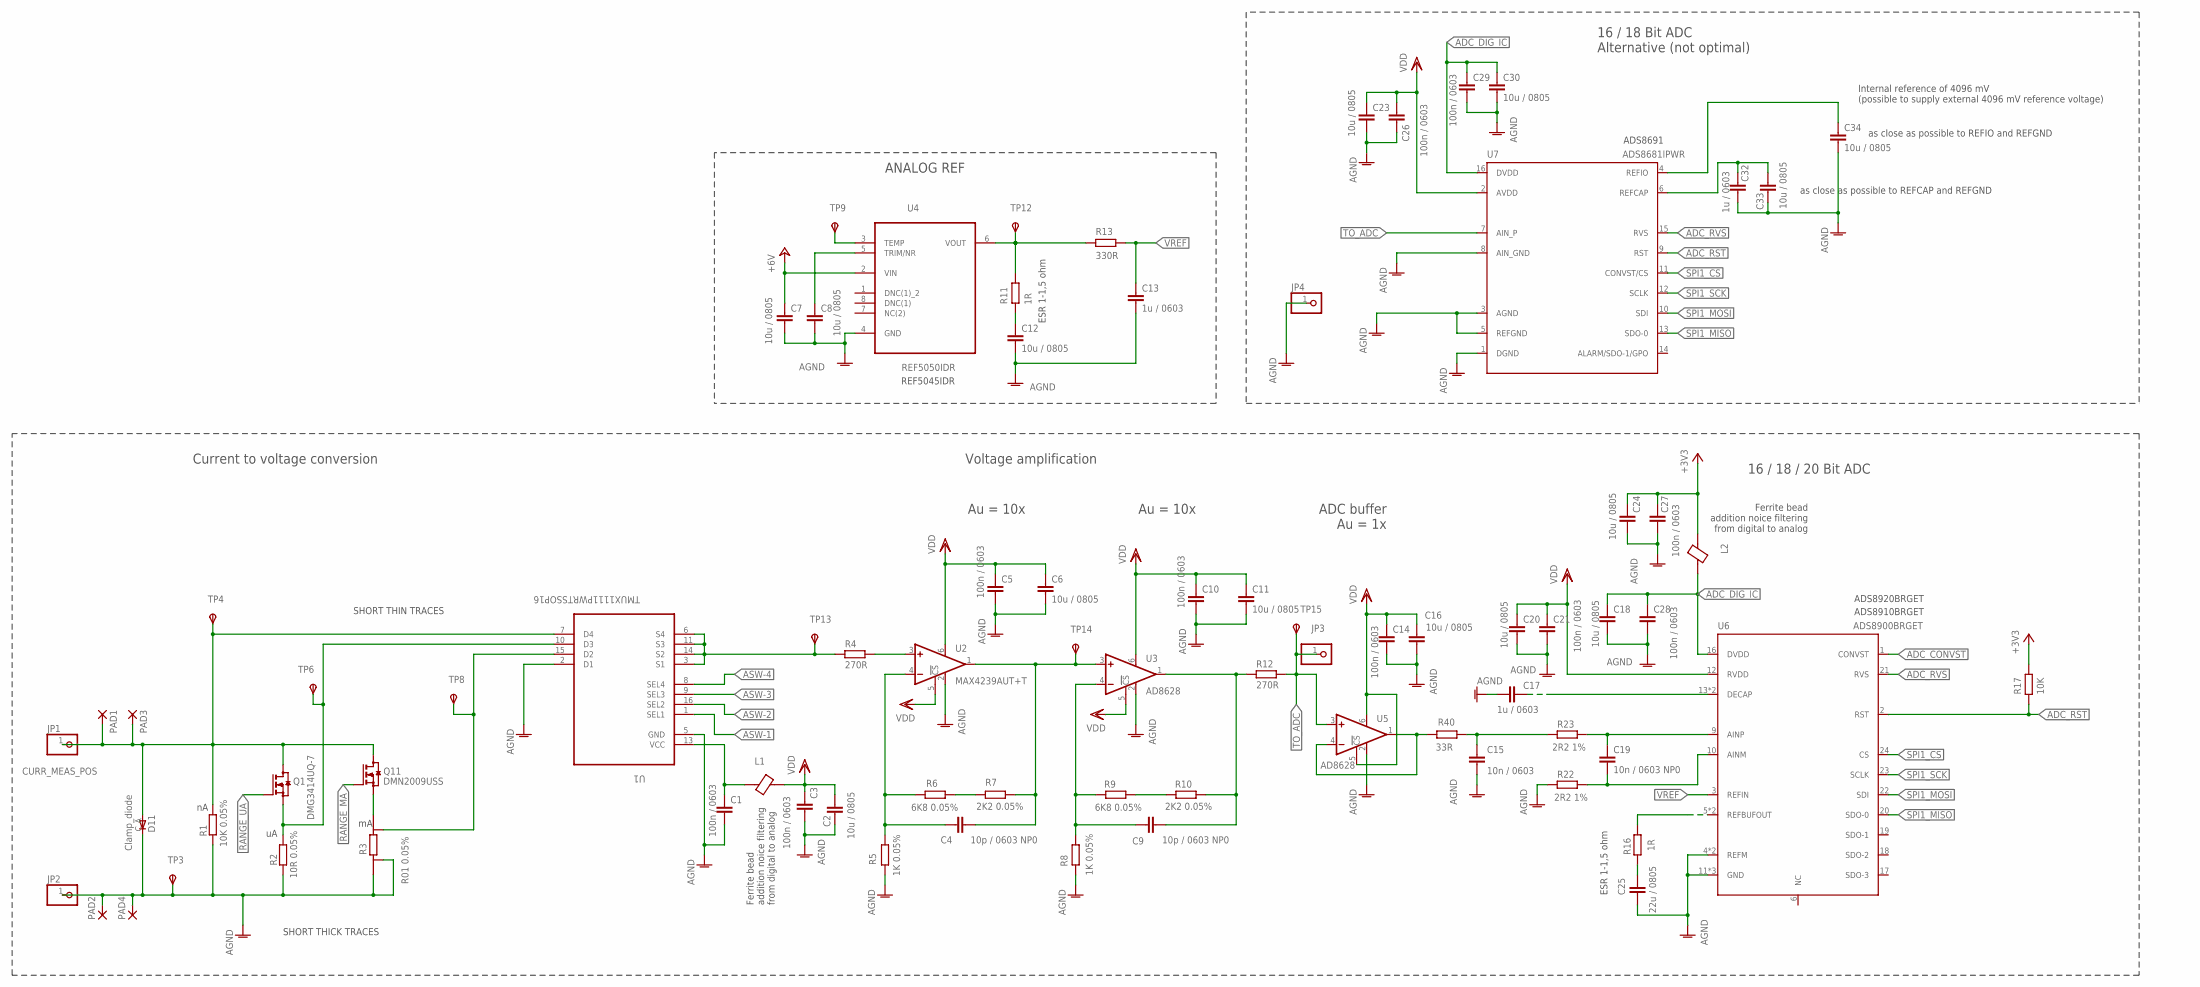
[picture p93: schematic DP_current_measure_v3.sch, sheet 1]

Parts:
C1, C3, C5, C10, C14, C21, C26, C27, C28, C29: 100n / 0603; C0603
C2, C6, C7, C8, C11, C12, C16, C18, C20, C23, C24, C30, C33, C34: 10u / 0805; C0805
C4, C9: 10p / 0603 NP0; C0603
C13, C17, C32: 1u / 0603; C0603
C15: 10n / 0603; C0603
C19: 10n / 0603 NP0; C0603
C25: 22u / 0805; C0805
D11: Clamp_diode; DO214AC
JP1, JP2, JP3, JP4: PINHD-1X1; 1X01
L1, L2: BLM21PG331SN1D
PAD1, PAD2, PAD3, PAD4: WIREPADSMD2,54-5,08; SMD2,54-5,08
Q1: DMG3414UQ-7; SOT23
Q11: DMN2009USS; SO8
R1: 10K 0.05%; R0805
R2: 10R 0.05%; R0805
R3: R01 0.05%; R2512
R4, R12: 270R; R0603
R5, R8: 1K 0.05%; R0603
R6, R9: 6K8 0.05%; R0603
R7, R10: 2K2 0.05%; R0603
R11, R16: 1R; R0603
R13: 330R; R0603
R17: 10K; R0603
R22, R23: 2R2 1%; R0603
R40: 33R; R0603
TP3, TP4, TP6, TP8, TP9, TP12, TP13, TP14, TP15: TPSB1,27; B1,27
U1: TMUX1111PWRTSSOP16; SOP65P640X110-16N
U2: MAX4239AUT+T; SOT23-6
U3, U5: AD8628; SOT23-6
U4: REF5050IDR; SOIC127P600X175-8N
U6: ADS8900BRGET; 24-VFQFN
U7: ADS8681IPWR; SOP65P640X120-16N

Connections:
+3V3: C24.1, C27.1, L2.2, R17.2; also elsewhere on the board
+6V: C7.1, U4.2 (VIN); also elsewhere on the board
ADC_CONVST: U6.1 (CONVST); also elsewhere on the board
ADC_DIG_IC: C18.1, C28.1, C29.1, C30.1, L2.1, U6.16 (DVDD), U7.16 (DVDD)
ADC_RST: R17.1, U6.2 (RST), U7.9 (RST); also elsewhere on the board
ADC_RVS: U6.21 (RVS), U7.15 (RVS); also elsewhere on the board
AGND: C1.2, C2.2, C3.2, C5.2, C6.2, C7.2, C8.2, C10.2, C11.2, C12.2, C13.2, C14.2, C15.2, C16.2, C17.2, C18.2, C20.2, C21.2, C23.2, C24.2, C25.2, C26.2, C27.2, C28.2, C29.2, C30.2, C32.2, C33.2, C34.2, D11.C, JP2.1, JP4.1, PAD2.1, PAD4.1, R1.2, R2.2, R3.E1, R3.I1, R5.1, R8.2, R22.1, TP3.TP, U1.2 (D1), U1.5 (GND), U2.2 (V-), U3.2 (V-), U4.4 (GND), U5.2 (V-), U6.4 (REFM), U6.8 (REFM), U6.11 (GND), U6.15 (GND), U6.25 (GND), U7.1 (DGND), U7.3 (AGND), U7.5 (REFGND), U7.8 (AIN_GND); also elsewhere on the board
ASW-1: U1.1 (SEL1); also elsewhere on the board
ASW-2: U1.16 (SEL2); also elsewhere on the board
ASW-3: U1.9 (SEL3); also elsewhere on the board
ASW-4: U1.8 (SEL4); also elsewhere on the board
CURR_MEAS_POS: D11.A, JP1.1, PAD1.1, PAD3.1, Q1.3 (D), Q11.5 (D), Q11.6 (D), Q11.7 (D), Q11.8 (D), R1.1, TP4.TP, U1.7 (D4)
MA_RANGE_SENSE: R3.E2, TP8.TP, U1.15 (D2)
MA_RANGE_SENSE_Q: Q11.1 (S), Q11.2 (S), Q11.3 (S), R3.I2
unnamed: C9.2, R10.1, R12.1, U3.1 (OUT)
unnamed: R9.1, R10.2
unnamed: C9.1, R8.1, R9.2, U3.4 (-IN)
unnamed: R6.2, R7.1
unnamed: C4.2, R7.2, TP14.TP, U2.1 (OUT), U3.3 (+IN)
unnamed: R4.1, TP13.TP, U1.3 (S1), U1.6 (S4), U1.11 (S3), U1.14 (S2)
unnamed: C4.1, R5.2, R6.1, U2.4 (-IN)
unnamed: C1.1, L1.1, U1.13 (VCC)
unnamed: C15.1, R23.1, R40.2
unnamed: R4.2, U2.3 (+IN)
unnamed: C19.2, R22.2, U6.10 (AINM)
unnamed: C8.1, U4.5 (TRIM/NR)
unnamed: C32.1, C33.1, U7.6 (REFCAP)
unnamed: C34.1, U7.4 (REFIO)
unnamed: TP9.TP, U4.3 (TEMP)
unnamed: R16.2, U6.5 (REFBUFOUT), U6.7 (REFBUFOUT)
unnamed: C25.1, R16.1
unnamed: C17.1, U6.13 (DECAP), U6.14 (DECAP)
unnamed: R40.1, U5.1 (OUT), U5.4 (-IN)
unnamed: C12.1, R11.2
unnamed: C19.1, R23.2, U6.9 (AINP)
RANGE_MA: Q11.4 (G); also elsewhere on the board
RANGE_UA: Q1.1 (G); also elsewhere on the board
SPI1_CS: U6.24 (CS), U7.11 (CONVST/CS); also elsewhere on the board
SPI1_MISO: U6.20 (SDO-0), U7.13 (SDO-0); also elsewhere on the board
SPI1_MOSI: U6.22 (SDI), U7.10 (SDI); also elsewhere on the board
SPI1_SCK: U6.23 (SCLK), U7.12 (SCLK); also elsewhere on the board
TO_ADC: JP3.1, R12.2, TP15.TP, U5.3 (+IN), U7.7 (AIN_P)
UA_RANGE_SENSE: Q1.2 (S), R2.1, TP6.TP, U1.10 (D3)
VDD: C2.1, C3.1, C5.1, C6.1, C10.1, C11.1, C14.1, C16.1, C20.1, C21.1, C23.1, C26.1, L1.2, U2.5 (!CS), U2.6 (V+), U3.5 (!CS), U3.6 (V+), U5.5 (!CS), U5.6 (V+), U6.12 (RVDD), U7.2 (AVDD); also elsewhere on the board
VREF: C13.1, R13.2, U6.3 (REFIN)
VREF_IC: R11.1, R13.1, TP12.TP, U4.6 (VOUT)

Notes on the sheet:
SHORT THICK TRACES
SHORT THIN TRACES
as close as possible to REFIO and REFGND
as close as possible to REFCAP and REFGND
ADS8691
REF5045IDR
16 / 18 Bit ADC Alternative (not optimal)
Internal reference of 4096 mV (possible to supply external 4096 mV reference voltage)
ANALOG REF
ESR 1-1,5 ohm
Ferrite bead addition noice filtering from digital to analog
Current to voltage conversion
16 / 18 / 20 Bit ADC
ADS8920BRGET
ADS8910BRGET
ADC buffer Au = 1x
Au = 10x
Voltage amplification

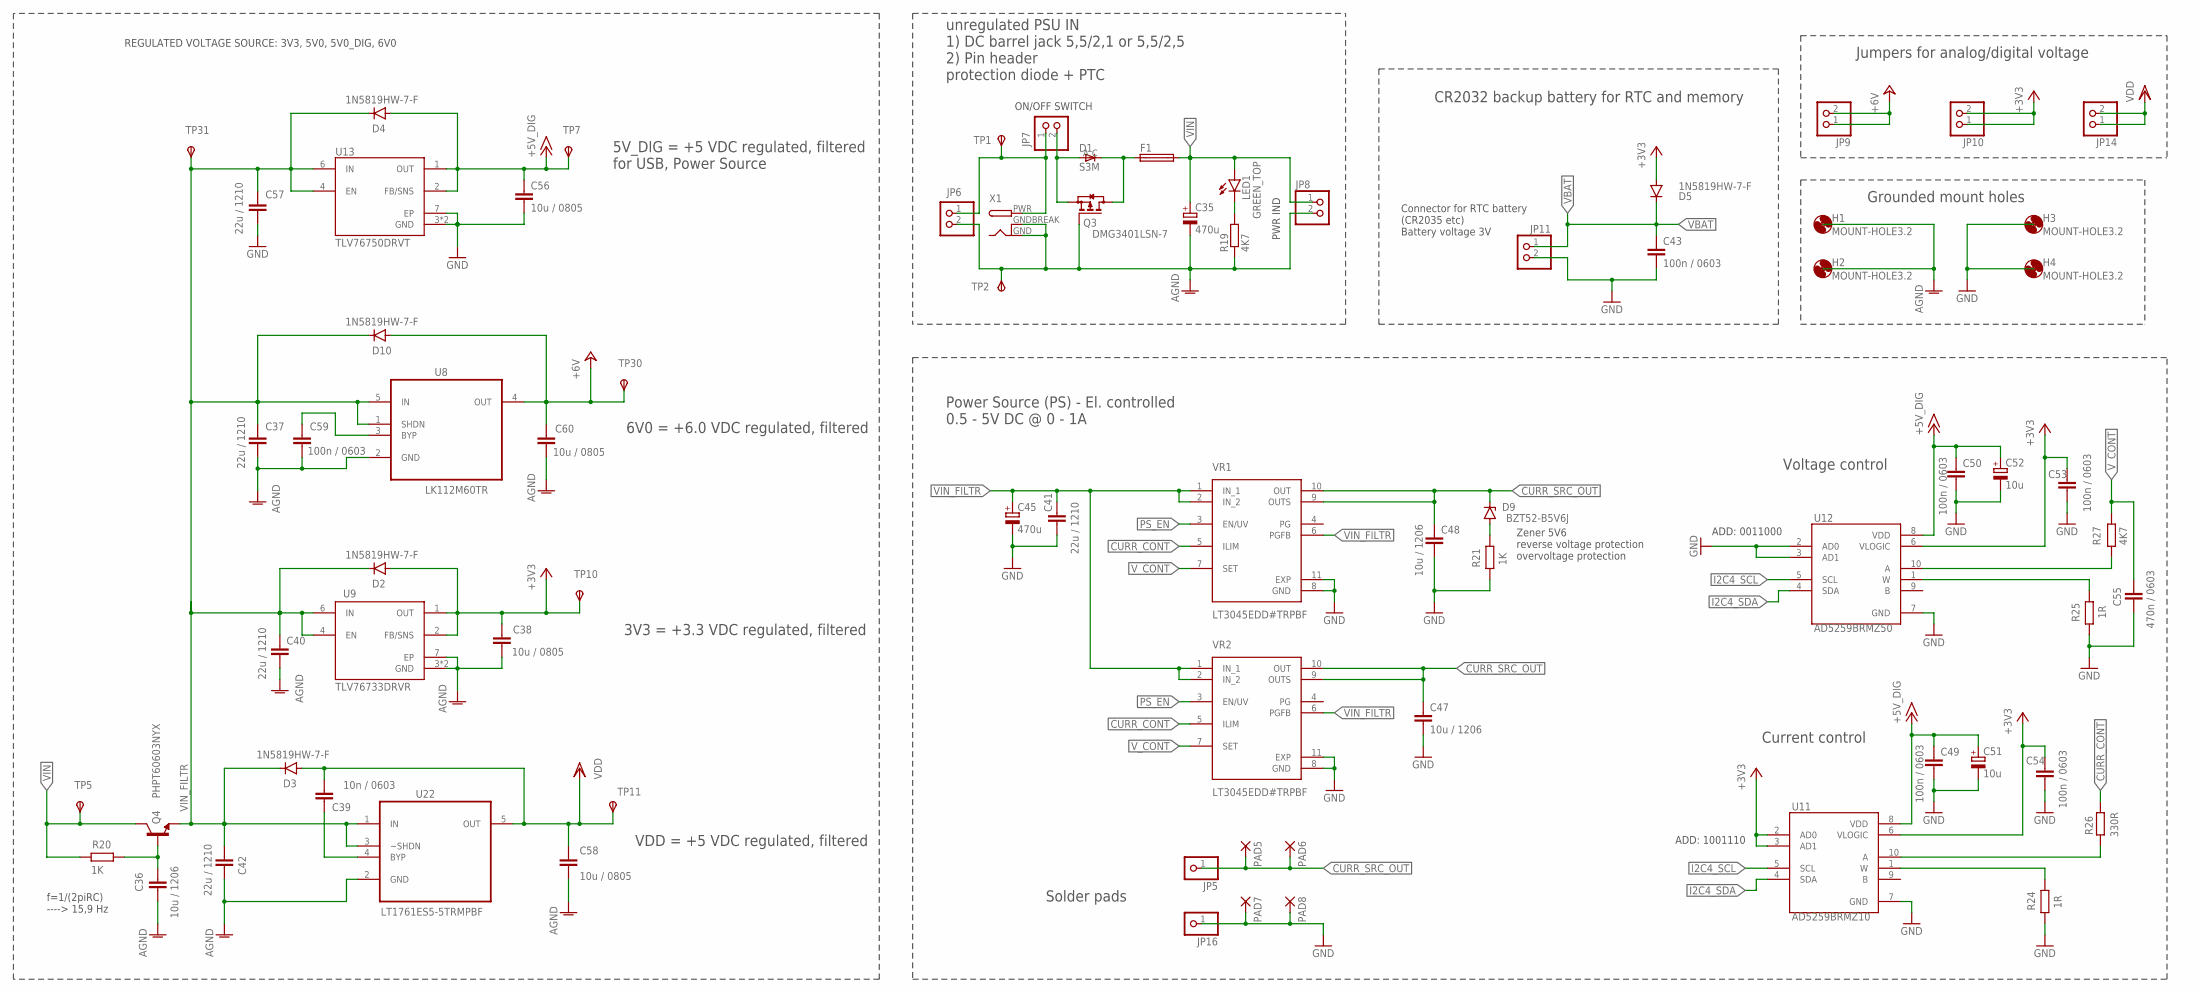
[picture p94: schematic DP_current_measure_v3.sch, sheet 2]

Parts:
C35, C45: 470u; PANASONIC_G
C36, C47, C48: 10u / 1206; C1206
C37, C40, C41, C42, C57: 22u / 1210; C1210
C38, C56, C58, C60: 10u / 0805; C0805
C39: 10n / 0603; C0603
C43, C49, C50, C53, C54, C59: 100n / 0603; C0603
C51, C52: 10u; SMC_B
C55: 470n / 0603; C0603
D1: S3M; DO214AC
D2, D3, D4, D5, D10: 1N5819HW-7-F; SOD-123_MINI-SMA
D9: BZT52-B5V6J; SODFL3718X115
F1: MF-MSMF050-2; 1812
H1, H2, H3, H4: MOUNT-HOLE3.2; 3,2
JP5, JP16: PINHD-1X1; 1X01
JP6, JP7, JP8, JP9, JP10, JP11, JP14: PINHD-1X2; 1X02
LED1: GREEN_TOP; CHIP-LED0603
PAD5, PAD6, PAD7, PAD8: WIREPADSMD2,54-5,08; SMD2,54-5,08
Q3: DMG3401LSN-7; SOT23
Q4: PHPT60603NYX; TO127P600X120-5N
R19, R27: 4K7; R0603
R20, R21: 1K; R0603
R24, R25: 1R; R0603
R26: 330R; R0603
TP1, TP2, TP5, TP7, TP10, TP11, TP30, TP31: TPSB1,27; B1,27
U8: LK112M60TR; SOT23-5
U9: TLV76733DRVR; SON65P200X200X80-7N
U11: AD5259BRMZ10; SOP50P490X95-10N
U12: AD5259BRMZ50; SOP50P490X95-10N
U13: TLV76750DRVT; SON65P200X200X80-7N
U22: LT1761ES5-5TRMPBF; SOT95P280X100-5N
VR1, VR2: LT3045EDD#TRPBF; SON50P300X300X80-11N
X1: DCBARRELPTH; DCJACK_2MM_PTH

Connections:
+3V3: C38.1, C53.1, C54.1, D2.A, D5.A, JP10.1, JP10.2, TP10.TP, U9.1 (OUT), U9.2 (FB/SNS), U11.2 (AD0), U11.3 (AD1), U11.6 (VLOGIC), U12.6 (VLOGIC); also elsewhere on the board
+5V_DIG: C49.1, C50.1, C51.+, C52.+, C56.1, D4.A, TP7.TP, U11.8 (VDD), U12.8 (VDD), U13.1 (OUT), U13.2 (FB/SNS); also elsewhere on the board
+6V: C60.1, D10.A, JP9.1, JP9.2, TP30.TP, U8.4 (OUT); also elsewhere on the board
AGND: C35.-, C36.2, C37.2, C38.2, C40.2, C42.2, C58.2, C59.2, C60.2, JP6.2, JP8.2, Q3.1 (G), R19.1, TP2.TP, U8.2 (GND), U9.3 (GND), U9.5 (GND), U9.7 (EP), U22.2 (GND), X1.GND, X1.GNDBREAK; also elsewhere on the board
CURR_CONT: R26.2, VR1.5 (ILIM), VR2.5 (ILIM)
CURR_CONT_LOW: R24.2, U11.1 (W)
CURR_POT_HIGH: R26.1, U11.10 (A)
CURR_SRC_OUT: C47.1, C48.1, D9.2 (C), JP5.1, PAD5.1, PAD6.1, VR1.9 (OUTS), VR1.10 (OUT), VR2.9 (OUTS), VR2.10 (OUT)
GND: C41.2, C43.2, C45.-, C47.2, C48.2, C49.2, C50.2, C51.-, C52.-, C53.2, C54.2, C55.2, C56.2, C57.2, JP11.2, JP16.1, PAD7.1, PAD8.1, R21.1, R24.1, R25.1, U11.7 (GND), U12.2 (AD0), U12.3 (AD1), U12.7 (GND), U13.3 (GND), U13.5 (GND), U13.7 (EP), VR1.8 (GND), VR1.11 (EXP), VR2.8 (GND), VR2.11 (EXP); also elsewhere on the board
I2C4_SCL: U11.5 (SCL), U12.5 (SCL); also elsewhere on the board
I2C4_SDA: U11.4 (SDA), U12.4 (SDA); also elsewhere on the board
unnamed: D9.1 (A), R21.2
unnamed: C59.1, U8.3 (BYP)
unnamed: C36.1, Q4.4 (B), R20.2
unnamed: D1.C, F1.1, Q3.3 (D)
unnamed: D1.A, JP7.2, Q3.2 (S)
unnamed: LED1.C, R19.2
unnamed: JP6.1, JP7.1, TP1.TP, X1.PWR
PS_EN: VR1.3 (EN/UV), VR2.3 (EN/UV); also elsewhere on the board
REG_BYPAS: C39.1, U22.4 (BYP)
VBAT: C43.1, D5.C, JP11.1; also elsewhere on the board
VDD: C39.2, C58.1, D3.A, JP14.1, JP14.2, TP11.TP, U22.5 (OUT); also elsewhere on the board
VIN: C35.+, F1.2, JP8.1, LED1.A, Q4.5 (C), R20.1, TP5.TP
VIN_FILTR: C37.1, C40.1, C41.1, C42.1, C45.+, C57.1, D2.C, D3.C, D4.C, D10.C, Q4.1 (E), Q4.2 (E), Q4.3 (E), TP31.TP, U8.1 (SHDN), U8.5 (IN), U9.4 (EN), U9.6 (IN), U13.4 (EN), U13.6 (IN), U22.1 (IN), U22.3 (~SHDN), VR1.1 (IN_1), VR1.2 (IN_2), VR1.6 (PGFB), VR2.1 (IN_1), VR2.2 (IN_2), VR2.6 (PGFB)
V_CONT: C55.1, R27.2, VR1.7 (SET), VR2.7 (SET)
V_CONT_LOW: R25.2, U12.1 (W)
V_POT_HIGH: R27.1, U12.10 (A)

Notes on the sheet:
unregulated PSU IN 1) DC barrel jack 5,5/2,1 or 5,5/2,5 2) Pin header protection diode + PTC
f=1/(2piRC) ----> 15,9 Hz
VDD = +5 VDC regulated, filtered
3V3 = +3.3 VDC regulated, filtered
PWR IND
CR2032 backup battery for RTC and memory
ON/OFF SWITCH
6V0 = +6.0 VDC regulated, filtered
Grounded mount holes
Jumpers for analog/digital voltage
REGULATED VOLTAGE SOURCE: 3V3, 5V0, 5V0_DIG, 6V0
Voltage control
Current control
ADD: 0011000
ADD: 1001110
Connector for RTC battery (CR2035 etc) Battery voltage 3V
5V_DIG = +5 VDC regulated, filtered for USB, Power Source
Power Source (PS) - El. controlled 0.5 - 5V DC @ 0 - 1A
Zener 5V6 reverse voltage protection overvoltage protection
Solder pads

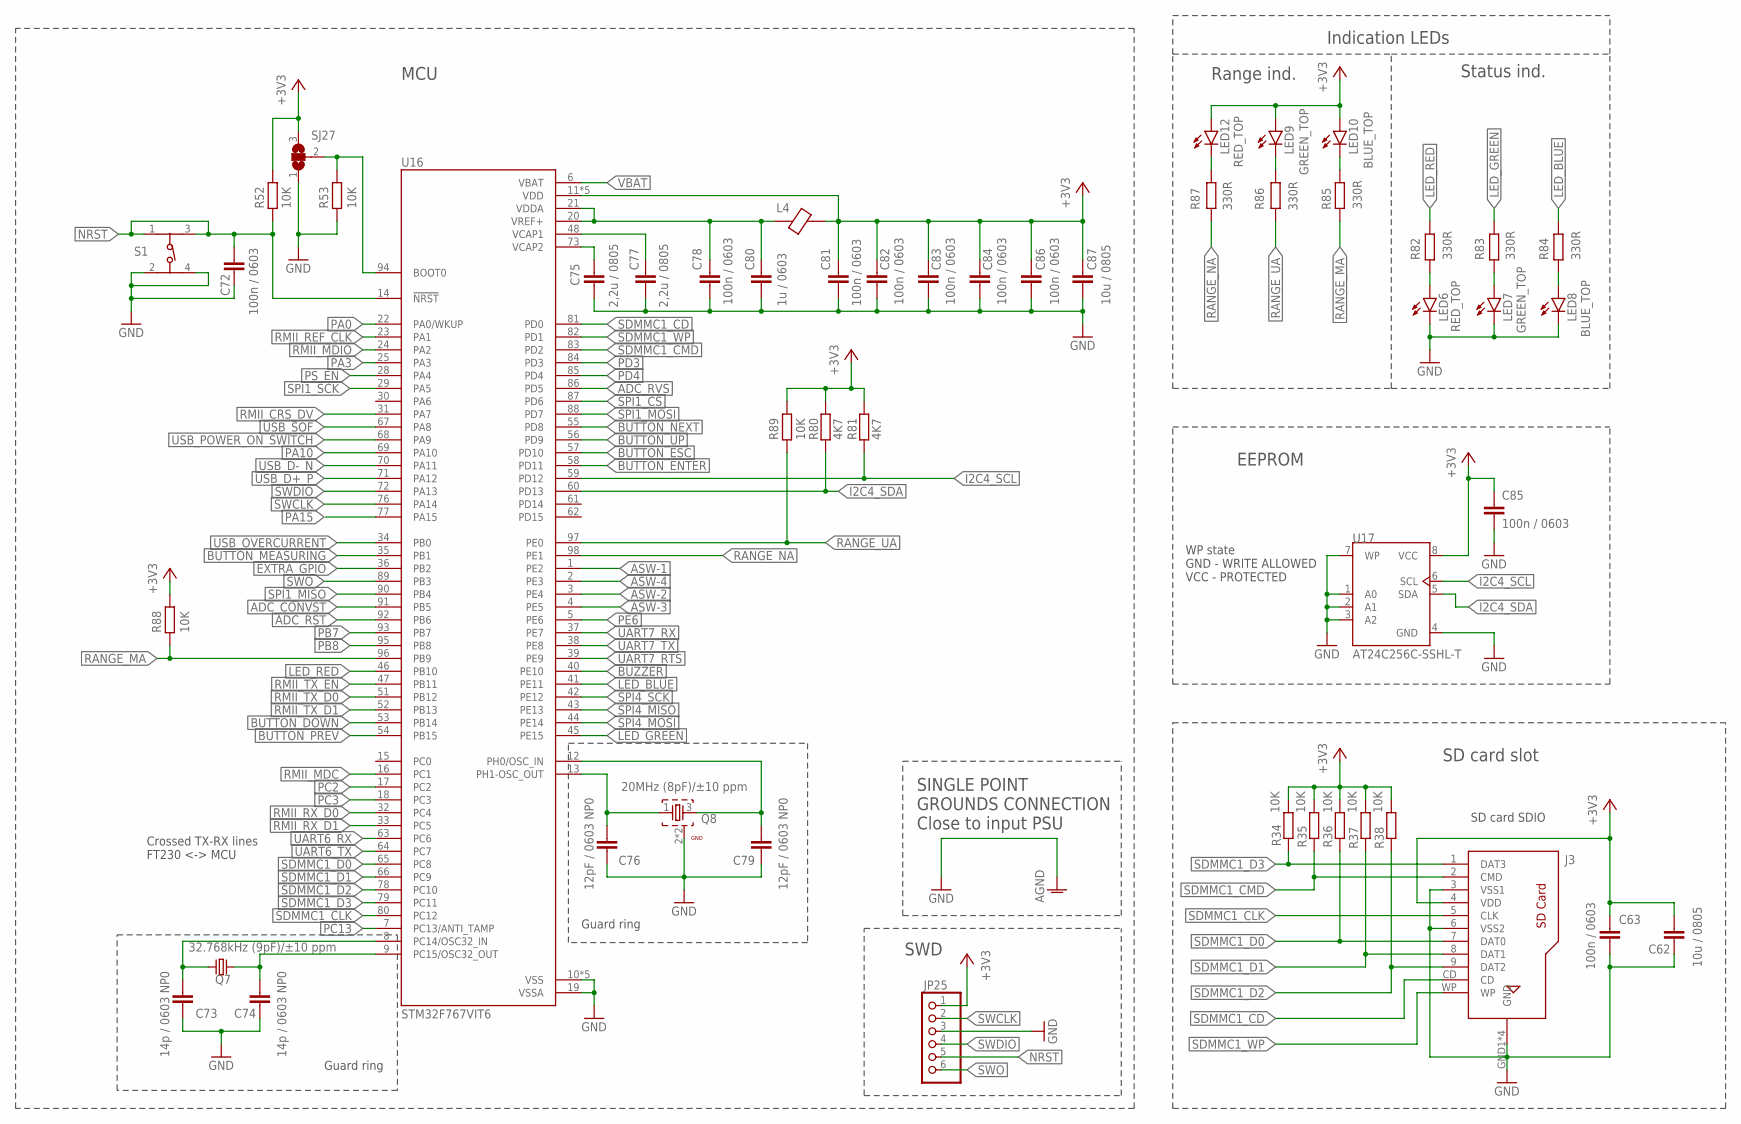
[picture p95: schematic DP_current_measure_v3.sch, sheet 3]

Parts:
C62, C87: 10u / 0805; C0805
C63, C72, C78, C81, C82, C83, C84, C85, C86: 100n / 0603; C0603
C73, C74: 14p / 0603 NP0; C0603
C75, C77: 2,2u / 0805; C0805
C76, C79: 12pF / 0603 NP0; C0603
C80: 1u / 0603; C0603
J3: 693063020911
JP25: PINHD-1X6; 1X06
L4: BLM21PG331SN1D
LED6, LED12: RED_TOP; CHIP-LED0603
LED7, LED9: GREEN_TOP; CHIP-LED0603
LED8, LED10: BLUE_TOP; CHIP-LED0603
Q7: 32.768kHz (9pF)/±10 ppm; WE-XTAL_IQXC-25
Q8: 20MHz (8pF)/±10 ppm; WE-XTAL_CFPX-218
R34, R35, R36, R37, R38, R52, R53, R88, R89: 10K; R0603
R80, R81: 4K7; R0603
R82, R83, R84, R85, R86, R87: 330R; R0603
S1: 430152080836
SJ27: SJ2W; SJ_2
U16: STM32F767VIT6; QFP50P1600X1600X160-100N
U17: AT24C256C-SSHL-T; SOIC127P600X175-8N

Connections:
+3V3: C62.1, C63.1, C81.1, C82.1, C83.1, C84.1, C85.1, C86.1, C87.1, J3.4 (VDD), JP25.1, L4.1, LED9.A, LED10.A, LED12.A, R34.2, R35.2, R36.2, R37.2, R38.2, R52.2, R80.2, R81.2, R88.2, R89.2, SJ27.3, U16.11 (VDD), U16.27 (VDD), U16.50 (VDD), U16.75 (VDD), U16.100 (VDD), U17.8 (VCC); also elsewhere on the board
ADC_CONVST: U16.91 (PB5); also elsewhere on the board
ADC_RST: U16.92 (PB6); also elsewhere on the board
ADC_RVS: U16.86 (PD5); also elsewhere on the board
ASW-1: U16.1 (PE2); also elsewhere on the board
ASW-2: U16.3 (PE4); also elsewhere on the board
ASW-3: U16.4 (PE5); also elsewhere on the board
ASW-4: U16.2 (PE3); also elsewhere on the board
BUTTON_DOWN: U16.53 (PB14); also elsewhere on the board
BUTTON_ENTER: U16.58 (PD11); also elsewhere on the board
BUTTON_ESC: U16.57 (PD10); also elsewhere on the board
BUTTON_MEASURING: U16.35 (PB1); also elsewhere on the board
BUTTON_NEXT: U16.55 (PD8); also elsewhere on the board
BUTTON_PREV: U16.54 (PB15); also elsewhere on the board
BUTTON_UP: U16.56 (PD9); also elsewhere on the board
BUZZER: U16.40 (PE10); also elsewhere on the board
EXTRA_GPIO: U16.36 (PB2); also elsewhere on the board
GND: C62.2, C63.2, C72.2, C73.2, C74.2, C75.2, C76.2, C77.2, C78.2, C79.2, C80.2, C81.2, C82.2, C83.2, C84.2, C85.2, C86.2, C87.2, J3.3 (VSS1), J3.6 (VSS2), J3.GND1 (GND), J3.GND2 (GND), J3.GND3 (GND), J3.GND4 (GND), JP25.3, LED6.C, LED7.C, LED8.C, Q8.2 (GND), Q8.4 (GND), R53.1, S1.2, S1.4, SJ27.1, U16.10 (VSS), U16.19 (VSSA), U16.26 (VSS), U16.49 (VSS), U16.74 (VSS), U16.99 (VSS), U17.1 (A0), U17.2 (A1), U17.3 (A2), U17.4 (GND), U17.7 (WP); also elsewhere on the board
I2C4_SCL: R81.1, U16.59 (PD12), U17.6 (SCL); also elsewhere on the board
I2C4_SDA: R80.1, U16.60 (PD13), U17.5 (SDA); also elsewhere on the board
LED_BLUE: R84.2, U16.41 (PE11); also elsewhere on the board
LED_GREEN: R83.2, U16.45 (PE15); also elsewhere on the board
LED_RED: R82.2, U16.46 (PB10); also elsewhere on the board
unnamed: C76.1, Q8.1, U16.13 (PH1-OSC_OUT)
unnamed: C79.1, Q8.3 (2), U16.12 (PH0/OSC_IN)
unnamed: C74.1, Q7.2, U16.9 (PC15/OSC32_OUT)
unnamed: C73.1, Q7.1, U16.8 (PC14/OSC32_IN)
unnamed: C75.1, U16.73 (VCAP2)
unnamed: C77.1, U16.48 (VCAP1)
unnamed: R53.2, SJ27.2, U16.94 (BOOT0)
unnamed: C78.1, C80.1, L4.2, U16.20 (VREF+), U16.21 (VDDA)
unnamed: LED8.A, R84.1
unnamed: LED7.A, R83.1
unnamed: LED6.A, R82.1
unnamed: LED12.C, R87.1
unnamed: LED9.C, R86.1
unnamed: LED10.C, R85.1
NRST: C72.1, JP25.5, R52.1, S1.1, S1.3, U16.14 (!NRST); also elsewhere on the board
PA0: U16.22 (PA0/WKUP); also elsewhere on the board
PA3: U16.25 (PA3); also elsewhere on the board
PA10: U16.69 (PA10); also elsewhere on the board
PA15: U16.77 (PA15); also elsewhere on the board
PB7: U16.93 (PB7); also elsewhere on the board
PB8: U16.95 (PB8); also elsewhere on the board
PC2: U16.17 (PC2); also elsewhere on the board
PC3: U16.18 (PC3); also elsewhere on the board
PC13: U16.7 (PC13/ANTI_TAMP); also elsewhere on the board
PD3: U16.84 (PD3); also elsewhere on the board
PD4: U16.85 (PD4); also elsewhere on the board
PE6: U16.5 (PE6); also elsewhere on the board
PS_EN: U16.28 (PA4); also elsewhere on the board
RANGE_MA: R85.2, R88.1, U16.96 (PB9); also elsewhere on the board
RANGE_NA: R87.2, U16.98 (PE1)
RANGE_UA: R86.2, R89.1, U16.97 (PE0); also elsewhere on the board
RMII_CRS_DV: U16.31 (PA7); also elsewhere on the board
RMII_MDC: U16.16 (PC1); also elsewhere on the board
RMII_MDIO: U16.24 (PA2); also elsewhere on the board
RMII_REF_CLK: U16.23 (PA1); also elsewhere on the board
RMII_RX_D0: U16.32 (PC4); also elsewhere on the board
RMII_RX_D1: U16.33 (PC5); also elsewhere on the board
RMII_TX_D0: U16.51 (PB12); also elsewhere on the board
RMII_TX_D1: U16.52 (PB13); also elsewhere on the board
RMII_TX_EN: U16.47 (PB11); also elsewhere on the board
SDMMC1_CD: J3.CD, U16.81 (PD0)
SDMMC1_CLK: J3.5 (CLK), U16.80 (PC12)
SDMMC1_CMD: J3.2 (CMD), R35.1, U16.83 (PD2)
SDMMC1_D0: J3.7 (DAT0), R36.1, U16.65 (PC8)
SDMMC1_D1: J3.8 (DAT1), R37.1, U16.66 (PC9)
SDMMC1_D2: J3.9 (DAT2), R38.1, U16.78 (PC10)
SDMMC1_D3: J3.1 (DAT3), R34.1, U16.79 (PC11)
SDMMC1_WP: J3.WP, U16.82 (PD1)
SPI1_CS: U16.87 (PD6); also elsewhere on the board
SPI1_MISO: U16.90 (PB4); also elsewhere on the board
SPI1_MOSI: U16.88 (PD7); also elsewhere on the board
SPI1_SCK: U16.29 (PA5); also elsewhere on the board
SPI4_MISO: U16.43 (PE13); also elsewhere on the board
SPI4_MOSI: U16.44 (PE14); also elsewhere on the board
SPI4_SCK: U16.42 (PE12); also elsewhere on the board
SWCLK: JP25.2, U16.76 (PA14)
SWDIO: JP25.4, U16.72 (PA13)
SWO: JP25.6, U16.89 (PB3)
UART6_RX: U16.63 (PC6); also elsewhere on the board
UART6_TX: U16.64 (PC7); also elsewhere on the board
UART7_RTS: U16.39 (PE9); also elsewhere on the board
UART7_RX: U16.37 (PE7); also elsewhere on the board
UART7_TX: U16.38 (PE8); also elsewhere on the board
USB_D+_P: U16.71 (PA12); also elsewhere on the board
USB_D-_N: U16.70 (PA11); also elsewhere on the board
USB_OVERCURRENT: U16.34 (PB0); also elsewhere on the board
USB_POWER_ON_SWITCH: U16.68 (PA9); also elsewhere on the board
USB_SOF: U16.67 (PA8)
VBAT: U16.6 (VBAT); also elsewhere on the board

Notes on the sheet:
Guard ring
WP state GND - WRITE ALLOWED VCC - PROTECTED
EEPROM
SWD
Crossed TX-RX lines FT230 <-> MCU
SD card slot
SD card SDIO
SINGLE POINT GROUNDS CONNECTION Close to input PSU
Indication LEDs
Status ind.
Range ind.
MCU

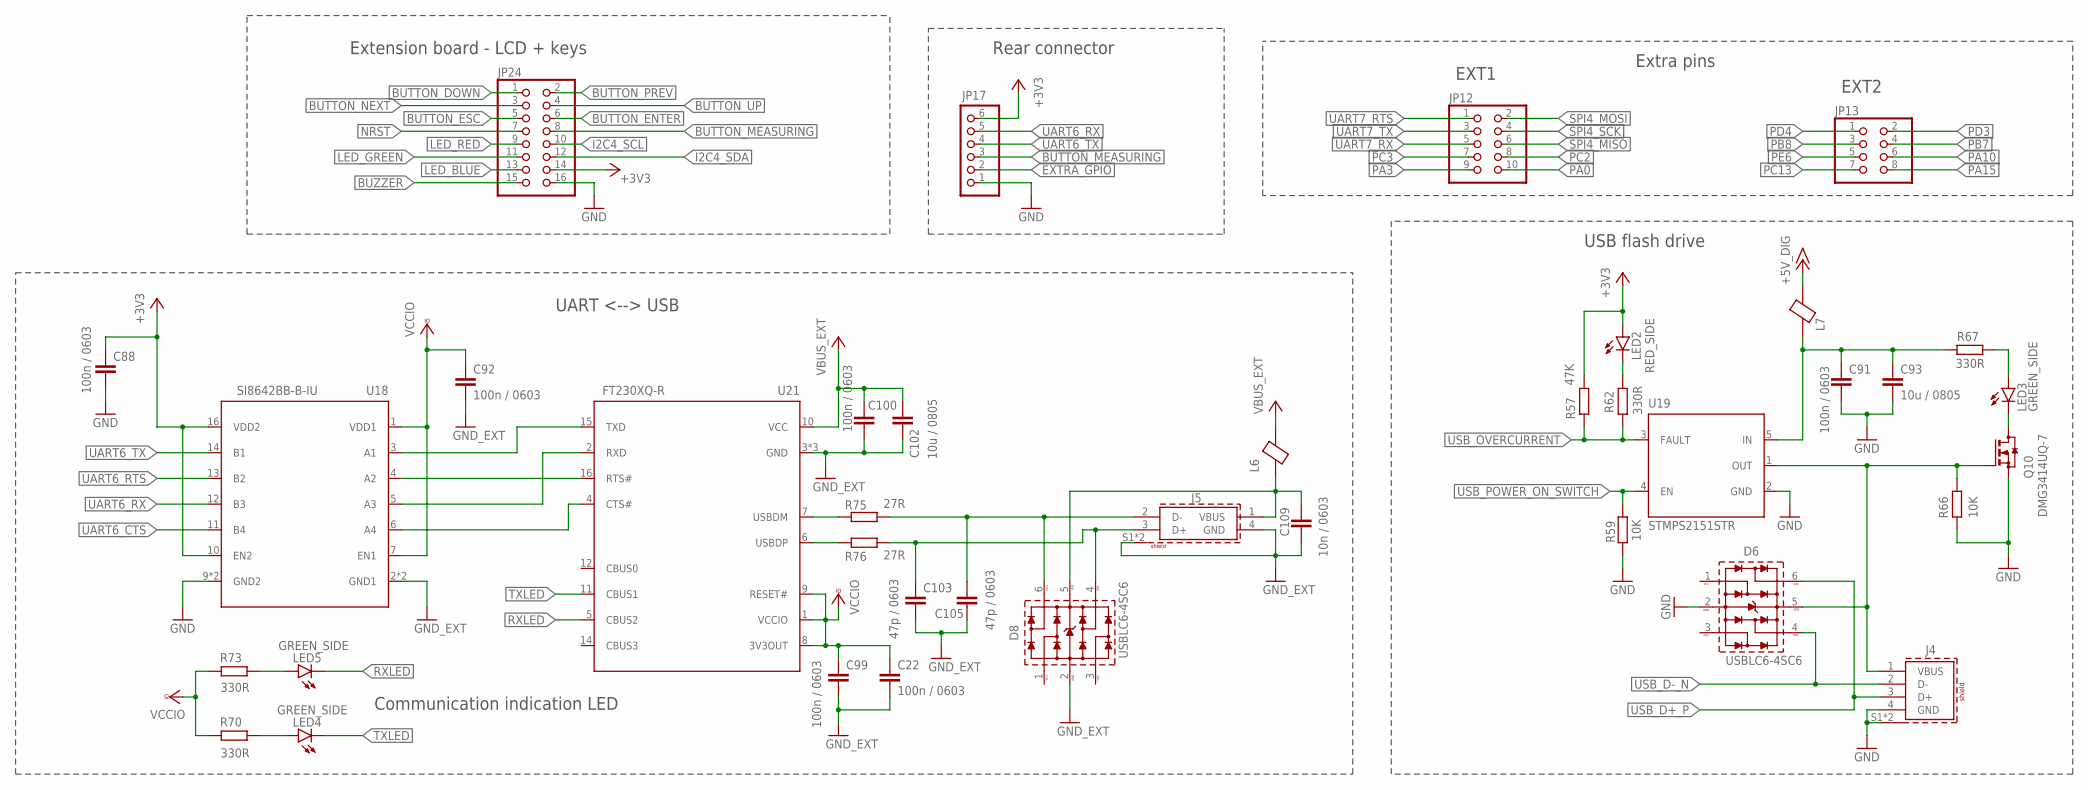
[picture p96: schematic DP_current_measure_v3.sch, sheet 4]

Parts:
C22, C88, C91, C92, C99, C100: 100n / 0603; C0603
C93, C102: 10u / 0805; C0805
C103, C105: 47p / 0603; C0603
C109: 10n / 0603; C0603
D6, D8: USBLC6-4SC6; WE-TVS_SOT23-6L
J4: 614004190021
J5: 61400416121
JP12: PINHD-2X5; 2X05
JP13: PINHD-2X4; 2X04
JP17: PINHD-1X6; 1X06
JP24: PINHD-2X8; 2X08
L6, L7: BLM21PG331SN1D
LED2: RED_SIDE; CHIP-LED0603
LED3, LED4, LED5: GREEN_SIDE; CHIP-LED0603
Q10: DMG3414UQ-7; SOT23
R57: 47K; R0603
R59, R66: 10K; R0603
R62, R67, R70, R73: 330R; R0603
R75, R76: 27R; R0603
U18: SI8642BB-B-IU; QSOP16
U19: STMPS2151STR; SOT-23-5
U21: FT230XQ-R; QFN16-4X4

Connections:
+3V3: C88.1, JP17.6, JP24.14, LED2.A, R57.1, U18.10 (EN2), U18.16 (VDD2); also elsewhere on the board
+5V_DIG: L7.1; also elsewhere on the board
BUTTON_DOWN: JP24.1; also elsewhere on the board
BUTTON_ENTER: JP24.6; also elsewhere on the board
BUTTON_ESC: JP24.5; also elsewhere on the board
BUTTON_MEASURING: JP17.3, JP24.8; also elsewhere on the board
BUTTON_NEXT: JP24.3; also elsewhere on the board
BUTTON_PREV: JP24.2; also elsewhere on the board
BUTTON_UP: JP24.4; also elsewhere on the board
BUZZER: JP24.15; also elsewhere on the board
CTS: U18.6 (A4), U21.4 (CTS#)
EXTRA_GPIO: JP17.2; also elsewhere on the board
GND: C88.2, C91.2, C93.2, D6.2 (GND), J4.4 (GND), J4.S1 (SHIELD), J4.S2 (SHIELD), JP17.1, JP24.16, Q10.2 (S), R59.2, R66.2, U18.9 (GND2), U18.15 (GND2), U19.2 (GND); also elsewhere on the board
GND_EXT: C22.2, C92.2, C99.2, C100.2, C102.2, C103.2, C105.2, C109.2, D8.2 (GND), J5.4 (GND), J5.S1 (SHIELD), J5.S2 (SHIELD), U18.2 (GND1), U18.8 (GND1), U21.3 (GND), U21.13 (GND), U21.EXP (GND)
I2C4_SCL: JP24.10; also elsewhere on the board
I2C4_SDA: JP24.12; also elsewhere on the board
LED_BLUE: JP24.13; also elsewhere on the board
LED_GREEN: JP24.11; also elsewhere on the board
LED_RED: JP24.9; also elsewhere on the board
unnamed: LED4.A, R70.1
unnamed: LED5.A, R73.1
unnamed: LED3.A, R67.2
unnamed: LED3.C, Q10.3 (D)
unnamed: LED2.C, R62.1
unnamed: C91.1, C93.1, L7.2, R67.1, U19.5 (IN)
NRST: JP24.7; also elsewhere on the board
PA0: JP12.10; also elsewhere on the board
PA3: JP12.9; also elsewhere on the board
PA10: JP13.6; also elsewhere on the board
PA15: JP13.8; also elsewhere on the board
PB7: JP13.4; also elsewhere on the board
PB8: JP13.3; also elsewhere on the board
PC2: JP12.8; also elsewhere on the board
PC3: JP12.7; also elsewhere on the board
PC13: JP13.7; also elsewhere on the board
PD3: JP13.2; also elsewhere on the board
PD4: JP13.1; also elsewhere on the board
PE6: JP13.5; also elsewhere on the board
RTS: U18.4 (A2), U21.16 (RTS#)
RXD: U18.5 (A3), U21.2 (RXD)
RXLED: LED5.C, U21.5 (CBUS2)
SPI4_MISO: JP12.6; also elsewhere on the board
SPI4_MOSI: JP12.2; also elsewhere on the board
SPI4_SCK: JP12.4; also elsewhere on the board
TXD: U18.3 (A1), U21.15 (TXD)
TXLED: LED4.C, U21.11 (CBUS1)
UART6_CTS: U18.11 (B4)
UART6_RTS: U18.13 (B2)
UART6_RX: JP17.5, U18.12 (B3); also elsewhere on the board
UART6_TX: JP17.4, U18.14 (B1); also elsewhere on the board
UART7_RTS: JP12.1; also elsewhere on the board
UART7_RX: JP12.5; also elsewhere on the board
UART7_TX: JP12.3; also elsewhere on the board
USBE_N: C105.1, D8.6, J5.2 (D-), R75.2
USBE_P: C103.1, D8.4, J5.3 (D+), R76.2
USB_D+_P: D6.6, J4.3 (D+); also elsewhere on the board
USB_D-_N: D6.4, J4.2 (D-); also elsewhere on the board
USB_N: R75.1, U21.7 (USBDM)
USB_OVERCURRENT: R57.2, R62.2, U19.3 (FAULT); also elsewhere on the board
USB_P: R76.1, U21.6 (USBDP)
USB_POWER_ON_SWITCH: R59.1, U19.4 (EN); also elsewhere on the board
VBUS: C109.1, D8.5 (VDD), J5.1 (VBUS), L6.2
VBUS_EXT: C100.1, C102.1, L6.1, U21.10 (VCC)
VBUS_OUT: D6.5 (VDD), J4.1 (VBUS), Q10.1 (G), R66.1, U19.1 (OUT)
VCCIO: C22.1, C92.1, C99.1, R70.2, R73.2, U18.1 (VDD1), U18.7 (EN1), U21.1 (VCCIO), U21.8 (3V3OUT), U21.9 (RESET#)

Notes on the sheet:
UART <--> USB
USB flash drive
Extension board - LCD + keys
Rear connector
Extra pins
Communication indication LED
EXT2
EXT1
