Crinst/LPWAN-current-logger-device/eagle/v3/DP_current_measure_v3.brd

## EAGLE design eagle/v3/DP_current_measure_v3.brd (continued)

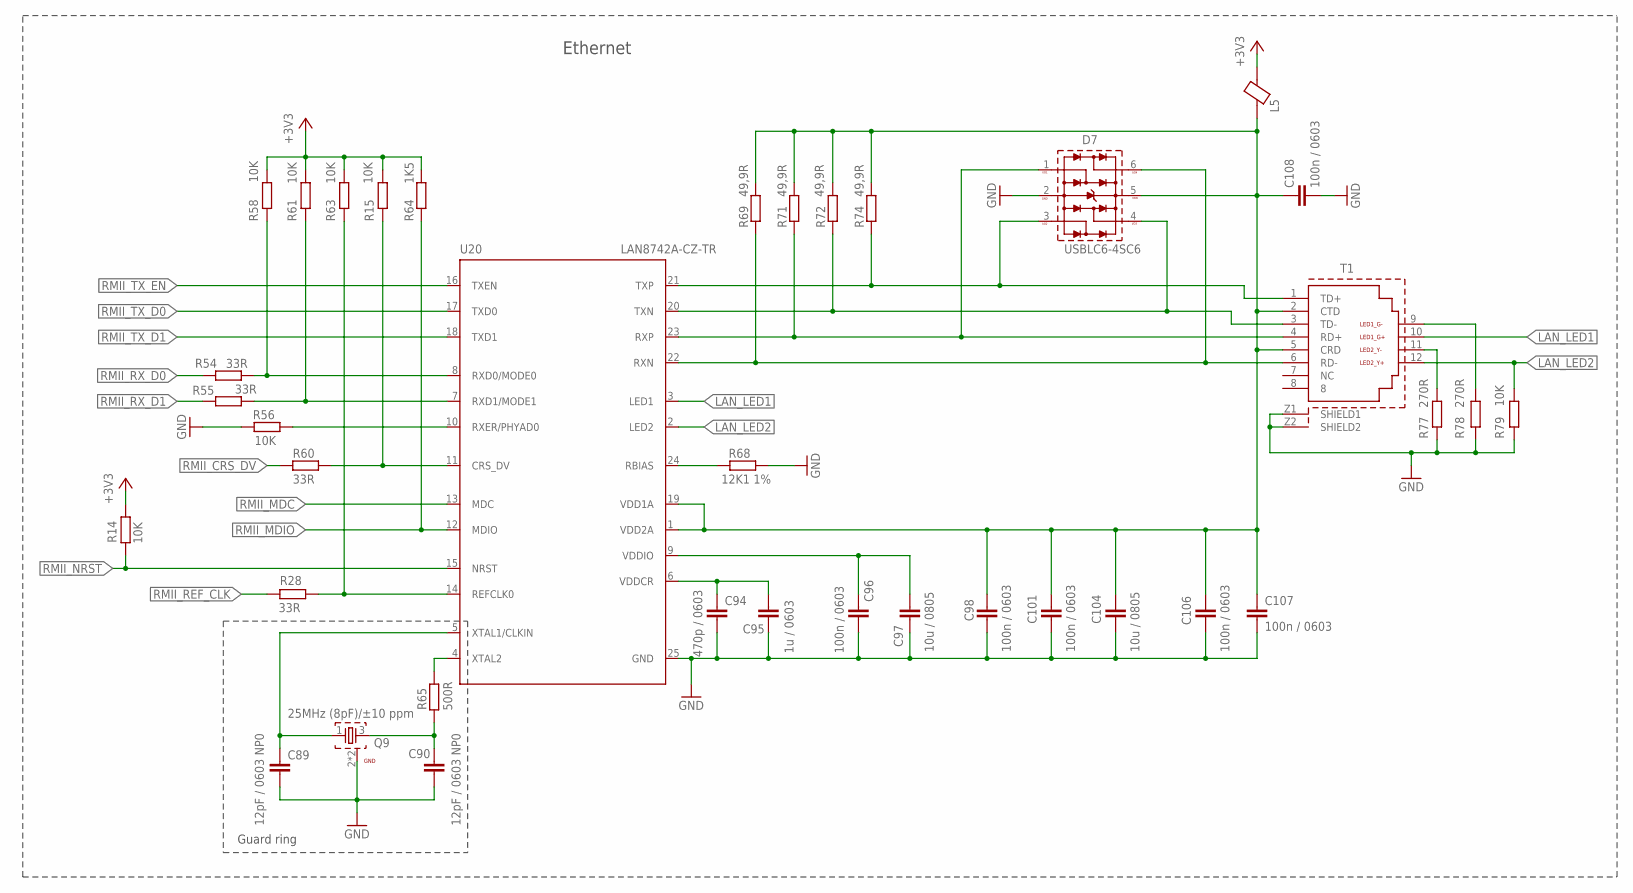
[picture p97: schematic DP_current_measure_v3.sch, sheet 5]

Parts:
C89, C90: 12pF / 0603 NP0; C0603
C94: 470p / 0603; C0603
C95: 1u / 0603; C0603
C96, C98, C101, C106, C107, C108: 100n / 0603; C0603
C97, C104: 10u / 0805; C0805
D7: USBLC6-4SC6; WE-TVS_SOT23-6L
L5: BLM21PG331SN1D
Q9: 25MHz (8pF)/±10 ppm; WE-XTAL_CFPX-218
R14, R15, R56, R58, R61, R63, R79: 10K; R0603
R28, R54, R55, R60: 33R; R0603
R64: 1K5; R0603
R65: 500R; R0603
R68: 12K1 1%; R0603
R69, R71, R72, R74: 49,9R; R0603
R77, R78: 270R; R0603
T1: WE-RJ45_7499010121A; 7499010121A
U20: LAN8742A-CZ-TR; 24-VFQFN

Connections:
+3V3: L5.1, R14.1, R15.1, R58.1, R61.1, R63.1, R64.1; also elsewhere on the board
GND: C89.2, C90.2, C94.2, C95.2, C96.2, C97.2, C98.2, C101.2, C104.2, C106.2, C107.2, C108.2, D7.2 (GND), Q9.2 (GND), Q9.4 (GND), R56.2, R68.1, R77.1, R78.1, R79.1, T1.Z1 (SHIELD1), T1.Z2 (SHIELD2), U20.25 (GND); also elsewhere on the board
LAN_LED1: T1.10 (LED1_G+), U20.3 (LED1)
LAN_LED2: R79.2, T1.12 (LED2_Y+), U20.2 (LED2)
unnamed: R78.2, T1.9 (LED1_G-)
unnamed: R65.1, U20.4 (XTAL2)
unnamed: R68.2, U20.24 (RBIAS)
unnamed: C98.1, C101.1, C104.1, C106.1, C107.1, C108.1, D7.5 (VDD), L5.2, R69.2, R71.2, R72.2, R74.2, T1.2 (CTD), T1.5 (CRD), U20.1 (VDD2A), U20.19 (VDD1A)
unnamed: C96.1, C97.1, U20.9 (VDDIO)
unnamed: C94.1, C95.1, U20.6 (VDDCR)
unnamed: C90.1, Q9.3 (2), R65.2
unnamed: C89.1, Q9.1, U20.5 (XTAL1/CLKIN)
unnamed: R77.2, T1.11 (LED2_Y-)
RMII_CRS_DV: R60.2; also elsewhere on the board
RMII_CRS_DV_: R15.2, R60.1, U20.11 (CRS_DV)
RMII_MDC: U20.13 (MDC); also elsewhere on the board
RMII_MDIO: R64.2, U20.12 (MDIO); also elsewhere on the board
RMII_NRST: R14.2, U20.15 (NRST)
RMII_REF_CLK: R28.2; also elsewhere on the board
RMII_REF_CLK_IC: R28.1, R63.2, U20.14 (REFCLK0)
RMII_RX_D0: R54.2; also elsewhere on the board
RMII_RX_D0_: R54.1, R58.2, U20.8 (RXD0/MODE0)
RMII_RX_D1: R55.2; also elsewhere on the board
RMII_RX_D1_: R55.1, R61.2, U20.7 (RXD1/MODE1)
RMII_RX_ER: R56.1, U20.10 (RXER/PHYAD0)
RMII_TX_D0: U20.17 (TXD0); also elsewhere on the board
RMII_TX_D1: U20.18 (TXD1); also elsewhere on the board
RMII_TX_EN: U20.16 (TXEN); also elsewhere on the board
RX_N: D7.6, R69.1, T1.6 (RD-), U20.22 (RXN)
RX_P: D7.1, R71.1, T1.4 (RD+), U20.23 (RXP)
TX_N: D7.4, R72.1, T1.3 (TD-), U20.20 (TXN)
TX_P: D7.3, R74.1, T1.1 (TD+), U20.21 (TXP)

Notes on the sheet:
Ethernet
Guard ring

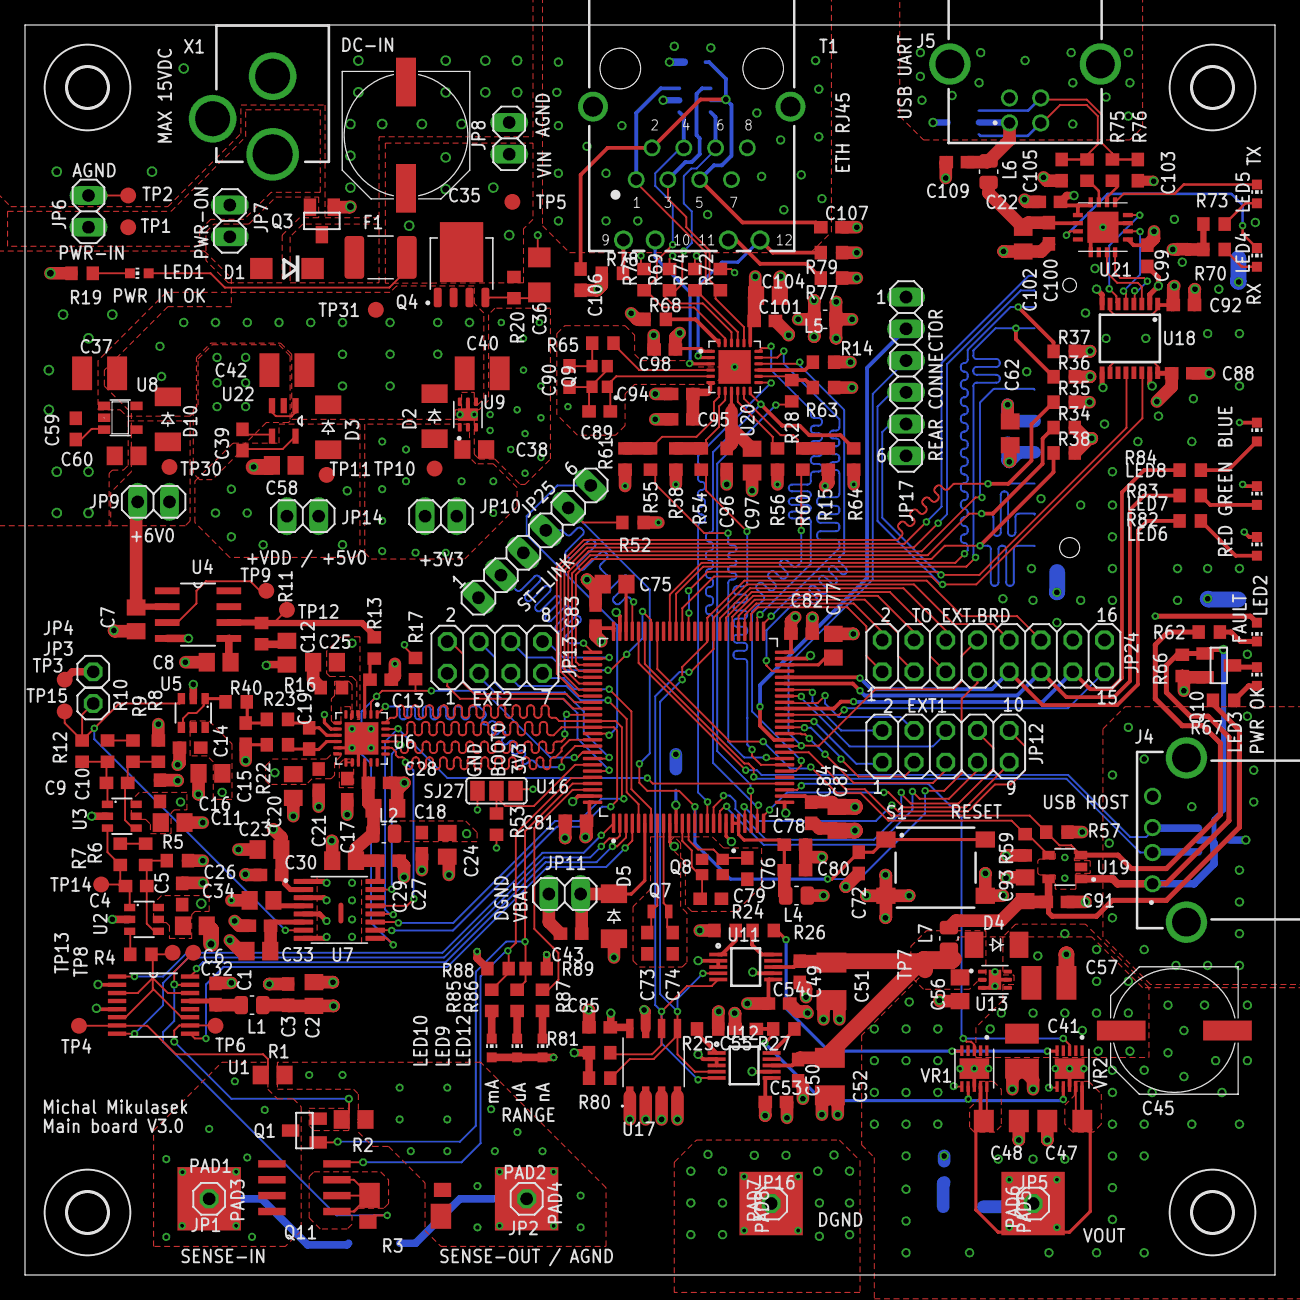
[picture p98: board DP_current_measure_v3.brd from above]

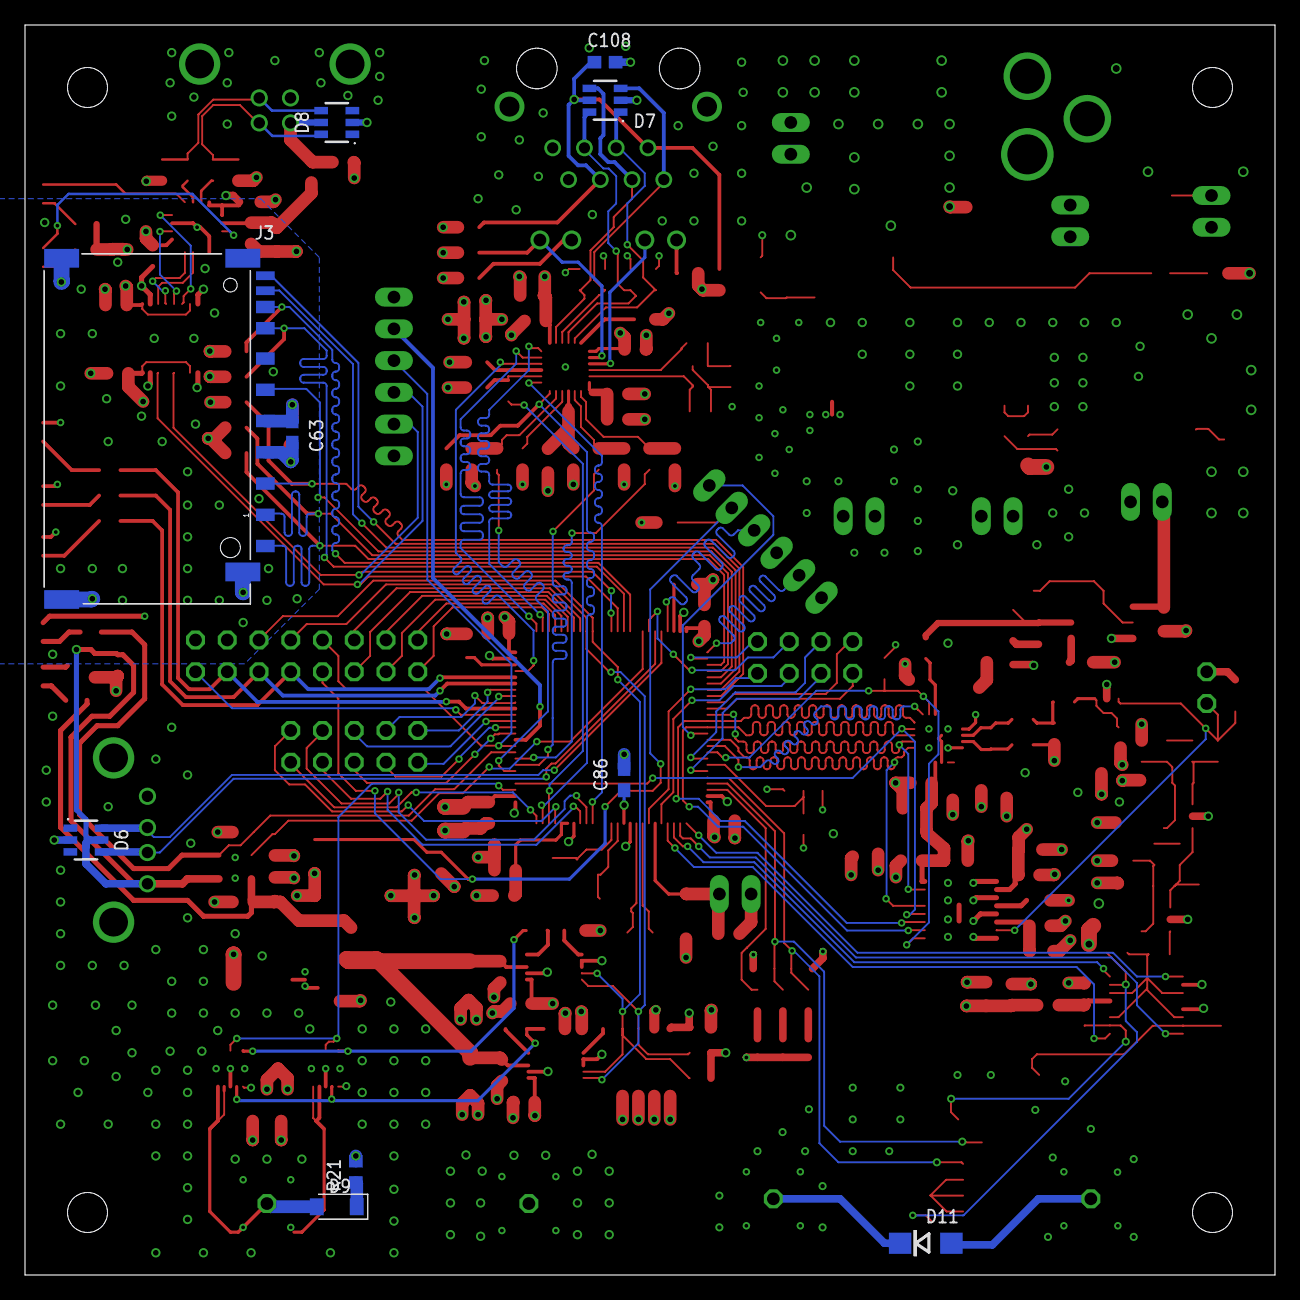
[picture p99: board DP_current_measure_v3.brd from below]

Board: 4 copper layers, 100.0 x 100.0 mm, 280 parts (10 on the bottom side), 183 nets.
