Crinst/LPWAN-current-logger-device/(commit log)

2026-08-03 Import hardware design files from thesis archive
    EAGLE schematics/boards v1-v3 + V3 extension with production gerbers
    and PCBWay CAM data, 3D-printed enclosure (Fusion 360/STEP/STL),
    LTspice front-end simulations, final BOM, board pictures, CubeMX
    pinout report and SW flowcharts. Recovered from the VUT Google Drive
    backup (Backup_VUT_GDRIVE/DP, Dec 2022 snapshot).
    [BOM_final.xlsx, DP_current_measure_V3_extension.brd, DP_current_measure_V3_extension.sch, DP_current_measure_v1.brd, DP_current_measure_v1.sch, DP_current_measure_v2.brd, DP_current_measure_v2.sch, DP_current_measure_v2_BOM_29_9_2019.csv]
2026-08-03 Add baseline documentation and architecture decision records
    docs/baseline: as-is system reference extracted from the thesis, V3
    schematic, all legacy firmware repos and the recovered 2021 FPGA state -
    analog front-end, ADC chain, FPGA/MCU protocol (all three build
    generations), firmware architectures, complete pin maps, severity-rated
    defect register, and the hardware restore test plan.
    docs/decisions: five open ADRs (MCU platform, FPGA role, networking,
    display/LVGL, RTOS/toolchain) pre-filled with established facts and
    trade-offs; decisions to be recorded per-ADR with implementing repo+branch.
2026-08-03 ADR-001 decided: keep STM32F767VIT6 on V3 board; next-gen firmware on F7 repo branch ng
2026-08-03 ADR-002/003/004 decided: keep FPGA (rewrite), dual networking (ETH + ESP32), ST7528 display initially
2026-08-03 ADR-006: defer ESP32-S3 HMI split as future direction; update docs index
2026-08-03 Record FPGA test-setup provenance: v2 board carried the ADS8691, FPGA linked to V3 spare headers via duponts
